Ben-nevis2006/stm32-freertos-dual-ecu-can-diagnostics/evidence/hardware/H3/2026-10-10/README.md

# Gate H3 FAN-00A 实物身份与接口证据索引（2026-10-10）

## 1. 本批范围

本目录保存 `FAN-01` 的完整标签、原装主接口、PST 串联输出接口，以及独立风扇延长线两端的原始照片。所有照片由现场执行人在未给风扇接入 12 V、NUCLEO、PWM 或 Tach 的状态下提供；归档仅规范化文件名，没有裁剪、修图或覆盖源文件。

本批只用于关闭 `FAN-00A` 的实物身份与接口形态补证。它不证明延长线逐针导通、风扇功能、转速、PWM 开路电压、Tach/PPR、带载电流或长期稳定性。

## 2. 证据清单与 SHA-256

| 归档文件 | 原始文件名 | 字节数 | 可支持的事实 | SHA-256 |
|---|---|---:|---|---|
| `H3_FAN-01_label_P8-PWM-PST_12V-0A09_20261010_01.jpg` | `985e2717f56e325733a7c89d342ca21f.jpg` | 163325 | 标签可读为 `ARCTIC P8 PWM PST / DC 12V 0.09A`；扇框、叶片及出线在照片可见范围内未见明显损伤 | `E1E9FD960602D0305B1FC4F9678405DF2B79BAF2E42763D247EC3E7393EA1659` |
| `H3_FAN-01_PST-output_three-populated-pins_20261010_01.jpg` | `91e9d2d0af5ce3dc1fd917f8ee56d527.jpg` | 105994 | 原装 PST 串联输出使用 4 位防呆外壳，但只装有 3 个金属触点 | `6D009290A8E411E4FF02BC8B8C76A096EAE5BFF2C3C6F1C5C6C596743D6B72BD` |
| `H3_FAN-01_main-connector_four-contact_20261010_01.jpg` | `b81644e9cc844aa9551b82052d8566db.jpg` | 109339 | 原装主接口为 4 位、4 触点、4 导线的母座 | `89996370F7F81180C4D09C7525B985133A2B9179AD7B5ACFCE74A26C63FE9BDF` |
| `H3_FAN-01_main-and-PST-connectors_20261010_01.jpg` | `c4e85651d4e5bfbcd9e9d5ecd1867949.jpg` | 105558 | 同一原装线束同时带主 4 触点母座与 PST 三触点串联输出，可交叉确认两者用途不同 | `5050C3148DE4EB92D2EB89939D15477CFAE6A80E17B537F2AAD84EE85EEA2FD9` |
| `H3_FANEXT-01_four-wire-both-ends_20261010_01.jpg` | `0224844abc403b8a568dfd99da91725b.jpg` | 124654 | 独立延长线两端均为 4 位且四个位置均有触点，线缆可见 4 条并行导体 | `E36BC421E99A58234BD5106A48732F6E72DA48E98FF3141DB3B2D14A06FCEB2F` |

## 3. 为什么原装 PST 输出只有三针

这不是缺针或损坏，而是 PST 串联设计的正常形态：

- 风扇的主 4-wire 接口需要 `GND / +12 V / Tach / PWM` 四条功能，因此有四个触点；
- PST 串联输出只把 `GND / +12 V / PWM` 继续送给下一只风扇；
- `Tach` 是每只风扇各自的测速输出。若把多只风扇的 Tach 输出直接并联，主机无法区分来源，多个输出也不应互相硬并，因此串联输出有意省略 Tach 所在位置；
- 外壳仍保持标准 4 位，是为了防呆、定位和与普通 4-pin 风扇插头机械兼容；
- 独立延长线属于通用直通件，所以两端四个位置都装触点。它不是 PST 分线器，不能因为“四针齐全”就推断它已完成逐针电气验证。

ARCTIC 官方产品页把本型号接口描述为 `4-Pin Connector + 4-Pin Socket`，PST 手册同时说明串联风扇组只监测第一只风扇的速度。上述现场接口形态与该设计一致：

- ARCTIC P8 PWM PST 产品页：<https://www.arctic.de/en/P8-PWM-PST/P8PWMPST>
- ARCTIC P8 PWM PST 支持/手册：<https://support.arctic.de/en/p8-pwm-pst>

## 4. 判定与边界

`FAN-00A` 判定为 **PASS（2026-10-10，身份/接口范围）**：

- `FAN-01` 实物标签确认 `P8 PWM PST / DC 12 V / 0.09 A`；
- 主接口和 PST 串联输出均已得到可复核近照；
- 三触点 PST 输出与四触点主接口的差异有明确设计解释，不登记为缺件或损坏；
- H0 `D-02` 中 FAN 的身份/接口子项可以关闭。

仍然保持以下边界：

- 标签没有显示完整销售 SKU，因此不把候选网页中的 `ACFAN00150A` 当成现场可读事实；
- 不按黑色线上的印刷、条纹或线色直接认定具体针脚，后续仍按防呆方向和物理针位编号；
- `FANEXT-01` 只确认外观为 4 线/4 触点，逐针一一对应关系仍须在 `FAN-00C` 全断电通断测试中建立；
- 本批没有关闭 `PSU12V-01 / D-04`，因此仍不允许把 12 V 接到风扇，也不允许连接 Node A、PWM 或 Tach。

## 5. 下一授权点

下一步只允许执行 `PSU-00B`：适配器与项目、风扇和所有板卡完全隔离，仅在直流输出端连续观察约 10 s 的空载电压稳定性。完成并记录之前，`FAN-00C` 及后续全部动作继续 HOLD。
