Ben-nevis2006/stm32-freertos-dual-ecu-can-diagnostics/evidence/hardware/H3/2026-10-08/README.md

# Gate H3 硬件证据索引（2026-10-08）

## 本日范围

本目录记录 H3-01 板外 NTC 分压组件的机械稳定性复核、引出线身份确认和关闭结论。2026-10-07 已完成的搭建、无源阻值和原始照片仍保留在[前一日证据目录](../2026-10-07/README.md)，本日不复制、不改写其发生日期。

本日先以现场文字报告关闭机械复核，随后归档 Node B 未上电接线照片、连续性结果及刷写前上电电压预检。硬件准入通过后，同日又完成 Node B 定向刷写与 ADC/UART 冒烟；后者见[同日软件证据索引](../../../software/H3/2026-10-08/README.md)，不回填成更早时点已经发生。

## 机械稳定性复核

| 检查 | 执行人观察 | 判定 | 边界 |
|---|---|---|---|
| 轻微扰动 NTC 转接母座、面包板节点和测量线 | 电阻读数正常、无跳变、无 `OL` | PASS | 只证明当前静态台架连续性，不代表振动/拉力/长期寿命 |
| 含 NTC 路径保持接入电阻档 | 读数平滑下降十几欧 | ACCEPTED | 相对约 11.4 kΩ 约为 0.1% 量级；未见阶跃或断续 |

平滑下降与万用表测试电流导致的轻微自热、手部/环境温度和仪表建立过程相符。因未记录测试电流、NTC 耗散常数与同步温度，只能写为“与热平衡效应一致”，不能证明自热是唯一原因，也不能据此推导绝对温度。

## 引出线身份

执行人按电阻分段复核后确认当前映射：

| 网络 | 当前线色 | 后续电气目标 |
|---|---|---|
| `T` | 棕色 | Node B `3V3` |
| `S` | 黑色（2026-10-07 近照最右侧） | Node B `A0 / PA0 / ADC1_IN0` |
| `G` | 红色 | Node B `GND` |

当前线色与常见电源约定相反：红色被用作 GND，黑色被用作模拟信号。为降低 H3-02 误接概率，在连接 Node B 前必须保持全断电，并采用下列二选一控制：

1. 推荐把外部跳线规范为 `红=T/3V3、棕=S/A0、黑=G/GND`，再复测三个阻值；或
2. 若不换线，则在两端增加不可脱落且不可混淆的 `T/S/G` 标签，并由第二次逐线核对确认。

## 线色规范化后的隔夜复测

执行人随后采用推荐方案调整三根外部跳线，并在静置隔夜后报告：

| 规范化线色 | 路径 | 实测值 | 判定 |
|---|---|---:|---|
| 红—棕 | `T-S`（NTC-01） | `12.00 kΩ`，稳定 | PASS；未见接触跳变 |
| 棕—黑 | `S-G`（R10K-01） | `9.93 kΩ`，稳定 | PASS；固定电阻与此前记录一致 |
| 红—黑 | `T-G`（串联总值） | `21.94 kΩ` | PASS；与分段和 `21.93 kΩ` 相差 `0.01 kΩ`（约 `0.046%`） |

复测后的最终映射为 `红=T/3V3、棕=S/A0、黑=G/GND`。NTC 从前次 `11.4 kΩ` 变为隔夜后的 `12.0 kΩ`，方向与冷却/环境热平衡一致；没有同步参考温度，因此不换算或宣称绝对温度。

## 当日关闭结论

H3-01 于 **2026-10-08 PASS**：板外分压的分段/总阻值、近照视觉检查及轻微扰动连续性均已满足当前准入条件。

在上述隔夜复测完成时，H3-02 仍为 **NOT STARTED**，但接板前的线色 HOLD 已解除；当时只授权在全断电状态下把红/棕/黑线分别接入 Node B 的 `3V3 / A0 / GND`，未授权上电或刷写。随后发生的未上电接线另见下一节。

## H3-02 未上电接线照片

执行人随后报告已迁移部分跳线用于共用 GND 与 3.3 V，并完成 Node B 接线，状态为“未上电”。

| 归档文件 | 原始文件名 | 字节数 | SHA-256 | 可支持的事实 | 不能支持的结论 |
|---|---|---:|---|---|---|
| `H3_NODE-B_NTC-divider-prepower-board_20261008_01.jpg` | `7f0b662d9aed82a361dd5a01b07c07ab.jpg` | 297064 | `CF350AA8CAD62FA600450EAB454EA580DC71EE702157F613AF1A8FE7183F9EEC` | 可见 Node B、板端跳线及 Micro-USB 插头；板载 LED 在静态照片中未见明确点亮 | 电源排针被线束部分遮挡，不能逐孔确认 `3V3/GND`；不能证明 USB 另一端未连接或板上实际无电 |
| `H3_NODE-B_NTC-divider-prepower-breadboard_20261008_01.jpg` | `1c2d38da594597433f99941a08c3c6af.jpg` | 218263 | `5C1F6623978B78A34A19DC009A59CFF214466CACB313717846825B26BC0BC0D9` | 可见面包板分压、引线及额外的公共电源/地跳线 | 线束交叉且部分节点受遮挡，不能独立证明三条网络均落在预期插孔，也不能代替连续性测量 |

## 板端连续性与短路复核

执行人确认 USB 未供电后，以通断档报告：

| 检查路径 | 现场结果 | 判定 |
|---|---|---|
| Node B `3V3↔T` | 蜂鸣 | PASS：预期同节点连续 |
| Node B `A0↔S` | 蜂鸣 | PASS：预期同节点连续 |
| Node B `GND↔G` | 蜂鸣 | PASS：预期同节点连续 |
| Node B `3V3↔GND` | 不蜂鸣 | PASS：未发现低阻短路 |

上述结果与此前分压阻值闭合证据共同解除 **PRE-POWER HOLD**。它只放行下一步按 Node B ST-LINK 身份进行受控 USB 接入/刷写；不证明 ADC 值、UART 日志、温升趋势或长期稳定性已经通过。离线固件构建证据见[同日软件证据索引](../../../software/H3/2026-10-08/README.md)。

## 刷写前上电电压预检

执行人随后给 Node B 上电并报告：

| 测量路径 | 实测值 | 判定 |
|---|---:|---|
| `T-G` | `3.289 V` | PASS：位于 `3.2～3.4 V` 预检区间 |
| `S-G` | `1.552 V` | PASS：位于 `1.40～1.60 V` 预检区间 |

按同次电压比与现场 `R_FIXED=9.93 kΩ` 估算，`R_NTC≈11.11 kΩ`，预期 12-bit ADC raw 约为 `1932`。这组结果证明上电时分压方向和量级与无源阻值证据一致；它仍是万用表电压快照，不是 MCU ADC 读数。执行人本次没有单独报告持续 30 s 的稳定观察，因此本索引不把该项写为长期或 30 s 稳定性通过。

Windows 只读设备枚举同时确认唯一连接目标的 USB 序列号为 Node B 冻结值 `066DFF515149856767254421`，对应 `STMicroelectronics STLink Virtual COM Port (COM8)`。该识别只解除定向刷写的身份 HOLD；截至本节形成时，仍没有发生 Flash 写入或目标复位。
