Ben-nevis2006/stm32-freertos-dual-ecu-can-diagnostics/evidence/hardware/H3/2026-10-07/README.md

# Gate H3 硬件证据索引（2026-10-07）

## 当前状态

Gate H3 于 2026-10-07 开始。本目录是 **2026-10-07 当日快照**，包含 H3-00 准入与设计冻结及 H3-01 的板外无源测量和原始接线照片。当日尚未执行 Node B 接线、通电、刷写或运行测试。

在 2026-10-07 当日结束时，H3 总体状态为 **IN PROGRESS**，H3-00 已 PASS；H3-01 无源阻值和视觉检查通过，母座机械稳定性与三根引出线映射仍待确认。该待办已于 2026-10-08 完成，见[次日 H3-01 关闭记录](../2026-10-08/README.md)。后续统一推送时仍保留每个动作的真实发生日期，不把阶段关闭日期回填为本目录内所有工作的发生日期。

## H3-00 可追溯输入

| 输入 | 已采用事实 | 限制 |
|---|---|---|
| [Gate H0 硬件验收基线](../../../../current/05_verification_gates_验证与门禁/Gate_H0_Hardware_Acceptance_Baseline_H0硬件验收基线_2026-09-22.md) | NTC-01=`10.30 kΩ`；R10K-01=`9.911 kΩ` | NTC 单点阻值不能证明 B3950 |
| [Gate H2 CAN 物理层执行记录](../../../../current/05_verification_gates_验证与门禁/Gate_H2_CAN_Physical_Layer_Execution_Record_H2_CAN物理层执行记录_2026-10-02.md) | H2 PASS；关闭提交 `bc19580` 可作为固件回退基线 | 不证明 NTC/ADC 或任何 12 V 外设 |
| [外设引脚时钟中断分配](../../../../current/03_hardware_interfaces_硬件与接口/Peripheral_Pin_Clock_Interrupt_Allocation_外设引脚时钟中断分配_v0.1_Working_Draft_工作草案_2026-09-13.md) | Node B NTC=`ADC1_IN0 / PA0 / A0 / CN7-28`；100 ms；上电校准 | 开短路阈值仍需 H3 实测冻结 |
| Node B `node_b.ioc`、`Src/adc.c` | 单通道、软件触发、右对齐、55.5 cycles、ADC clock≈10.67 MHz | 只有初始化骨架，尚无校准/采样/换算业务代码 |

## 本日输出

- [Gate H3 单外设验证执行记录](../../../../current/05_verification_gates_验证与门禁/Gate_H3_Single_Peripheral_Validation_Execution_Record_H3单外设验证执行记录_2026-10-07.md)
- 冻结拓扑：`3V3 → NTC-01 → A0/PA0 → R10K-01(9.911 kΩ) → GND`；
- 冻结趋势：升温时 ADC raw 上升；
- 冻结边界：B3950 为采购标称而非单点实测结论；12 V、Fan、Heater、INA260 继续禁止接入。

## H3-01 现场无源测量

| 测量路径 | 执行人报告值 | 当前判定 | 证据边界 |
|---|---:|---|---|
| `T-S`（NTC-01） | `11.4 kΩ` | PASS（连续性/当前阻值） | 环境温度未记录，不能证明 B3950 或温度精度 |
| `S-G`（R10K-01） | `9.93 kΩ` | PASS | 与 H0 `9.911 kΩ` 一致 |
| `T-G`（串联） | `21.16 kΩ` | PASS | 与分段和 `21.33 kΩ` 相差约 `0.8%` |

上述值来自执行人 2026-10-07 的现场文字报告。NTC 在焊接/手持热影响消退过程中曾从约 `8.9 kΩ` 缓慢回升，随后隔离复测稳定为 `11.4 kΩ`；该趋势符合 NTC 受热阻值下降、冷却回升。当前没有原始仪表照片，因此只作为已记录的现场测量，不冒充照片取证。

## 原始照片

| 归档文件 | 原始文件名 | 字节数 | SHA-256 | 可支持的事实 | 不能支持的结论 |
|---|---|---:|---|---|---|
| `H3_NTC-01_R10K-01_passive-divider-overview_20261007_01.jpg` | `3630b207078e88cc679665a7877f38df.jpg` | 176247 | `B6920752251DCC92190FAB3772CB4B5FFDC7D697194E2BBE18F200E759FAC4B8` | 板外面包板上可见 NTC、固定电阻和三根测量引出线；拍摄时未见其接入 Node B 供电 | 取景较宽且线束遮挡，不能逐孔确认 T/S/G 同排关系、补锡处无桥连或 NTC 细引线在杜邦母座内的夹持可靠性 |
| `H3_NTC-01_R10K-01_passive-divider-closeup_20261007_01.jpg` | `45596dc14e38912e8c4d5d3b49e5f211.jpg` | 241490 | `67242172A695BF6FC743464BF32B2E7805A7E14F6095F02A6F1A1A42B34C0C05` | 近照可辨固定电阻、NTC/转接引线和三个引出点；未见明显锡桥或相邻裸线互碰 | 不能证明杜邦母座内部夹持在受力时持续导通，也不能仅从线色推断 T/S/G 电气身份 |

## 当日待办及后续状态

截至 2026-10-07，仍待完成母座轻微扰动下的 `T-S` 阻值稳定性检查，并记录三根引出线的 T/S/G 颜色映射。上述两项于 2026-10-08 完成，H3-01 随后关闭为 PASS；该结论只记录在[2026-10-08 索引](../2026-10-08/README.md)，不回填成 10 月 7 日已完成。Node B A0 接线和 UART 原始日志仍未执行，尚未执行的项目不创建占位“通过”证据。
