Ben-nevis2006/stm32-freertos-dual-ecu-can-diagnostics/evidence/hardware/H0/2026-09-23/README.md

# Gate H0 硬件到货验收证据归档

## 1. 归档控制

| 项目 | 记录 |
|---|---|
| 项目 | 基于 STM32 + FreeRTOS 的双 ECU CAN 实时通信与故障检测系统 |
| Gate | H0：实物清点、身份核对与基础电气检查 |
| 现场执行日期 | 2026-09-23 |
| 归档日期 | 2026-09-23 |
| 证据数量 | 9 张 JPEG 原图 |
| 来源 | 项目执行人通过当前任务提交的现场照片 |
| 处理方式 | 对原文件进行逐字节复制，仅按 H0 命名规则重命名；未裁剪、未调色、未压缩、未覆盖原图 |
| 完整性校验 | SHA-256；归档后应与本清单逐项一致 |
| 关联记录 | [Gate H0 Hardware Acceptance Baseline / H0 硬件验收基线](../../../../current/05_verification_gates_验证与门禁/Gate_H0_Hardware_Acceptance_Baseline_H0硬件验收基线_2026-09-22.md) |
| 后续补充 | [2026-09-24 身份/铭牌补充证据](../2026-09-24/README.md) |
| 当前结论 | H0 现场检查和测量已执行；Gate 维持 HOLD，D-01～D-04 未关闭 |

本目录保存的是 H0 原始证据，不是后续 Gate 的功能验证结果。照片中的读数只能支持对应的静态检查，不能证明 CAN 通信、传感器标定、风扇控制、Heater 带载、RTOS、Fault、Fallback 或 Recovery 已通过。

## 2. 照片与读数索引

| 证据 ID | 归档文件 | 原始文件名 | 可见对象/读数 | H0 可支持结论 | 不能据此声称 |
|---|---|---|---|---|---|
| EV-H0-01 | [`H0_ALL_overview_20260923_01.jpg`](H0_ALL_overview_20260923_01.jpg) | `5d1a208640be3f02ec77078a7227a0a8.jpg` | 两块 NUCLEO、两块 CAN Pal、INA260 类模块、风扇、适配器、Heater、散热器和若干辅材总览 | 物料已展开、未形成完整 12 V 功率连接；支持总量级到货事实 | 不能代替每件实物的正反面、丝印、板版本、跳线和实体 ID 近照 |
| EV-H0-02 | [`H0_PSU12V-01_measurement_center-positive_20260923_01.jpg`](H0_PSU12V-01_measurement_center-positive_20260923_01.jpg) | `a1b208679f6a0c125ef1330ff4d31931.jpg` | 中心针接红表笔、外壳接黑表笔时约 `+12.580 V` | 实测输出极性为中心正极；存在约 12.58 V 空载输出 | 不能证明带载能力、纹波、瞬态或完整 12 V 回路安全 |
| EV-H0-03 | [`H0_PSU12V-01_measurement_reverse_20260923_02.jpg`](H0_PSU12V-01_measurement_reverse_20260923_02.jpg) | `635573c4b4d735a8d415230ad502d2d3.jpg` | 交换表笔后约 `-12.580 V` | 与 EV-H0-02 交叉支持中心正极判定 | 不能代替清晰铭牌、制造商容差或持续稳定性记录 |
| EV-H0-04 | [`H0_HEATER-01_measurement_10R50_20260923_01.jpg`](H0_HEATER-01_measurement_10R50_20260923_01.jpg) | `1a2a5ff2da1f37d30f03bf6461bb12c3.jpg` | Heater 静态读数约 `10.50 Ω` | 支持 10 Ω 量级的到货初筛 | 未记录表笔短接值，不能作为修正后的精确阻值或通电许可 |
| EV-H0-05 | [`H0_R10K-01_measurement_9K730_20260923_01.jpg`](H0_R10K-01_measurement_9K730_20260923_01.jpg) | `a5de193edb7f7ad60e04818810cd44a0.jpg` | Live Photo 抽取帧显示约 `9.730 kΩ`；执行人后续说明测量过程中读数持续跳变 | 证明该帧曾出现 9.730 kΩ，并触发“测量不稳定”D-01 | 不能把单帧当作稳定元件值，不能据此计算有效偏差或判定满足/不满足 `10 kΩ ±1%` |
| EV-H0-06 | [`H0_R4K7-01_measurement_4K701_20260923_01.jpg`](H0_R4K7-01_measurement_4K701_20260923_01.jpg) | `18b307e9f9fadc9c1dab02ec6d185b3d.jpg` | R4K7-01 静态读数约 `4.701 kΩ` | 支持 4.7 kΩ 标称阻值核对 | 未提供元件精度和仪表不确定度，不能扩展为精密容差认证 |
| EV-H0-07 | [`H0_CANPAL-01_measurement_120R26_20260923_01.jpg`](H0_CANPAL-01_measurement_120R26_20260923_01.jpg) | `1c76f6f80350c80026f40875a2607385.jpg` | CANPAL-01 termination 静态读数约 `120.26 Ω` | 支持本板 120 Ω 终端配置核对 | 不能证明收发器型号、逻辑电压、针脚方向或 CAN 通信正常 |
| EV-H0-08 | [`H0_CANPAL-02_measurement_120R52_20260923_01.jpg`](H0_CANPAL-02_measurement_120R52_20260923_01.jpg) | `255a38a1268f1a5b90a20ed8f369bbba.jpg` | CANPAL-02 termination 静态读数约 `120.52 Ω` | 支持第二块板的独立 120 Ω 终端配置核对 | 不能用本图代替 CANPAL-01 的结果，也不能证明总线功能 |
| EV-H0-09 | [`H0_NTC-01_measurement_10K30_20260923_01.jpg`](H0_NTC-01_measurement_10K30_20260923_01.jpg) | `adf0ee3dcb4b4c189b1b3a980b20513d.jpg` | NTC-01 在未记录室温下静态读数约 `10.30 kΩ` | 支持“约 10 kΩ NTC”的单点标称身份核对 | 单点读数不能证明 `B3950`、温度精度、响应时间或 ADC 换算正确 |

## 3. SHA-256 完整性清单

| 归档文件 | 字节数 | SHA-256 |
|---|---:|---|
| `H0_ALL_overview_20260923_01.jpg` | 290374 | `aaea4058b7cca293bdf995ec7fccc070dac24d42bffd0b1e7335aa96224b06ad` |
| `H0_PSU12V-01_measurement_center-positive_20260923_01.jpg` | 164296 | `f5082493b3b74e7714de08169052bbd112fc0e9fb78b6adfddd8fbd74d55eb5a` |
| `H0_PSU12V-01_measurement_reverse_20260923_02.jpg` | 150479 | `de49a989d22a1a59e67ce5d27af081f85c35049f745b75ca647c3870a6c9acd1` |
| `H0_HEATER-01_measurement_10R50_20260923_01.jpg` | 251617 | `5ea1ceb66627e54de35e6852701e62ec20b35e97926161d72747927e5e921da1` |
| `H0_R10K-01_measurement_9K730_20260923_01.jpg` | 272340 | `845ffb9f1748891a0ea7bc7e4abdd2704ab74bbb742aa7bc716c668c052f947c` |
| `H0_R4K7-01_measurement_4K701_20260923_01.jpg` | 286576 | `cedbede249d58dde4874ec14ad160d87ff8c3a8b618d0e16d91873412f500dbc` |
| `H0_CANPAL-01_measurement_120R26_20260923_01.jpg` | 235247 | `fda8833ac659d0e489769475d3fb762b2ca8418726ace8a87afcec939da708de` |
| `H0_CANPAL-02_measurement_120R52_20260923_01.jpg` | 262887 | `346c3e1898db4b603d1b1a04d8b1e9bf42731f3e2f964ef76c43bb5befd5f4bd` |
| `H0_NTC-01_measurement_10K30_20260923_01.jpg` | 162213 | `3645a696d713f57323035bcf50e5efcd4579a0d311bcdf4f2e763cc091bd79c2` |

## 4. 证据判读与偏差

### 4.1 已形成的有效证据

- `NTC-01`：约 10.30 kΩ，支持 10 kΩ 量级的单点核对；
- `R4K7-01`：约 4.701 kΩ，支持 4.7 kΩ 标称核对；
- `CANPAL-01` / `CANPAL-02`：分别约 120.26 Ω / 120.52 Ω，两个模块均有独立照片；
- `PSU12V-01`：正反表笔读数成对，支持中心正极和约 12.58 V 空载输出；
- `HEATER-01`：约 10.50 Ω，仅作为未修正的初筛值。

### 4.2 不得被“合格”注脚覆盖的问题

1. `R10K-01` 照片中的 9.730 kΩ 是读数跳变期间的 Live Photo 单帧。该信息撤销了“9.730 kΩ 是稳定元件值/已超出 ±1%”的早期推断。当前 HOLD 原因是测量不稳定、结果无效；必须改善接触并重复取得稳定数据后才能判断 PASS/FAIL。
2. 总览照片不能替代逐件正反面/丝印/跳线照片。执行人现场看过，不等于仓库中的第三方可以复核。
3. `HEATER-01` 没有表笔短接值，10.50 Ω 不能直接当作元件修正阻值。
4. `PSU12V-01` 的两张读数照片能证明基本输出和实际极性，不能证明铭牌一致性、带载能力或长期稳定性。
5. `NTC-01` 树脂头绝缘是正常封装特征。阻值应从两根引线/端子测量；此次补图已经完成这一项，但没有证明 B 值。

## 5. Gate 边界

- 当前归档不授权搭建完整 12 V 功率回路；
- D-01～D-04 关闭并复核前，Gate H0 维持 HOLD，H1 不准入；
- 后续补拍或复测必须新增文件，不覆盖这 9 张原始证据；2026-09-24 的 6 张补充原图另目录保存；
- 如同一器件复测值不同，应保留两次记录并解释测试条件，不删除“不好看”的旧结果。
