Ben-nevis2006/stm32-freertos-dual-ecu-can-diagnostics/evidence/hardware/H0/2026-09-24/README.md

# Gate H0 身份、铭牌与关闭补充证据

## 1. 归档控制

| 项目 | 记录 |
|---|---|
| 项目 | 基于 STM32 + FreeRTOS 的双 ECU CAN 实时通信与故障检测系统 |
| Gate | H0：实物清点、身份核对与基础电气检查 |
| 补充证据日期 | 2026-09-24 |
| 证据数量 | 8 张 JPEG 原图 |
| 来源 | 项目执行人通过当前任务提交的现场照片 |
| 处理方式 | 对原文件逐字节复制并规范重命名；未裁剪、未调色、未压缩、未覆盖原图 |
| 完整性校验 | SHA-256；归档副本必须与本清单一致 |
| 初始证据 | [2026-09-23 原始测量与总览证据](../2026-09-23/README.md) |
| 关联记录 | [Gate H0 Hardware Acceptance Baseline / H0 硬件验收基线](../../../../current/05_verification_gates_验证与门禁/Gate_H0_Hardware_Acceptance_Baseline_H0硬件验收基线_2026-09-22.md) |
| 当前结论 | D-01、D-03 已在 H0 筛查范围关闭；D-02、D-04 带入后续 Gate；Gate H0 为 CONDITIONAL PASS，允许受限 H1 |

## 2. 补充照片索引

| 证据 ID | 归档文件 | 原始文件名 | 可辨识内容 | 支持的结论 | 仍不能证明 |
|---|---|---|---|---|---|
| EV-H0-10 | [`H0_PSU12V-01_marking_20260924_01.jpg`](H0_PSU12V-01_marking_20260924_01.jpg) | `d8e6562d5cddab80fec74008c62c08c4.jpg` | 型号 `DC-853-1203000`；输入 180–240 V~ 50/60 Hz 1.0 A Max；输出 12 V DC / 3.0 A；中心正极；佛山市得昌电源有限公司 | 铭牌额定值、极性与此前 ±12.580 V 空载测量相互一致 | 不能证明连续稳定性、带载能力、纹波或瞬态性能 |
| EV-H0-11 | [`H0_NUCLEO-01_front_20260924_01.jpg`](H0_NUCLEO-01_front_20260924_01.jpg) | `3a5c142e9d3efdd6802700a0b7ab8be9.jpg` | 实体手写 ID `01`、`NUCLEO-F103RB`、`MB1136 rev C`、正面跳线/接口状态 | NUCLEO-01 的独立正面身份和板版本证据 | MCU 顶部字符未清晰到可逐字复核；不能代替背面照片或 USB 功能验证 |
| EV-H0-12 | [`H0_NUCLEO-02_front_20260924_01.jpg`](H0_NUCLEO-02_front_20260924_01.jpg) | `fa936715832a78edd41add66bb18b2e4.jpg` | 实体手写 ID `02`、`NUCLEO-F103RB`、`MB1136 rev C`、正面跳线/接口状态 | NUCLEO-02 的独立正面身份和板版本证据 | 不能用 NUCLEO-01 的结果代替本板；不能代替背面照片或 USB 功能验证 |
| EV-H0-13 | [`H0_CANPAL-01_front_20260924_01.jpg`](H0_CANPAL-01_front_20260924_01.jpg) | `09140e86db503dd04a1fc5acf160942e.jpg` | 端子手写 ID 按照片方向解释为 `01`；`Vcc/GND/RX/TX/SLNT/CANH/CANL` 与 termination 开关正面可见 | CANPAL-01 正面针脚和终端配置可追溯，可与 120.26 Ω 测量关联 | 收发器顶标和板版本仍不够清晰；不能代替背面照片或证明 CAN 通信 |
| EV-H0-14 | [`H0_CANPAL-02_front_20260924_01.jpg`](H0_CANPAL-02_front_20260924_01.jpg) | `3d7d0ff8980df27656d4adb38b8fb70d.jpg` | 端子手写 ID 按照片方向解释为 `02`；`Vcc/GND/RX/TX/SLNT/CANH/CANL` 与 termination 开关正面可见 | CANPAL-02 正面针脚和终端配置可追溯，可与 120.52 Ω 测量关联 | 收发器顶标和板版本仍不够清晰；不能代替背面照片或证明 CAN 通信 |
| EV-H0-15 | [`H0_INA260-01_front_20260924_01.jpg`](H0_INA260-01_front_20260924_01.jpg) | `11983c49951fc1c7c081937e84546c95.jpg` | `INA260 Power Sensor`、实体手写 ID `01`、`Vcc/GND/SCL/SDA/Alert/VBUS/Vin+/Vin-`、A0/A1 地址焊盘 | INA260-01 正面身份、主要针脚和地址焊盘到货状态 | 不能代替背面照片，也不能证明 I2C、电流/电压测量或 ALERT 功能 |
| EV-H0-16 | [`H0_METER-01_lead-short_0R3_20260924_01.jpg`](H0_METER-01_lead-short_0R3_20260924_01.jpg) | `c53d560f5433274b46c2155d4deaac0d.jpg` | `VICTOR VC9807A+`、200 Ω 档、两表笔金属尖端直接接触、显示约 0.3 Ω | 建立 Heater 初测所用万用表的低阻筛查基线，支持约 10.20 Ω 的事后修正 | 不是与 Heater 同时完成的测量，不能证明接触条件完全相同，也不证明 Heater 通电安全 |
| EV-H0-17 | [`H0_R10K-01_remeasurement_9K911_20260924_01.jpg`](H0_R10K-01_remeasurement_9K911_20260924_01.jpg) | `c976713e76e49b8058f8767de8f23cae.jpg` | `VICTOR VC9807A+`、20 kΩ 档、R10K-01 补充复测显示 9.911 kΩ | 显示值位于 10 kΩ ±1% 的 9.900～10.100 kΩ 名义带内，可关闭“无有效读数”的 D-01 | 仪表未校准，不能作为精密计量或供应商容差认证；单张照片不证明长期稳定性 |

## 3. SHA-256 完整性清单

| 归档文件 | 字节数 | SHA-256 |
|---|---:|---|
| `H0_PSU12V-01_marking_20260924_01.jpg` | 239535 | `634ea53b4b4e1bc7c56896055469369648fed20914d9e199b25eda0897170b12` |
| `H0_NUCLEO-01_front_20260924_01.jpg` | 254703 | `c63b95c7b8be2bf3512d16cff4d6c4ca2c3c8251e4a233993e1dfa22eb657c8e` |
| `H0_NUCLEO-02_front_20260924_01.jpg` | 217345 | `24dd10894a6c1d017087a4195a33d03f201e8168ef84daa4918f5758952bfac7` |
| `H0_CANPAL-01_front_20260924_01.jpg` | 234352 | `0dd77667e2437f8b92970ed3cf1d929beb61382df18a9356e0851c0959a7a282` |
| `H0_CANPAL-02_front_20260924_01.jpg` | 201228 | `db988888c2884e31702ff447efc4744f01ab6036b050d632d7ca3e217fa524bc` |
| `H0_INA260-01_front_20260924_01.jpg` | 200418 | `97a98878ca792db98e7f5eb273bc0ff3ce10d420761e29a51b09255eaed5a971` |
| `H0_METER-01_lead-short_0R3_20260924_01.jpg` | 165791 | `ca0efa66de9aa2da1bdfb59a18025be0b361b384fa431f7a61f660b5c0a62973` |
| `H0_R10K-01_remeasurement_9K911_20260924_01.jpg` | 221902 | `9b81ec76c7d494e781720eafbf622188a7209e7589a71d556c88c735b2536535` |

## 4. 执行人补充说明

### 4.1 R10K-01 的 Live Photo

执行人说明，10 kΩ 电阻初测时显示值持续跳变，先前归档的 9.730 kΩ 只是 Live Photo 中抽取的一帧。因此：

- 撤回“9.730 kΩ 是稳定元件值、相对标称值偏低 2.70%”的推断；
- 保留原图，但只把它作为“测量不稳定”的证据；
- 不从视频或 Live Photo 中挑选最接近 10.000 kΩ 的一帧作为合格证据；
- 2026-09-24 补充复测照片显示 9.911 kΩ（20 kΩ 档），相对标称值为 -0.89%，落在 9.900～10.100 kΩ 名义带内；
- D-01 由“没有有效读数”改为 **CLOSED（仅 H0 筛查范围）**。由于仪表未校准，这一关闭不等于精密容差认证；NTC 分压实际搭建时仍需用 ADC 合理性检查发现接触或元件问题。

### 4.2 Heater 测量前未做表笔短接

执行人确认，测量 Heater 的 10.50 Ω 前没有把两支表笔金属尖端直接接触并记录表笔/接触电阻。2026-09-24 补充同一万用表 200 Ω 档的表笔短接照片，显示约 0.3 Ω。因此保留 10.50 Ω 原始显示值，并形成事后近似筛查修正值：`10.50 - 0.30 = 10.20 Ω`。

Heater 没有在补拍时再次测量，所以不能声称两次接触条件完全相同。项目只按“排除开路、短路或数量级错件”的 H0 目的接受该值，D-03 记为 **CLOSED（仅 H0 筛查范围）**；它不授权安装、12 V 上电、温升或功率验证。

“表笔短接”只允许在被测对象完全断电、表笔位于 `COM/VΩ`、万用表处于电阻档时进行；它不是短接 Heater，更不是短接适配器输出。

### 4.3 关于从总览图裁切器件

总览原图可以裁切为汇报或位置说明用的派生图，但裁切不会增加原图分辨率，也不能恢复总览中不可辨认的芯片字符、背面焊点或跳线细节。若后续生成裁图，必须：

- 保留总览原图不变；
- 文件名包含 `derived-crop`；
- 清楚标注“派生图，不替代原始近照”；
- 不用派生裁图关闭原图中本来不可辨识的验收项。

本次已有对应器件的独立正面原图，因此未生成或归档总览裁图。

## 5. 带入后续 Gate 的最小事项

1. `D-02`：补两块 NUCLEO、两块 CAN Pal、INA260 的背面，以及 CAN 芯片顶标、FAN 标签/接口、Heater 铭牌和 Heatsink 尺寸证据；对应器件在证据关闭前不得接入系统。NUCLEO 背面证据不阻止纯 USB H1，但最迟应在接扩展线或外设前补齐；
2. `D-04`：适配器完全空载观察约 10 s，记录显示范围及有无异味、异响或异常发热；该偏差关闭前不得执行任何 12 V 动作，也不得通过“接负载看看”关闭偏差。

H1 仅允许一次连接一块 NUCLEO 的 ST-LINK USB，完成 Windows 枚举、ST-LINK、虚拟串口和 CubeProgrammer 只读识别。CAN Pal、INA260、Fan、Heater、NTC、12 V 及板间连线全部排除在本次放行之外。
