Ben-nevis2006/stm32-freertos-dual-ecu-can-diagnostics/evidence/hardware/H2/2026-10-02/README.md

# Gate H2 累计证据索引（2026-10-02）

## 当前状态

这是 **2026-10-02 的阶段快照**：当日 Gate H2 为 IN PROGRESS，本目录开始在本地累计原始证据。记录在 Gate 完成后的统一推送中保留原日期和当日判定，不回填为“当日已通过”。H2 后续于 2026-10-07 PASS，见 [`2026-10-07 软件证据`](../../../software/H2/2026-10-07/README.md)。

## 证据清单

| 归档文件 | 原始文件名 | 字节数 | SHA-256 | 可支持的事实 | 不能支持的结论 |
|---|---|---:|---|---|---|
| `H2_CANPAL-01-02_termination-switches-ON_20261002_01.jpg` | `f0789c57ddf8fb3c461315f6b417f7e3.jpg` | 190650 | `4B0F15959ADEAC61A96A1C15BDE2E35BF17E6A4292248F657B14D9C2556F9378` | 两块 CAN Pal 同框且无外部接线；两个 termination 滑块均位于各自 `ON` 丝印一侧 | 不证明单板终端阻值、并联约 `60 Ω`、供电状态或 CAN 通信正常 |
| `H2_CANPAL-01-02_passive-bus-wiring_20261002_01.jpg` | `09b2e9f5e3f8a88c31525f314619f010.jpg` | 140883 | `2020DB4C1DA6C5AA441B433EA8870D748AC50C2C3432CD7F4D970CBFFF5906B6` | 两块 CAN Pal 以三根同序线连接绿色端子的 `L`、中间 GND、`H`；未见 NUCLEO、Vcc 或逻辑线接入 | 不能证明端子夹紧、线路导通、H/L 未在照片外换位、并联约 `60 Ω` 或 CAN 通信正常 |

## 已验收、待补归档附件

| 计划归档文件 | 原始文件名 | 字节数 | SHA-256 | 可支持的事实 | 当前限制 |
|---|---|---:|---|---|---|
| `H2_CANPAL-01-02_passive-bus-resistance-60R41_20261002_01.jpg` | `fdfcf12e85fc457b67178ba2a0836b87.jpg` | 153752 | `CF8997216029369B5887241575CA751C016AB4DE0FBE14C311AD8E1C66D9795E` | 万用表 `200 Ω` 档显示 `60.41 Ω`，支持双端终端并联与总线连续性 | 微信临时源目录已在次日失效，仓库尚无该原图；需用户重新附加后按哈希核对并补归档。读数不证明 H/L 极性、上电状态或 CAN 通信正常 |

原图按字节原样归档，仅规范化文件名；未裁剪、未修图、未覆盖原文件。
