Ben-nevis2006/stm32-freertos-dual-ecu-can-diagnostics/evidence/hardware/H0/2026-10-01/README.md

# Gate H0 D-02 背面补充证据索引（2026-10-01）

## 1. 本批证据目的

本目录保存两块 `NUCLEO-F103RB` 和两块 CAN Pal 的背面原图，用于关闭 D-02 中适用于 H2 接线前的板卡背面身份子项。照片仅证明可见丝印、焊桥/焊点与外观状态；不替代已完成的 H1 电气验证，也不证明 CAN 通信功能。

## 2. 证据清单与 SHA-256

| 归档文件 | 原始文件名 | 字节数 | SHA-256 |
|---|---|---:|---|
| `H0_NUCLEO-01_back_20261001_01.jpg` | `0e3deb795a784e5eb8072c8ac57d9190.jpg` | 168745 | `C2989873E798BDD33B651A2565727ADA90BEDF90BDE223830286DEF50DD57E80` |
| `H0_NUCLEO-02_back_20261001_01.jpg` | `d7106c5571579fbc629868388e8643a8.jpg` | 173880 | `5E2F155013958CAD674D2AEF19E136BA945A217C9D0543F689DD83F13AA3DC1F` |
| `H0_CANPAL-01_back_20261001_01.jpg` | `237049245d8985b84691d382c45e3059.jpg` | 105944 | `E3EEE936EE7BFA2B31C78AED71E81A1B4DC6A814D4A4883147BD43AE906397D9` |
| `H0_CANPAL-02_back_20261001_01.jpg` | `688156af66d29454d2a58d5707b69c14.jpg` | 105778 | `2675CEA29C6931D919F8033A73E2826FDC3B046F02C3FE35E8266695582EF829` |

原图按字节原样归档，仅规范化文件名；未裁剪、未修图、未覆盖原文件。

## 3. NUCLEO 背面核对

| 检查项 | NUCLEO-01 | NUCLEO-02 | 判定 |
|---|---|---|---|
| 实体手写 ID | `01` 可见 | `02` 可见 | 两块实体可区分 |
| PCB revision | `MB1136 rev C` | `MB1136 rev C` | 与正面/既有记录一致 |
| 背面标签 | `MB1136-F103RB-C05` | `MB1136-F103RB-C05` | 与 NUCLEO-F103RB 产品身份一致 |
| 标签第二行 | `A250300248` | `A250300248` | 两块相同，不作为个体唯一身份；个体身份仍以手写 ID 和完整 ST-LINK SN 为准 |
| 焊桥/焊点/排针 | 背面整体可见 | 背面整体可见 | 照片可见范围内未见明显烧蚀、异物或焊锡桥 |

两块 NUCLEO 的背面证据子项判定为 **PASS**。这不改变 Gate H1 已依据独立 ST-LINK SN 和只读目标连接形成的电气结论。

## 4. CAN Pal 背面核对

两块模块背面均清楚显示：

- `CAN Bus Transceiver`；
- `TJA1051T/3`；
- `3-5V Vin/logic w/5V boost`；
- `Optional 120Ω termination`。

背面模块规格和外观子项判定为 **PASS（照片可见范围）**。但这些字符属于 PCB 产品丝印，不是正面 SOIC-8 收发器实体的激光顶标；它不能排除实际装片与 PCB 声明不一致。

## 5. D-02 当前边界与下一证据

- NUCLEO-01/02 背面子项：**CLOSED**；
- CANPAL-01/02 背面子项：**CLOSED**；
- CANPAL-01/02 收发器实体芯片顶标：**OPEN**；
- INA260 背面、Fan 标签/接口、Heater 铭牌、Heatsink 尺寸及辅材明细：继续 OPEN，在对应后续 Gate 前分别关闭。

在两块 CAN Pal 正面 SOIC-8 收发器顶标清晰可辨前，不连接 CAN Pal、NUCLEO 或板间线。下一证据应分别拍摄 `CANPAL-01`、`CANPAL-02` 正面，镜头近距离对准绿色端子下方、终端开关左侧的 SOIC-8 芯片，使芯片表面字符可读；同时保留板号标记以证明对应关系。
