Ben-nevis2006/stm32-freertos-dual-ecu-can-diagnostics/evidence/software/H3/2026-10-21/README.md

# H3 INA260 电脑端复位复扫证据（2026-10-21）

## 1. 本日范围

本目录记录 `INA-02G`。用户在执行前确认：INA260 只连接 `Vcc/GND/SCL/SDA`，仅
Node A USB 上电；Node B、12 V、绿色端子、VBus、Vin+、Vin- 和 Alert 均未接。本次
不用示波器，不刷写或修改固件，只由电脑通过冻结的 Node A ST-Link 身份执行软件复位，
并从 COM7 捕获启动时的 INA260 定向探测、完整地址扫描和身份结果。

## 2. 文件与完整性

| 文件 | 大小 | SHA-256 | 内容 |
|---|---:|---|---|
| [`H3_NODE-A_INA-02G_computer-reset-rescan_20261021.txt`](H3_NODE-A_INA-02G_computer-reset-rescan_20261021.txt) | `3078` bytes | `A0B8AF18BB14DA4D5517E3A3D68B05337D67F662500F633D9CE8982481E73FFC` | ST-Link 目标身份、3.24 V 目标电压、只复位操作、I2C 主控状态、两次 0x40 探测、全地址零 ACK 和结论边界 |

## 3. 结果

- ST-Link 序列号为冻结的 Node A `066BFF575151676667043206`，目标电压 `3.24 V`；
- I2C1 探测前 `state=0x20、hal_err=0、CR1=1、SR1=0、SR2=0`，PB8/PB9 均为高；
- 默认 `0x40` 在受控重新初始化前后连续两次均返回无应答；
- 完整 7-bit 扫描得到 `ack_count=0`，不存在可读取身份寄存器的其他响应地址；
- Manufacturer ID 和 Die ID 因无从机 ACK 而保持无效；
- 本次电脑端独立复测与 2026-10-20 的模块排针波形结论一致，因此 `INA260-01` 继续判为
  **FAIL / HARDWARE HOLD（模块级无应答）**。

该结论不把具体内部机制提前写成“芯片烧毁”。INA260 芯片细脚贴装、板内连接以及芯片
本体仍是模块边界内的候选原因；用户手焊排针则已有模块孤立阻值、板载上拉/下拉通路和
直接排针测点的交叉证据，不再作为优先候选。
