Ben-nevis2006/stm32-freertos-dual-ecu-can-diagnostics/evidence/software/H3/2026-10-19/README.md

# H3 Tach 输入捕获软件证据（2026-10-19）

## 1. 范围

本目录记录 2026-10-14 构建的 `TACH-01A` 原始输入捕获镜像在 2026-10-19 的实板刷写与
运行结果，以及同日构建、刷写的 `TACH-01B` 最大数字滤波复测。日期差异是项目实际
推进过程，不合并、不回填为同一天。

## 2. 文件与完整性

| 文件 | 大小 | SHA-256 | 内容 |
|---|---:|---|---|
| [`H3_NODE-A_TACH-01A_raw-capture-runtime_20261019.txt`](H3_NODE-A_TACH-01A_raw-capture-runtime_20261019.txt) | `5668` bytes | `A518F40FB8CF582A8E958E98FE1580D232F6A3B7CDC56E3F17675F9BFACA81F1` | 定向刷写身份、无 12 V 零边沿基线、默认 50% 风扇运行统计、判定与下一隔离变量 |
| [`H3_NODE-A_TACH-01B_filter15-build_20261019.txt`](H3_NODE-A_TACH-01B_filter15-build_20261019.txt) | `3262` bytes | `C3585160553C3423DAD0366E3E47164475C8D12840B5455E809D84A7D846F705` | `ICFilter=15` 单变量变更、滤波语义、clean build、ELF 身份与实板门禁 |
| [`H3_NODE-A_TACH-01B_filter15-runtime_20261019.txt`](H3_NODE-A_TACH-01B_filter15-runtime_20261019.txt) | `5742` bytes | `CB7F3118AF56ECBF55602DF1AFCD528469CAEEE27C48463E56AA5C431072CD89` | 定向刷写、无 12 V 零边沿基线、20 个实风扇窗口、平均率改善与周期完整性否决 |

## 3. 当前结论

- Node A 冻结序列号、目标 ELF 哈希、下载校验和复位均通过；
- 风扇 12 V 断开时，连续 12 个窗口保持零捕获，证明静态基线无伪边沿；
- 风扇默认 50% 运行后，`ICFilter=0` 每秒约捕获 `352.13` 个边沿，而示波器真实 Tach
  参考仅约 `45.77 Hz`；同时出现 `0～40 us` 级重复触发；
- `TACH-01A` 因此判定为 **FAIL（原始捕获准入）**，但该失败不是风扇、PA0 电压域或
  RC 连通性故障结论；它证明仅靠当前 RC 加无数字滤波不能形成可信的 MCU 计数；
- 只改变 TIM2 输入数字滤波为 15 的 `TACH-01B` 把稳定段平均捕获率降至
  `44.56 edge/s`，主周期恢复至约 `23.16～23.42 ms`，证明滤波方向有效；
- 但连续 20 个窗口中有 15 个出现约 `11.42～11.56 ms` 半周期，另有 2 个出现
  `10 us` 极短周期；故 `TACH-01B` 仍为 **FAIL（周期完整性）**，不能只凭平均率放行；
- 下一步只把 TIM2 CKD 从 DIV1 改为 DIV4，保持 `ICFilter=15` 与其他条件不变；PPR 与
  RPM 继续保持 `TBD / INVALID`。
