Ben-nevis2006/stm32-freertos-dual-ecu-can-diagnostics/current/05_verification_gates_验证与门禁/Gate_H0_Hardware_Acceptance_Baseline_H0硬件验收基线_2026-09-22.md

# Gate H0 硬件到货验收与身份核对基准

## 1. 文档控制

| 项目 | 内容 |
|---|---|
| 项目 | 基于 STM32 + FreeRTOS 的双 ECU CAN 实时通信与故障检测系统 |
| 文档用途 | 规定 Gate H0 的执行顺序、证据要求、判定规则和安全边界 |
| 版本 | v1.9 |
| 日期 | 2026-10-20 |
| 状态 | 已结束；**CONDITIONAL PASS**（D-02 剩余子项带入后续 Gate；D-04 已关闭） |
| 当前适用阶段 | Gate H2 已 PASS、Gate H3 进行中；D-02 的 CAN/H2、FAN/H3 与 INA260/H3 身份子项已关闭，D-04 空载稳定性缺口已关闭 |
| Gate H0 开始时 Git HEAD | `9a73210` |
| 软件/IPC 功能基线 | `4377c5e feat: add dual-node FreeRTOS IPC baseline` |
| 输出 | Gate H0 验收记录、照片索引、测量记录、偏差清单和 H1 准入结论 |
| 证据归档 | [2026-09-23 初始证据](../../evidence/hardware/H0/2026-09-23/README.md)；[2026-09-24 补充证据](../../evidence/hardware/H0/2026-09-24/README.md)；[2026-10-01 D-02 背面补充证据](../../evidence/hardware/H0/2026-10-01/README.md)；[2026-10-02 CAN 收发器顶标补拍与关闭证据](../../evidence/hardware/H0/2026-10-02/README.md)；[2026-10-10 FAN 身份/接口](../../evidence/hardware/H3/2026-10-10/README.md)；[2026-10-12 PSU 空载稳定性/残压](../../evidence/hardware/H3/2026-10-12/README.md)；[2026-10-20 INA260 身份/无源准入](../../evidence/hardware/H3/2026-10-20/README.md) |

本文件是硬件到货验收的执行基准，不取代或修改冻结的 System Architecture Definition、Fault List、CAN Matrix 和 FreeRTOS Task Architecture。若本文件与上游冻结文档冲突，以上游冻结文档和后续正式变更记录为准。

## 2. 受控输入与优先级

本文件由以下受控输入派生，优先级从上到下排列：

1. `System_Architecture_Definition_系统架构定义_v0.1_Synced_已同步_2026-09-02.docx`
2. `Fault_List_故障清单_v0.1_Synced_已同步_2026-09-02.docx`
3. `CAN_Matrix_CAN矩阵_v0.1_Synced_已同步_2026-09-02.xlsx`
4. `FreeRTOS_Task_Architecture_FreeRTOS任务架构_v0.1_Synced_已同步_2026-09-02.docx`
5. `Hardware_Selection_硬件选型_v0.1_Working_Baseline_工作基线_2026-09-08.docx`
6. `Peripheral_Pin_Clock_Interrupt_Allocation_外设引脚时钟中断分配_v0.1_Working_Draft_工作草案_2026-09-13.md`
7. `Hardware_Arrival_Transition_Report_硬件到货交接报告_2026-09-17.md`

### 2.1 不允许在 Gate H0 修改的内容

- Node A / Node B 的职责边界；
- `INIT / NORMAL / DEGRADED / SAFE` 系统模式集合和综合重算原则；
- FA-01～FA-07、FB-01～FB-04、FB-06 的 Fault 范围；
- FB-05 仅作为 Fault Propagation / Aggregation 历史编号的结论；
- `0x100 Cooling_Command` 和 `0x180 Actuator_Status` 的 CAN ID、DLC、周期、信号语义和监督规则；
- 5 个 application task、1 条 non-task Immediate Protection Path、Queue/Mailbox 语义和数据所有权；
- Fault、Fallback、Recovery、Dependency / Suppression 和多故障模式重算要求。

低仪器依赖只能改变验证手段，不能删除上述功能或把未验证项目写成已完成。

### 2.2 仍属于受控 TBD 的内容

以下内容可以在后续详细设计和验证中依据证据收口，但 Gate H0 不负责决定：

- Fault threshold、debounce、recovery qualification 和 latching；
- 风扇 PPR、Demand-to-RPM mapping、控制器参数和 fallback 数值；
- 任务实际执行时间、jitter、stack high-water mark 和运行时 heap；
- Diagnostic event、Freeze Frame、NVM、aging、clear 和 PC/UDS exposure；
- 需要实物或数据手册确认的模块电气细节。

禁止为了让表格“看起来完整”而编造这些数值。

## 3. Gate H0 的目的和边界

Gate H0 只回答以下问题：

1. 实际收到了什么；
2. 数量、型号、芯片、板卡版本和接口标识是否明确；
3. 是否存在缺件、错件、损伤、弯针、虚焊或不明跳线状态；
4. 无源器件基本阻值是否有记录；
5. 12 V 适配器的铭牌、空载输出和极性是否明确；
6. 是否具备进入 Gate H1 单块 NUCLEO USB Bring-up 的条件。

Gate H0 不验证：

- 固件是否能下载或运行；
- ST-LINK、虚拟串口或目标 MCU 是否能被软件连接；
- CAN 双向通信；
- 风扇 PWM、Tach、INA260、NTC 温度换算；
- FreeRTOS 调度、IPC、Fault、Fallback 或 Recovery；
- 完整 12 V 功率回路和 Thermal Plant。

这些内容分别属于 H1 及后续 Gate。不得用 H0 的照片或万用表读数替代后续运行证据。

## 4. 状态定义

| 状态 | 定义 | 处理 |
|---|---|---|
| PASS | 实物身份、数量、接口和要求的证据均明确，未发现阻止下一阶段的问题 | 可计入 H0 完成项 |
| CONDITIONAL PASS | Gate 层面仍有开放偏差，但偏差与下一 Gate 的最小目标可通过明确物理隔离解耦 | 记录偏差、隔离边界和最迟关闭点；只授权写明的最小范围 |
| HOLD | 信息不明确、规格不一致、针脚/极性不清、证据不足或需要数据手册复核 | 隔离该物料，不上电、不接线 |
| FAIL | 已确认错件、损坏、极性错误、输出异常或不满足基线 | 停止使用，记录并安排退换/替代评审 |
| N/A | 经本文件或上游基线确认该检查对该物料不适用 | 写明理由，不能留空代替 N/A |
| NOT CHECKED | 尚未执行 | Gate H0 关闭时不得残留关键 NOT CHECKED 项 |

一件关键物料出现 HOLD 或 FAIL，不允许通过“先接起来看看”消除不确定性。应先补证据、查资料或更换物料。若该物料能被下一 Gate 完全排除，可在记录隔离边界后作 Gate 层面的 CONDITIONAL PASS，但不得把该物料本身改写为已验证。

## 5. Gate H0 安全红线

### 5.1 H0 第一步的安全状态

- 12 V 适配器不接市电；
- 两块 NUCLEO 不接 USB；
- 所有模块互相分离；
- Heater、Fan、INA260、CAN Pal、NTC 均不与 MCU 连接；
- 桌面干燥、绝缘、无散落金属；
- 不佩戴可能造成短路的金属物接触裸露端子；
- 先释放人体静电，再接触开发板和模块边缘。

### 5.2 H0 全程禁止事项

- 不搭建完整 12 V 风扇或 Heater 功率回路；
- 不把 12 V 接入 NUCLEO 的 3.3 V、5 V 或 GPIO；
- 不通过面包板、细杜邦线承载 Heater 电流；
- 不启用 INA260 ALERT；
- 不连接完整双节点 CAN 网络；
- 不同时接入 CAN、风扇、传感器和 RTOS 业务固件；
- 不用真实短路、危险堵转、过压或大电流制造 Fault；
- 不剪 P8 原装线，不使用 PST 串联接口参与初始验证；
- 不根据线色、商品图片或个人经验猜测针脚；
- 不在带电对象上使用电阻档、通断档或二极管档。

### 5.3 万用表使用要求

- 黑表笔插 `COM`；
- 测电阻时红表笔插 `VΩ`；
- 测适配器电压时红表笔仍插 `VΩ`，档位设为直流电压；
- 本阶段不把表笔插入 `A` 或 `mA` 电流插孔；
- 每次改变档位前确认被测对象是否带电；
- 测电阻前确认元件与所有电源、模块和电容性电路隔离；
- 不用蜂鸣器响声代替阻值、极性或绝缘结论。

## 6. 所需工具与记录材料

主线必需：

- 数字万用表；
- 手机或相机；
- 绝缘、干燥工作台；
- 纸质标签或可移除标签；
- 记录表或本文件的执行副本；
- 直尺或游标卡尺，用于必要的尺寸核对；
- 适合小器件的收纳袋或盒，用于隔离 HOLD/FAIL 物料。

非 H0 必需：示波器、逻辑分析仪、USB-CAN、电子负载、可调电源。缺少这些设备不构成删减系统功能的理由。

## 7. 标识和证据命名规则

### 7.1 实物 ID

先按物理身份编号，不要提前绑定软件角色：

- `NUCLEO-01`、`NUCLEO-02`；
- `CANPAL-01`、`CANPAL-02`；
- `FAN-01`；
- `INA260-01`；
- `NTC-01`；
- `R10K-01`、`R4K7-01`；
- `HEATER-01`、`HEATSINK-01`；
- `PSU12V-01`；
- 其他辅材按类型连续编号。

两块 NUCLEO 在 H1 分别验证前，不永久指定为 Node A 或 Node B。否则一旦板卡互换，照片、日志和故障定位会失去可追溯性。

### 7.2 照片命名

推荐格式：

`H0_<实物ID>_<视图>_<YYYYMMDD>_<序号>.jpg`

视图建议使用：

- `overview`：全体物料总览；
- `front`：正面；
- `back`：背面；
- `marking`：型号/芯片丝印；
- `connector`：接口及针脚标识；
- `jumper`：跳线、焊桥、DIP 或终端状态；
- `damage`：损伤或异常细节；
- `measurement`：必要的仪表读数与被测对象同框照片。

同型号的两块板必须分别拍摄，不能用其中一块代表另一块。照片应能同时看清实物 ID 标签和被核对的标识。

## 8. 预期到货清单

| BOM ID | 设备或材料 | 基线期望 | 实物 ID | 实收数量 | 状态 |
|---|---|---|---|---:|---|
| HS-01 | MCU 开发板 | NUCLEO-F103RB ×2 | NUCLEO-01、NUCLEO-02 | 2 | PASS（正反面身份、独立 ST-LINK SN 和 H1 单板结果均已归档） |
| HS-02 | CAN 物理层模块 | Adafruit CAN Pal 5708 / TJA1051T/3 ×2 | CANPAL-01、CANPAL-02 | 2 | PASS（两块正反面、针脚、终端及实体收发器主顶标均已独立归档；不代表 CAN 功能已验证） |
| HS-03 | 风扇 | ARCTIC P8 PWM PST non-CO，12 V，4-wire ×1 | FAN-01 | 1 | PASS（2026-10-10 已补标签、主接口与 PST 输出近照；仅身份/接口范围，不代表功能通过） |
| HS-04 | 温度采集 | 10 kΩ B3950 NTC + 10 kΩ ±1% 分压电阻 | NTC-01、R10K-01 | 各 1 件被测样品 | PASS（H0 标称/筛查；R10K-01 复测显示 9.911 kΩ，D-01 已关闭） |
| HS-05/06 | 电流和电压采集 | INA260 breakout ×1 | INA260-01 | 1 | PASS（2026-10-20 已补正反面、接口与孤立无源准入；仅身份/无源范围，不代表 I2C 或高边功能通过） |
| HS-07A | Thermal Plant 散热器 | 100 × 80 × 20 mm ×1 | HEATSINK-01 | 1 | HOLD（尺寸测量未留痕） |
| HS-07B | Thermal Plant 加热元件 | 10 Ω / 25 W 加热电阻 ×1 | HEATER-01 | 1 | PASS（H0 断电筛查；约 10.20 Ω，D-03 已关闭；不授权通电） |
| HS-08 | 电源 | 12 V / 3 A 稳压适配器，5.5 × 2.1 mm ×1 | PSU12V-01 | 1 | PASS（H0 身份/极性/空载基本稳定性；2026-10-12 关闭 D-04，不代表额定带载验证） |
| AUX-01 | Tach 上拉 | 4.7 kΩ 电阻 | R4K7-01 | 至少 1 件被测样品 | PASS（标称阻值核对） |
| AUX-02 | 功率连接 | DC 转螺丝端子、KF128、开关、18 AWG 功率线 | 按类型待补编号 | 总览可见，数量未记录 | HOLD（明细清点待补） |
| AUX-03 | 信号连接 | 杜邦线、电阻、风扇 PWM 延长线 | 按类型待补编号 | 总览可见，数量未记录 | HOLD（明细清点待补） |
| AUX-04 | 原型搭建 | 830 孔面包板 | 待编号 | 现有照片无法确认 | HOLD（实物和照片待确认） |

辅材数量若采购基线没有明确规定，应记录实际数量，不编造“应有数量”。缺少会阻止后续 Gate 的辅材必须标记 HOLD。

## 9. 执行流程

必须按 H0-01 至 H0-07 顺序执行。任何 STOP 条件出现时，停止该物料的后续步骤，但可以继续清点其他保持隔离的物料。

### H0-01 建立全断电工作状态

操作：

1. 拔除 12 V 适配器市电输入；
2. 拔除两块 NUCLEO 的 USB；
3. 拆除所有临时连接；
4. 将物料分类摆放且互不接触；
5. 放置实物 ID 标签；
6. 拍摄一张全体物料总览照。

证据：

- 总览照片编号：`H0_ALL_overview_20260923_01.jpg`；
- 执行日期/时间：`2026-09-23（具体时间未记录）`；
- 执行人：`项目执行人已完成现场测试，姓名/签名待补`。

通过条件：所有物料可独立识别，现场无带电连接和复杂线束。

STOP 条件：无法确认适配器是否断电、桌面潮湿、存在裸露带电端子或金属杂物。

### H0-02 逐件清点和外观检查

每件物料至少记录：

- 实物 ID；
- 购买名称；
- 实收数量；
- 正面/背面完整丝印；
- 主芯片型号；
- PCB/板卡版本；
- 接口和针脚标签；
- 跳线、焊桥、DIP、终端电阻配置；
- 弯针、裂纹、烧痕、腐蚀、缺件、松动、虚焊嫌疑；
- 包装或铭牌异常；
- 对应照片编号；
- PASS/HOLD/FAIL。

通用记录表：

| 实物 ID | BOM ID | 完整型号/丝印 | 主芯片/板版本 | 接口/跳线状态 | 外观 | 照片编号 | 结论 | 备注 |
|---|---|---|---|---|---|---|---|---|
| NUCLEO-01 | HS-01 | `NUCLEO-F103RB`，实体手写 ID `01` | `MB1136 rev C`；背面标签 `MB1136-F103RB-C05` | 出厂跳线与背面焊桥状态均已留痕 | 正反面照片可见范围内未见明显损伤 | `H0_NUCLEO-01_front_20260924_01.jpg`、`H0_NUCLEO-01_back_20261001_01.jpg` | PASS | 完整 ST-LINK SN 和 H1 结果另见 Gate H1；背面标签 `A250300248` 不作为个体唯一身份 |
| NUCLEO-02 | HS-01 | `NUCLEO-F103RB`，实体手写 ID `02` | `MB1136 rev C`；背面标签 `MB1136-F103RB-C05` | 出厂跳线与背面焊桥状态均已留痕 | 正反面照片可见范围内未见明显损伤 | `H0_NUCLEO-02_front_20260924_01.jpg`、`H0_NUCLEO-02_back_20261001_01.jpg` | PASS | 与 NUCLEO-01 独立留痕；完整 ST-LINK SN 和 H1 结果另见 Gate H1 |
| CANPAL-01 | HS-02 | CAN Pal 类模块，端子手写 ID `01`；背面丝印 `CAN Bus Transceiver / TJA1051T/3` | PCB 背面声明 `3-5V Vin/logic w/5V boost`、`Optional 120Ω termination`；实体 SOIC-8 可辨 NXP 标志及主标 `A1051/3` | `Vcc/GND/RX/TX/SLNT/CANH/CANL` 与 termination 开关正面可见；实测 120.26 Ω | 正反面与顶标照片可见范围内未见明显损伤 | `H0_CANPAL-01_front_20260924_01.jpg`、`H0_CANPAL-01_back_20261001_01.jpg`、`H0_CANPAL-01_chip-top-readable_20261002_01.jpg`、M-05 | PASS（身份/无源配置） | 与 CANPAL-02 独立留痕；允许进入 H2 受控断电接线，不代表通信功能已通过 |
| CANPAL-02 | HS-02 | CAN Pal 类模块，端子手写 ID `02`；背面丝印 `CAN Bus Transceiver / TJA1051T/3` | PCB 背面声明 `3-5V Vin/logic w/5V boost`、`Optional 120Ω termination`；实体 SOIC-8 可辨 NXP 标志及主标 `A1051/3` | `Vcc/GND/RX/TX/SLNT/CANH/CANL` 与 termination 开关正面可见；实测 120.52 Ω | 正反面与顶标照片可见范围内未见明显损伤 | `H0_CANPAL-02_front_20260924_01.jpg`、`H0_CANPAL-02_back_20261001_01.jpg`、`H0_CANPAL-02_chip-top-readable_20261002_01.jpg`、M-06 | PASS（身份/无源配置） | 与 CANPAL-01 独立留痕；允许进入 H2 受控断电接线，不代表通信功能已通过 |
| FAN-01 | HS-03 | `ARCTIC P8 PWM PST` | 现场标签 `DC 12 V 0.09 A`；完整销售 SKU 未印在标签上 | 原装主接口为 4 位 4 触点；PST 输出为 4 位外壳内 3 触点；独立延长线为 4 位 4 触点 | 扇框、叶片、线缆和插头在照片可见范围内未见明显损伤 | `H0_ALL_overview_20260923_01.jpg`；[`H3/2026-10-10` 五张补证](../../evidence/hardware/H3/2026-10-10/README.md) | PASS（身份/接口） | 2026-10-10 关闭 D-02 的 FAN 子项；未接 12 V，未验证逐针导通、转动、PWM 或 Tach |
| INA260-01 | HS-05/06 | `INA260 Power Sensor` 正面丝印可见，实体手写 ID `01`；背面可读 INA260 功率监测模块额定信息 | INA260 主芯片位置可见；顶部字符不足以逐字复核，后续须以寄存器 ID 验证 | `Vcc/GND/SCL/SDA/Alert/VBUS/Vin+/Vin-`、A0/A1 与 VB 区域可见；A0/A1 未见桥接 | 正反面照片可见范围内未见明显损伤；孤立无源筛查未见异常低阻短路 | `H0_INA260-01_front_20260924_01.jpg`；[`H3/2026-10-20` 正反面与无源记录](../../evidence/hardware/H3/2026-10-20/README.md) | PASS（身份/无源准入） | 2026-10-20 关闭 D-02 的 INA260 身份子项；未接 12 V、I2C 或 ALERT，不代表功能通过 |
| NTC-01 / R10K-01 / R4K7-01 | HS-04 / AUX-01 | 10 kΩ NTC、10 kΩ、4.7 kΩ | 封装/色环细节未单独归档 | 独立无源测量 | 执行人报告无明显损伤 | 对应 M-01～M-03 测量照片 | PASS（H0 标称/筛查） | NTC 与 R4K7 支持标称核对；R10K-01 复测 9.911 kΩ，D-01 已关闭 |
| HEATER-01 / HEATSINK-01 | HS-07A/B | 10 Ω / 25 W Heater、散热器 | 铭牌和尺寸近照待补 | 未安装、未通电 | 执行人报告无明显损伤 | `H0_HEATER-01_measurement_10R50_20260923_01.jpg`、`H0_METER-01_lead-short_0R3_20260924_01.jpg`、总览 | HOLD（HEATSINK-01/D-02） | Heater 断电筛查约 10.20 Ω，D-03 已关闭；Heatsink 尺寸追溯仍属 D-02，二者均不得通电 |
| PSU12V-01 | HS-08 | `DC-853-1203000`；输入 180–240 V~ 50/60 Hz 1.0 A Max；输出 12 V DC / 3.0 A | 铭牌中心正极符号清晰 | 实测中心正极；2026-10-12 空载 10 s 为 `12.487～12.588 V` | 外壳/插脚在照片中未见明显损伤；空载观察无异味、异响、异常发热 | `H0_PSU12V-01_marking_20260924_01.jpg`、M-07 两张测量照、[`H3/2026-10-12` 结构化报告](../../evidence/hardware/H3/2026-10-12/README.md) | PASS（H0 基本检查） | D-04 已关闭；拔电后存在约 2 min 残压，不代表 3 A 带载、纹波或长期温升通过 |

### H0-03 关键硬件身份核对

#### H0-03A NUCLEO-F103RB ×2（两块正反面身份照片及 H1 独立运行证据已补）

逐块核对：

- PCB 正面型号包含 `NUCLEO-F103RB`；
- 目标 MCU 丝印可辨识并与 `STM32F103RBT6` 基线一致；
- 板载 ST-LINK 区域和目标板区域无明显损伤；
- USB 接口无松动、变形或异物；
- Morpho/Arduino 排针无严重弯折和短接；
- 所有出厂跳线、焊桥状态逐块拍照记录，H0 不随意改动；
- 两块板分别记录 PCB revision/版本信息；
- 不因一块板外观正常而外推另一块也正常。

判定：型号、MCU 或板版本无法确认时标记 HOLD；明显错件或损伤标记 FAIL。

#### H0-03B CAN Pal ×2（两块正反面/针脚/终端照片已补；实体芯片顶标待补）

逐块核对：

- 模块产品标识和版本；
- 收发器芯片丝印是否为预期的 `TJA1051T/3` 或经正式评审接受的等效版本；
- MCU 侧 `TXD/RXD`、逻辑电源和 GND 标识；
- 总线侧 `CANH/CANL` 标识；
- 120 Ω termination 的跳线、焊桥或开关位置；
- 逻辑电压要求不能仅凭商品标题推断，后续连接前必须用实物资料复核；
- 模块正反面无焊锡桥、裂纹或弯针。

判定：终端状态、逻辑电压或针脚方向不明确时标记 HOLD，禁止试接 NUCLEO。

#### H0-03C ARCTIC P8 PWM PST non-CO 风扇（2026-10-10 标签与接口补证完成）

核对：

- 完整产品标签、型号、额定电压和电流；
- 为 12 V、4-wire PWM fan；
- 主 4-pin 插头方向及防呆结构；
- PST 额外串联接口单独标识，初始验证不使用；
- 扇叶、框架、线缆和插头无破损；
- 不根据黑/红/黄/蓝等线色直接认定 GND、12 V、Tach、PWM；
- 不剪原装线，后续优先改风扇延长线。

判定：完整型号、额定值或线序依据不明确时标记 HOLD。

2026-10-10 补证结论：标签可读为 `ARCTIC P8 PWM PST / DC 12 V 0.09 A`；主 4-wire 母座、PST 串联输出和独立延长线两端均已留痕。PST 输出采用 4 位外壳但只有 3 个触点，是只转接电源与 PWM、避免多只风扇 Tach 输出并联的设计，不作为缺件。D-02 的 FAN 身份/接口子项关闭；逐针导通、12 V 上电、PWM 和 Tach 仍归 H3 后续步骤。

#### H0-03D INA260 breakout（2026-10-20 正反面与孤立无源补证完成）

核对：

- 模块型号和主芯片丝印；
- `VIN+`、`VIN-` 的功率电流方向标识；
- `VCC`、`GND`、`SCL`、`SDA`、`ALERT` 针脚标识；
- 地址焊桥/跳线的到货状态；
- 端子和分流路径无明显损伤；
- H0 不连接 12 V、I2C 或 ALERT；

2026-10-20 补证结论：正反面、接口、地址焊盘和额定丝印均已留痕；孤立状态下
Vcc-GND 不蜂鸣且电阻随欧姆档充电升至超量程，Vcc-SCL/Vcc-SDA 分别为
`10.056/10.028 kΩ`，其余不应导通的信号组合均不蜂鸣。VBus-Vin+ 与 Vin+-Vin- 的
低阻连续性分别对应板载 VB 桥与内置分流路径；由于显示值低于 `0.22 Ω` 表笔基线，
只作连续性证据，不作毫欧精确测量。D-02 的 INA260 身份子项关闭；I2C 地址/寄存器身份、
12 V 高边方向和功能读数仍归 H3 后续门禁。
- 后续只按实物资料确认 3.3 V 逻辑供电和 I2C 电平。

判定：VIN 方向或逻辑针脚不清时标记 HOLD。

#### H0-03E NTC 和电阻（H0 测量完成；R10K-01 复测已归档）

核对：

- NTC 的采购规格为 10 kΩ、B3950；
- 10 kΩ 分压电阻的标称值和容差；
- 4.7 kΩ Tach 上拉电阻的标称值和容差；
- 引脚、绝缘和封装无损伤。

注意：室温下测得约 10 kΩ 只能支持 NTC 的标称阻值核对，不能单凭一个阻值证明 B 值一定是 3950。B 值需要采购资料或多温点测量支持。

#### H0-03F Heater、散热器和适配器（Heater 断电筛查完成；散热器/适配器剩余项带入）

核对：

- Heater 铭牌/丝印为 10 Ω / 25 W；
- 散热器尺寸约为 100 × 80 × 20 mm；
- Heater 安装面、引线和绝缘无损伤；
- 12 V 适配器铭牌包含输入范围、输出电压、电流和极性符号；
- DC 插头尺寸与 5.5 × 2.1 mm 采购基线一致；
- 适配器外壳、电缆和插头无开裂、挤压或裸铜；
- H0 不把 Heater 安装并通电，不测试温升。

### H0-04 无源器件阻值测量

前置条件：适配器断电，所有元件与模块完全隔离，万用表红表笔位于 `VΩ` 插孔。

测量仪表：照片可识别为 `VICTOR VC9807A+`。仪表校准状态和环境温度未记录，因此本节结论仅用于 H0 到货筛查，不构成计量校准或供应商容差认证。执行人于 2026-09-24 说明：R10K-01 初测过程中读数持续跳变，9.730 kΩ 只是 Live Photo 中抽取的一帧；该帧继续保留为无效初测证据。随后在 20 kΩ 档补充复测照片，显示 9.911 kΩ。另补充同一万用表 200 Ω 档的表笔短接照片，显示约 0.3 Ω。

测量原则：

- 记录仪表型号和档位；
- 低阻测量前先短接表笔，记录表笔/接触电阻；
- 不用手同时捏住高阻元件两端金属引脚，避免人体并联影响；
- 数值不稳定时等待稳定并记录环境；
- 不为没有数据手册容差的器件发明验收带宽。

“表笔短接”不是短接 Heater 或电源，而是在**被测对象完全断电且万用表处于电阻档**时，把红、黑两支表笔的金属尖端直接、稳定地接触在一起，用来测出表笔线、插孔和接触本身带来的串联电阻。操作顺序：

1. 黑表笔置于 `COM`、红表笔置于 `VΩ`，选择与 Heater 测量相同的电阻档；
2. 两表笔金属尖端直接接触，保持不动，等待读数稳定并记录为 `R_lead`；
3. 分开表笔，再以相同档位和相近接触力度测量 Heater，记录显示值 `R_display`；
4. 形成近似修正值 `R_heater = R_display - R_lead`，同时保留两个原始读数；
5. 如果表笔互相接触时读数仍明显跳变，先检查探针氧化、插头松动、量程和电池，不继续给 Heater 下结论。

严禁在适配器带电、Heater 通电或表笔位于 `A/mA` 插孔时做上述操作。

| 测量 ID | 实物 ID | 标称值 | 容差/依据 | 环境温度 | 表笔短接值 | 实测值 | 修正/说明 | 结论 |
|---|---|---:|---|---:|---:|---:|---|---|
| M-01 | NTC-01 | 10 kΩ @ 25°C | 采购规格 | 未记录 | N/A | 10.30 kΩ | 只支持“约 10 kΩ NTC”的单点身份核对；不能证明 B3950 | PASS（标称身份） |
| M-02 | R10K-01 | 10 kΩ | ±1% | 未记录 | N/A | 初测跳变；补充复测 9.911 kΩ（20 kΩ 档） | 显示值相对标称值为 -0.89%，落在 9.900～10.100 kΩ 名义带内；因仪表未校准，仅判为 H0 筛查通过，不声称完成精密容差认证 | PASS（H0 筛查；D-01 CLOSED） |
| M-03 | R4K7-01 | 4.7 kΩ | 按实物色环/采购规格 | 未记录 | N/A | 4.701 kΩ | 与 4.7 kΩ 标称值一致；未据此声明精密容差 | PASS（标称核对） |
| M-04 | HEATER-01 | 10 Ω | 按实物/采购规格 | 未记录 | 约 0.3 Ω（200 Ω 档，事后补测） | 10.50 Ω（原始显示） | 近似修正值 `10.50 - 0.30 = 10.20 Ω`；两次测量非同一时刻且未复测 Heater，只支持断电到货筛查，不授权通电 | PASS（H0 筛查；D-03 CLOSED） |
| M-05 | CANPAL-01 termination | 120 Ω（若启用） | 模块资料/配置 | 未记录 | 未记录 | 120.26 Ω | 支持本板 termination 状态核对；不证明 CAN 通信正常 | PASS（配置核对） |
| M-06 | CANPAL-02 termination | 120 Ω（若启用） | 模块资料/配置 | 未记录 | 未记录 | 120.52 Ω | 支持本板 termination 状态核对；不外推 CANPAL-01 结果 | PASS（配置核对） |

判定说明：

- `R10K-01` 若明确为 ±1%，独立测量应与该容差一致，同时考虑万用表精度；
- NTC 阻值必须结合温度解释，不能机械套用固定 ±1%；
- Heater 低阻测量必须扣除或说明表笔/接触电阻；
- CAN Pal 板上测得的阻值可能受到其他电路影响，需结合 termination 配置和模块原理图解释；
- 通断档只说明阻抗低到触发蜂鸣，不能代替具体阻值结论。

STOP 条件：被测对象仍与电源或其他模块连接、表笔位于电流插孔、无法确认量程或读数明显异常。

### H0-05 适配器铭牌、空载电压和极性

此步骤必须在完成外观检查后单独执行。适配器输出端不得连接 NUCLEO、Fan、Heater、INA260、面包板或其他模块。

操作：

1. 抄录 `PSU12V-01` 的完整输入、输出、电流和极性符号；
2. 确认万用表黑表笔在 `COM`、红表笔在 `VΩ`；
3. 选择直流电压档，量程高于 12 V；
4. 保持 DC 插头独立，不让表笔互相短接；
5. 按铭牌极性符号先放置表笔，再短时间接通市电；
6. 记录电压的正负号、数值和稳定性；
7. 交换表笔只用于必要的极性确认，不允许表笔桥接中心针与外壳；
8. 测量结束后先断开市电，再收起表笔和适配器；
9. 拍摄适配器铭牌及必要的测量证据照片。

| 测量 ID | 实物 ID | 铭牌输出 | 铭牌极性 | 空载实测 | 实测极性 | 稳定性 | 照片编号 | 结论 |
|---|---|---|---|---|---|---|---|---|
| M-07 | PSU12V-01 | 型号 `DC-853-1203000`；输入 180–240 V~ 50/60 Hz 1.0 A Max；输出 12 V DC / 3.0 A | 中心正极 | 2026-09-23 极性照片：`±12.580 V`；2026-10-12 空载 10 s：`12.487～12.588 V`，末值 `12.588 V` | 中心正极，与铭牌一致；10 s 无跳变、异味、异响或异常发热 | 原铭牌/极性照片；[`H3/2026-10-12` 结构化报告](../../evidence/hardware/H3/2026-10-12/README.md) | PASS（H0 空载基本输出；D-04 CLOSED） |

判定：

- 实测极性必须与铭牌和计划连接方式一致；
- 实测输出应与适配器制造商规格一致；
- 如果只有“12 V”铭牌而没有公开空载容差，记录实际值，不擅自编造 ±X% 的产品合格标准；
- 输出为 0、极性与铭牌相反、明显不稳定、出现异味/异响/异常发热，立即断电并判为 FAIL；
- 无法解释的偏差判为 HOLD，不通过“接上负载看看”继续试验。

注意：空载电压正常不证明带载能力、纹波或瞬态性能合格。H0 只能形成身份、极性和基本输出证据。

### H0-06 偏差处理

任何偏差必须登记：

| 偏差 ID | 实物 ID | 类型 | 现象 | 证据 | 风险 | 当前处置 | 关闭条件 | 状态 |
|---|---|---|---|---|---|---|---|---|
| D-01 | R10K-01 | 初测不稳定/结果无效 | 初测 9.730 kΩ 为 Live Photo 跳变过程单帧；2026-09-24 在 20 kΩ 档补测显示 9.911 kΩ | 初测 `H0_R10K-01_measurement_9K730_20260923_01.jpg`；关闭证据 `H0_R10K-01_remeasurement_9K911_20260924_01.jpg` | 初测单帧不可用于判定；补测值靠近 ±1% 下限，未校准仪表不能形成精密容差认证 | 撤回初测超差推断；接受 9.911 kΩ 作为 H0 到货筛查值，不把它外推为计量合格证 | 补测读数落在 9.900～10.100 kΩ 名义带内；H0 按筛查用途接受。NTC 分压实际搭建时仍须检查 ADC 合理性 | **CLOSED 2026-09-24（H0 筛查范围）** |
| D-02 | 全部关键硬件 | 证据不足/可追溯性 | 2026-10-01 已补两块 NUCLEO 和两块 CAN Pal 背面原图；2026-10-02 已补两块 CAN Pal 可读顶标；2026-10-10 已补 `FAN-01` 标签与接口；2026-10-20 已补 `INA260-01` 正反面、接口与孤立无源记录。仍缺 Heater 铭牌、Heatsink 尺寸及部分辅材明细 | 2026-09-23/24 初始证据、2026-10-01/02 CAN 补证、[`H3/2026-10-10` FAN 补证](../../evidence/hardware/H3/2026-10-10/README.md)及[`H3/2026-10-20` INA260 补证](../../evidence/hardware/H3/2026-10-20/README.md) | CAN/H2、FAN/H3 与 INA260/H3 的身份子范围已具备可复核交叉证据；其余未补部分继续限制对应功率/装配范围 | NUCLEO、CAN Pal、FAN 与 INA260 的接线前身份子项关闭；功能接入仍受各自 Gate 分步授权，其余外设继续隔离 | 在对应功率 Gate 前补齐 Heater、Heatsink 和辅材证据；不把身份关闭外推为通信或外设功能通过 | **OPEN（CAN/H2 2026-10-02、FAN/H3 2026-10-10、INA260/H3 2026-10-20 身份子项 CLOSED；其余子项继续 OPEN）** |
| D-03 | HEATER-01 | 低阻修正基线缺失 | Heater 原始显示 10.50 Ω；2026-09-24 以同一万用表 200 Ω 档补测表笔短接约 0.3 Ω，未再次测 Heater | `H0_HEATER-01_measurement_10R50_20260923_01.jpg`；关闭证据 `H0_METER-01_lead-short_0R3_20260924_01.jpg` | 事后短接不能消除两次接触条件差异，修正值不是精密测量 | 保留 10.50 Ω 原值并形成约 10.20 Ω 筛查修正值；继续禁止安装通电和温升测试 | H0 只需识别开路、短路或数量级错件；约 10.20 Ω 满足筛查目的。后续功率 Gate 必须另做受控上电，不能引用本项作为温升/功率验证 | **CLOSED 2026-09-24（H0 筛查范围）** |
| D-04 | PSU12V-01 | 连续稳定性记录不完整 | 2026-10-12 在项目完全隔离、输出空载且仅接万用表时连续观察 10 s：`12.487～12.588 V`、末值 `12.588 V`，无跳变、异味、异响或异常发热 | 原铭牌/极性照片；[`H3/2026-10-12` 结构化报告](../../evidence/hardware/H3/2026-10-12/README.md) | 空载基本稳定性缺口已关闭；仍不能证明额定带载、纹波、动态响应或长期温升 | 记录拔电后约 2 min 残压；改线前等待灯灭并确认低于 `0.5 V`，不短接强制放电；12 V 实验仍服从后续 Gate 逐步授权 | 已完成空载约 10 s 连续观察并记录范围与异常项 | **CLOSED 2026-10-12（H0 空载基本稳定性范围）** |

处理规则：

- HOLD/FAIL 物料使用标签和收纳袋隔离；
- 不对不明模块尝试“反接一下”或“逐个针脚试电”；
- 等效替代件必须单独评审电压、逻辑电平、接口、封装、时序和软件影响；
- 替代件影响 CAN、Fault、Task、监督或职责边界时，必须走正式变更记录；
- 商家回复、数据手册和实物照片应关联到对应偏差 ID；
- 未关闭且影响下一 Gate 安全或目标的关键偏差会阻止 H0 通过；允许带入的偏差必须记录隔离边界、关闭条件和最迟关闭 Gate。

### H0-07 H0 总体验收

逐项确认：

- [x] 总览中可见的实际到货物料已列入清单并分配逻辑实物 ID；辅材精确数量仍见 D-02。
- [ ] 两块 NUCLEO、两个 CAN Pal 与 INA260 均已有独立正反面原图；Heater、Heatsink 及其余关键器件证据仍见 D-02。
- [ ] NUCLEO 型号/板版本、CAN Pal 实装顶标、FAN 标签/接口、INA260 正反面接口及 PSU 铭牌已有可复核记录；Heater 铭牌、Heatsink 尺寸及辅材明细仍见 D-02，最迟在对应功率/装配步骤前关闭。
- [x] 当前发现的测量异常和证据不足项均已登记；R10K-01 初测失效事实保留，9.911 kΩ 补测已按 H0 筛查范围关闭 D-01。
- [x] NTC、10 kΩ、4.7 kΩ、Heater 和两个 CAN Pal termination 均有独立测量照片。
- [x] 适配器铭牌、空载电压、实测极性及约 10 s 连续稳定性均已有证据；D-04 于 2026-10-12 按 H0 空载基本稳定性范围关闭。
- [x] 测量结论已区分采购/标称值、配置值和照片实测值。
- [x] 根据执行人说明和现有照片，未进行完整 12 V 功率连接。
- [x] 两个 CAN Pal 分别测量；未用一块的阻值代替另一块。
- [x] D-01、D-03、D-04 已在各自 H0 范围关闭；D-02 剩余子项以明确隔离条件带入后续 Gate，H0 继续判为 CONDITIONAL PASS。
- [x] Gate H0 过程未修改代码、Fault List、CAN Matrix 或 Task Architecture。

## 10. Gate H0 通过条件

仅当以下条件全部满足时，Gate H0 判定为 PASS：

1. 设备身份、数量和基本电气信息明确；
2. 每件关键硬件都有独立、可追溯的照片证据；
3. 必需的无源阻值、适配器空载电压和极性均已记录；
4. 没有未处置的关键错件、损伤、极性或接口不确定性；
5. 未进行复杂连接和完整功率上电；
6. H1 所需的两块 NUCLEO 均具备独立 USB 检查条件；
7. 记录内容真实，不把未测量项目描述为实测，不把推断描述为事实。

若非关键辅材缺失但不影响 H1，可将 Gate H0 判为“有条件通过”，但必须保留偏差 ID、补齐日期和对后续 Gate 的明确限制。关键板卡、适配器极性、模块身份或安全状态不明确时不得有条件通过。

## 11. H1 准入和仍然禁止的动作

Gate H0 PASS 或 CONDITIONAL PASS 只授权进入 H1 的最小动作：

1. 选择一块已验收的 NUCLEO；
2. 仅通过 USB 给该单板供电；
3. 不连接 12 V、Fan、Heater、CAN Pal、INA260 或 NTC；
4. 验证 Windows 枚举、ST-LINK、虚拟串口、CubeProgrammer 连接和目标器件信息；
5. 完成后断开，再对第二块板独立重复；
6. 一块成功不得外推另一块成功。

即使 Gate H0 PASS 或 CONDITIONAL PASS，仍不授权：

- 完整双节点 CAN；
- 风扇 12 V + PWM 联调；
- Heater 通电；
- INA260 高边功率接线；
- Thermal Plant 闭环；
- Fault 的真实危险刺激。

## 12. 常见不成熟思路及反驳

### 12.1 “先全部接起来，哪里不工作再查”

错误原因：同时引入电源、极性、线序、终端、模块版本和软件状态等多个未知量，既增加损坏风险，也破坏故障隔离。正确方法是按 Gate 逐步增加一个变量，并保留上一阶段可回退状态。

### 12.2 “两个板是同款，只验一块即可”

错误原因：同型号不代表同批次、同 PCB revision、同跳线状态或无个体损伤。双 ECU 项目最终依赖两块独立硬件，两块板必须分别建立身份和运行证据。

### 12.3 “线色很常见，照颜色接就行”

错误原因：不同厂家和转接线可能使用不同线序，PST 还增加额外接口。必须依据实物插头方向、标签和可靠资料确认，不能用颜色替代引脚定义。

### 12.4 “NTC 室温约 10 kΩ，所以已经证明它是 B3950”

错误原因：单点阻值只能支持标称阻值核对，不能唯一确定 B 值。B3950 需要采购资料或多温点测量支持。

### 12.5 “终端跳线看起来插上了，所以一定是 120 Ω”

错误原因：跳线位置、焊桥版本和板上并联路径都可能影响结果。必须记录配置，并在断电状态结合阻值和模块资料核对。

### 12.6 “万用表蜂鸣说明线路正确”

错误原因：蜂鸣只表示阻抗低于仪表阈值，不能证明阻值正确、极性正确、没有错误并联或能安全承载电流。

### 12.7 “缺少示波器，所以删掉时序、Fault 或 Recovery”

错误原因：低仪器依赖只改变证据获取方式。串口日志、计数器、Debugger、GPIO、软件注入和万用表可承担主线验证；可选仪器用于增强证据，不能改变冻结功能范围。

### 12.8 “空载 12 V 正常，所以适配器和整套功率回路都没问题”

错误原因：空载测量不能证明带载能力、纹波、瞬态、接线端子、公共地或 Heater 路径合格。它只完成 H0 的基本身份和极性检查。

## 13. Gate H0 结果记录

### 13.1 总结

| 项目 | 记录 |
|---|---|
| 执行日期 | 2026-09-23；首次补证与关闭评审 2026-09-24；分阶段子项补证持续至 2026-10-20 |
| 执行人 | 项目执行人；姓名/签名待补 |
| 总览照片 | [`H0_ALL_overview_20260923_01.jpg`](../../evidence/hardware/H0/2026-09-23/H0_ALL_overview_20260923_01.jpg) |
| PASS 项数量 | 7 个测量项：M-01～M-07；其中 M-02、M-04、M-07 仅为 H0 筛查/空载基本检查通过 |
| HOLD 项数量 | 0 个测量项；仍有整体证据偏差 D-02 的剩余外设子项 |
| FAIL 项数量 | 0；注意 CONDITIONAL PASS 不等于后续功能已经验证 |
| 已关闭偏差 | D-01、D-03、D-04（均限各自 H0 筛查/空载基本检查范围） |
| 带入偏差 | D-02 剩余外设子项 |
| Gate H0 结论 | **CONDITIONAL PASS（Gate 已结束，仅携带 D-02 剩余子项）** |
| 是否允许进入 H1 | **YES，仅限单块 NUCLEO、仅 USB、逐板验证** |
| 限制条件 | H1 当时仍限定单块 NUCLEO、仅 USB；后续外设和 12 V 动作必须服从所在 Gate 的逐步授权。D-02 剩余身份子项须在对应外设接入前关闭；D-04 的关闭不构成任意 12 V 回路的一次性放行 |

### 13.2 证据归档

- 原始照片按字节复制、规范重命名并集中归档于 [`../../evidence/hardware/H0/2026-09-23/`](../../evidence/hardware/H0/2026-09-23/README.md)；
- 2026-09-24 收到的 8 张身份、铭牌和关闭补充原图归档于 [`../../evidence/hardware/H0/2026-09-24/`](../../evidence/hardware/H0/2026-09-24/README.md)；
- 2026-10-01 收到的两块 NUCLEO 与两块 CAN Pal 背面原图归档于 [`../../evidence/hardware/H0/2026-10-01/`](../../evidence/hardware/H0/2026-10-01/README.md)；
- 2026-10-02 收到的两轮共四张 CAN Pal 芯片顶标补拍原图归档于 [`../../evidence/hardware/H0/2026-10-02/`](../../evidence/hardware/H0/2026-10-02/README.md)；首轮两张保留为未读清尝试，第二轮两张作为顶标关闭证据；
- 2026-10-10 收到的五张 FAN 标签/接口补拍原图按其实际发生阶段归档于 [`../../evidence/hardware/H3/2026-10-10/`](../../evidence/hardware/H3/2026-10-10/README.md)，用于关闭 D-02 的 FAN/H3 身份子项；不倒填为 H0 当日已经完成；
- 2026-10-12 的 PSU 空载 10 s 范围、异常项与拔电后残压按实际发生日期归档于 [`../../evidence/hardware/H3/2026-10-12/`](../../evidence/hardware/H3/2026-10-12/README.md)，用于关闭 D-04；该批为结构化现场文字报告，无同步照片或自动采样日志；
- 2026-10-20 收到的 INA260 正反面原图及孤立无源读数按实际发生阶段归档于 [`../../evidence/hardware/H3/2026-10-20/`](../../evidence/hardware/H3/2026-10-20/README.md)，用于关闭 D-02 的 INA260/H3 身份子项；不倒填为 H0 当日已经完成，也不提前写成功能通过；
- 归档清单记录原文件名、规范文件名、可见读数、证据边界、文件大小和 SHA-256；
- 当前共归档 25 张用户提交的 H0 原图；没有把分析用放大/裁剪图作为原始证据，也没有修改照片内容；
- 图片文件与记录文件进入 Git 工作区，随本次 H0 关闭记录提交。

### 13.3 结论声明

建议使用以下格式，不使用“应该没问题”“看起来能用”等含糊措辞：

> Gate H0 的现场检查和测量已于 2026-09-23 执行，并于 2026-09-24 完成补证和关闭评审。R10K-01 的 9.730 kΩ 初始照片继续作为跳变单帧保留；补充复测显示 9.911 kΩ，D-01 在 H0 筛查范围关闭。Heater 原始显示 10.50 Ω，补充表笔短接约 0.3 Ω，形成约 10.20 Ω 的非同时筛查修正值，D-03 在 H0 筛查范围关闭。Gate H0 判定为 CONDITIONAL PASS，允许进入仅 USB、单板、逐板执行的 H1。CAN/H2、FAN/H3 与 INA260/H3 的 D-02 身份子项已分别于 2026-10-02、2026-10-10、2026-10-20 关闭；D-04 于 2026-10-12 按空载基本稳定性范围关闭；D-02 的其他外设子项继续开放。本结论不代表 CAN、风扇、Heater、INA260、NTC、RTOS、Fault 或完整功率系统已经通过功能验证。

## 14. 变更控制

- 本文件可以根据实际执行中的测量方法、表格可用性和证据命名问题进行修订；
- 任何修订必须保留版本、日期、修改理由和影响；
- 不允许利用本文件修订绕过冻结 SAD、Fault List、CAN Matrix 或 FreeRTOS Task Architecture；
- 如需改变 CAN ID、DLC、Signal semantics、Fault scope、Task architecture、监督时间或 ECU 职责，必须建立独立设计变更记录；
- 实际物料与基线不同不代表可以自动修改设计，应先形成偏差和影响分析；
- Gate H0 完成后，应保存本文件的已填写版本以及必要照片/测量证据，未执行项必须明确标记，不得留白掩盖。

## 15. 修订记录

| 版本 | 日期 | 修改内容 | 原因 | 作者/执行人 |
|---|---|---|---|---|
| v1.0 | 2026-09-22 | 建立 Gate H0 到货验收、身份核对、测量、安全和准入基准 | 核心硬件到货，项目进入实物 Bring-up |  |
| v1.1 | 2026-09-23 | 归档 9 张现场证据；录入 M-01～M-07；建立 D-01～D-04；形成 H0 HOLD/H1 NO 结论 | 执行人完成现场测试，但 R10K-01 读数及照片/测量记录未满足全部关闭条件 | Codex 整理；执行人待补签 |
| v1.2 | 2026-09-24 | 归档 6 张身份/铭牌补充原图；撤回 R10K-01 单帧超差推断；补录 PSU 完整铭牌；细化 D-01～D-04 关闭条件 | 执行人补充说明测量上下文并提供关键正面/铭牌证据 | Codex 整理；执行人待补签 |
| v1.3 | 2026-09-24 | 归档表笔短接和 R10K-01 复测原图；关闭 D-01、D-03；将 D-02、D-04 带入后续 Gate；形成 H0 CONDITIONAL PASS / H1 YES 结论 | 新证据满足 H0 筛查目的，剩余偏差可通过严格隔离与 H1 目标解耦 | Codex 整理；执行人待补签 |
| v1.4 | 2026-10-01 | 归档两块 NUCLEO 与两块 CAN Pal 背面原图；关闭 D-02 的 NUCLEO 背面和 CAN Pal 背面子项，保留 CAN 收发器实体顶标及其他外设证据缺口 | H1 已 PASS，进入 H2 接外部信号前按带入偏差逐项完成身份追溯 | Codex 整理；现场执行人：用户 |
| v1.5 | 2026-10-02 | 归档两块 CAN Pal 中央 SOIC-8 顶标补拍尝试；确认板号对应关系可用但字符仍不可逐字复核；D-02 顶标子项保持 OPEN | 不把 PCB 背面丝印、模糊字符或生成式增强结果误当作实际装片型号证据 | Codex 整理；现场执行人：用户 |
| v1.6 | 2026-10-02 | 归档第二轮两块 CAN Pal 顶标原图；确认两颗中央 SOIC-8 均可辨 NXP 标志和 `A1051/3` 主标；关闭 D-02 的 CAN/H2 身份子项 | 新原图可将板号、实装芯片主标与 PCB 背面模块声明交叉关联，满足 H2 受控断电接线前提 | Codex 整理；现场执行人：用户 |
| v1.7 | 2026-10-10 | 归档 FAN 标签、主接口、PST 输出及延长线五张原图；确认 `P8 PWM PST / DC 12 V 0.09 A`，关闭 D-02 的 FAN/H3 身份接口子项 | 新证据解释 PST 三触点输出与四触点主接口/延长线的差异，满足 Fan PWM 后续分步准入的身份前提 | Codex 整理；现场执行人：用户 |
| v1.8 | 2026-10-12 | 归档 PSU 空载 10 s 范围、异常项和拔电后残压；关闭 D-04，更新 M-07、H0 汇总和后续安全规则 | 结构化现场报告补齐连续观察缺口，同时发现拔电后约 2 min 残压，需纳入后续改线前确认 | Codex 整理；现场执行人：用户 |
| v1.9 | 2026-10-20 | 归档 INA260 正反面、接口和孤立无源筛查；关闭 D-02 的 INA260/H3 身份子项，保留 I2C 与高边功能为 H3 后续门禁 | 新照片和无源结果已满足受控 3.3 V I2C 接入前的身份/短路筛查，但不支持提前宣称功能通过 | Codex 整理；现场执行人：用户 |
