Ben-nevis2006/stm32-freertos-dual-ecu-can-diagnostics/current/Gate_H2_CAN_Physical_Layer_Execution_Record_2026-10-02.md

# Gate H2 低压通信与 CAN 物理层执行记录

## 1. 文档控制

| 项目 | 内容 |
|---|---|
| 版本 | v1.0（Gate 关闭版） |
| 日期 | 2026-10-02～2026-10-07 |
| 状态 | **PASS** |
| 前序 Gate | Gate H0 CONDITIONAL PASS；Gate H1 PASS |
| 当前边界 | 仅两块 NUCLEO、两块 CAN Pal、USB 低压供电和 CAN 物理层；禁止 12 V、Fan、Heater、INA260、NTC 及其他外设 |
| 远端策略 | 2026-10-02～10-07 的动作按真实日期累计在本地；H2 关闭时统一整合、提交并只推送一次。统一推送不代表全部工作发生在同一天 |
| 证据索引 | 硬件：[`2026-10-02`](../evidence/hardware/H2/2026-10-02/README.md)、[`2026-10-03`](../evidence/hardware/H2/2026-10-03/README.md)、[`2026-10-04`](../evidence/hardware/H2/2026-10-04/README.md)；软件：[`2026-10-05`](../evidence/software/H2/2026-10-05/README.md)、[`2026-10-07`](../evidence/software/H2/2026-10-07/README.md)；复盘：[`排障证据链`](H2_CAN_Bringup_Troubleshooting_Evidence_Recap_2026-10-07.md) |

## 2. Gate 目标

1. 在全断电条件下搭建短距离双端 CAN 总线并确认两端终端并联约 `60 Ω`；
2. 核对两块 NUCLEO 与对应 CAN Pal 的 `3.3 V/GND/PA11-RX/PA12-TX/SLNT` 连接；
3. 先以固定帧和递增计数器验证双向收发，再接入正式 `0x100/0x180`；
4. 记录 ID、DLC、payload、Tx/Rx counter、CAN error state 与断开一端时的可观察行为；完整应用 timeout/fault 状态机明确递延到后续 Gate。

本 Gate 不验证 12 V 功率链、Fan/Heater/INA260/NTC、完整 Fault 逻辑或完整 FreeRTOS 应用闭环。

## 3. 执行记录

| 步骤 | 日期 | 动作/证据 | 结果 | 判定与边界 |
|---|---|---|---|---|
| H2-00 | 2026-10-02 | 两块 CAN Pal 的 PCB 背面规格与实体 SOIC-8 顶标交叉核对；两颗均可辨 NXP 标志及 `A1051/3` 主标 | D-02 的 CAN/H2 身份子项关闭 | PASS；仅证明身份，未证明通信 |
| H2-01 | 2026-10-02 | 两块 CAN Pal 无接线摆放，termination 滑块均位于板上 `ON` 丝印一侧；见 `H2_CANPAL-01-02_termination-switches-ON_20261002_01.jpg` | 两端终端开关位置可见 | PASS（位置核对）；尚未形成总线，也未测得约 `60 Ω` |
| H2-02A | 2026-10-02 | 两块 CAN Pal 仅通过绿色端子的 `H↔H`、中间 GND↔GND、`L↔L` 三根短线连接；两块 termination 保持 `ON`；见 `H2_CANPAL-01-02_passive-bus-wiring_20261002_01.jpg` | 同色线在两端占用相同端子位置，照片未见 H/L 交叉；无 NUCLEO、Vcc 或逻辑线接入 | PASS（接线视觉核对）；须在确认端子夹紧后测量 `CANH-CANL`，照片不能证明导通或约 `60 Ω` |
| H2-02B | 2026-10-02 | 全断电状态下，万用表置 `200 Ω` 电阻档，在总线 `CANH-CANL` 间测得 `60.41 Ω`；原始附件名 `fdfcf12e85fc457b67178ba2a0836b87.jpg`，SHA-256 `CF8997216029369B5887241575CA751C016AB4DE0FBE14C311AD8E1C66D9795E` | 读数位于继续条件 `58～62 Ω` 内，也与两只约 `120 Ω` 终端并联的预期值一致 | **PASS**；支持双端终端与总线连续性，不证明 H/L 极性、收发器有源功能、位时序或报文收发；微信临时原图路径已失效，仓库原图待用户重新附加后补归档 |
| H2-03A | 2026-10-03 | CANPAL-01 已焊接 `1×7` 排针；元件面和侧面近照显示七个焊点彼此分离，排针塑料座基本贴板 | 未见明确连锡；焊锡量偏大且部分焊点呈球状/表面不均匀 | **CONDITIONAL PASS（仅视觉）**；照片不能排除冷焊、内部未润湿或受力后间歇开路，上电前仍须完成 Vcc-GND 非短路检查 |
| H2-03B | 2026-10-03；2026-10-05 现场更正 | CANPAL-01 端四根逻辑线为 `TX=棕`、`RX=黄`、`GND=白`、`Vcc=黑`，`SLNT` 留空；CN10/电源排针补拍分别见 `H2_NODE-A_CN10-signal-pin-closeup_20261003_01.jpg`、`H2_NODE-A_CN6-power-pin-closeup_20261003_01.jpg`（后者历史文件名保留） | 现场确认棕/黄线都在板边外侧偶数列，不是内侧奇数列；但 Node A 两根信号线彼此插反：黄线位于 `CN10-12/PA12`，棕线位于 `CN10-14/PA11`。黑线和白线的电源列位结论不变 | **FAIL（Node A TX/RX 对调）**；撤销原“Node A 信号接线 PASS”。两板全断电后，只需把 Node A 外侧同列的棕/黄线互换，使棕线 `TX→CN10-12/PA12`、黄线 `RX→CN10-14/PA11`，复核后才能再次上电 |
| H2-03C | 2026-10-03 | Node A 与 CANPAL-01 保持连接、USB 和 `12 V` 均断开；万用表置 `200 Ω` 电阻档并跨接 CANPAL-01 的 `Vcc-GND`，见 `H2_NODE-A_CANPAL-01_Vcc-GND-resistance-overrange_20261003_01.jpg` | 显示 `1`，即该量程超量程，表示测得阻值大于约 `200 Ω`；未发现低阻短路 | **PASS（无源排短路）**；只放行 Node A 单板 USB 受控上电，不能证明焊点导通、供电电压或 CAN 收发功能 |
| H2-04A | 2026-10-03 | 只给 NUCLEO-01 接入 Mini-USB，Node B 与全部 `12 V`/功率外设保持断开；用户现场文字反馈“Node A 现象与先前独自上电一样，两块连着的 CAN Pal 都无现象” | Node A 未表现出相对 H1 独立上电基线的新异常；CAN Pal 无可见现象符合模块本身无状态指示灯、且尚未运行 CAN 收发程序的预期 | **PASS（30 s 受控上电，用户文字反馈）**；下一步必须实测 CANPAL-01 的 Vcc，尚不能证明模块已获得 3.3 V 或收发器可工作 |
| H2-04B | 2026-10-03 | Node A 保持 USB 上电，万用表置直流电压档，在 CANPAL-01 的 `Vcc-GND` 间测量；见 `H2_NODE-A_CANPAL-01_Vcc-3V288_20261003_01.jpg` | 稳定读数 `3.288 V`，位于继续区间 `3.2～3.4 V` 内 | **PASS（CANPAL-01 供电）**；证明模块电源脚获得正常 3.3 V，不证明 TX/RX 焊点导通、CAN 位时序或报文收发 |
| H2-05A | 2026-10-03 | CANPAL-02 的 `1×7` 排针焊接完成；元件面和侧面近照见 `H2_CANPAL-02_header-solder-top_20261003_01.jpg`、`H2_CANPAL-02_header-solder-side_20261003_01.jpg` | 七个焊点彼此可分辨，未见明确桥连；排针塑料座基本贴板，但锡量偏大、焊点外形不均匀 | **CONDITIONAL PASS（仅视觉）**；照片不能排除隐藏连锡、冷焊或内部未润湿，连接 NUCLEO-02 前先测 Vcc-GND 无源阻值 |
| H2-05B | 2026-10-03 | 两块 NUCLEO 与全部 `12 V`/功率外设断电，万用表置 `200 Ω` 档，在 CANPAL-02 的 `Vcc-GND` 间测量；见 `H2_CANPAL-02_Vcc-GND-resistance-overrange_20261003_01.jpg` | 显示 `1`，即该量程超量程，表示阻值大于约 `200 Ω`；未发现低阻短路 | **PASS（无源排短路）**；放行 CANPAL-02 与 NUCLEO-02 的断电接线，尚不能证明供电或 CAN 收发功能 |
| H2-06A | 2026-10-04；2026-10-05 现场复核 | CANPAL-02 与手写标记 `02` 的 NUCLEO-02 完成断电接线；模块端、CN10 和电源排针近照见 2026-10-04 证据目录 | 模块端为 `Vcc=黑、GND=白、RX=黄、TX=棕`，`SLNT` 留空；现场确认 CN10 棕/黄线均在板边外侧偶数列，且 Node B 的棕线位于 `CN10-12/PA12`、黄线位于 `CN10-14/PA11`；黑线落在 CN7 偶数列 `+3V3`、白线落在同列 `GND` | **PASS（Node B 信号与电源列位）**；此前根据斜视照片作出的“内侧奇数列”判断已撤回。当前修正只涉及 Node A，Node B 不动 |
| H2-06B | 2026-10-04 | Node B 完整接线保持、两块 NUCLEO 的 USB 与全部 `12 V`/功率外设断开；万用表置 `200 Ω` 档，在 CANPAL-02 的 `Vcc-GND` 间复测；见 `H2_NODE-B_CANPAL-02_Vcc-GND-resistance-overrange_20261004_01.jpg` | 显示 `1`，即该量程超量程，表示阻值大于约 `200 Ω`；完整 Node B 接线后仍未发现低阻短路 | **PASS（整套 Node B 无源排短路）**；只放行 Node B 单板 USB 受控上电，不证明实际供电电压或 CAN 收发功能 |
| H2-07A | 2026-10-04 | 仅 NUCLEO-02（Node B）接入 Mini-USB，Node A 保持未上电，CAN 总线与两块 CAN Pal 保持连接；见 `H2_NODE-B_controlled-USB-power_photo_20261004_01.jpg`；用户随后文字确认“30 秒观察与单片上电现象相同，无异常” | 照片可见 NUCLEO-02 的电源/状态灯已亮，未见 `12 V` 或其他功率外设接入；现场文字确认 30 s 未出现相对 H1 单片上电基线的新异常 | **PASS（30 s 受控上电，照片 + 用户文字反馈）**；放行 CANPAL-02 的带电 Vcc 测量，尚不能证明实际供电电压或 CAN 收发功能 |
| H2-07B | 2026-10-04 | Node B 保持单板 USB 上电，万用表置直流 `20 V` 档，在 CANPAL-02 的 `Vcc-GND` 间测量；见 `H2_NODE-B_CANPAL-02_Vcc-3V300_probe-incident_20261004_01.jpg`。用户同时报告：长时间手持探针拍摄期间，`LD1/COM` 偶尔由黄/橙色转为红色闪烁，移开探针后仍持续，断电重启才恢复 | 照片读数 `3.300 V`，位于继续区间 `3.2～3.4 V`；但正常高阻直流电压测量本身不应改变板上状态。ST 官方 UM1724 §7.6 将 `LD1/COM` 定义为 ST-LINK 通信状态灯：橙色表示通信失败，红色闪烁对应 USB 初始化/枚举阶段。因此现场现象支持“ST-LINK 曾发生通信/重新枚举扰动”，但现有证据无法区分探针瞬间碰邻点、线束/USB 被牵动或其他供电/USB原因 | **CONDITIONAL PASS（仅 CANPAL-02 供电数值）/ HOLD（稳定性）**；接受 `3.300 V`，不要求继续徒手重复带电探测；在双板同时上电前，先完成无探针、无触碰的 Node B 空闲稳定性复测 |
| H2-07C | 2026-10-04 | 移走表笔、关闭可能访问 ST-LINK 的软件并保持 Node B 与线束完全不触碰，重新上电后空闲观察 `2 min`；用户确认“2 分钟稳定”，并补充先前红闪与 Windows 断连/重连同步出现 | 无触碰条件下未自发复现；先前 `LD1/COM` 红闪与 Windows USB 断连/重连同步，确认当时发生了 ST-LINK USB 重新枚举，而不是 CAN 状态指示。结果支持扰动与测量/线束/USB 机械操作相关，但仍不能唯一确定是探针碰邻点还是 USB/跳线受力 | **PASS（无触碰稳定性隔离）**；解除稳定性 HOLD，保留“禁止徒手重复带电探针、后续异常先断开最近接入 USB”的操作约束，放行双板 USB 受控上电 |
| H2-08A | 2026-10-04 | 保持 Node B 稳定上电后接入 Node A Mini-USB，两块 NUCLEO、两块 CAN Pal 和三线总线同时保持连接并静置 `2 min`；用户确认“两块板 2 分钟稳定”，并说明为腾出第二个 USB 口已拔下 2.4 GHz 鼠标，当前端口可能与先前测量不同 | 当前双端口配置下，两节点未出现反复断连/重连或用户可观察异常；端口可能变化意味着该结果不能排除先前异常与原 USB 端口、插头接触或线缆受力有关 | **PASS（双板 USB 受控上电，当前端口配置）**；证明当前供电/总线组合可进入软件烧录阶段，不把先前 USB 重新枚举唯一归因于 CAN Pal、探针或某个 USB 端口 |
| H2-08B | 2026-10-04 | 在两板保持连接后只读查询 Windows PnP；见 `H2_WINDOWS_STLINK-enumeration_20261004.txt` | 两个 ST-LINK 复合设备、Debug 接口和 VCP 均为 `OK`。依据受控接入顺序与 LastArrival：Node B=`066DFF515149856767254421`/当前 `COM8`，Node A=`066BFF575151676667043206`/当前 `COM7` | **PASS（设备身份固化）**；后续烧录按 ST-LINK 序列号选目标，不按可能变化的 USB 端口或 COM 号；不证明固件身份或 CAN 通信 |
| H2-09A | 2026-10-05 | 在现有 Node A/Node B CubeIDE 工程内加入 H2 最小双向 CAN 测试逻辑，按 [`H2_CAN_Minimal_Test_Protocol_2026-10-05.md`](H2_CAN_Minimal_Test_Protocol_2026-10-05.md) 完成两工程静默全量重编译与静态检查；构建证据和 ELF 哈希见 `evidence/software/H2/2026-10-05/README.md` | Node A 与 Node B 均以 GNU Tools for STM32 14.3.1 构建成功且无编译警告/错误；Node A ELF=`E242964B…B300`，Node B ELF=`CA74BE27…54F3`；回调符号、`BOOT/STAT` 字符串、栈占用与空白检查通过 | **PASS（仅本地构建）**；固件尚未写入开发板，不能据此判定 CAN 收发、时钟容差、UART 日志或运行时稳定性通过；未提交、未推送远端 |
| H2-09B | 2026-10-05 | 两板按既定低压接线重新连接并由用户确认静置 `30 s` 无异常；CubeProgrammer 只读识别两块目标均为 Device ID `0x410`、128 KiB，目标电压 Node A=`3.25 V`、Node B=`3.24 V`。随后按 ST-LINK 序列号定向写入 H2 ELF，分别执行写入、校验和硬复位 | Node A `066BFF575151676667043206` 写入 `node_a.elf`，Node B `066DFF515149856767254421` 写入 `node_b.elf`；两次均返回 `Download verified successfully` | **PASS（身份、刷写与校验）**；只证明正确 ELF 写入对应实体板，不证明 CAN 运行通过；固件已刷入的事实取代 H2-09A 中“尚未写入”的当时状态 |
| H2-09C | 2026-10-05 | 重新确认 VCP 映射 Node A=`COM7`、Node B=`COM8`，同时采集约 `15 s` UART 运行预检；原始摘录见 `evidence/software/H2/2026-10-05/H2_CAN_runtime-precheck_failed_20261005.txt` | 两端均正常输出 `STAT`，说明 MCU/RTOS/UART 在运行；但两端都只有 `tx_q=3`，随后 `tx_fail` 持续增加、`mb_free=0`，且 `rx_irq=0`、`rx=0`。ESR 显示持续 CAN 错误/恢复循环 | **FAIL / HOLD（首次 CAN 运行预检）**；停止正式 `60 s` 测试。现场复核确认两板均在外侧偶数列，Node B 接线正确，Node A 的棕/黄 TX/RX 彼此对调；先在全断电状态只修正 Node A，再重跑预检 |
| H2-09D | 2026-10-05 | 用户将两板断电，只交换 Node A 外侧偶数列的棕/黄信号线，使棕线 `TX→CN10-12/PA12`、黄线 `RX→CN10-14/PA11`；重新上电后不重刷固件，同时采集两端约 `15 s` UART。追加原始摘录见同一预检记录 | 修正后故障模式未变：Node A/B 均为 `tx_q=3`、`mb_free=0`、`rx_irq=0`、`rx=0`，`tx_fail` 持续增加，ESR 继续出现 CAN 错误状态 | **FAIL / HOLD（修正后复测）**；Node A 对调并非唯一根因。停止继续盲换 TX/RX，也不进入正式 `60 s`；下一步仅用示波器检查 Node A `PA12/CAN Pal TX` 是否存在逻辑位流，再据结果分流到固件时钟/引脚或收发器/总线排查 |
| H2-10A | 2026-10-07 | 按 `PA12/TX→SLNT→CANH/CANL` 分层测量。Node B 在 SLNT 下拉后 H/L 出现相反趋势；Node A 同条件仍只有约 `1.25 V/0.06 V`。全断电对比两模块，异常 CANPAL-01 在 termination=`ON` 时相关端点约 `60.6 Ω`，用户随后发现终端网络外侧贴片附近有可疑焊锡接触并清理 | 清理后无源阻值恢复，Node A H/L 活动电平回到约 `3.3～3.4 V / 1.8～2.0 V` 范围 | **PASS（修复后复测）**；确认焊锡桥连是 Node A 模块异常的一项实测根因，但没有显微截面证明精确桥接节点，不扩张到器件内部损坏结论 |
| H2-10B | 2026-10-07 | 逐线隔离 TX/RX/H/L 后发现 Node B RX 路径存在开路/间歇接触表现；用户更换 RX 跳线并重启。后续又发现 Node B SLNT 跳线一度断连并重新固定 | RX 接收路径恢复；固定帧在 SLNT 重新可靠接地后由高 TEC/REC、偶发 seq_err 转为连续三轮零业务错误 | **PASS（跳线与 SLNT 接触修复）**；SLNT 由原“悬空”方案正式改为接 GND，跳线接触成为后续上电前必检项 |
| H2-10C | 2026-10-07 | 两节点从 HSI 派生系统时钟切换为 ST-LINK MCO `8 MHz` 的 HSE bypass，PLL×8 得到 SYSCLK `64 MHz`、APB1 `32 MHz`；CAN 保持 Prescaler 4、BS1 13TQ、BS2 2TQ、SJW 1TQ | 两工程重新构建、刷写和校验成功；名义 CAN=`500 kbit/s`、采样点 `87.5%` | **PASS（可重复时钟基准）**；消除双 HSI 偏差风险，但因与硬件修复相邻，不把时钟单独宣称为全部早期异常的唯一根因 |
| H2-11A | 2026-10-07 | 以 `0x321/0x322` 固定诊断帧连续采集三轮，每轮 `80 s`；原始日志及哈希见 [`2026-10-07 软件证据`](../evidence/software/H2/2026-10-07/README.md) | Node A 每轮约 `tx/rx=687/688`，Node B 每轮约 `690/689`；三轮双方 `tx_fail/rx_bad/seq_err/q_drop=0`，无 Warning/Passive/Bus-off | **PASS（固定帧重复性）**；通过的是修复后的短距离低压链路，不包含正式应用帧和功率负载 |
| H2-11B | 2026-10-07 | 固件切换为正式基线：Node B→A `0x100/DLC2`，Node A→B `0x180/DLC5`，100 ms 周期，4 位 AliveCounter 与 payload/保留位校验；两工程构建退出码 0，ELF 分别为 `22A9A6A…E502`、`9FFF0349…F31A`，定向刷写校验成功后采集 `80 s` | A=`687/688`、max TEC/REC=`16/0`；B=`690/689`、max TEC/REC=`4/0`；双方四项错误为 0、无错误状态、末态 ESR=0 | **PASS（正式帧基线）**；只证明当前静态测试向量与计数连续性，不代表完整 timeout/fault 状态机已验收 |
| H2-12A | 2026-10-07 | 两板全断电后只断开 Node B 的 H/L，再上电采集约 `30 s` | A `rx=0`、`tx_fail=194`、max TEC=248，出现 Warning/Passive；B `rx=0`、`tx_fail=187`、max TEC/REC=`240/123`，出现 Warning/Passive/Bus-off | **PASS（受控故障可观察性）**；证明链路断开能被错误计数和状态明确观测，不把故障窗口当稳定运行结果 |
| H2-12B | 2026-10-07 | 恢复 H/L 后先做 `80 s` 和无触碰 `30 s` 两轮复测 | 虽已恢复双向帧，A 仍分别出现 max TEC=252/208 与 Warning/Passive，B 各有 seq_err=1 | **FAIL / HOLD（恢复接触未稳定）**；拒绝用“已有收发”关闭 Gate，要求断电复核终端及所有刚操作过的连接 |
| H2-12C | 2026-10-07 | 用户断电后从两端分别测得 `60.3 Ω/60.4 Ω` 并重新检查线路接触；重新上电先采集 `30 s` 预检，再采集最终 `80 s` | 预检 A=`197/198`、B=`190/189`，四项错误 0；最终 A=`687/688`、B=`690/689`，双方四项错误 0、max TEC/REC=`6/0`、无 Warning/Passive/Bus-off、末态 ESR=0 | **PASS（断线后恢复）**；满足完整恢复窗口。两次失败与重新检查后通过支持“恢复阶段存在接触/重连问题”，但现有证据未唯一定位到某一个端子 |
| H2-13 | 2026-10-07 | 将 2026-10-02～10-07 的硬件照片、构建记录、失败日志、修复后日志、正式帧、故障注入和恢复证据去重整合；生成独立 [`排障证据复盘`](H2_CAN_Bringup_Troubleshooting_Evidence_Recap_2026-10-07.md) | 时间差异、责任边界、已证实根因、未唯一归因项和后续未覆盖范围均明确记录 | **PASS / GATE CLOSED**；本关闭包按既定策略在 H2 完成后统一提交并只推送一次，不回填或伪造历史 Git 提交时间 |

## 4. Gate 关闭结论

Gate H2 于 **2026-10-07 PASS**。结论由以下相互独立的证据共同支撑：

1. 全断电终端电阻从两端复测为 `60.3 Ω/60.4 Ω`；
2. 固定诊断帧连续 `3×80 s` 双向收发通过；
3. 正式 `0x100/DLC2` 与 `0x180/DLC5` 在 `80 s` 窗口内通过 ID、DLC、payload 和 AliveCounter 校验；
4. 断开 H/L 后双方错误状态与收发中断明确可见；
5. 恢复过程中两次高错误状态没有被误判为通过，重新检查连接后先通过 `30 s` 预检，再通过最终 `80 s` 稳定窗口；
6. 失败日志、通过日志、ELF 哈希和逐文件 SHA-256 均已归档。

H2 PASS 只授权进入下一低风险 Gate 的准备工作。全部 `12 V`、Fan、Heater、INA260、NTC 和其他功率外设继续保持禁止接入，直到相应 Gate 单独放行。完整应用 timeout、故障确认/恢复逻辑、负载、耐久和 EMC 不属于本 Gate 结论。

## 5. Gate H2 关闭条件

- [x] 双端 termination 全断电并联阻值约 `60 Ω`：早期 `60.41 Ω`，最终两端复核 `60.3 Ω/60.4 Ω`；
- [x] 两节点低压接线逐线复核，无 12 V 混入；TX/RX、RX 跳线、SLNT 和手工焊接相关问题均完成修复与复测；
- [x] 两块 NUCLEO 可在受控条件下稳定上电；先前手持探针期间 USB 重枚举事件按边界保留；
- [x] 固定测试帧双向连续收发可重复：`3×80 s` 通过；
- [x] 正式 `0x100/0x180` 帧的 ID、DLC、payload 与 4 位 AliveCounter 证据齐全；
- [x] 断开 H/L 能被明确观察，恢复后通过预检与完整稳定窗口；
- [x] 阶段证据、失败路径和当前文档已按 2026-10-02～10-07 的真实时间线去重整合；本文件所在 H2 关闭包按既定策略统一提交并只推送一次。
