Ben-nevis2006/stm32-freertos-dual-ecu-can-diagnostics/FreeRTOS_Task_Architecture_v0.1_Working_Baseline.docx

# FreeRTOS Task Architecture v0.1

Dual-ECU Thermal Management Control & Diagnostic System

Status: WORKING BASELINE

Upstream | SAD v0.1 + Fault List v0.1 + CAN Matrix v0.1
Scope | 5 application tasks + 1 non-task immediate protection path
Principle | 按时序/阻塞/数据所有权划分 Task；不按功能名机械拆 Task
Current state | Task structure frozen as working baseline; detailed IPC/priority numbers remain open

# 1. Task Architecture Snapshot

Node A：3 个 Application Task + 1 条即时保护路径；Node B：2 个 Application Task。FreeRTOS 负责执行时序与同步，Fault Manager / State Manager 保持为软件模块，不单独建 Task。

ECU | Execution Context | Trigger / Period | Relative Priority | Core Responsibility
A | A_ControlTask | 10 ms periodic | High | Demand→Target RPM；RPM/Current处理；闭环控制；本地执行器诊断；Fallback/输出仲裁
A | A_ComRxTask | CAN RX event-driven | Medium-High | 解析/验证 0x100 Cooling_Command；Alive/sequence/validity；维护 FA-07 Cooling Demand Communication Fault
A | A_Cyclic100msTask | 100 ms periodic | Low | 读取状态快照；编码并发送 0x180 Actuator_Status；Status Alive++
A | Immediate Protection Path | Hardware / interrupt event | Above tasks | 严重电气/硬件风险时立即进入 Safe Output；不是 FreeRTOS Task
B | B_ComRxTask | CAN RX event-driven | High | 解析/验证 0x180 Actuator_Status；Raw/Trusted freshness；维护 FB-03 / FB-04 通信监督
B | B_Cyclic100msSupervisorTask | 100 ms periodic | Medium | Temperature；Thermal Strategy；系统级 Fault；Fault Aggregation；State Manager；发送 0x100 Cooling_Command

# 2. Key Execution & Data-Ownership Rules

- A_ControlTask 是正常软件路径中 Final Fan Output / PWM 的唯一 Owner；A_ComRxTask 与 A_Cyclic100msTask 不直接写 PWM。
- FA-04 Motor Overcurrent 等严重风险走 Immediate Protection Path：先保护硬件，再由正常软件路径完成 Fault state、latch/recovery 与 CAN reporting。
- CAN RX ISR 只做最小化接收/唤醒工作，复杂解析和 Fault qualification 放到 ComRxTask。
- 通信类 Fault 放在 ComRxTask；执行器控制/传感器 Fault 放在 A_ControlTask；系统热管理 Fault 放在 B_Cyclic100msSupervisorTask。
- FA-06 Supply Voltage Fault 仅在 v0.1 最终纳入 Voltage sensing 时实现；Task 架构无需因此增加新 Task。

# 3. Fault → Execution Context Mapping

Fault | Owner | Execution Context
FA-01 Fan Stall | Node A | A_ControlTask
FA-02 Fan Speed Deviation | Node A | A_ControlTask
FA-03 RPM Feedback Fault | Node A | A_ControlTask
FA-04 Motor Overcurrent | Node A | Immediate Protection Path + A_ControlTask management/reporting
FA-05 Current Feedback Fault | Node A | A_ControlTask
FA-06 Supply Voltage Fault | Node A | A_ControlTask (if voltage sensing implemented)
FA-07 Cooling Demand Communication Fault | Node A | A_ComRxTask
FB-01 Overtemperature | Node B | B_Cyclic100msSupervisorTask
FB-02 Insufficient Cooling Performance | Node B | B_Cyclic100msSupervisorTask
FB-03 Node A Communication Timeout | Node B | B_ComRxTask
FB-04 Node A Alive / Sequence Fault | Node B | B_ComRxTask
FB-06 Plant Temperature Signal Fault | Node B | B_Cyclic100msSupervisorTask

# 4. IPC / Scheduling Working Decisions

Item | Working Decision
CAN ISR → ComRxTask | Use FreeRTOS Queue or equivalent frame buffer; ISR keeps processing minimal.
ComRxTask → control/supervisor | Latest-state mailbox/snapshot semantics; old state need not be replayed.
A_ControlTask period | 10 ms working baseline; control/fault thresholds and debounce remain calibration TBD.
CAN cyclic work | A status TX and B supervisor/command TX execute on 100 ms application cycle, matching CAN Matrix.
Priority rule | Set by response-time/deadline/blocking behavior, not by business importance. Exact numeric priorities remain open.
Mutex policy | Avoid broad shared mutable state; prefer clear data ownership and snapshot transfer. Add Mutex only for a demonstrated shared-resource need.

# 5. Open Items / Next Step

OI-12 is not fully CLOSED yet. The task structure and periods above are the current working baseline. The next step is to complete a compact Task Matrix with Inputs / Outputs / Blocking Behavior / IPC object / exact priority values, then close OI-12.

Source boundary: This document only records the FreeRTOS architecture decisions derived from the existing SAD, Fault List and CAN Matrix. It does not duplicate fault thresholds, CAN signal definitions or diagnostic calibration details.

STM32 + FreeRTOS Dual-ECU CAN Project | FreeRTOS Task Architecture v0.1
