Ben-nevis2006/stm32-freertos-dual-ecu-can-diagnostics/CAN_Matrix_v0.1_Design_Decision_Record.docx

CAN Matrix v0.1

Design Decision Record / 设计留痕

Dual-ECU Thermal Management Control & Diagnostic System

Document Status | WORKING BASELINE / Consistency checked; CAN Matrix core frozen
Purpose | 记录 CAN Matrix v0.1 前置决策及 Matrix 设计过程中已接受的接口、报文、监督与验证规则
Upstream Baseline | System Architecture Definition v0.1 + Fault List v0.1
Scope Principle | 最小但完整；优先按时结项、可验证、可用于简历与面试

本文件用于持续设计留痕。当前 CAN Matrix v0.1 的两条核心周期报文已形成 Working Baseline：Cooling_Command 与 Actuator_Status 的 CAN ID、DLC、Cycle/Timeout、Alive/Sequence、主要 Signal Packing 及错误处理边界已完成一致性检查；剩余主要为标定参数与正式发布整理。

# 1. 设计依据与当前阶段

SAD v0.1 已冻结 Node B = Supervisory ECU、Node A = Thermal Actuator ECU，以及“B 管系统，A 管执行器”的职责边界；B→A 的控制语义已冻结为 normalized Cooling Demand，而不是 Target RPM。Fault List v0.1 进一步冻结了本地 Fault Owner、跨 ECU Fault Propagation、Fallback、System Mode 与 Recovery 原则。

因此 CAN Matrix 不从 CAN ID 或 Byte Layout 开始，而是从“哪些信息必须跨 ECU，才能实现已经冻结的职责和 Fault 行为”反推。

Source: SAD v0.1 §1.1, §5, §9, §15-16；Fault List v0.1 §2, §9, §14。

# 2. v0.1 范围与推进原则

- 目标不是复制量产级 AUTOSAR 通信栈，而是形成一条完整、可实现、可验证、可在面试中讲清楚的工程链。
- 采用 top-down（自上而下）思路：SRS → SAD → Fault List → Cross-ECU Communication Requirements → CAN Matrix → FreeRTOS → Implementation/Test。
- CAN Matrix v0.1 优先保持小规模；计划以 2 条核心周期报文承载控制与状态监督，避免不必要的报文拆分。
- DBC 可作为 Matrix 完成后的低成本加分项，不作为阻塞 v0.1 结项的前置要求。
- 不在 v0.1 引入完整 AUTOSAR/ARXML、FIBEX、复杂 E2E Profile、独立 Heartbeat 报文、完整 UDS 或多执行器通信。

## 2.1 本轮新增术语简释

术语 | 含义 | 本项目中的位置
Top-down | 自上而下设计；先明确系统功能与责任，再落到通信实现 | 当前项目已有 SAD / Fault List，因此先提取跨 ECU 信息，再定 CAN 报文
DBC | CAN Database；机器可读的 CAN 网络数据库文件 | 可在 CAN Matrix 冻结后生成，用于 CAN 工具、解析和测试；v0.1 非阻塞项
Fault Injection | 故障注入；人为制造异常条件验证检测与反应链 | 用于验证 FA/FB Fault、Fallback、Mode 与 Recovery
Test Hook | 测试插口；允许测试模式覆盖输入而不改 Fault 结论 | 优先注入 RPM/Current/Temperature/CAN timing 等输入，而不是直接把 Fault flag 置 1
Telemetry | 遥测；上传运行数据用于观察/记录/测试 | Actual RPM 作为执行器状态、诊断证据和 Test/Telemetry 信号保留；B 不据此复制 A 的本地转速诊断。

# 3. Cross-ECU Signal Requirement — 当前工作基线

本轮讨论后的核心原则：不要因为 Node A “拥有”某个传感器，就把原始数据全部上传给 Node B。Node A 完成本地执行器诊断，Node B 接收必要的诊断结论、可用性和通信监督信息。

方向 | Signal | 状态 | 用途类别 | 存在理由 | Fault/架构追溯
B → A | Cooling_Demand | 必需 | Control | Node B 向 A 表达 normalized cooling request；A 再映射为内部 Target Fan Speed | SAD §5.1/§7；FA-07
B → A | Command_AliveCounter | 必需 | Supervision | A 用于判断 B→A 命令序列/新鲜度异常 | FA-07
A → B | Actuator_Availability | 必需 | System Context | B 不重复分析 A 的底层信号，只需知道执行器能力为 FULL / REDUCED / LOST 等 | Fault List Functional Availability；FB-02
A → B | Fault_Status | 必需 | Fault Propagation | 传播 FA-01~FA-07 的 Active/Confirmed 状态；其中 FA-02 使用 2-bit severity 表达 None / DEGRADED-level / SAFE-level，而不是单纯 0/1。 | Fault List §9/§12
A → B | Control_Mode | 必需 | Fallback Visibility | B 能知道 A 当前处于正常闭环、Open-loop fallback 或 Safe Output | FA-03 Reporting；Fault List §12
A → B | RPM_Valid | 必需 | Signal Validity | FA-03 明确要求 RPM_VALID=FALSE 对 B 可见 | FA-03 Reporting
A → B | Status_AliveCounter | 必需 | Supervision | B 用于 FB-04 Alive/Sequence 检测；周期 Status 同时支撑 FB-03 timeout | FB-03/FB-04
A → B | Actual_RPM | 保留 | Status / Diagnostic Evidence / Test | 上报实际转速，便于状态观察、诊断证据与闭环测试；Node B 不重新计算 FA-01/FA-02。 | Node A local RPM diagnosis；Test/Verification

注：本表是“跨 ECU 信息需求”工作基线，不等同于最终 Byte/Bit 布局。

## 3.1 明确不上传 / 暂缓上传的 Node A 原始数据

Signal / 信息 | v0.1 决策 | 理由
Motor_Current | 不传 B | 主要服务 Node A 的 FA-01 Stall discrimination、FA-04 Overcurrent、FA-05 Current Feedback Fault；B 不重复实现本地电流诊断。
Current_Valid | 不单独传 | FA-05 Active 已能表达 Current sensing path 不可信及诊断覆盖下降；当前 B Fault Detection 无强制需求。
Supply_Voltage | 暂不传 | SAD OI-04 仍是 OPEN；是否纳入 v0.1 sensing 尚未冻结。
Applied_Cooling_Demand | 暂不传 | FA-07 的 Hold Last / Local Conservative Demand 属于 A 本地 fallback；B 通过 FA-07 + Control_Mode 即可知道命令链已降级。
System_Mode B→A | 不传 | NORMAL / DEGRADED / SAFE 的系统级管理责任属于 Node B；A 提供自身 Fault/Availability/Control Mode，不反向依赖 B 的系统 Mode。
Node B 全部 FB Fault | 不传 A | A 不需要知道 B 是因 Overtemperature 还是 Plant Temperature Fault 提高冷却；B 通过 Cooling_Demand 表达执行请求。

# 4. 报文级规划与设计进度

为控制 v0.1 范围，v0.1 采用 2 条核心周期报文并已形成 Working Baseline：0x100 Cooling_Command（B→A）与 0x180 Actuator_Status（A→B）。两条报文均采用 100 ms 周期、300 ms 监督时间；不增加独立 Heartbeat 报文。

Message（工作名） | 方向 | 预计承载信息 | 备注
0x100 Cooling_Command | B → A | Cooling_Demand + Command_AliveCounter | Working Baseline：Cyclic 100 ms；Timeout 300 ms；DLC=2；4-bit Alive；无独立 Heartbeat。
0x180 Actuator_Status | A → B | Availability + Control Mode + Fallback + RPM Valid + Fault Status + Status AliveCounter + Actual RPM | Working Baseline：Cyclic 100 ms；Raw Timeout 300 ms；Trusted Freshness 300 ms；DLC=5；4-bit Alive。

# 5. Fault Injection / 可验证性设计原则

Fault List 中的 Fault 应尽量能够通过手动/软件注入异常输入来验证。优先验证完整链路：Injected Condition → Detection/Qualification → Local Reaction/Fallback → CAN Propagation → Node B System Reaction → Recovery。

原则：尽量注入“Detection Inputs”，不要直接把 FA/FB Fault flag 强制置 1。后者只能测试下游状态机，不能证明检测逻辑有效。

Fault | 推荐注入方式 | 难度 | 核心验证点
FA-01 | Run request 有效时注入 RPM≈0 + Current 支持 loaded/stall 条件 | 中 | A 本地保护 → Fault Status → B SAFE
FA-02 | 持续注入 Actual RPM 低于 Target RPM，并覆盖不同 relative speed error 严重程度 | 低 | A 计算 FA-02 severity：Level 1→DEGRADED；Level 2→SAFE；具体阈值保持 Calibration TBD
FA-03 | 注入 RPM missing/frozen/out-of-range | 低 | RPM_Valid=FALSE；Control_Mode→Open-loop fallback；必要时 SAFE
FA-04 | 软件注入 Current 超保护阈值；不做危险物理短路 | 低 | Immediate Local Protection → SAFE
FA-05 | 注入 Current frozen/out-of-range/contradiction | 低 | Current-dependent diagnostics disabled；Fault propagation
FA-06 | 若后续纳入 voltage sensing，则注入 UV/OV | 低 | Root-cause context / DEGRADED or SAFE
FA-07 | 停止 Cooling_Command、冻结/跳变 Command Alive、发送非法 Demand | 很低 | Hold Last → Confirm → Local Conservative Demand；Recovery re-qualification
FB-01 | 注入 Plant Temperature 超温 | 低 | B Confirm → SAFE / Emergency cooling
FB-02 | High Demand + A available，但模拟 Plant Temperature 长时间不改善 | 中 | 系统级 cooling performance fault，不等于某个 Fan component fault
FB-03 | 停止 Actuator_Status | 很低 | Status timeout → B SAFE
FB-04 | Status 继续到达，但冻结/跳变 Status Alive Counter | 很低 | Sequence Fault 与 complete timeout 区分；DEGRADED→SAFE
FB-06 | 注入 Plant Temperature frozen/invalid/out-of-range | 低 | Observability LOST → SAFE；normal thermal strategy disabled

Source: Fault List v0.1 §7-8 给出了各 Fault 的 Detection Inputs / Qualification / Reaction；§14 明确将 Fault Injection、fallback、Mode transition、recovery 纳入后续 Verification/Test。

# 6. v0.1 结项导向与范围控制

- CAN Matrix：形成可追溯的 Message/Signal 定义，覆盖控制、状态、Fault propagation 与通信监督。
- 双节点实现：Node B 正常发送 Cooling Demand，Node A 执行 fan control 并周期上报 Actuator Status。
- 通信故障：至少可验证 FA-07、FB-03、FB-04（丢命令、Status timeout、Alive/sequence 异常）。
- 执行器/传感器 Fault：通过 Test Hook 手动注入若干代表性 FA/FB Fault，验证 Detection→Reaction→CAN→Mode。
- 测试展示：能够记录/观察 Cooling Demand、Fault Status、Availability、Control Mode 与 Actual RPM；Actual RPM 作为执行器状态、诊断证据与测试可观测量保留，但 Node B 不重复实现 Node A 的 FA-01/FA-02 转速诊断。
- 不因 AUTOSAR、复杂 E2E、完整 UDS、过多 CAN Message 等扩展项阻塞项目结项和简历投递。

# 7. OI-01 — Cooling Demand Interface

SAD OI-01 要求在 CAN Matrix 前关闭 Cooling Demand 的 range / resolution / mapping。当前按 v0.1 “最小但完整”原则形成以下 Working Baseline；具体风扇 RPM 数值仍作为硬件/标定参数保留。

属性 | v0.1 Working Baseline
Signal Name | Cooling_Demand
Sender / Receiver | Node B → Node A
语义 | normalized functional cooling request（归一化功能级冷却请求）；不是 Target RPM、PWM 或实际冷却功率
Physical Range | 0 ~ 100 %
Resolution | 1 %
Raw Type | uint8
Raw 0 | 0 %，明确请求 Fan OFF
Raw 1~100 | 1~100 % valid Cooling Demand
Raw 101~254 | Reserved；v0.1 不赋予控制含义
Raw 255 / 0xFF | Invalid / Not Available；不得解释为 OFF

Demand→Fan Target Mapping：Demand=0 时 Target RPM=0；Demand=1~100 时采用单调线性映射，将 1% 对应 RPM_MIN_RUN、100% 对应 RPM_MAX。RPM_MIN_RUN / RPM_MAX 由后续硬件实测与 Calibration 冻结，不阻塞 CAN Matrix。

Fault / Test implication：0% 是合法 OFF 命令，而 0xFF / Reserved 值属于 command validity 异常，可用于 FA-07 输入侧 Fault Injection；不能把“无可信命令”误处理为“明确请求关闭风扇”。

Status: OI-01 interface semantics / range / resolution / invalid coding / mapping principle = WORKING BASELINE；具体 RPM 标定值 = TBD。

# 8. Cooling_Command — Message Working Baseline

Cooling_Command 是 B→A 的唯一核心控制周期报文。该报文本身同时承担命令更新与通信新鲜度监督载体，因此 v0.1 不再增加独立 Heartbeat 报文。

Message Attribute | Current Design
Message Name | Cooling_Command
Sender / Receiver | Node B → Node A
Transmission Type | Cyclic（周期发送）
Cycle Time | 100 ms
Command Timeout | 300 ms
DLC | 2 Byte
Application CRC | Not included in v0.1；采用 CAN 本身的帧级错误检测 + Alive/Timeout 监督
CAN ID | 0x100（11-bit Standard ID；低于 0x180，因此仲裁优先级高于 Actuator_Status）

## 8.1 Signal / Byte Layout

Byte | Bit | Signal | 编码 / 规则
Byte 0 | 0~7 | Cooling_Demand | uint8；0~100 valid；101~254 Reserved；0xFF Invalid
Byte 1 | 0~3 | Command_AliveCounter | 4 bit；0~15 循环递增，15→0 wrap-around
Byte 1 | 4~7 | Reserved | v0.1 发送固定为 0；接收端不赋予功能语义

## 8.2 Supervision / Qualification Rules

- First-frame initialization：Node A 收到第一帧合法 Cooling_Command 时，仅记录当前 Alive 作为 sequence supervision 起点，不要求初值必须为 0，避免 ECU 上电顺序造成误报。
- Valid Command：Cooling Demand 编码合法、Alive/sequence 合法，并处于允许的 reception freshness 范围内，才作为新的可信 command。
- Alive / Sequence qualification：单次 Alive 异常先作为 suspected；连续 2 次异常后 Confirm FA-07。发生单次 freeze / jump / sequence anomaly 时，以当前收到的 Counter 重新同步 LastAlive；若下一帧按新基准正常递增，则异常计数清零，避免偶发丢帧形成连锁误报。
- Timeout qualification：若 300 ms 内未获得新的有效命令，则 Confirm FA-07。Qualification 期间 Hold Last Valid Cooling Demand；Fault Confirm 后不得无限期依赖 stale command。
- Confirmed fallback：FA-07 Confirmed 后切换 Local Conservative Cooling Demand；RPM valid 时仍允许 Node A 继续本地 speed closed-loop。Local Conservative Demand 的具体百分比仍为 TBD。
- Recovery：连续 3 帧 valid command 后完成 communication re-qualification，才允许退出 command-loss fallback；模式切换应避免不必要的 actuator discontinuity。

## 8.3 Fault Injection Coverage

Injection | Expected Detection / Reaction
停止 Node B 发送 Cooling_Command | 300 ms 无 valid command → FA-07 Confirmed → Local Conservative Demand
保持报文发送但冻结 Alive Counter | 连续 2 次 sequence 异常 → FA-07 Confirmed
Alive 非法跳变 / sequence anomaly | 先 suspected；连续 2 次异常后 Confirm
发送 Cooling_Demand = 0xFF 或 Reserved 101~254 | Command validity 异常 → FA-07 qualification；不得当作 Fan OFF
恢复正常命令与正常 Alive | 连续 3 帧 valid command → Recovery qualification 完成

本节属于 CAN Matrix v0.1 的当前设计决策，不改变 Fault List 已冻结的 FA-07 两阶段 fallback 架构；它只是把原先 TBD 的 command timing / alive / recovery 规则落到可实现、可手动注入验证的第一版数值。

# 9. Actuator_Status — Message Working Baseline

Actuator_Status 是 A→B 的唯一核心周期状态报文。它向 Node B 提供执行器功能可用性、本地 Fault 结果、控制/后备状态、RPM 信号有效性以及 Actual RPM 证据，同时承担 Node A Status freshness / Alive supervision 的载体。

## 9.1 Message Attributes

Message Attribute | Current Design
Message Name | Actuator_Status
CAN ID | 0x180（11-bit Standard ID）
Sender / Receiver | Node A → Node B
Transmission Type | Cyclic（周期发送）
Cycle Time | 100 ms
Raw Reception Timeout | 300 ms；完全收不到 Status → FB-03
Trusted Status Freshness | 300 ms；报文仍到达但长期不可信 → FB-04 escalation
DLC | 5 Byte
Application CRC | Not included in v0.1；采用 CAN 帧级错误检测 + Alive/Timeout 监督

## 9.2 Signal / Byte Layout

Byte | Bit | Signal | Encoding / Semantics
Byte 0 | 0~1 | Actuator_Availability | 0=FULL；1=REDUCED；2=LOST；3=INVALID/Reserved
Byte 0 | 2~3 | Control_Mode | 0=IDLE_OFF；1=CLOSED_LOOP；2=OPEN_LOOP；3=SAFE_OUTPUT
Byte 0 | 4 | Fallback_Active | 0=Normal/No fallback；1=Fallback active
Byte 0 | 5 | RPM_Valid | 1=Actual_RPM可信；0=RPM feedback invalid
Byte 0 | 6~7 | Reserved | v0.1 发送固定 0
Byte 1 | 0 | FA01_Fan_Stall | 0=Inactive；1=Active Confirmed
Byte 1 | 1~2 | FA02_Speed_Deviation_Level | 0=None；1=DEGRADED-level；2=SAFE-level；3=Reserved；阈值为 Calibration TBD
Byte 1 | 3 | FA03_RPM_Feedback_Fault | 0=Inactive；1=Active Confirmed
Byte 1 | 4 | FA04_Motor_Overcurrent | 0=Inactive；1=Active Confirmed
Byte 1 | 5 | FA05_Current_Feedback_Fault | 0=Inactive；1=Active Confirmed
Byte 1 | 6 | FA06_Supply_Voltage_Fault | 0=Inactive；1=Active Confirmed；若 v0.1 sensing defer，则保持 0
Byte 1 | 7 | FA07_Command_Communication_Fault | 0=Inactive；1=Active Confirmed
Byte 2 | 0~3 | Status_AliveCounter | 4 bit；0~15 循环递增，15→0 wrap-around
Byte 2 | 4~7 | Reserved | v0.1 发送固定 0
Byte 3 | 0~7 | Actual_RPM Low Byte | 16-bit unsigned little-endian；1 rpm/bit
Byte 4 | 0~7 | Actual_RPM High Byte | 0~65534 rpm valid；0xFFFF = Invalid

说明：FA-02 的严重程度由 Node A 基于 Target RPM、Actual RPM、relative speed error 与 persistence 完成本地 Qualification；Node B 接收 severity / Availability 后做系统级 Mode 管理，不复制 A 的底层转速诊断。Actual_RPM 仍上报用于状态、证据和测试。

## 9.3 Status Supervision / Qualification Rules

- First-frame synchronization：Node B 收到第一帧结构/编码合法的 Actuator_Status 时，仅记录当前 Status_AliveCounter 作为 sequence 起点，不要求 Counter 从 0 开始。
- Alive anomaly re-sync：单次 freeze / jump / sequence anomaly 先记为 suspected，同时以当前收到的 Counter 作为新的 LastAlive 基准。若下一帧按新基准正常递增，则异常计数清零；这样允许偶发丢一帧而不会造成连锁误报。
- FB-03 Raw Reception Timer：以“任何一帧 Actuator_Status 到达”为刷新条件。连续 300 ms 完全无报文到达 → FB-03 Confirmed → Node B 进入 SAFE。Timeout 不等价于已证明 Node A CPU crash。
- FB-04 Trusted Status Freshness Timer：仅在收到通过结构/编码/Alive sequence 检查的可信 Status 时刷新。连续 2 次 sequence anomaly → FB-04 Confirmed，初始进入 DEGRADED；若 300 ms 内始终无法获得新的可信 Status，则 Status freshness 不可确认，FB-04 escalation → SAFE。
- Recovery：通信异常后连续 3 帧可信 Status（timing + sequence + encoding 均有效）完成 recovery re-qualification；恢复后仍需重新评估全部 Active Fault，不能直接假定 NORMAL。
- RPM validity consistency：RPM_Valid=0 时 Actual_RPM 必须编码为 0xFFFF；只有 RPM_Valid=1 时 Actual_RPM 才具有物理意义。

# 10. 一致性收口规则

本节用于关闭发布前发现的组合语义与监督边界问题。这些规则不增加新的 CAN Message / Signal，也不改变 CAN ID 或 DLC。

## 10.1 Availability / Control Mode / Fallback 组合约束

Scenario | Availability | Control_Mode | Fallback_Active | Key Status / Interpretation
健康且 Cooling_Demand=0 | FULL | IDLE_OFF | 0 | 风扇当前 OFF 不等于执行器能力 LOST。
正常 Cooling Demand >0 | FULL | CLOSED_LOOP | 0 | 正常 RPM closed-loop。
FA-03，Open-loop fallback eligible | REDUCED | OPEN_LOOP | 1 | RPM_Valid=0；FA03=1；Actual_RPM=0xFFFF。
FA-07，命令丢失但 RPM feedback 有效 | FULL 或 REDUCED | CLOSED_LOOP | 1 | 使用 Local Conservative Demand，但本地 RPM 内环仍可正常闭环。
FA-01 Fan Stall / Severe local protection | LOST | SAFE_OUTPUT | 0 | FA01=1；Safe Output 属于保护，不定义为 Fallback。
FA-04 Severe Overcurrent | LOST | SAFE_OUTPUT | 0 | Immediate Local Protection 优先于 normal/fallback request。
FA-05 Current Feedback Fault | FULL | CLOSED_LOOP 或 IDLE_OFF | 0 | 核心 RPM 控制仍可用，但诊断覆盖下降；B 可据 Fault Set 评估 DEGRADED。

Combination invariants（组合不变量）：CLOSED_LOOP 要求 RPM feedback valid；v0.1 中 OPEN_LOOP 仅作为 fallback 使用，因此 OPEN_LOOP ⇒ Fallback_Active=1；SAFE_OUTPUT 表示本地保护输出，不作为 fallback；IDLE_OFF 不表示 actuator unavailable。

## 10.2 两类 300 ms 监督语义

Supervision | 刷新条件 | 300 ms 未刷新后的含义 | Fault
Raw Reception Timer | 任何一帧 Actuator_Status 到达 | A→B Status flow 完全停止，A availability 无法确认 | FB-03 → SAFE
Trusted Status Freshness Timer | 新的可信 Status（编码/sequence/timing valid） | 报文可能仍在到达，但状态新鲜度/可信度无法确认 | FB-04 → DEGRADED，持续至 300 ms → SAFE

## 10.3 CAN ID / Arbitration Rationale

v0.1 使用 Standard 11-bit CAN ID：Cooling_Command=0x100，Actuator_Status=0x180。CAN 仲裁中数值更小的 ID 具有更高优先级，因此控制命令在总线竞争时优先于状态上报；该编号为本项目内部设计，不宣称为行业统一 ID。

# 11. 本轮决策状态与下一步

Item | 状态 | 当前结论 / 下一动作
CAN Matrix 范围 | Accepted | 采用最小但完整原则，优先工程链完整与按时结项。
Message 数量 | Accepted / Working Baseline | 2 条核心周期报文：0x100 Cooling_Command / 0x180 Actuator_Status。
Minimal Signals | Working Baseline | 核心 Signal packing 已完成；不增加 Motor Current / Voltage / Target RPM 等非必要跨 ECU 原始量。
Actual_RPM | Accepted | 保留于 Actuator_Status，作为执行器状态、诊断证据与 Test/Telemetry；B 不据此重复 A 的 FA-01/FA-02 检测。
Cooling_Demand 编码 | Working Baseline | OI-01 接口级已关闭：0~100%，1% resolution，uint8；0=OFF，101~254 Reserved，0xFF=Invalid；1~100 映射至 RPM_MIN_RUN~RPM_MAX。
Alive / Timeout 参数 | Working Baseline | 两条报文均 100 ms cycle、4-bit Alive。Cooling_Command：300 ms valid-command timeout；Actuator_Status：300 ms raw reception timeout + 300 ms trusted-status freshness supervision。Alive 异常后按当前帧重新同步，连续2次异常 Confirm；连续3帧可信报文完成 recovery re-qualification。
CAN ID / DLC / Bit Layout | Working Baseline | 0x100 Cooling_Command：DLC=2；0x180 Actuator_Status：DLC=5。两条报文主要 Byte/Bit Layout 已冻结，Reserved 位发送固定 0。
DBC | Optional Add-on | Matrix 稳定后可生成；不阻塞 v0.1 结项。

Next step: 按本文件已完成的一致性规则整理并发布正式 CAN Matrix v0.1 表格；随后进入 FreeRTOS Task Architecture。后续仅允许在不改变当前报文语义边界的前提下补充 Calibration/TBD 数值，若发生架构级变化需重新留痕。

# 12. 上游基线引用

1) System_Architecture_Definition_v0.1(1).docx — 重点参考 §1.1 Design Order、§5 ECU Responsibility Allocation、§7 Control Architecture、§9 CAN Communication Architecture、§15 Open Items、§16 Recommended Next Architecture Steps。

2) Fault_List_v0.1(1).docx — 重点参考 §7 Node A Fault Definitions、§8 Node B Fault Definitions、§9 Fault Propagation、§12 Diagnostic Exposure、§14 Traceability to Next Design Artifacts。

CAN Matrix v0.1 Design Decision Record | Page 1

STM32 + FreeRTOS Dual-ECU CAN Project | CAN Matrix Design Record
