Ben-nevis2006/stm32-freertos-dual-ecu-can-diagnostics/System_Architecture_Definition_v0.1.docx

System Architecture Definition

双 ECU 热管理控制与故障诊断系统

Version 0.1 | Architecture Baseline + Controlled Open Items

Node B — Supervisory ECU
│
│ CAN
▼
Node A — Thermal Actuator ECU
│
▼
Cooling Fan

Document Status: BASELINED v0.1

架构级决策已形成 v0.1 基线；详细标定、时序、器件与实现参数继续作为受控 TBD / Open Item。

# 0. Document Control

字段 | 内容
文档名称 | System Architecture Definition
项目 | Dual-ECU Thermal Management Control & Diagnostic System
版本 | v0.1
阶段 | System Architecture Definition
上游基线 | SRS v0.1
状态 | BASELINED v0.1 / 后续架构变更需留痕
主要硬约束 | Node A=执行ECU；Node B=监管ECU；执行对象=Cooling Fan；目标实习/就业地域=苏州
配套基线 | Fault List v0.1（独立文档；详细 Fault 定义、Reaction、Dependency / Arbitration 与 Recovery 以该文档为准）

## 状态标记说明

标记 | 含义
BASELINE | 当前已接受的架构决策。后续若修改，应明确说明修改原因及影响。
TBD | 尚未确定，但必须在后续阶段完成。
OPEN | 存在多个合理方案，需要设计评审后决策。
DEFERRED | 有意推迟到更适合的阶段，例如具体硬件型号。

# 1. Purpose and Scope

本文件定义系统从 SRS v0.1 进入实现之前的系统级架构。目标不是提前写死底层实现，而是明确系统由哪些部分构成、各部分承担什么责任、关键物理量由谁拥有、哪些接口必须存在，以及后续 Fault、CAN、FreeRTOS 和 Hardware Design 应基于什么边界继续展开。

本版本尤其强调“决策与理由同时保留”。对于每个已确定架构点，不仅记录 What，也记录 Why；对于尚未确定的点，不以假设冒充结论。

## 1.1 Design Order

SRS v0.1 [BASELINED]
↓
System Architecture Definition v0.1 [BASELINED]
↓
Fault Architecture / Fault List v0.1 [BASELINED companion]
↓
CAN Communication Architecture / CAN Matrix ← next
↓
FreeRTOS Task Architecture
↓
Hardware Selection
↓
Detailed Design & Implementation

开发顺序：先架构，后 CAN/RTOS/器件 [BASELINE]

设计依据：CAN Matrix 本质上回答“谁需要把什么信息发给谁”；FreeRTOS Task 划分本质上回答“哪些已确定功能需要独立执行上下文”。若 Node 职责、Fault Owner、Signal Owner 尚未确定就提前定 CAN ID、Task 或具体器件，很容易产生返工。

架构影响：当前阶段允许定义所需信号和接口，但具体 CAN ID、Task Priority、Queue/Semaphore、传感器型号、驱动芯片型号暂不冻结。

# 2. Architecture Principles

B 管系统，A 管执行器 [BASELINE]

设计依据：Node B 站在系统层决定“需要多少冷却”；Node A 站在执行器层决定“怎样让风扇正确执行，并判断执行器是否健康”。

Signal ≠ Sensor [BASELINE]

设计依据：架构先定义系统需要什么信息，例如 RPM Signal；Hardware Selection 再决定该信号来自 Hall、Encoder、风扇 Tach 或智能驱动器。

先 What，后 How [BASELINE]

设计依据：先确定需求、责任边界和接口，再确定算法、报文 ID、Task、驱动芯片和具体器件。

本地问题尽量本地检测 [BASELINE]

设计依据：与执行器本身直接相关的 RPM、Current 等异常优先由 Node A 检测；系统级热状态、节点监督和跨节点决策由 Node B 处理。

异常不能只输出 Motor Error [BASELINE]

设计依据：利用多信号提高 Diagnostic Coverage，尽量区分机械堵转、无电流、反馈丢失、系统过温、通信异常等不同根因。

设计必须可验证 [BASELINE]

设计依据：架构应支持正常、边界、异常、恢复场景，并为后续 Fault Injection、自动化测试和性能评价保留接口。

# 3. System Context Architecture

Thermal Plant / Heat Source
│ Temperature
▼
┌──────────────────┐
│ Node B │
│ Supervisory ECU │
└────────┬─────────┘
│ CAN: command / status / diagnosis
▼
┌──────────────────┐
│ Node A │
│ Thermal Actuator │
│ ECU │
└────────┬─────────┘
│ PWM / Drive
▼
Cooling Fan
▲ │
│ RPM │ Current
└─────────┘

系统上下文中的 Thermal Plant 指“被冷却对象/热源模型”。本项目当前尚未确定它具体模拟电池、电机、电力电子或抽象热源，因此保留为 TBD。

执行对象：Cooling Fan [BASELINE]

设计依据：在 Generic Motor、Cooling Fan、Window、Pump/Valve 等候选中，Cooling Fan 在硬件实现难度、Fault 设计空间、CAN/诊断自然度、闭环控制可展示性以及本科工程投入产出比之间取得最好平衡。它避免泵阀水路带来的机械/密封工作量，同时又比“通用电机控制”具有更明确的汽车系统 Use Case。

架构影响：项目身份采用热管理执行 ECU，而非普通 STM32 Motor Controller；后续可在不推翻系统边界的前提下扩展 Pump/Valve。

项目架构名称：Thermal Actuator ECU，而非永久写死 Fan ECU [BASELINE]

设计依据：“Cooling Fan”是当前 v0.1 的具体执行对象，而“Thermal Actuator ECU”描述的是架构职责。这样未来若增加阀或泵，只需扩展 actuator variant，不必重构 Supervisory/Execution 分层。

# 4. Top-Level System Decomposition

一级组成 | 当前角色 | 状态
Node B — Supervisory ECU | 系统级热管理决策、节点监管、系统状态与诊断协调 | BASELINE
Node A — Thermal Actuator ECU | 冷却风扇执行、本地反馈、本地故障检测 | BASELINE
CAN Communication Network | Node A / Node B 间的控制、状态、监控与诊断通信 | BASELINE（具体 Matrix TBD）
Thermal Plant / Heat Source | 被冷却对象或热源模型 | TBD
Cooling Fan Actuator | 单向、可变速、具备 RPM 反馈的电动冷却风扇；具体器件与驱动拓扑延后 | BASELINE（具体器件/驱动方式 DEFERRED）
PC Diagnostic / Test Tool | 后续诊断、故障注入、数据记录与自动化测试工具 | OPEN / 后续细化

# 5. ECU Responsibility Allocation

## 5.1 Node B — Supervisory ECU

职责 | 当前定义 | 状态
Thermal State Acquisition | 获取系统级 Temperature Signal | BASELINE
Cooling Demand Decision | 根据系统热状态决定所需冷却程度 | BASELINE
Command Generation | 向 Node A 下发归一化 Cooling Demand / Level 及必要模式/使能 | BASELINE；范围/分辨率 TBD
Node Supervision | 监督 Node A 的状态/通信新鲜度与可用性；Heartbeat / Alive Counter 具体机制后续定义 | BASELINE；具体机制 TBD
System-Level Fault Management | 汇总系统级故障、接收 Node A 本地 Fault Status，并基于 Functional Availability / Observability 管理系统模式 | BASELINE；详细 Fault 定义见 Fault List v0.1
Diagnostics Coordination | 承担系统级诊断协调与 DTC 管理的主要责任；Node A 提供本地 Fault Status / evidence | BASELINE responsibility；DTC 存储/清除规则 TBD
System State Management | 负责 INIT / NORMAL / DEGRADED / SAFE 的系统级模式管理，并在 Fault Set 变化后重新评估当前可用能力 | BASELINE；精确转移/恢复计时 TBD

Node B = Supervisory ECU [BASELINE]

设计依据：监管 ECU 应拥有“系统是否需要冷却”的信息和决策权，而不直接操纵 PWM。这样 Node B 的职责是监督与目标管理，Node A 的职责是执行与本地闭环，双 ECU 不再是为了演示 CAN 而人为拆分。

## 5.2 Node A — Thermal Actuator ECU

职责 | 当前定义 | 状态
Command Reception & Validation | 接收并验证 Node B 的 Cooling Demand / Level；range / resolution / timeout 规则仍待定义 | BASELINE；接口参数 TBD
Demand Mapping & Fan Control | 将 Cooling Demand 映射为内部 Target Fan Speed，并执行本地转速闭环，生成 PWM / equivalent 驱动命令 | BASELINE；映射与控制器形式 TBD
RPM Feedback Acquisition | 获取风扇实际转速，作为本地闭环控制与执行器诊断的公共反馈量 | BASELINE
Motor Current Monitoring | 获取电机电流，主要用于本地监测、保护及诊断，不作为正常转速闭环的主反馈量 | BASELINE
Local Fault Detection | 检测 FA-01~FA-07 范围内的执行器、反馈、供电与命令通信异常；详细定义见 Fault List v0.1 | BASELINE；具体阈值/Qualification TBD
Status Reporting | 向 Node B 报告实际状态与本地故障 | BASELINE；CAN signals TBD
Local Safe Reaction | 严重本地异常时可不依赖 CAN 立即保护；RPM 反馈丢失等可在 Fallback Eligibility 满足时进入受限运行 | BASELINE capability；具体参数/重试策略 TBD
Command / Supervisor Monitoring | 监控来自 Node B 的 Cooling Demand 更新/有效性，确保旧命令不会被无限期继续执行；Heartbeat / Alive Counter 与 timeout 参数后续定义 | BASELINE responsibility；机制 TBD

Node A = Execution / Thermal Actuator ECU [BASELINE]
设计依据：RPM 和 Current 都直接描述执行器是否正确响应命令。将这类信息放在 Node A 可缩短控制、检测与保护链路，并避免 Node B 过度介入底层执行细节。
保护原则：本地保护不能依赖 CAN 可用性。Node A 在确认严重执行器本地异常后，应能够先进入安全输出，再向 Node B 上报。具体 Fault Trigger / Reaction / Fallback / Recovery 框架见独立《Fault List v0.1》；阈值、计时、retry/latching 等标定细节继续 TBD。

# 6. Signal and Sensing Architecture

Signal | Owner / Acquisition ECU | 主要用途 | 优先级 | 状态
Temperature | Node B | 热管理决策；系统级 Overtemperature 判断 | Must | BASELINE
Fan RPM | Node A | 闭环控制；Stall；Speed Deviation；反馈有效性 | Must | BASELINE
Motor Current | Node A | Overcurrent；Stall 识别；电气/机械故障区分 | Must | BASELINE
Supply Voltage | Node A | Undervoltage / Overvoltage；供电有效性 | Should | OPEN / 推荐
ECU/Motor Local Temperature | Node A | 本地过温保护 | Could | DEFERRED

Plant Temperature Signal 归 Node B [BASELINE]

设计依据：这里的 Temperature 明确指 Thermal Plant / Cooling Target 的系统级温度，而不是风扇电机、Motor Driver 或 ECU 本体温度。Supervisor 应根据该系统热状态计算归一化 Cooling Demand，并通过 CAN 将功能级请求发送给执行 ECU。

架构影响：Node B 形成系统级热管理闭环的上层决策；Node A 不需要知道整个系统为什么需要该冷却程度，而是负责把 Cooling Demand 转换为当前执行器可执行的局部目标。

Plant Temperature 与 Node A 本地温度不是冗余关系 [BASELINE]

设计依据：Node B 的 Plant Temperature 用于判断被冷却对象 / Thermal Plant 的热状态；Node A 若后续实现 Fan Motor / Driver / ECU Local Temperature，其用途是执行器本地热保护。两类温度测量对象不同、物理含义不同，因此不能互相替代，也不能把 Node A 本地温度当作 Plant Temperature 的后备测量。

边界说明：Node A 本地温度能力本身仍保持 DEFERRED，不因本次讨论自动纳入 v0.1 必做项；本次冻结的是两类温度信号的语义边界和不可替代性。

v0.1 温度可观测性与高级交叉验证范围 [BASELINE SCOPE / DEFERRED EXTENSION]
当前 v0.1：保留单一 Plant Temperature 物理测量路径作为 Thermal Plant 的主要观测来源。若该信号 Confirmed Invalid，系统失去对被冷却对象热状态的可信观测，因此 FB-06 在当前 v0.1 映射为 SAFE；即使仍命令风扇进行 Emergency / Conservative Cooling，该动作也只能降低风险，不能证明 Thermal Plant 已恢复安全。具体 Emergency Cooling Demand 数值与恢复 Qualification 仍 TBD。
已评估的企业化手段：物理冗余温度测量、不同物理量交叉 Plausibility、Analytical Redundancy、Thermal Model / Observer、Virtual Sensor、Residual-based Fault Detection，以及 Fault Detection / Isolation / Accommodation 思路。
范围取舍：上述机制具有明确工程价值，但会引入模型辨识、标定、残差阈值、故障隔离和验证工作。为控制 v0.1 范围，当前不把它们升级为实现要求；待 v0.1 主链完成后，再作为 Optimization / Future Extension 评估。

Fan RPM Signal 归 Node A [BASELINE]

设计依据：RPM 是最直接的执行器结果反馈。Target 与 Actual 的比较应首先发生在执行 ECU，以支持闭环、Speed Deviation、Stall 和反馈丢失检测。

Motor Current Signal 归 Node A [BASELINE]

设计依据：Current 的价值主要是诊断而非单纯增加一个传感器。RPM≈0 + Current High 更接近机械堵转；RPM≈0 + Current≈0 更接近断路、未供电或驱动异常。多信号组合能提升 Diagnostic Coverage。

Supply Voltage 作为推荐监测量 [OPEN]
设计依据：供电电压监测通常实现成本低，却能解释很多“风扇不转”的根因，并支持欠压/过压保护。FA-06 Supply Voltage Fault 已保留在 Fault List v0.1；是否在 v0.1 实际实现该检测仍由 OI-04 在 Hardware Selection / FA-06 implementation 前冻结。

## 6.1 Generic Signal Processing Chain

Raw Signal
↓
Acquisition
↓
Signal Conditioning / Filtering
↓
Plausibility Check
↓
Physical Value
↓
Control / Monitoring
↓
Fault Qualification

传感器值不得未经检查直接进入控制与诊断 [BASELINE]

设计依据：现实传感器会受噪声、瞬态、断路/短路和异常跳变影响。Plausibility Check 用于判断数值是否物理合理；Fault Qualification 用于避免单次异常立即生成正式故障。

架构影响：具体滤波算法、上下限、变化率、debounce 次数和时间阈值全部留待 Signal/Fault Detailed Design。

# 7. Control Architecture

Thermal Plant Temperature
↓
Node B
Thermal Strategy
↓ CAN
Cooling Demand / Level
↓
Node A
Demand Validation / Mapping
↓
Target Fan Speed
↓
Local Closed-loop Speed Control
↓
PWM / equivalent
↓
Unidirectional Variable-speed Fan
↓
Actual RPM
└────────→ Node A feedback

控制分层与执行器行为 [BASELINE]

设计依据：Supervisor 不直接发送底层 PWM；Node B 负责系统级 Cooling Demand，Node A 负责把功能请求转成当前执行器可执行的局部目标。

执行器基线：v0.1 采用单向、可变速、具备 RPM 反馈的电动 Cooling Fan。无需反转；可变速用于保留 Cooling Demand 的连续/近连续调节能力，RPM 同时服务本地闭环与诊断。

控制/监测边界：Node A 的正常控制主链为 Cooling Demand → Target Fan Speed → Closed-loop Speed Control → PWM / equivalent；Motor Current 主要进入 Monitoring / Protection 路径。Fan OFF 与最大能力饱和必须在架构上可表达，具体阈值与策略仍为 TBD。

Node B → Node A：Cooling Demand / Cooling Level [BASELINE]

设计依据：v0.1 采用归一化 Cooling Demand，而不是由 Node B 直接下发 Target RPM。Node B 表达“系统需要多少冷却”，Node A 再依据执行器标定/映射将 Cooling Demand 转换为内部 Target Fan Speed，并完成本地闭环控制。该接口降低 Supervisory ECU 与具体风扇转速范围、硬件型号和驱动细节之间的耦合。

架构影响：当前 v0.1 仅配置 Cooling Fan，但功能级 Cooling Demand 接口明确保留 Future Multi-Actuator Thermal Management Extension，可在实际生产式架构中扩展至 Fan / Pump / Valve 等多种冷却执行方式协同。Cooling Demand 仅表示 normalized functional request（归一化功能请求），不得解释为已经测得的实际物理冷却功率。Cooling Demand 的 range、resolution、Demand→Fan Target Mapping 仍为 TBD。

本地转速闭环 [BASELINE；控制器形式 TBD]

设计依据：Node A 应根据内部 Target Fan Speed 与 Actual RPM 形成本地闭环，使风扇执行效果不直接依赖固定 PWM 与供电/负载变化。RPM 因而既是 Control Signal，也是 Diagnostic Signal。

仍未确定：具体采用 P、PI、PID、查表+反馈修正或其他控制器，以及控制参数、PWM 频率、Duty 限制、最低稳定转速等，均留到后续 Control / Detailed Design。

Thermal Plant 模型 [TBD]

设计依据：尚未决定用真实加热对象、功率电阻/加热片、受控热源还是软件/半实物热模型。该选择会影响 Temperature Signal 的真实性、测试安全性和系统闭环表现。

# 8. Fault Management Architecture

本节定义 Fault Management 的系统架构边界，并给出架构级摘要。正式 Fault List v0.1 已作为独立配套文档建立，逐条 Fault 的 Detection Inputs、Enable Condition、Qualification、Reaction / Fallback、System Mode、Recovery、Dependency / Suppression 与开放标定项以该文档为详细基线；SAD 仅保留 Owner、主要影响、模式判据和跨 ECU 管理原则，避免重复维护。

Fault Source
↓
Fault Detection
↓
Fault Qualification
↓
Fault Manager
├── Local Reaction
├── Status / Fault Reporting
├── System State Impact
└── DTC / Diagnostic Exposure

Fault Detection Scope | Detection / Management Owner | 当前状态
FA-01 Fan Stall | Node A | BASELINE；检测/Reaction 详见 Fault List v0.1；阈值/Recovery TBD
FA-02 Fan Speed Deviation | Node A | BASELINE；可受 Supply Voltage 等 Root-Cause Context 抑制；阈值 TBD
FA-03 RPM Feedback Fault | Node A | BASELINE；支持条件式 Open-loop Fallback；准入/映射 TBD
FA-04 Motor Overcurrent | Node A | BASELINE；严重过流本地保护优先；warning/protection thresholds TBD
FA-05 Current Feedback Fault | Node A | BASELINE；诊断覆盖降级；Plausibility TBD
FA-06 Supply Undervoltage / Overvoltage | Node A | Fault family BASELINE；实际检测依赖 v0.1 是否冻结 Supply Voltage sensing（OI-04）
FA-07 Cooling Demand Communication Fault | Node A（接收方） | BASELINE；Last Valid → Local Conservative Demand 两阶段 Fallback；参数 TBD
FB-01 Overtemperature | Node B | BASELINE；有效 Plant Temperature 超限；threshold / hysteresis TBD
FB-02 Insufficient Cooling Performance | Node B | BASELINE；系统功能级不足；性能判据 / observation window TBD
FB-03 Node A Communication Timeout | Node B（接收方） | BASELINE；Node A 可用性不可确认 → SAFE；timeout TBD
FB-04 Node A Alive Counter / Message Sequence Fault | Node B（接收方） | BASELINE；DEGRADED → SAFE；Counter / persistence rules TBD
FB-06 Plant Temperature Signal Fault | Node B | BASELINE；Thermal State Observability Lost → SAFE；Emergency Cooling value TBD

Fault Detection 责任与通用原则 [BASELINE]
设计依据：Node A 最接近风扇、RPM、Current 和驱动状态，因此执行器本地 Fault 由 Node A 首先检测；Node B 负责系统热状态、节点监督、跨 ECU 关联与系统级 Fault Aggregation。
检测原则：每个 Fault 应定义 Detection Enable Condition；启动/瞬态等不适用阶段允许 Inhibition；除需要立即保护的严重故障外，异常应经过 Qualification / Debounce 后再确认。
信号原则：确认无效的 Sensor / Feedback Signal 不得继续被无条件用于闭环控制或依赖该信号的诊断逻辑。
保护原则：严重本地机械/电气故障允许 Node A 不依赖 CAN 自主进入安全输出，并随后向 Node B 上报。
关联原则：Fault 之间应支持 Dependency / Suppression / Arbitration，避免把后果故障与根因故障无差别并列。Node B 不重复实现 Node A 的全部本地检测算法，而是接收本地 Fault Status 并结合 Temperature、Cooling Demand、Node A Availability 等系统上下文进行管理。

Multi-Fault Arbitration [BASELINE]
系统 Mode 必须基于全部 Active Confirmed Fault 的综合影响重新评估，而不是把 Fault 名字直接映射后简单“取最大值”。已知 Root Cause 可抑制能够被其充分解释的 Consequential Fault Qualification，但不得删除原始测量和诊断证据。Signal invalidation 必须传播到依赖该 Signal 的控制/诊断能力；Immediate Local Hardware Protection 优先于正常控制和降级运行请求。跨 Actuator / Functional / System 层的 Fault 在描述不同抽象层时可以同时保留。

正式 Fault List v0.1 [BASELINE / INDEPENDENT DOCUMENT]
详细 Fault 定义已迁移到独立《Fault List v0.1》。SAD 保留架构级 Fault Scope、Owner、System Mode、Fallback 与跨 ECU Fault Management 摘要；详细 Detection Enable、Qualification、Recovery、Dependency / Suppression、Open Calibration Items 以 Fault List 为准。
编号说明：FB-05 保留为历史编号占位，不再定义为独立 Fault；“Node A Reported Actuator Fault”属于 A→B Fault Propagation / Aggregation 机制。

## 8.1 Fault → System Mode / Reaction Framework

本阶段已冻结 Fault Reaction 的系统级判据与第一版模式映射。系统模式不由 Fault 名称机械决定，而由两个核心维度共同决定：Functional Availability（热管理功能还剩多少可用能力）与 Observability（关键热状态是否仍可被可信观测）。若功能下降但关键状态仍可控制、可观测、可验证，则进入 DEGRADED；若关键功能丢失、不可确认，或关键热状态不可观测，则进入 SAFE。

Fault | Primary Impact | v0.1 System Mode | 状态
FA-01 Fan Stall | v0.1 单风扇主执行器丢失 | SAFE | BASELINE；Recovery / retry TBD
FA-02 Fan Speed Deviation | 冷却能力下降但未完全丢失 | DEGRADED → SAFE | BASELINE escalation；root-cause suppression 允许
FA-03 RPM Feedback Fault | 本地转速闭环反馈丢失 | DEGRADED if fallback eligible; otherwise SAFE | Open-loop fallback capability BASELINE；eligibility/mapping TBD
FA-04 Severe Motor Overcurrent | 硬件风险，需要本地保护 | SAFE | Immediate local protection BASELINE；阈值 TBD
FA-05 Current Feedback Fault | 控制可继续，但诊断覆盖下降 | DEGRADED | BASELINE
FA-06 Supply Voltage Fault | 能力下降或执行器不可用 | DEGRADED / SAFE | Severity boundary TBD；实现依赖 voltage sensing 决策
FA-07 Cooling Demand Communication Fault | 正常命令链失效；A 本地能力可能保留 | DEGRADED / SAFE | Two-stage fallback BASELINE；参数 TBD
FB-01 Overtemperature | 有效温度已越过允许热边界 | SAFE | BASELINE；阈值/Hysteresis TBD
FB-02 Insufficient Cooling Performance | 系统冷却能力不足 | DEGRADED → SAFE | BASELINE escalation；判据 TBD
FB-03 Node A Communication Timeout | 核心执行 ECU 可用性不可确认 | SAFE | BASELINE
FB-04 Alive / Sequence Fault | A 状态新鲜度/可信度下降 | DEGRADED → SAFE | BASELINE escalation；规则 TBD
FB-06 Plant Temperature Signal Fault | Thermal Plant 关键状态不可观测 | SAFE | BASELINE；Emergency Cooling value TBD

System Mode 判据 [BASELINE]
NORMAL：关键热管理功能完整，关键状态可可信观测。
DEGRADED：功能/诊断能力有所下降，但关键状态仍可控制、可观测、可验证。
SAFE：关键功能无法保证/确认，或关键安全相关状态已失去可信观测；进入预定义风险降低行为。SAFE 不等于“已经证明安全”，也不等于“所有输出必须关闭”。
Multi-Fault：最终 Mode 由全部 Active Confirmed Fault 的综合功能影响、Observability 与 Protection State 决定，而不是单一 Fault 的固定优先级查表。

## 8.2 Fallback Control Architecture

Fallback（后备策略）用于正常控制链的一部分失效、但系统仍保留部分可用能力时继续提供受限功能。v0.1 目前已冻结以下架构方向；具体数值、映射、计时与切换阈值仍为 TBD。

Fault / Trigger | 失效链路 | Fallback 行为 | 状态
RPM Feedback Fault | A 的转速内环反馈丢失 | 若剩余执行器健康信息允许继续运行，Node A 切换为 Open-loop Fan Control：Cooling Demand → fallback PWM mapping → Fan；Current / Voltage 等剩余信息继续用于保护和有限诊断。 | Open-loop fallback capability = BASELINE；mapping / entry / exit / limits TBD
B→A Cooling Demand Communication Fault | 系统命令链丢失，但 A 本地执行能力可能正常 | 短时扰动先保持 Last Valid Cooling Demand；通信故障确认后切换到 Local Conservative Cooling Demand，并在 RPM 有效时继续使用本地闭环。通信恢复需重新 Qualification 后才回正常命令控制。 | Two-stage fallback = BASELINE；timeout / hold time / fallback demand / recovery count TBD
Plant Temperature Signal Fault | B 的热管理外环失去 Thermal Plant 观测 | 停用正常 temperature-based thermal strategy，进入 SAFE；执行器仍可用时允许 Emergency / Conservative Cooling Demand。该动作仅降低风险，不能证明 Thermal Plant 已安全。 | Reaction principle = BASELINE；emergency demand value TBD

两层闭环边界 [BASELINE]
外环（Node B）：Plant Temperature → Thermal Strategy → Cooling Demand，用于回答“系统需要多少冷却”。
内环（Node A）：Target Fan Speed → Speed Controller → PWM → Actual RPM，用于回答“风扇是否把局部目标真正执行到位”。
因此 Fallback 不必然等于开环：Plant Temperature Fault 破坏外环但 A 的 RPM 内环仍可工作；只有 RPM Feedback Fault 才直接涉及把本地转速闭环降级为开环控制。

## 8.3 Recovery and Fault Latching Principles

Fault 条件暂时消失不等于系统可以立即恢复。Operational Recovery（运行模式恢复）与 Diagnostic History / DTC Erasure（故障历史清除）是不同问题。具体哪些 Fault 自动恢复、哪些需要锁存/人工清除，仍留到 Fault List / Diagnostic Architecture。

Recovery Framework [BASELINE]
1) Fault disappearance ≠ immediate recovery；恢复必须经过 Recovery Qualification。
2) System Mode 恢复要求：所需功能能力恢复 + 关键 Observability 恢复 + 当前运行条件处于允许范围。
3) Temperature Signal Fault：传感器恢复后先重新验证信号可信度，再恢复 Thermal Plant 可观测性并评估实际温度；若温度仍不安全，则继续保持 SAFE。
4) Communication Fault：必须通过连续有效报文/正常时序/Alive 等恢复确认后，才允许退出 local fallback；具体规则 TBD。
5) Normal / fallback 模式切换应避免不必要的 actuator discontinuity（可在后续控制设计中采用 ramp / bumpless transfer）。
6) 系统恢复 NORMAL 不代表历史 Fault / DTC 自动删除；DTC 的存储、锁存和清除策略仍为 TBD。
7) Recovery 时必须重新评估全部 Active Confirmed Fault；一个导致 SAFE 的 Fault 消失后，若仍存在其他降级故障，系统可 SAFE → DEGRADED，而非直接 NORMAL。

# 9. CAN Communication Architecture

CAN 被确定为 Node A 与 Node B 的通信网络，但本版本不提前定义 CAN ID、DLC、Bit Position 或 Cycle Time。CAN Matrix 必须建立在 Node 职责、Fault List 和命令语义冻结之后。

消息类别 | 方向 | 目的 | 状态
Control Command | B → A | 传递 Cooling Demand / Cooling Level，以及必要的模式/使能信息 | BASELINE；编码/分辨率 TBD
Actuator Status | A → B | 实际 RPM、电流、状态等 | BASELINE；具体信号 TBD
Heartbeat / Node Supervision | 双向：各 ECU 监控其接收方向的关键通信/状态新鲜度 | A 监控 B 的命令可用性；B 监控 A 的状态/节点可用性 | BASELINE responsibility；Heartbeat 具体机制 TBD
Alive Counter | 随周期报文 | 检测报文序列/软件活性 | OPEN；位宽与规则 TBD
Fault Status | A → B / 双向 | 报告本地或系统故障 | BASELINE 概念；格式 TBD
Diagnostic Request / Response | PC/Node B/Node A 之间 | 读状态、DTC、清故障等 | TBD

CAN Matrix 延后 [DEFERRED]

设计依据：B → A 的控制命令语义已冻结为 Cooling Demand，但其 range / resolution / 编码方式仍未确定；同时哪些 Fault 必须跨节点传播、Heartbeat / Alive Counter 规则等也尚未冻结。因此 CAN ID、Signal 布局、周期与超时参数仍缺乏完整稳定基础。

# 10. System State and Mode Architecture

System Mode 的状态集合与判据已形成当前 BASELINE：INIT / NORMAL / DEGRADED / SAFE。FAULT 不作为独立 Operating Mode，而作为 Fault / Diagnostic Status 存在；RECOVERY 作为恢复/转移过程处理。多 Fault Arbitration 的架构原则也已冻结：Mode 基于全部 Active Confirmed Fault 的综合 Functional Availability、Observability 与 Protection State 重新评估；具体阈值、优先级编码、抑制条件和恢复计时仍在 Fault List / Detailed Design 中保持 TBD。

[INIT]
↓ initialization / readiness
[NORMAL] ↔ [DEGRADED]
↘ ↓
[SAFE]

Mode 决策依据：Functional Availability + Observability + Active Fault Set。
Recovery 时重新评估全部 Active Confirmed Fault。
多 Fault Arbitration 原则 = BASELINE；精确转移阈值、优先级编码与时序 = TBD

State / Mode 定义 [BASELINE]
INIT：系统初始化、自检、通信/信号建立阶段。
NORMAL：关键热管理功能完整，关键状态可可信观测。
DEGRADED：功能或诊断能力下降，但关键状态仍可控制、可观测、可验证。
SAFE：关键功能无法保证/确认，或关键安全相关状态不可观测；系统执行预定义风险降低行为。SAFE 不代表“已经证明安全”。
FAULT：作为 Fault / Diagnostic Status 存在，不作为独立 Operating Mode。
RECOVERY：作为恢复与状态转移过程处理，不作为稳定运行 Mode。
Multi-Fault Arbitration 架构原则已冻结：基于 Active Fault Set + Functional Availability + Observability + Protection State 综合重评。仍未确定的是精确转移/恢复阈值、retry/latching、各模式完整允许行为与详细 suppression/event ordering。

# 11. FreeRTOS / Software Architecture

当前只确定系统将使用 FreeRTOS；Task 数量、职责、优先级、周期以及 Queue/Semaphore/EventGroup 等 IPC 机制全部延后到 Functional/Fault/CAN Architecture 更稳定后。

候选软件功能 | 是否一定独立 Task | 状态
CAN RX Processing | 未定 | TBD
CAN TX / Periodic Messaging | 未定 | TBD
Fan Control Loop | 未定 | TBD
Sensor Acquisition / Monitoring | 未定 | TBD
Fault Manager | 更可能是模块，也可能有周期执行入口 | TBD
Diagnostic Service | 未定 | TBD
System Supervisor / State Manager | 未定 | TBD

不把每个功能强行做成 Task [BASELINE]

设计依据：FreeRTOS Task 是执行上下文，不是模块分类法。Fault Manager 等功能可能更适合作为普通软件模块，被周期任务或事件调用。必须先看周期、阻塞、实时性与并发需求再决定。

# 12. Hardware Architecture and Selection

本阶段仅定义“需要什么能力”，不冻结具体器件。具体 STM32、CAN Transceiver、Fan/Motor、Motor Driver、RPM Sensor、Current Sensing、Temperature Sensor 等全部在 Hardware Selection 阶段决策。

硬件能力需求 | 状态
Node A/B MCU 具备 CAN 能力 | BASELINE Requirement
Node A 具备 PWM 输出能力 | BASELINE Requirement
Node A 具备 RPM 采集能力（Timer/Input Capture 等） | BASELINE Requirement
Node A 具备 Current ADC 采集能力 | BASELINE Requirement
Node B 具备 Temperature Signal 采集能力 | BASELINE Requirement
Node A 供电电压监测能力 | OPEN / 推荐
具体 MCU 型号 | DEFERRED
具体 CAN Transceiver | DEFERRED
具体 Motor Driver | DEFERRED
具体传感器型号 | DEFERRED

具体器件选型延后 [DEFERRED]

设计依据：架构阶段先定义 Signal 和能力，避免被某个手头器件反向绑架系统设计。例如“需要 RPM Signal”不等于现在必须决定使用哪款 Hall Sensor。

# 13. Verification and Test Architecture Considerations

虽然详细 Test Specification 尚未开始，但架构必须从现在起确保系统可测试。特别是苏州目标汽车电子岗位常见的 ECU/CAN/诊断/异常场景/自动化测试能力，使“可验证性”成为本项目的重要工程价值，而不是最后临时补测试。

验证方向 | 建议内容 | 状态
Normal Scenario | 目标变化、稳态控制、状态上报 | Planned
Boundary Scenario | 极低/极高目标、传感器边界、供电边界 | Planned
Abnormal Scenario | 堵转、断开反馈、过流、通信丢失 | Planned
Recovery Scenario | 故障消失后的恢复与清除策略 | TBD
Fault Injection | 人为制造传感器/执行器/通信异常 | Planned
Automated Test | PC/Python 驱动命令、记录日志、判定结果 | OPEN / 推荐
Control Performance Evaluation | Target/Actual、Rise Time、Overshoot、Steady-state Error 等 | OPEN / 推荐

PC 工具不提前称为 HIL [BASELINE]

设计依据：HIL（Hardware-in-the-Loop）有明确的工业含义。当前更准确的定位是 Fault Injection & Automated Test Harness / ECU Test Tool；除非后续真正构建具有 Plant Simulation 和 ECU I/O 闭环的硬件在环环境，否则不使用 HIL 作为项目宣传术语。

加入 Control Performance Evaluation [OPEN]

设计依据：Target RPM、Actual RPM、PWM Duty、Motor Current、Temperature、Fault State 等数据可由 PC 记录，并计算响应时间、超调、稳态误差等指标。该增强开发成本低，但能把“能转”提升为“可量化验证控制表现”。

# 14. Architecture Decision Rationale: Project Positioning

本节不是系统运行所必需的技术需求，而是记录本项目为什么选择当前架构方向，避免后续迭代时丢失当初的关键权衡。

目标地域：苏州 [BASELINE]

设计依据：项目后续职业导向以苏州汽车电子/嵌入式岗位为主要参考，而不是以全国所有岗位取平均。苏州是实习和毕业就业的硬性地域约束。

架构影响：项目优先覆盖 ECU、C/C++、MCU、CAN/UDS、Sensor/Actuator、Diagnostics、Testing、RTOS 等可迁移能力，而不是为某一家外地公司的特殊产品线过拟合。

Cooling Fan 优于 Generic Motor 作为项目身份 [BASELINE]

设计依据：Generic Motor 技术上可覆盖 PWM、Timer、RPM 和闭环，但项目语义过于宽泛、与大量学生项目雷同。Cooling Fan 赋予同一套底层技术明确的汽车热管理 Use Case，并自然产生 Temperature、Stall、Overtemperature、Degraded Operation 等系统级问题。

不为“更像汽车”强行选择 Pump/Valve [BASELINE]

设计依据：泵阀系统确实具有更强的物理真实感，但水路、密封、接头、流量测量等机械/流体工作会消耗大量开发资源，而对本科嵌入式软件能力展示的边际收益有限。

架构工程链本身是项目价值的一部分 [BASELINE]

设计依据：项目不以“最终让风扇转起来”为唯一成果，而是保留 Project Charter → SRS → Architecture → Fault List → CAN Matrix → RTOS Design → Test 的工程链，使每项实现都能追溯到需求和架构决策。

# 15. Open Items / TBD Register

ID | Open Item | 优先级 | 最晚决策点
OI-01 | Cooling Demand 参数 / 映射 | High | CAN Matrix 前
OI-02 | Cooling Fan 本地闭环控制器形式 / 参数 | High | Software Architecture 前
OI-03 | Thermal Plant / Heat Source 如何实现 | High | Hardware Selection 前
OI-04 | Supply Voltage 是否纳入 v0.1 必做信号 | Medium | Hardware Selection / FA-06 implementation 前
OI-05 | 各 Signal 的有效范围、滤波、Plausibility 规则 | High | Detailed Design
OI-06 | 正式 Fault List v0.1 已独立建立并与 SAD 对齐 | CLOSED | 完成
OI-07 | Fault-specific calibration：threshold / debounce / recovery qualification 数值 | High | Detailed Design / Calibration
OI-08 | Fault Reaction 剩余实现细节：fallback 数值、retry/latching、详细 suppression / event ordering | High | Detailed Fault / Diagnostic Design
OI-09 | DTC 的 Owner、存储与清除策略 | High | Diagnostic Architecture
OI-10 | Heartbeat / Alive Counter 具体规则 | High | CAN Architecture
OI-11 | System Mode 精确转移/恢复时序；状态集合与综合判据已冻结 | High | Software / State Machine Design
OI-12 | FreeRTOS Task / Priority / Period / IPC | High | CAN + Functional Architecture 后
OI-13 | 具体 MCU / Transceiver / Driver / Sensor 器件 | Medium | Hardware Selection
OI-14 | PC Diagnostic/Test Tool 范围 | Medium | Test Architecture
OI-15 | Control Performance Evaluation 是否纳入 v0.1 交付 | Medium | Test Planning

# 16. Recommended Next Architecture Steps

1. 定义 CAN-facing Cooling Demand 接口细节：range / resolution，以及 Node A 内部的 Demand → Fan Target Mapping。
2. 明确 Thermal Plant 的抽象边界：温度代表什么对象，以及如何产生/变化。
3. Node A / Node B 职责分配、System Mode 集合与 Fault Manager 边界已形成 BASELINE；DTC 存储/清除与诊断服务细节继续作为受控 Open Item。
4. Fault List v0.1 已独立建立并与 SAD 对齐；后续故障细节变更应在 Fault List 留痕，并仅在改变系统架构边界时同步修改 SAD。
5. 基于已冻结的职责、Fault List 与 Fallback / Status 需求建立 CAN Matrix v0.1。
6. 在 CAN/周期/事件需求稳定后建立 FreeRTOS Task Architecture。
7. 最后根据性能和接口要求进行 Hardware Selection。

# Appendix A — Current Architecture Snapshot

Project: Dual-ECU Thermal Management Control & Diagnostic System

Node B: Supervisory ECU
- Owns system-level Temperature Signal
- Generates normalized Cooling Demand
- Supervises Node A availability / status freshness
- Owns system-level supervision and state-management responsibility

CAN: Cooling Demand / Status
↓

Node A: Thermal Actuator ECU
- Current actuator: unidirectional variable-speed Cooling Fan
- Maps Cooling Demand → internal Target Fan Speed
- Executes local closed-loop speed control
- Owns Fan RPM and Motor Current Signals
- Recommended: Supply Voltage Signal
- Executes local actuator fault detection and autonomous local protection capability
- Monitors supervisory command freshness / validity

Architecture Principle:
“B manages the system; A manages the actuator.”

# Appendix B — Baseline vs TBD Summary

已冻结 / Baseline | 仍开放 / TBD
Node A = Thermal Actuator ECU；B→A = Cooling Demand | Cooling Demand range/resolution/mapping
Node B = Supervisory ECU | Closed-loop controller form / parameters
Actuator = unidirectional variable-speed Cooling Fan with RPM feedback | Thermal Plant implementation
Communication = CAN | CAN Matrix（ID / cycle / bit layout / timeout / alive encoding）
Temperature → Node B | Fault thresholds / qualification / recovery
RPM → Node A | System Mode 精确转移/恢复阈值、各 fallback 数值/计时参数、详细 suppression / event ordering
Motor Current → Node A | CAN Matrix
Supply Voltage = recommended | FreeRTOS Task Architecture
Local actuator faults / immediate local protection primarily owned by Node A | Hardware part numbers
System-level supervision/state-management responsibility primarily owned by Node B | PC diagnostic/test tool scope
v0.1 Plant Temperature：单一主观测路径；Node A 本地温度不构成冗余替代 | 高级温度交叉验证 / Analytical Redundancy / Thermal Observer / Virtual Sensor：DEFERRED 至 v0.1 完成后的优化阶段
System Modes = INIT / NORMAL / DEGRADED / SAFE；Fault 与 Operating Mode 分离；Mode 判据基于 Functional Availability + Observability | 具体 transition 时序、fallback 数值、retry/latching / DTC clear 规则仍 TBD
Fallback architecture：RPM 反馈失效支持条件式 open-loop fallback；B→A 命令丢失采用 Last Valid → Local Conservative Demand 两阶段策略；Plant Temperature 失效进入 SAFE 并允许 emergency cooling | Fallback mapping/value、timeout、recovery qualification 数值与 bumpless/ramp 具体实现
Recovery principle：Fault disappearance ≠ immediate recovery；运行恢复与故障历史/DTC清除分离 | 各 Fault 自动恢复/锁存/人工清除分类与具体条件
Fault List v0.1 已独立建立；FB-05 仅保留为 Fault Propagation / Aggregation 编号痕迹；Multi-Fault Arbitration 架构原则已冻结 | 各 Fault 具体 calibration、详细 suppression priority、DTC persistence/clear 规则

Architecture Baseline v0.1 | Controlled TBD / Open Items intentionally retained for downstream design

STM32 + FreeRTOS Dual-ECU CAN Project | System Architecture Definition v0.1
