Ben-nevis2006/stm32-freertos-dual-ecu-can-diagnostics/system requirement specification v0.1.docx

# System Requirements Specification v0.1

## 1. 文档目的

本文档定义项目在 系统层面必须实现什么能力。

它回答的是：

系统应该做什么？

而不是：

软件具体怎么实现？

因此本阶段暂时不决定：

- CAN ID 具体是多少；
- FreeRTOS Task 有几个；
- Task Priority 是多少；
- Queue 长度是多少；
- 具体 STM32 型号；
- CRC 使用什么算法；
- DTC 存 RAM 还是 Flash。

这些属于后续 System Architecture / Software Design 阶段。

# 2. 系统整体拆分

整个系统先拆成 9 个一级功能块：

Dual-Node CAN System

│

├── 1. System Startup & Initialization

│

├── 2. Node A — Device ECU

│

├── 3. Node B — Supervisor ECU

│

├── 4. CAN Communication

│

├── 5. Control

│

├── 6. Fault Detection & Fault Management

│

├── 7. DTC & Diagnostics

│

├── 8. Safe State & Recovery

│

└── 9. PC Diagnostic & Test

除此之外，还有一组横跨整个系统的要求：

10. Real-Time Requirements

11. Reliability Requirements

12. Observability & Testability

13. Documentation & Engineering Requirements

# 3. 系统角色

系统包含三个主要角色。

## 3.1 Node A — Device ECU

ECU：Electronic Control Unit，电子控制单元。

汽车里可以简单理解为：

一块负责某个具体功能的控制电脑。

本项目中 Node A 负责接近“现场设备”的功能：

Sensor

↓

Node A

↓

Actuator

主要职责：

- 采集传感器；
- 接收 Node B 控制命令；
- 控制执行器；
- 检测自身部分故障；
- 向 Node B 报告状态。

## 3.2 Node B — Supervisor ECU

Supervisor 可以理解为：

上级监控控制节点。

Node B 不直接负责主要传感器采集，而负责：

- 监控 Node A；
- 下发控制命令；
- 判断通信是否正常；
- 管理系统故障；
- 管理系统状态；
- 保存 DTC；
- 和 PC 诊断端交互。

## 3.3 PC Diagnostic Tester

Tester 指：

用于观察、测试和诊断 ECU 的外部工具。

PC 不是系统正常运行必须依赖的控制节点。

它主要用于：

- 看系统状态；
- 看 CAN 数据；
- 查看故障；
- 清除故障；
- 人为制造测试故障。

# 4. 一级需求结构

项目需求按照以下编号管理：

SYS-INIT 系统启动

SYS-A Node A

SYS-B Node B

SYS-COM CAN通信

SYS-CTL 控制

SYS-FLT 故障检测

SYS-DTC 故障记录与诊断

SYS-SAFE 安全状态

SYS-REC 恢复

SYS-PC PC诊断

SYS-RT 实时性

SYS-REL 可靠性

SYS-TEST 可测试性

SYS-DOC 工程文档

# 5. System Startup & Initialization

## SYS-INIT-001

系统上电后，Node A 和 Node B 应分别完成自身硬件初始化。

至少包括：

- MCU；
- 时钟；
- CAN；
- 必需 GPIO；
- 传感器接口；
- 执行器接口。

Priority: Must

## SYS-INIT-002

节点完成基础硬件初始化后，应启动其软件运行环境。

对于使用 FreeRTOS 的节点，应正常启动 RTOS Scheduler。

Scheduler：调度器。

它负责决定：

当前 CPU 应该运行哪个 Task。

## SYS-INIT-003

节点不得在初始化尚未完成时直接进入正常控制状态。

系统应存在：

INIT

状态。

Priority: Must

## SYS-INIT-004

Node A 在完成初始化后，应允许 Node B 判断：

Node A 已完成启动并处于可通信状态。

具体实现方法后续确定。

可能方式：

- Startup Message；
- Heartbeat；
- Node State Signal。

Priority: Must

# 6. Node A Requirements

## 6.1 Sensor Acquisition

### SYS-A-001

Node A 应能够周期性采集至少一个传感器输入。

Priority: Must

### SYS-A-002

Node A 应将原始传感器输入转换为系统可使用的数据。

例如：

ADC Value

↓

Physical Value

如果采用电位器模拟温度：

ADC = 2048

↓

Sensor Value = 50%

Priority: Must

### SYS-A-003

Node A 应能够判断传感器值是否超出预定义合理范围。

例如：

0 ≤ Sensor ≤ 100

如果出现：

Sensor = 150

应视为异常候选。

Priority: Must

## 6.2 Actuator Control

### SYS-A-004

Node A 应包含至少一个可观察的执行器输出。

例如：

- LED；
- 风扇；
- 直流电机；
- 舵机；
- 蜂鸣器。

Priority: Must

### SYS-A-005

Node A 应能够根据 Node B 的有效控制命令改变执行器状态。

Priority: Must

### SYS-A-006

Node A 不得无限期执行已经失效的远程控制命令。

例如：

Node B 已经掉线，但是 Node A 一直保持：

Motor = 100%

这种行为应被避免。

具体 Timeout 时间后续设计。

Priority: Must

# 7. Node B Requirements

## SYS-B-001

Node B 应能够接收并解析 Node A 的状态数据。

包括至少：

- Node State；
- Sensor Value；
- Actuator State；
- Communication Counter。

Priority: Must

## SYS-B-002

Node B 应能够判断 Node A 当前是否在线。

Priority: Must

## SYS-B-003

Node B 应能够向 Node A 发送控制命令。

Priority: Must

## SYS-B-004

Node B 应承担系统级 Fault Manager 功能。

Fault Manager：故障管理模块。

它不是单纯检测一个错误，而负责：

汇总系统已经发现的各种故障，然后决定系统应该处于什么状态。

Priority: Must

## SYS-B-005

Node B 应维护系统当前运行状态。

至少包括：

INIT

NORMAL

DEGRADED

FAULT

SAFE

RECOVERY

Priority: Must

# 8. CAN Communication Requirements

## 8.1 Basic Communication

### SYS-COM-001

Node A 和 Node B 应通过 CAN 总线进行双向通信。

Priority: Must

### SYS-COM-002

系统至少应支持两种类型的 CAN 消息：

Periodic Message

Event Message

Periodic Message：周期报文

例如每 100 ms 固定发送一次。

Event Message：事件报文

只有发生某个事件时才发送。

例如：

检测到故障。

Priority: Must

## 8.2 Heartbeat

### SYS-COM-003

Node A 应周期性提供能够证明自身仍正常运行的信息。

初步采用：

Heartbeat。

Heartbeat 可以理解成节点周期性说：

“我还活着。”

Priority: Must

### SYS-COM-004

Node B 应监控 Node A Heartbeat。

如果规定时间内没有收到有效 Heartbeat：

应产生通信异常。

这种规定时间称为：

Timeout。

Timeout = 超时。

即：

本来应该在一定时间内发生的事情没有发生。

Priority: Must

## 8.3 Alive Counter

### SYS-COM-005

至少一个关键周期报文应包含：

Alive Counter。

Alive Counter 即：

周期报文中的循环流水号。

例如：

0 → 1 → 2 → 3 → ... → 15 → 0

接收端可以由此判断：

- 有没有丢帧；
- 有没有重复帧；
- 数据是否仍然持续更新。

Priority: Must

### SYS-COM-006

Node B 应检测 Alive Counter 是否符合预期变化规律。

Priority: Must

### SYS-COM-007

单次 Alive Counter 异常不一定立即升级为系统严重故障。

系统应允许使用一定的确认机制避免误判。

这里涉及：

Debounce。

Debounce 原意是“去抖”。

在故障诊断里可以理解为：

不因为一次异常就立即认定真的坏了，而要求异常连续发生若干次或持续一段时间。

例如：

一次错误

→ 暂时记录

连续三次错误

→ 正式确认 Fault

具体规则 TBD。

Priority: Must

# 9. Control Requirements

## SYS-CTL-001

正常状态下，Node B 应能够产生或者转发控制目标给 Node A。

Priority: Must

## SYS-CTL-002

Node A 只应执行满足有效性要求的控制命令。

有效性至少应考虑：

- 报文是否有效；
- 通信是否正常；
- 系统是否允许执行；
- 控制值是否在合法范围。

Priority: Must

## SYS-CTL-003

当系统处于 SAFE 状态时，正常控制命令不得覆盖安全动作。

例如：

SAFE要求：

Motor = 0

此时即使收到：

Motor Command = 100%

系统也不应该执行。

Priority: Must

# 10. Fault Detection Requirements

Fault 指：

系统已经确认存在的异常或故障状态。

V0.1 暂定至少覆盖以下故障。

## 10.1 Communication Timeout

### SYS-FLT-001

Node B 应检测 Node A 通信超时。

检测依据可由：

- Heartbeat；
- Status Message；

实现。

Priority: Must

### SYS-FLT-002

通信超时达到确认条件后，应产生：

Node A Communication Fault

Priority: Must

## 10.2 Alive Counter Fault

### SYS-FLT-003

系统应检测关键周期报文的 Alive Counter 异常。

Priority: Must

### SYS-FLT-004

Alive Counter Fault 应支持 Debounce。

Priority: Must

## 10.3 Sensor Fault

### SYS-FLT-005

Node A 应能够检测 Sensor Out-of-Range。

即：

传感器值超过合理物理范围。

Priority: Must

### SYS-FLT-006

Sensor Fault 应支持人工触发。

这样测试阶段才能稳定复现故障。

Priority: Must

## 10.4 Node Restart

### SYS-FLT-007

系统应能够识别 Node A 发生重新启动。

例如：

Node A:

运行中

↓

突然 Reset

↓

重新上线

具体判断机制 TBD。

Priority: Should

# 11. Fault Classification Requirements

## SYS-FLT-008

系统应区分至少两种不同严重程度的故障。

例如：

Minor Fault

Critical Fault

Minor Fault：

系统仍可工作，但部分能力受限。

可能进入：

DEGRADED

Critical Fault：

继续正常控制可能产生错误行为。

应进入：

FAULT

或

SAFE

Priority: Must

# 12. DTC Requirements

DTC：Diagnostic Trouble Code，诊断故障码。

它可以理解为：

给每一种重要故障分配一个编号，方便记录、读取和追踪。

类似汽车维修时看到：

某某传感器故障

通信丢失

电压异常

背后都有相应故障码。

## SYS-DTC-001

每一种核心系统故障应能够关联一个 DTC。

Priority: Must

## SYS-DTC-002

DTC 至少应包含：

- DTC ID；
- 故障类型；
- 当前是否 Active；
- 是否曾经发生。

Active：当前故障仍存在。

History：过去发生过，但现在可能已经恢复。

Priority: Must

## SYS-DTC-003

故障发生并达到确认条件后，相应 DTC 应被设置。

Priority: Must

## SYS-DTC-004

故障消失后，系统可以将：

Active Fault

变成：

Inactive

但历史记录不应自动立即消失。

Priority: Must

## SYS-DTC-005

诊断端应能够读取当前 DTC。

Priority: Must

## SYS-DTC-006

诊断端应能够读取历史 DTC。

Priority: Must

## SYS-DTC-007

在允许的情况下，诊断端应能够主动清除历史 DTC。

Priority: Must

# 13. Safe State Requirements

Safe State：安全状态。

这里的“安全”不是说我们的学生项目已经满足汽车功能安全标准。

它只是表示：

当系统无法确认继续正常控制是否可靠时，进入一个事先定义好的保守状态。

例如：

Motor = Stop

或者：

LED = Off

## SYS-SAFE-001

每个关键故障必须定义：

是否需要进入 Safe State。

Priority: Must

## SYS-SAFE-002

发生 Critical Fault 时，系统应能够覆盖正常控制逻辑并进入 Safe State。

Priority: Must

## SYS-SAFE-003

进入 Safe State 后，系统不得因为单个正常 CAN 报文立即恢复正常控制。

Priority: Must

# 14. Recovery Requirements

Recovery：恢复。

这里不是简单的：

故障没了 → 马上恢复。

而是：

确认故障真的消失以后，再有控制地恢复。

## SYS-REC-001

对于允许自动恢复的故障，应定义明确的恢复条件。

Priority: Must

## SYS-REC-002

系统从 Fault / Safe 状态恢复前，应进行一定程度的正常性确认。

例如：

连续 N 个 Heartbeat 正常

N 值后续确定。

Priority: Must

## SYS-REC-003

系统恢复过程应经过：

RECOVERY

状态。

Priority: Should

## SYS-REC-004

恢复完成后：

Active Fault

可以清除。

但是：

Historical DTC

应继续保留。

Priority: Must

# 15. PC Diagnostic Requirements

## SYS-PC-001

PC Tester 应能够显示 Node A 在线状态。

Priority: Must

## SYS-PC-002

PC Tester 应能够显示 Node B 当前系统状态。

例如：

NORMAL

FAULT

SAFE

RECOVERY

Priority: Must

## SYS-PC-003

PC Tester 应能够显示至少一个 Sensor Value。

Priority: Must

## SYS-PC-004

PC Tester 应能够读取 DTC。

Priority: Must

## SYS-PC-005

PC Tester 应能够发送 DTC Clear 请求。

Priority: Must

## SYS-PC-006

PC Tester 或其他测试方式应能够主动进行 Fault Injection。

Fault Injection：故障注入。

就是：

故意制造一个故障，看看系统是否按照设计处理。

比如：

- 停掉 Heartbeat；
- 修改 Alive Counter；
- 伪造异常传感器值。

Priority: Must

# 16. Real-Time Requirements

Real-Time：实时性。

实时不等于：

越快越好。

真正含义是：

系统必须在规定的时间范围内做出可预测的反应。

## SYS-RT-001

关键控制和通信任务应按照预定义周期运行。

Priority: Must

## SYS-RT-002

Heartbeat 应具有明确发送周期。

具体数值 TBD。

初始建议范围：

50–200 ms

## SYS-RT-003

通信故障必须在预定义最大时间内被检测。

初始目标：

< 500 ms

最终数值后续冻结。

Priority: Must

## SYS-RT-004

Fault Detection 不得无限期阻塞正常控制任务。

Priority: Must

# 17. Reliability Requirements

## SYS-REL-001

单个错误 CAN 报文不得导致 MCU Crash。

Priority: Must

## SYS-REL-002

单次 Sensor 异常值原则上不得立即造成不可恢复系统故障。

具体根据故障等级决定。

Priority: Must

## SYS-REL-003

CAN 数据突然停止时，系统不得继续无限期使用旧数据。

Priority: Must

## SYS-REL-004

系统发生可恢复通信故障后，应能够在不重新烧写程序的情况下恢复运行。

Priority: Must

# 18. Observability Requirements

Observability：可观察性。

可以简单理解成：

系统内部发生了什么，我们有没有办法看见。

如果系统只是在 MCU 内部默默运行，我们非常难调试。

## SYS-TEST-001

系统关键状态必须能够通过至少一种外部方式观察。

例如：

- CAN；
- UART；
- PC；
- LED。

Priority: Must

## SYS-TEST-002

关键 Fault 的产生和恢复应能够被记录。

Priority: Must

## SYS-TEST-003

必须能够观察：

Node State

System State

Fault State

DTC State

Priority: Must

# 19. Testability Requirements

## SYS-TEST-004

核心故障必须能够重复进行 Fault Injection。

Priority: Must

## SYS-TEST-005

每一个 Must Requirement 最终必须存在至少一种验证方式。

验证方式可以是：

Test

Inspection

Measurement

Demonstration

## SYS-TEST-006

系统最终至少应测试：

1. 正常启动；
2. 正常 CAN 通信；
3. Node A 掉线；
4. Heartbeat Loss；
5. Alive Counter Error；
6. Sensor Fault；
7. Safe State；
8. Fault Recovery；
9. DTC Read；
10. DTC Clear。

Priority: Must

# 20. Engineering Requirements

## SYS-DOC-001

系统必须存在正式 CAN Communication Matrix。

Priority: Must

## SYS-DOC-002

系统必须存在 System Architecture Diagram。

Priority: Must

## SYS-DOC-003

系统必须存在 Fault List。

Priority: Must

## SYS-DOC-004

系统必须存在 State Machine Diagram。

Priority: Must

## SYS-DOC-005

源码应通过 Git 进行版本管理。

Priority: Must

## SYS-DOC-006

最终版本必须存在 Test Report。

Priority: Must

# 21. Requirement Priority Definition

本项目使用三种优先级。

## Must

V1.0 不实现则项目不能结项。

## Should

最好完成。

如果工期不足，可以延后，但需要记录原因。

## Could

锦上添花。

不影响项目主体。

当前项目核心原则：

Must 做深，比 Could 做多更重要。

# 22. V0.1 系统需求树

最终可以把目前需求压缩成：

SYSTEM

│

├── Startup

│ ├── Hardware Init

│ ├── RTOS Start

│ └── INIT State

│

├── Node A

│ ├── Sensor

│ ├── Local Fault Detection

│ ├── Actuator

│ └── Status Reporting

│

├── Node B

│ ├── Supervision

│ ├── Control Command

│ ├── Fault Manager

│ └── System State Manager

│

├── CAN

│ ├── Periodic Message

│ ├── Event Message

│ ├── Heartbeat

│ ├── Alive Counter

│ └── Timeout

│

├── Control

│ ├── Command Validation

│ ├── Normal Control

│ └── Command Timeout

│

├── Diagnosis

│ ├── Communication Fault

│ ├── Counter Fault

│ ├── Sensor Fault

│ ├── DTC

│ └── Fault History

│

├── Safety

│ ├── Fault Classification

│ ├── Safe State

│ └── Recovery

│

├── PC Tester

│ ├── Monitor

│ ├── DTC Read

│ ├── DTC Clear

│ └── Fault Injection

│

└── Engineering

├── Real-Time

├── Reliability

├── Observability

├── Testability

└── Documentation

# 23. 当前尚未确定的问题

以下内容现在仍然允许不知道：

### Hardware

- STM32 型号；
- CAN Transceiver；
- Sensor；
- Actuator；
- USB-CAN。

### Communication

- CAN Bitrate；
- CAN ID；
- Signal Byte Mapping；
- Alive Counter 位数；
- CRC 算法。

### Timing

- Heartbeat Cycle；
- Timeout；
- Task Period；
- Debounce 次数。

### Fault Management

- 哪些 Fault 属于 Minor；
- 哪些属于 Critical；
- 每一种 Fault 的 Recovery Condition。

### Software

- Task 数量；
- Queue 数量；
- Task Priority；
- RAM / Flash DTC Storage。

这些会在下一阶段逐步冻结。

# 24. v0.1 Baseline

System Requirements v0.1 暂时确定项目必须具有以下核心闭环：

Normal Operation

↓

CAN Communication

↓

Communication Monitoring

↓

Fault Detection

↓

Fault Confirmation

↓

DTC

↓

System State Change

↓

Safe State

↓

Fault Removed

↓

Recovery Validation

↓

NORMAL

如果最终系统能够稳定、可重复地完成这一整个闭环，则核心系统目标成立。

# 25. 下一阶段

完成 SRS v0.1 后，下一阶段进入：

System Architecture Definition

首先处理：

1. Node A 到底模拟什么设备；
2. Sensor 选择；
3. Actuator 选择；
4. Node A / Node B 职责最终划分；
5. 哪些 Fault 由 Node A 检测；
6. 哪些 Fault 由 Node B 检测；
7. 每个 Fault 对系统状态产生什么影响；
8. 建立正式 Fault List v0.1。

完成这些以后，才进入：

CAN Matrix

↓

FreeRTOS Task Architecture

↓

Hardware Selection
