Ben-nevis2006/stm32-freertos-dual-ecu-can-diagnostics/current/Hardware_Selection_v0.1_Working_Baseline_2026-09-06.docx

# Hardware Selection v0.1

STM32 + FreeRTOS Dual-ECU CAN Thermal Management Project

Working Baseline — 2026-09-06

Item | Current baseline
Current phase | Hardware Selection review completed; minimum-BOM preparation started
Design principle | v0.1 只要求跑通闭环与故障诊断；成熟模块/官方参考设计优先，避免不必要的自研模拟外围
Closed / stable | HS-02 CAN transceiver；HS-03 Cooling Fan；HS-04 NTC acquisition；HR-01/02 fan interface；HR-03 INA260 interface
Still open | HS-01 NUCLEO procurement acceptance；具体 heatsink / 12 V supply / connector choices；P8 Tach pulses-per-revolution 实测；各 Fault calibration thresholds

# 1. 2026-09-06 Design Update

本轮硬件策略正式收敛为“闭环优先、模块复用优先”。项目不以汽车级 ECU 电源/模拟前端设计为目标；只保留支撑 Temperature → Cooling Demand → CAN → Fan → RPM → Temperature 闭环，以及现有 Fault 检测所必需的硬件。

经验/复用依据：CAN 采用 Adafruit CAN Pal 成熟模块；Current/Voltage 采用 TI INA260 类数字监测方案；4-wire fan 按成熟 PWM/Tach 接口使用；NTC 采用经典分压 + ADC。复杂 TVS、汽车瞬态防护、自制 INA180 模拟放大器、独立电压采样网络等退出 v0.1 主路径。

# 2. Hardware Selection Baseline

ID | Item | Decision | Status | Boundary / reason
HS-01 | MCU / Board | NUCLEO-F103RB ×2（Node A / Node B） | PREFERRED | 统一平台；板载 ST-LINK；最终以实际采购与 bring-up 验收关闭。
HS-02 | CAN Physical Layer | Adafruit CAN Pal 5708 / TJA1051T/3 ×2 | CLOSED | 3.3 V logic 兼容；模块化复用；双节点两端各启用 120 Ω termination。
HS-03 | Cooling Fan | ARCTIC P8 PWM PST non-CO, 12 V 4-wire | CLOSED | PWM command + Tach feedback；不使用 PST 串联功能；CO 版无必要。
HS-04 | Plant Temperature | 10 kΩ NTC, B≈3950 K, ±1% preferred + 10 kΩ ±1% divider → Node B ADC | CLOSED | 最简单成熟 NTC 采集；open/short 对 FB-06 Plant Temperature Signal Fault 可观测。
HS-05 | Fan Current | INA260 breakout / equivalent mature module | CLOSED* | 高边测量 fan supply current；替代 INA180 + external shunt 自建设计。*具体采购模块需核对。
HS-06 | Fan Supply Voltage | 由 INA260 同时读取 12 V fan bus voltage | CLOSED* | 与 HS-05 合并；不再单独设计 47 kΩ/10 kΩ voltage divider。
HS-07 | Thermal Plant / Heater | Aluminum heatsink + 10 Ω / 25 W aluminum-housed resistor @ 12 V ≈ 14.4 W | WORKING | Heater 外部手动开关；60–80 mm class heatsink，具体尺寸靠 thermal characterization 再定。
HS-08 | Power | 12 V regulated supply ≥3 A；NUCLEO 开发阶段 USB 供电；公共 GND | WORKING | 不做汽车级 transient protection；Heater 大电流路径不走无焊面包板。

# 3. Interface Closure

## 3.1 P8 PWM

Node A 使用 STM32 Timer 产生约 25 kHz PWM，并优先采用 Alternate-Function Open-Drain（复用功能开漏）输出直接连接 P8 PWM pin。其含义是 MCU 主要负责拉低/释放信号，符合成熟 4-wire fan 控制接口思路。外部 NPN/MOSFET 仅作为实测电平不合适时的备选，不再默认增加。

## 3.2 P8 Tach / RPM

Tach 采用 3.3 V 外部上拉后接 STM32 Timer Input Capture（输入捕获）。4.7 kΩ 作为 Working Baseline；P8 的实际 pulses-per-revolution 不在采购前拍脑袋冻结，首次 bring-up 用逻辑分析仪/示波器实测后写入参数。

## 3.3 INA260 ↔ Node A

INA260 通过 3.3 V I²C 与 Node A 通信，一个成熟模块同时提供 Fan Current、Fan Supply Voltage 和 Power，减少模拟电路数量。ALERT pin 可作为 FA-04 Motor Overcurrent 的快速保护候选路径，但阈值必须基于 P8 startup / normal / stall current profile 实测后确定。

# 4. Minimum BOM (Bill of Materials / 物料清单)

BOM 只保留跑通 v0.1 闭环所需核心件，不提前购买 future improvement 硬件。

Material | Qty | Priority | Status | Purpose
NUCLEO-F103RB | 2 | Must buy | Preferred | Node A / Node B MCU boards
Adafruit CAN Pal 5708 | 2 | Must buy | Closed | CAN physical layer
ARCTIC P8 PWM PST non-CO | 1 | Must buy | Closed | Cooling actuator
INA260 breakout / equivalent | 1 | Must buy | Closed* | Fan current + voltage
10 kΩ B3950 NTC ±1% | 2 | Must buy | Closed | Plant temperature; 1 spare
10 kΩ ±1% resistor | 5–10 | Small parts | Closed | NTC divider
4.7 kΩ resistor | 5–10 | Small parts | Working | Tach pull-up
10 Ω / 25 W aluminum resistor | 1 | Later batch | Working | Heater
60–80 mm aluminum heatsink | 1 | Later batch | TBD model | Thermal plant
12 V regulated supply ≥3 A | 1 | Later batch | TBD model | Fan + Heater power
Manual heater switch | 1 | Later batch | Required | External heat-load control

# 5. Procurement / Bring-up Order

建议继续分批采购，避免一次买齐后基础接口尚未调通：

• Batch 1：NUCLEO-F103RB ×2 + CAN Pal ×2 + P8 + 基础线材。目标：FreeRTOS 基础运行、0x100/0x180 CAN 通信、PWM 调速、Tach/RPM。

• Batch 2：INA260 + NTC + 10 kΩ / 4.7 kΩ 电阻。目标：Plant Temperature、Fan Current、Fan Supply Voltage 采集。

• Batch 3：Heater + aluminum heatsink + 12 V supply + switch。目标：形成真实 Thermal Plant 并跑完整热闭环。

# 6. Verification Boundaries

• NUCLEO：ST-LINK、target MCU、download/debug、CAN/Timer/ADC/I²C basic bring-up 通过后，HS-01 才转 CLOSED。

• P8：实测 0%/low-duty behavior、可调 RPM 范围、Tach pulse/rev、startup/normal/stall current profile。

• Thermal Plant：记录 Heater ON/Fan OFF 与不同 Cooling Demand 下的 temperature curve，反向确定 thermal strategy 与 FB-01 Overtemperature / FB-02 Insufficient Cooling Performance calibration。

• INA260 ALERT / FA-04 Motor Overcurrent threshold、FA-06 Supply Voltage Fault 的 UV/OV threshold 均不得在采购阶段凭经验写死。

• Next: Node A / Node B Peripheral & Pin Allocation，随后进入 Batch-1 实物 bring-up。

Hardware Selection v0.1 — Working Baseline 2026-09-06
