Ben-nevis2006/stm32-freertos-dual-ecu-can-diagnostics/current/03_hardware_interfaces_硬件与接口/Hardware_Selection_硬件选型_v0.1_Working_Baseline_工作基线_2026-09-08.docx

# Hardware Selection v0.1

STM32 + FreeRTOS Dual-ECU CAN Thermal Management Project

Working Baseline — 2026-09-08

Item | Current baseline
Current phase | Hardware Selection & procurement BOM closed at project level; core hardware has been ordered. Waiting for delivery while pin/resource allocation and software skeleton continue.
Design principle | v0.1 只要求跑通闭环与故障诊断；成熟模块/官方参考设计优先，避免不必要的自研模拟外围
Closed / stable | HS-02 CAN transceiver；HS-03 Cooling Fan；HS-04 NTC acquisition；HR-01/02 fan interface；HR-03 INA260 interface；HS-07 preferred thermal-plant dimensions；HS-08 12 V supply class / wiring scheme
Still open | HS-01 final acceptance after board bring-up；P8 Tach pulses-per-revolution 实测；INA260/P8 current profile；Fault calibration thresholds；small mechanical fixation details

# 1. 2026-09-06 Design Update

本轮硬件策略正式收敛为“闭环优先、模块复用优先”。项目不以汽车级 ECU 电源/模拟前端设计为目标；只保留支撑 Temperature → Cooling Demand → CAN → Fan → RPM → Temperature 闭环，以及现有 Fault 检测所必需的硬件。

经验/复用依据：CAN 采用 Adafruit CAN Pal 成熟模块；Current/Voltage 采用 TI INA260 类数字监测方案；4-wire fan 按成熟 PWM/Tach 接口使用；NTC 采用经典分压 + ADC。复杂 TVS、汽车瞬态防护、自制 INA180 模拟放大器、独立电压采样网络等退出 v0.1 主路径。

# 2. Hardware Selection Baseline

ID | Item | Decision | Status | Boundary / reason
HS-01 | MCU / Board | NUCLEO-F103RB ×2（Node A / Node B） | PREFERRED | 统一平台；板载 ST-LINK；最终以实际采购与 bring-up 验收关闭。
HS-02 | CAN Physical Layer | Adafruit CAN Pal 5708 / TJA1051T/3 ×2 | CLOSED | 3.3 V logic 兼容；模块化复用；双节点两端各启用 120 Ω termination。
HS-03 | Cooling Fan | ARCTIC P8 PWM PST non-CO, 12 V 4-wire | CLOSED | PWM command + Tach feedback；不使用 PST 串联功能；CO 版无必要。
HS-04 | Plant Temperature | 10 kΩ NTC, B≈3950 K, ±1% preferred + 10 kΩ ±1% divider → Node B ADC | CLOSED | 最简单成熟 NTC 采集；open/short 对 FB-06 Plant Temperature Signal Fault 可观测。
HS-05 | Fan Current | INA260 breakout module ×1 | CLOSED | 成熟数字模块，高边测 Fan Current，并同时读取 Bus Voltage；替代 INA180 + external shunt 自建设计。
HS-06 | Fan Supply Voltage | 由 INA260 同时读取 12 V fan bus voltage | CLOSED | 与 HS-05 合并；不再单独设计 voltage-divider sensing circuit。
HS-07 | Thermal Plant / Heater | 100 × 80 × 20 mm aluminum heatsink + 10 Ω / 25 W aluminum-housed resistor @ 12 V ≈ 14.4 W | PREFERRED | P8 为 80 mm fan，散热器宽度匹配；Heater 外部手动开关；到货后用 thermal characterization 最终验收。
HS-08 | Power | 12 V / 3 A regulated adapter, DC 5.5 × 2.1 mm；NUCLEO 开发阶段 USB 供电；公共 GND | PREFERRED | 12 V 功率线采用约 18 AWG 多股硅胶线；Heater 大电流路径不走无焊面包板；不做汽车级 transient protection。

# 3. Interface Closure

## 3.1 P8 PWM

Node A 使用 STM32 Timer 产生约 25 kHz PWM，并优先采用 Alternate-Function Open-Drain（复用功能开漏）输出直接连接 P8 PWM pin。其含义是 MCU 主要负责拉低/释放信号，符合成熟 4-wire fan 控制接口思路。外部 NPN/MOSFET 仅作为实测电平不合适时的备选，不再默认增加。

## 3.2 P8 Tach / RPM

Tach 采用 3.3 V 外部上拉后接 STM32 Timer Input Capture（输入捕获）。4.7 kΩ 作为 Working Baseline；P8 的实际 pulses-per-revolution 不在采购前拍脑袋冻结，首次 bring-up 用逻辑分析仪/示波器实测后写入参数。

## 3.3 INA260 ↔ Node A

INA260 通过 3.3 V I²C 与 Node A 通信，一个成熟模块同时提供 Fan Current、Fan Supply Voltage 和 Power，减少模拟电路数量。ALERT pin 可作为 FA-04 Motor Overcurrent 的快速保护候选路径，但阈值必须基于 P8 startup / normal / stall current profile 实测后确定。

# 4. Minimum BOM (Bill of Materials / 物料清单)

BOM 只保留跑通 v0.1 闭环所需核心件，不提前购买 future improvement 硬件。

Material | Qty | Priority | Status | Purpose
NUCLEO-F103RB | 2 | Ordered | Preferred | Node A / Node B MCU boards; bring-up 后最终 CLOSED
Adafruit CAN Pal 5708 | 2 | Ordered | Closed | CAN physical layer
ARCTIC P8 PWM PST non-CO | 1 | Ordered | Closed | Cooling actuator
INA260 breakout module | 1 | Ordered | Closed | Fan current + 12 V bus voltage
10 kΩ B3950 NTC, tinned lead | 2 | Ordered | Verify SKU | Plant temperature; 1 spare; 到货复核 10 kΩ / B3950
10 kΩ ±1%, 1/4 W resistor | 100-pack | Ordered | Closed | NTC divider
4.7 kΩ ±1%, 1/4 W resistor | 100-pack | Ordered | Closed | P8 Tach pull-up
10 Ω / 25 W aluminum-housed resistor | 1 | Ordered | Preferred | Heater; nominal ≈14.4 W @ 12 V
Aluminum heatsink 100 × 80 × 20 mm | 1 | Ordered | Preferred | Thermal Plant
12 V / 3 A regulated adapter, 5.5×2.1 mm | 1 | Ordered | Preferred | Fan + Heater power
12 V rocker switch, 4-pin 2-position | 1 | Ordered | Accepted | Heater manual ON/OFF; only one contact pair required
18 AWG silicone wire, red + black | 1 m each | Ordered | Accepted | 12 V power wiring
2.54 mm Dupont wires: M-M / M-F / F-F | 1 set each | Ordered | Accepted | Signal/prototype wiring
DC 5.5×2.1 mm to screw terminal | 2 | Ordered | Accepted | Power adapter breakout
KF128 screw terminals: 2P ×5, 6P ×2 | 1 lot | Ordered | Accepted | Power / branch wiring
4-pin PWM fan extension cable, M-F, 50 cm | 1 | Ordered | Accepted | Modify extension cable instead of P8 original lead
830-hole solderless breadboard | 1 | Ordered / planned | Accepted | NTC divider, Tach pull-up, temporary signal tests

# 5. Procurement / Bring-up Order

2026-09-08：核心 BOM 已完成下单。原分批采购逻辑保留为 bring-up 顺序参考，不再作为采购前置条件。

• Bring-up Phase 1：NUCLEO ×2 + CAN Pal ×2 + P8。先验证板卡、CAN、PWM、Tach/RPM。

• Bring-up Phase 2：INA260 + NTC。验证 Plant Temperature、Fan Current、Fan Supply Voltage。

• Bring-up Phase 3：Heater + 100×80×20 mm heatsink + 12 V supply + switch。搭建真实 Thermal Plant 并跑完整热闭环。

# 6. Verification Boundaries

• NUCLEO：ST-LINK、target MCU、download/debug、CAN/Timer/ADC/I²C basic bring-up 通过后，HS-01 才转 CLOSED。

• P8：实测 0%/low-duty behavior、可调 RPM 范围、Tach pulse/rev、startup/normal/stall current profile。

• Thermal Plant：记录 Heater ON/Fan OFF 与不同 Cooling Demand 下的 temperature curve，反向确定 thermal strategy 与 FB-01 Overtemperature / FB-02 Insufficient Cooling Performance calibration。

• INA260 ALERT / FA-04 Motor Overcurrent threshold、FA-06 Supply Voltage Fault 的 UV/OV threshold 均不得在采购阶段凭经验写死。

• Next: 等待到货期间继续完成 Node A / Node B Peripheral & Pin Allocation、CubeMX 配置规划与软件骨架；到货后按 Bring-up Phase 1 开始实物验证。

# 7. 2026-09-08 Procurement Freeze / Change Trace

• 本日完成 v0.1 核心硬件采购。项目硬件策略继续保持“闭环优先、成熟模块优先、少自研外围”。采购完成后，不再主动扩充核心硬件，除非 bring-up 发现明确接口问题。

• HS-07 Thermal Plant preferred size 更新为 100 × 80 × 20 mm 铝鳍片散热器；Heater 维持 10 Ω / 25 W 黄金铝壳功率电阻，12 V 下名义发热约 14.4 W。

• HS-08 Power preferred implementation 更新为 12 V / 3 A、5.5 × 2.1 mm 成品稳压适配器；Heater 手动使用 12 V 四脚两档翘板开关；功率线采用 18 AWG 红/黑多股硅胶线。

• 连接与原型配件确定：三类 2.54 mm 杜邦线、DC 转螺丝端子、KF128 接线端子、4-pin PWM fan 延长线、830 孔面包板。P8 原装线不直接剪，优先改延长线。

• 采购后的未关闭项主要转为“到货验收/实测”：NUCLEO 真机 bring-up、P8 Tach pulses-per-revolution、PWM/RPM mapping、startup/normal/stall current profile、Thermal Plant temperature curves，以及后续 Fault thresholds/calibration。

Hardware Selection v0.1 — Working Baseline 2026-09-08
