Ben-nevis2006/stm32-freertos-dual-ecu-can-diagnostics/CAN_Matrix_v0.1.docx

# CAN Matrix v0.1

Dual-ECU Thermal Management Control & Diagnostic System

Status: WORKING BASELINE / Release Candidate

Item | Current Baseline
Upstream | System Architecture Definition v0.1 + Fault List v0.1
Scope | 2 core cyclic CAN messages; control, status, fault propagation and communication supervision only
Design principle | Minimal but complete; prioritize implementation, verification and timely project completion

# 1. Message Matrix

Message | CAN ID | Tx | Rx | DLC | Type | Cycle | Timeout / Freshness | Purpose
Cooling_Command | 0x100 | Node B | Node A | 2 | Cyclic | 100 ms | 300 ms valid-command timeout | Cooling Demand + command sequence supervision
Actuator_Status | 0x180 | Node A | Node B | 5 | Cyclic | 100 ms | 300 ms raw timeout / 300 ms trusted freshness | Actuator state, fault result, control/fallback state and RPM evidence

CAN ID is project-specific. 0x100 has higher bus arbitration priority than 0x180 because the numerical ID is smaller.

# 2. Signal Matrix

## 2.1 0x100 Cooling_Command

Signal | Start | Length | Encoding / Range | Invalid / Reserved | Meaning
Cooling_Demand | Byte0.Bit0 | 8 bit | 0~100 = 0~100% | 101~254 Reserved; 0xFF Invalid | Normalized functional cooling request; 0 = explicit Fan OFF
Command_AliveCounter | Byte1.Bit0 | 4 bit | 0~15 cyclic | 15→0 wrap-around | Command sequence / software activity supervision
Reserved | Byte1.Bit4 | 4 bit | Tx fixed 0 | Reserved | No functional meaning in v0.1

## 2.2 0x180 Actuator_Status

Signal | Start | Length | Encoding / Range | Meaning
Actuator_Availability | Byte0.Bit0 | 2 bit | 0 FULL / 1 REDUCED / 2 LOST / 3 Reserved | Remaining actuator functional capability
Control_Mode | Byte0.Bit2 | 2 bit | 0 IDLE_OFF / 1 CLOSED_LOOP / 2 OPEN_LOOP / 3 SAFE_OUTPUT | Current local control mode
Fallback_Active | Byte0.Bit4 | 1 bit | 0 No / 1 Active | Whether a fallback strategy is active
RPM_Valid | Byte0.Bit5 | 1 bit | 0 Invalid / 1 Valid | Validity of Actual_RPM
FA-01 Fan Stall | Byte1.Bit0 | 1 bit | 0 Inactive / 1 Active Confirmed | Fan stall fault status
FA-02 Fan Speed Deviation Level | Byte1.Bit1 | 2 bit | 0 None / 1 DEGRADED-level / 2 SAFE-level / 3 Reserved | Persistent speed-deviation severity; thresholds TBD
FA-03 RPM Feedback Fault | Byte1.Bit3 | 1 bit | 0 Inactive / 1 Active Confirmed | RPM feedback path fault
FA-04 Motor Overcurrent | Byte1.Bit4 | 1 bit | 0 Inactive / 1 Active Confirmed | Motor overcurrent fault
FA-05 Current Feedback Fault | Byte1.Bit5 | 1 bit | 0 Inactive / 1 Active Confirmed | Current sensing path fault
FA-06 Supply Voltage Fault | Byte1.Bit6 | 1 bit | 0 Inactive / 1 Active Confirmed | If voltage sensing is deferred, Tx keeps 0
FA-07 Cooling Demand Communication Fault | Byte1.Bit7 | 1 bit | 0 Inactive / 1 Active Confirmed | B→A command communication fault
Status_AliveCounter | Byte2.Bit0 | 4 bit | 0~15 cyclic; 15→0 wrap-around | Status sequence / software activity supervision
Actual_RPM | Byte3~4 | 16 bit | Little-endian; 1 rpm/bit; 0~65534; 0xFFFF Invalid | Actuator state / diagnostic evidence / test observability

Reserved bits: Byte0.Bit6~7 and Byte2.Bit4~7 are transmitted as 0 in v0.1.

# 3. Supervision & Consistency Rules

Rule / Fault | v0.1 Rule
Cooling_Command first frame | Use received Alive as synchronization baseline; start value need not be 0.
Cooling_Command sequence | Single anomaly = suspected and re-sync current counter; 2 consecutive anomalies = FA-07 Cooling Demand Communication Fault.
Cooling_Command timeout | No new valid command for 300 ms = FA-07 Cooling Demand Communication Fault; Hold Last ends and Local Conservative Cooling Demand begins.
Cooling_Command recovery | 3 consecutive valid commands before communication re-qualification.
FB-03 Node A Communication Timeout | No Actuator_Status frame at all for 300 ms → SAFE.
FB-04 Node A Alive / Sequence Fault | 2 consecutive sequence anomalies → DEGRADED; no trusted Status for 300 ms → SAFE.
Status recovery | 3 consecutive trusted Status frames, then re-evaluate all active faults.
RPM consistency | RPM_Valid=0 → Actual_RPM=0xFFFF. CLOSED_LOOP requires RPM_Valid=1.
Mode consistency | OPEN_LOOP implies Fallback_Active=1 in v0.1; SAFE_OUTPUT is protection, not fallback; IDLE_OFF does not mean actuator LOST.

# 4. Fault Injection Verification Coverage

Fault(s) | Injection | Verification Target
FA-01 Fan Stall / FA-02 Fan Speed Deviation | Inject RPM/current conditions and different persistent speed-error severities | Verify local qualification, Availability and DEGRADED/SAFE severity
FA-03 RPM Feedback Fault / FA-05 Current Feedback Fault | Inject missing/frozen/out-of-range feedback | Verify signal invalidation, diagnostic degradation and fallback behavior
FA-04 Motor Overcurrent / FA-06 Supply Voltage Fault | Software-inject severe Current or UV/OV when sensing exists | Verify local protection and DEGRADED/SAFE reaction without dangerous physical faults
FA-07 Cooling Demand Communication Fault | Stop 0x100, freeze/jump Alive, or send invalid demand | Verify Hold Last → confirmation → Local Conservative Cooling Demand → recovery
FB-01 Overtemperature / FB-02 Insufficient Cooling Performance | Inject high temperature or non-improving plant response under high demand | Verify system-level DEGRADED→SAFE / SAFE behavior
FB-03 Node A Communication Timeout / FB-04 Node A Alive / Sequence Fault | Stop 0x180 or keep frames arriving with bad Alive sequence | Verify raw timeout vs trusted-freshness distinction and DEGRADED→SAFE escalation
FB-06 Plant Temperature Signal Fault | Inject frozen/invalid/out-of-range temperature | Verify Observability loss → SAFE and normal thermal strategy disabled

The complete per-fault injection matrix is maintained in CAN_Matrix_v0.1.xlsx. Faults are injected at Detection Inputs where practical; avoid directly forcing fault flags.

Release note: no remaining CAN-layout blocker. Calibration TBDs are FA-02 Fan Speed Deviation thresholds/persistence, Local Conservative Cooling Demand, RPM_MIN_RUN/RPM_MAX, and the FA-06 Supply Voltage Fault sensing decision.

CAN Matrix v0.1 | Dual-ECU Thermal Management Control & Diagnostic System
