Ben-nevis2006/stm32-freertos-dual-ecu-can-diagnostics/Fault_List_v0.1.docx

Fault List

双 ECU 热管理控制与故障诊断系统

Version 0.1 | Fault Architecture Baseline + Controlled Calibration TBDs

Document Status: BASELINED v0.1

本文件是 SAD v0.1 的独立配套故障基线；架构关系已冻结，具体阈值、计时、标定与部分恢复参数继续作为受控 TBD。

# 0. Document Control

字段 | 内容
文档名称 | Fault List
项目 | Dual-ECU Thermal Management Control & Diagnostic System
版本 | v0.1
上游基线 | SRS v0.1；System Architecture Definition v0.1
状态 | BASELINED v0.1 / 详细 Calibration 与 Diagnostic Implementation 允许继续迭代
适用节点 | Node A — Thermal Actuator ECU；Node B — Supervisory ECU
编号说明 | FA-xx = Node A local / actuator-side fault；FB-xx = Node B system/supervision fault；FB-05 仅保留为历史编号占位，不作为独立 Fault。

# 1. Purpose and Scope

本文件把 SAD 中已经冻结的 Fault Management 架构展开为逐条可追溯的 Fault Baseline。它回答：故障由谁检测、依赖什么信号、何时允许检测、怎样 Qualification、对功能和 Observability 有什么影响、Node A / Node B 应采取什么 Reaction / Fallback、系统进入何种 Mode、恢复时需要重新确认什么，以及多个 Fault 同时存在时如何进行 Dependency / Suppression / Arbitration。

本版本不试图提前给出需要硬件实测和标定才能合理确定的数字。RPM 阈值、电流阈值、过温阈值、CAN timeout、debounce 时间、fallback PWM / Cooling Demand、retry 次数、DTC 清除周期等均作为受控 TBD，留给 Detailed Design / Calibration。

Scope Boundary [BASELINE] Fault List v0.1 是“故障行为与责任边界”的正式基线，不等同于完整 FMEA / FTA，也不宣称满足 ISO 26262 Safety Case。v0.1 暂不实现 Thermal Model / Observer / Virtual Sensor / Analytical Redundancy；这些作为主链完成后的优化方向保留。

# 2. Relationship to SAD v0.1

SAD 定义系统架构：B 管系统，A 管执行器；Node B 拥有 Plant Temperature 与系统模式，Node A 拥有 Fan RPM / Motor Current 等执行器本地信息；B→A 使用 normalized Cooling Demand；Node A 本地执行转速闭环，并且本地保护不依赖 CAN。

本 Fault List 在这些边界内展开细节。若仅调整 threshold / debounce / fallback value 等参数，只修改 Fault List / Detailed Design；只有当 Fault Owner、Node 职责、系统模式定义、关键接口或安全/降级架构发生变化时，才需要同步修改 SAD。

Normative Split [BASELINE] SAD 保留 Fault Scope、Owner、Mode / Fallback / Arbitration 架构摘要；本文件作为逐条 Fault 定义的详细基线。避免两份文档同时维护相同细节导致漂移。

# 3. Terms and Interpretation

术语 | 本项目中的含义
Detection Owner | 首先执行该 Fault Detection / Qualification 的 ECU。
Detection Enable Condition | 允许该诊断成立的前置条件。例如 Fan Stall 只有在“命令运行 + 启动宽限结束”后才有意义。
Qualification / Debounce | 异常必须持续一定时间或连续若干采样后才成为 Confirmed Fault；严重硬件保护可例外快速触发。
Functional Availability | Fault 发生后，系统还剩多少可用冷却/控制能力：FULL / REDUCED / LOST。
Observability | 系统是否仍能可信知道关键状态。本项目特别关注 Thermal Plant Temperature 是否可观测。
Fallback | 正常控制链部分失效后，利用剩余能力执行的预定义后备策略；Fallback 不必然等于 Open-loop。
Open-loop Fallback | RPM Feedback 失效时，不再利用 RPM 修正 PWM，而采用预定义 Demand→PWM 映射。
Root Cause Fault | 能够解释下游异常的根因故障，例如 Undervoltage 可能导致 Speed Deviation。
Consequential Fault | 由上游 Root Cause 引起的后果性异常，可视情况抑制其独立 Qualification。
Operational Recovery | 系统运行模式恢复；不等同于历史 Fault / DTC 被清除。
Latched / Stored Fault | 故障历史在异常消失后仍保留；具体锁存和清除策略按 Fault 类型后续定义。

# 4. Fault Management Baseline Principles

ID | 原则
P-01 | Node A 负责执行器本地 Fault；Node B 负责系统热状态、Node A 监督、Fault Aggregation 与 System Mode。
P-02 | Local protection shall not depend on CAN availability。严重本地机械/电气 Fault 可由 Node A 立即进入 Safe Output，再上报 Node B。
P-03 | Fault Detection 必须有 Enable Condition；Startup / transient 等不适用阶段允许 Inhibition。
P-04 | 除需要立即保护的严重 Fault 外，异常应经过 Qualification / Debounce 后再 Confirm。
P-05 | 确认无效的 Signal 不得继续被无条件用于控制或依赖该 Signal 的诊断。
P-06 | System Mode 由全部 Active Confirmed Fault 对 Functional Availability、Observability 和 Protection State 的综合影响决定。
P-07 | Root Cause 可抑制被其充分解释的 Consequential Fault Qualification，但原始 Signal / evidence 必须保留。
P-08 | 跨 Actuator / Functional / System 层的 Fault 若描述不同抽象层，可同时保留，不视为重复报码。
P-09 | Fault disappearance ≠ immediate recovery；Recovery 必须重新 Qualification，并重新评估全部仍 Active 的 Fault。
P-10 | Operational Recovery ≠ Diagnostic Erasure；系统可恢复运行而历史 DTC / event 继续保留。

# 5. System Mode and Reaction Interpretation

Mode | Fault 语义
INIT | 初始化、自检、通信与信号建立；部分诊断因 Enable Condition 未满足而 Inhibited。
NORMAL | 关键热管理功能完整，关键状态可可信观测。
DEGRADED | 功能或诊断覆盖下降，但关键状态仍可控制、可观测、可验证，系统保留受限运行能力。
SAFE | 关键功能无法保证/确认，或关键安全相关状态已失去可信观测；系统执行预定义风险降低行为。SAFE 不等于“已证明安全”，也不等于“所有输出必须关闭”。

Mode Re-evaluation [BASELINE] 两个 DEGRADED Fault 不会因为“数量=2”自动变 SAFE；一个 SAFE-level Fault 恢复后也不一定直接回 NORMAL。每次 Active Fault Set 改变，都重新评估剩余功能能力、Observability 与 Protection State。

# 6. Fault List Summary

ID | Fault Name | Owner | Primary Impact | Mode | Status
FA-01 | Fan Stall | A | 主冷却执行器机械输出丢失 | SAFE | BASELINE
FA-02 | Fan Speed Deviation | A | 冷却能力下降 | DEGRADED → SAFE | BASELINE
FA-03 | RPM Feedback Fault | A | RPM 内环反馈失效 | DEGRADED / SAFE | Open-loop fallback baseline
FA-04 | Motor Overcurrent | A | 电气/硬件风险 | Severe → SAFE | BASELINE
FA-05 | Current Feedback Fault | A | 诊断覆盖下降 | DEGRADED | BASELINE
FA-06 | Supply Voltage Fault | A | 性能下降或执行器不可用 | DEGRADED / SAFE | Fault family baseline; sensing decision open
FA-07 | Cooling Demand Communication Fault | A | B→A 正常命令链失效 | DEGRADED / SAFE | Two-stage fallback baseline
FB-01 | Overtemperature | B | Thermal limit violated | SAFE | BASELINE
FB-02 | Insufficient Cooling Performance | B | 系统冷却功能不足 | DEGRADED → SAFE | BASELINE
FB-03 | Node A Communication Timeout | B | 执行 ECU 可用性不可确认 | SAFE | BASELINE
FB-04 | Node A Alive / Sequence Fault | B | A 状态新鲜度/可信度下降 | DEGRADED → SAFE | BASELINE
FB-06 | Plant Temperature Signal Fault | B | Thermal State Observability lost | SAFE | BASELINE

FB-05 Reserved 早期架构讨论曾把 “Node A Reported Actuator Fault”记作 FB-05。v0.1 正式 Fault List 认定它不是独立 Failure Mode，而是 A→B Fault Propagation / Aggregation 机制。为保留历史追溯，FB-05 暂不重新分配。

# 7. Node A Fault Definitions

## FA-01 — Fan Stall

Detection Owner | Node A
Fault Source | Cooling Fan mechanical / drive path；典型含义是“已要求运行，但无法产生有效机械转动”。
Detection Inputs | Fan run request / Target RPM；Actual RPM；Motor Current；Supply Voltage 可作为 root-cause context。
Enable Condition | Fan 被要求运行；Target RPM 高于最低有效运行目标；Startup grace period 已结束；RPM / Current 等必要输入有效。
Detection / Qualification | Actual RPM 低于 Stall threshold + Current 支持 loaded/stall 条件 + 持续达到 qualification。具体 threshold / time TBD。
Functional Impact | v0.1 只有单一 Cooling Fan，因此主冷却执行能力 LOST。
Local Reaction | Node A 立即本地保护，Fan drive → Safe Output；随后报告 FA-01。Local protection 不等待 Node B。
System Mode | SAFE（针对当前单风扇 v0.1；未来多 actuator 架构可重新评估）。
Dependency / Suppression | 依赖可信 RPM；Current 用于 Stall discrimination。RPM Feedback Fault ACTIVE 时，正常 Stall confirmation 降级/受限。
Recovery | 是否自动 retry、retry 次数、latching、power cycle / diagnostic clear 条件 = TBD。
Open Parameters | Stall RPM/current threshold；startup grace；debounce；retry / latch policy。

## FA-02 — Fan Speed Deviation

Detection Owner | Node A
Fault Source | Fan / load / supply 等导致实际速度持续不能跟随内部 Target Fan Speed。
Detection Inputs | Target RPM；Actual RPM；Supply Voltage context；Control Mode。
Enable Condition | Fan 已进入有效运行；startup / transient 结束；Target 相对稳定；RPM Feedback valid。
Detection / Qualification | 建议采用 relative speed error + persistence，而非单一固定 rpm 差值。阈值 / 时间 TBD。
Functional Impact | 执行器仍有机械输出，但冷却能力 REDUCED。
Reaction | 继续利用剩余控制能力；报告 performance fault；Node B 进入 DEGRADED。若进一步形成 FB-02 / FB-01，可升级 SAFE。
System Mode | DEGRADED → SAFE（按实际系统热响应升级）。
Dependency / Suppression | 若 FA-06 Undervoltage 已 Confirmed 且足以解释速度下降，可抑制 FA-02 独立 Qualification，RPM 原始 evidence 仍保留。RPM invalid 时本诊断不可用。
Recovery | Speed tracking 恢复并通过 recovery qualification 后重新评估全部 Active Fault。
Open Parameters | Relative error threshold；observation/debounce time；root-cause suppression detail。

## FA-03 — RPM Feedback Fault

Detection Owner | Node A
Fault Source | RPM / Tach sensing path 本身失去可信度，而非风扇一定转得慢。
Detection Inputs | Tach pulse / measured RPM；Fan command；Current / Voltage / drive state 用作 plausibility context。
Enable Condition | 在应当存在 RPM feedback 的运行工况下启用；具体低速/停机例外由后续 sensing design 定义。
Detection / Qualification | Missing feedback、out-of-range frequency、frozen signal、implausible jump、invalid pulse 等；具体规则 TBD。
Functional Impact | 正常 Target RPM → Actual RPM 闭环反馈失效；Speed Deviation 正常诊断不可继续，Stall 诊断降级。
Fallback / Reaction | 若 remaining actuator health information 允许：切换 OPEN_LOOP_FALLBACK，Cooling Demand → fallback PWM mapping → Fan；Current / Voltage 继续保护和有限诊断。若 fallback 不 eligible → Safe Output。
System Mode | DEGRADED if fallback eligible; otherwise SAFE。
Fallback Eligibility | 至少要求不存在 Severe Overcurrent / confirmed Stall 等禁止继续驱动的条件；Current / Voltage / driver capability 与 Cooling Demand 有效性需满足后续准入规则。
Reporting | RPM_VALID = FALSE；Active Control Mode 必须对 Node B 可见；不得伪造 Actual RPM。
Recovery | RPM signal 必须重新通过 recovery qualification；回闭环时避免不必要的输出突变。具体 ramp / bumpless transfer 实现 TBD。
Open Parameters | Plausibility rules；fallback PWM map；entry/exit qualification；PWM limits。

## FA-04 — Motor Overcurrent

Detection Owner | Node A
Fault Source | Motor / driver / mechanical load 导致电流超过允许范围。
Detection Inputs | Motor Current；Drive State；Current signal validity。
Enable Condition | Current signal valid；driver active / relevant operating state。
Detection / Qualification | 架构允许区分 warning/moderate 与 severe protection levels；具体 threshold / filtering / time TBD。严重硬件风险可快速/立即触发。
Functional Impact | 严重过流可能要求关闭执行器，当前单风扇架构下导致冷却执行能力 LOST。
Local Reaction | Severe Overcurrent → Immediate Local Protection → Fan drive Safe Output；不得等待 CAN。
System Mode | Severe → SAFE；较轻程度是否仅 DEGRADED = TBD。
Dependency / Suppression | 若 Current Feedback Fault ACTIVE，则软件 overcurrent diagnostic 不再可信；未来 smart driver hardware protection 可作为独立机制，但 v0.1 未冻结。
Recovery | 是否 latched、是否自动重试 / power cycle / diagnostic clear = TBD。
Open Parameters | warning/protection thresholds；qualification；latch/retry。

## FA-05 — Current Feedback Fault

Detection Owner | Node A
Fault Source | Current sensing path 本身不可信，而不是实际 motor current 一定异常。
Detection Inputs | Current signal；RPM；Drive State；command context。
Enable Condition | 在 motor current 应具有可解释行为的工况下启用；具体 plausibility window TBD。
Detection / Qualification | Out-of-range、frozen、command/current contradiction 等 plausibility；具体算法 TBD。
Functional Impact | RPM closed-loop 仍可工作，但 Overcurrent software diagnostic 与 Current-based Stall discrimination 失去/降低覆盖。
Reaction | Mark Current INVALID；disable current-dependent diagnostics；继续可信 RPM closed-loop；向 Node B 报告 diagnostic coverage degradation。
System Mode | DEGRADED。
Dependency / Suppression | FA-04 software detection unavailable；FA-01 discrimination degraded；不影响基于 valid RPM 的 FA-02。
Recovery | Current signal re-qualified 后恢复依赖诊断，并重新评估当前 Fault Set。
Open Parameters | Plausibility rules；recovery qualification；DTC persistence。

## FA-06 — Supply Voltage Fault

Detection Owner | Node A
Fault Source | Actuator supply undervoltage / overvoltage。
Detection Inputs | Supply Voltage；Fan performance / current 可作为影响 context。
Enable Condition | Supply voltage sensing available 且 signal valid。
Detection / Qualification | Undervoltage / overvoltage threshold + persistence；具体 levels TBD。
Functional Impact | 轻/中度可导致 actuator performance REDUCED；严重时 actuator unavailable 或硬件保护。
Reaction | 根据 severity 保留/限制 fan control 或进入 Safe Output；严重 hardware-risk 情况本地保护优先。
System Mode | DEGRADED / SAFE，取决于剩余 actuator availability。
Dependency / Suppression | Undervoltage 可作为 FA-02 Speed Deviation 的 Root Cause Context，并在充分解释时抑制其独立 qualification。
Implementation Dependency | SAD 中 Supply Voltage sensing 当前仍是推荐/Open 决策。FA-06 作为 Fault family 已保留；若 OI-04 不纳入 v0.1 sensing，则本 Fault 的软件检测实现相应 defer。
Recovery | Voltage 恢复并 re-qualified 后重评 actuator capability 与全部 Active Fault。
Open Parameters | Voltage sensing inclusion OI-04；UV/OV thresholds；severity boundary；recovery。

## FA-07 — Cooling Demand Communication Fault

Detection Owner | Node A（关键命令的接收方）
Fault Source | B→A Cooling Demand command flow 的 timeout / alive / validity / freshness 异常。
Detection Inputs | Command reception timing；Alive / sequence；Cooling Demand range/validity；last valid demand。
Enable Condition | 正常运行阶段需要来自 Node B 的 Cooling Demand 更新。
Detection / Qualification | 短暂扰动先作为 suspected / qualifying；超过 timeout / sequence rule 后 Confirm。具体 CAN timing TBD。
Initial Reaction | Qualification 期间 Hold Last Valid Cooling Demand，避免偶发丢帧导致 fan output 频繁跳变。
Confirmed Fallback | Confirmed command fault 后停止无限期依赖 stale command，切换 Local Conservative Cooling Demand；RPM valid 时仍使用正常 local speed closed-loop。
Functional Impact | 失去正常 supervisory command，但 Node A 本地 actuator capability 可能仍保留。
System Mode | 若 Plant observable、A 仍可用且 B 仍能确认 A Status → DEGRADED；若 actuator availability / status 不可确认 → SAFE。
Recovery | 连续有效 command + valid sequence / timing 重新 qualification 后才返回 normal command control；模式切换应避免不必要输出 discontinuity。
Open Parameters | Command timeout；hold duration；fallback demand；alive rules；recovery count/time；transition ramp。

# 8. Node B Fault Definitions

## FB-01 — Overtemperature

Detection Owner | Node B
Fault Source | Thermal Plant / Cooling Target 实际热状态越过允许边界。
Detection Inputs | Valid Plant Temperature。
Enable Condition | Plant Temperature signal valid；system in applicable operating state。
Detection / Qualification | Temperature > Overtemperature Threshold 且持续达到 qualification；恢复应使用 hysteresis。具体值 TBD。
Functional Impact | Thermal operating limit violated；正常热管理已不能保证在允许边界内运行。
Reaction | System → SAFE；若 Cooling Actuator 可用，继续/提高 Emergency or Maximum-like Cooling。
System Mode | SAFE。
Dependency / Suppression | Plant Temperature Signal invalid 时，本 Fault detection 不可用；此时由 FB-06 直接处理 Observability Loss。
Recovery | Plant Temperature 必须 valid，且温度低于 recovery threshold 并持续满足 recovery qualification；之后重评全部 Active Fault。
Open Parameters | Overtemperature / recovery thresholds；hysteresis；qualification time。

## FB-02 — Insufficient Cooling Performance

Detection Owner | Node B
Fault Source | 执行器看似可用，但整个 Thermal Plant 的温度响应不能满足系统冷却需求。
Detection Inputs | Valid Plant Temperature；Cooling Demand；Node A / actuator availability；可选 Temperature trend dT/dt。
Enable Condition | Plant Temperature valid；Node A Status available；Cooling Demand 足够高且观察窗口有效。
Detection / Qualification | High demand + actuator available/healthy + Temperature 未按预期改善，并持续 observation window。具体性能模型/窗口 TBD。
Functional Impact | System-level cooling capability REDUCED；不等同于某一个 Fan component fault。
Reaction | System → DEGRADED；提高/保持可用冷却并加强监控。若发展为 FB-01 Overtemperature → SAFE。
System Mode | DEGRADED → SAFE。
Dependency / Suppression | Plant Temperature invalid → 本诊断 unavailable；Node A status unavailable 时优先处理 FB-03。
Recovery | 温度响应恢复并通过 observation/recovery qualification；重评所有 Active Fault。
Open Parameters | High-demand criterion；temperature response / dT/dt criterion；observation window；recovery。

## FB-03 — Node A Communication Timeout

Detection Owner | Node B（A Status 的接收方）
Fault Source | A→B Status flow 超时；可能由 Node A 掉电、CAN/Transceiver、发送软件、总线等多种原因造成。
Detection Inputs | Node A Status reception timing / freshness。
Enable Condition | 正常运行中应周期收到 Node A Status。
Detection / Qualification | 超过 status timeout 后 Confirm；具体周期/timeout 由 CAN Matrix 定。
Functional Impact | Node B 无法确认核心执行 ECU / cooling actuator availability。注意：Timeout 不等于“已证明 Node A CPU crash”。
Reaction | System → SAFE；Node B 记录 communication unavailability。Node A 若自身仍在运行，可按其本地 command-loss policy 继续 fallback，但 B 不能据此声称 system normal。
System Mode | SAFE。
Dependency / Suppression | 如果报文完全停止，FB-03 可覆盖“仅序列异常”的 FB-04 语义；具体 event suppression implementation TBD。
Recovery | 连续 valid status + fresh timing + valid sequence re-qualified 后恢复可观测性，并重评全部 Active Fault。
Open Parameters | Status cycle / timeout；recovery count/time。

## FB-04 — Node A Alive Counter / Message Sequence Fault

Detection Owner | Node B
Fault Source | A Status 仍有报文到达，但 sequence / freshness / software activity 语义异常。
Detection Inputs | Alive Counter / sequence；message timing / freshness。
Enable Condition | Alive mechanism 在对应周期报文中启用。
Detection / Qualification | Counter freeze、invalid jump、sequence error 持续达到规则后 Confirm。具体 bit width / allowed loss TBD。
Functional Impact | Node A Status 的可信度下降；短期仍可能保留部分可观察性。
Reaction | 初始/可控阶段 → DEGRADED；若持续到 Status freshness 无法可信确认 → SAFE。
System Mode | DEGRADED → SAFE。
Dependency / Suppression | 若进一步发展为 complete timeout，则 FB-03 描述更直接的 communication unavailability。
Recovery | Alive / sequence / timing 连续重新有效后 recovery qualification。
Open Parameters | Counter width；sequence rules；missed-frame tolerance；persistence / recovery。

## FB-06 — Plant Temperature Signal Fault

Detection Owner | Node B
Fault Source | Plant Temperature sensing path 本身失去可信度，而非 Thermal Plant 一定过温。
Detection Inputs | Raw / conditioned Temperature signal；range / plausibility / freshness；v0.1 不依赖 Thermal Observer / Virtual Sensor。
Enable Condition | Temperature acquisition path active；针对 startup / sensor settling 的具体 inhibit 由 detailed design 定。
Detection / Qualification | Open/short where detectable、out-of-range、frozen / implausible signal 等经 qualification 后 Confirm。具体传感器相关规则 TBD。
Functional Impact | Thermal State Observability LOST；normal temperature-based Thermal Strategy、FB-01 Overtemperature detection 与 FB-02 Cooling Performance evaluation 均不可正常进行。
Reaction | Mark Plant Temperature INVALID；disable normal temperature-based strategy；System → SAFE；actuator available 时执行 Emergency / Conservative Cooling Demand。
Safety Interpretation | Emergency cooling 只是 risk-reduction fallback，不能证明 Thermal Plant 已安全。Node A local motor/ECU temperature 测量对象不同，不能替代 Plant Temperature。
System Mode | SAFE。
Recovery | Temperature signal 重新通过 plausibility / recovery qualification → Observability restored → 再评估真实 Plant Temperature；若仍过温则保持 SAFE。
Open Parameters | Sensor plausibility；qualification/recovery time；Emergency Cooling Demand value；DTC persistence。
Deferred Extension | Physical redundancy / heterogeneous plausibility / Analytical Redundancy / Thermal Model / Observer / Virtual Sensor / residual-based FDI 留到 v0.1 主链完成后优化。

# 9. Fault Propagation and FB-05 Reservation

Node A 本地 Fault 经 CAN Status / Fault Status 上报 Node B；Node B 作为 System Fault Manager 接收并结合 Plant Temperature、Cooling Demand、Node A Availability 和其他系统 context 做 Aggregation 与 Mode 管理。Node B 不重复实现 Node A 的全部本地硬件诊断算法。

FB-05 = Propagation Mechanism, not Failure Mode “Node A Reported Actuator Fault”没有独立物理 Fault Source，也没有自己的固定 System Mode。A 上报 FA-05 时系统可能 DEGRADED；A 上报 FA-01 时系统可能 SAFE。因此 FB-05 在 v0.1 仅作为历史编号占位，正式实现应传递 underlying Fault ID / status / availability，而不是生成一个新的通用 Fault。

# 10. Fault Dependency / Suppression / Arbitration

Rule | Baseline
A-01 | Mode = evaluate(all Active Confirmed Faults, Functional Availability, Observability, Protection State)。不以“Fault 数量”或简单固定最大值决定。
A-02 | Known Root Cause 可抑制能够被其充分解释的 Consequential Fault independent qualification；raw signal / evidence 不删除。
A-03 | Signal invalidation 必须传播：依赖该 Signal 的 control / diagnostic function 标记 unavailable / degraded / inhibited。
A-04 | Immediate Local Hardware Protection 具有最高 reaction precedence，不得被 normal control 或 degraded-operation request 覆盖。
A-05 | 跨层 Fault 可以并存：Actuator performance fault → System cooling performance fault → Thermal limit fault 描述的是不同 abstraction level。
A-06 | Recovery 必须重算当前全部 Fault Set；一个 SAFE-level Fault clear 后仍可能只恢复到 DEGRADED。

## 10.1 Dependency Examples

场景 | 处理原则
FA-06 Undervoltage + FA-02 Speed Deviation | 若 Undervoltage 足以解释 RPM 下降，FA-06 作为 root-cause context；可抑制 FA-02 独立 qualification，但保留 Actual RPM evidence。
FA-03 RPM Feedback Fault + FA-01 Stall Detection | RPM invalid 后正常 stall confirmation 条件被破坏；Stall diagnostic 降级/受限，只能利用剩余 evidence，不得把 invalid RPM 当真。
FA-05 Current Feedback Fault | Overcurrent software diagnostic unavailable；current-based stall discrimination degraded；RPM closed-loop 仍可继续。
FA-02 → FB-02 → FB-01 | 三者分别表示 actuator performance、system cooling function、thermal limit；可同时保留并形成 fault propagation chain。
FB-06 Temperature Signal Fault | FB-01 / FB-02 因关键输入 invalid 而 unavailable；系统直接因 Observability Loss 进入 SAFE。
FA-05 + FA-01 | FA-01 导致 SAFE；若 Stall 恢复但 Current Feedback Fault 仍 Active，则重评后可 SAFE → DEGRADED，而不是直接 NORMAL。

## 10.2 Reaction Precedence (Architectural)

层级 | 类型 | 示例 | 解释
1 | Immediate Hardware Protection | Severe Overcurrent / severe electrical risk | 本地保护优先；先保护硬件/执行器。
2 | Critical Function / Observability Loss | Fan Stall；Plant Temperature loss；Node A unavailable；Overtemperature | 正常热管理无法保证/确认，通常驱动 SAFE。
3 | Functional Degradation | Speed Deviation；RPM fallback；command-loss fallback；early insufficient cooling | 仍有受限功能，通常 DEGRADED，可升级。
4 | Diagnostic Coverage Degradation | Current Feedback Fault | 核心控制仍可用，但 fault coverage 下降。

该层级用于描述 Reaction precedence，不是 FMEA Severity 分数，也不是 ISO 26262 ASIL。具体 software priority / event ordering 仍由后续 Fault Manager / State Machine Design 实现。

# 11. Recovery / Latching Baseline

原则 | 定义
R-01 Fault disappearance ≠ recovery | 异常样本消失后必须经过 Recovery Qualification。
R-02 Restore capability first | 恢复 Mode 前必须确认所需 Functional Availability 已恢复。
R-03 Restore observability | 关键 Signal / Status 必须重新可信；例如 Temperature sensor 恢复后先 re-qualify，再判断实际温度。
R-04 Re-evaluate all faults | 每次 Fault Set 改变都重新计算可达到的最高有效 Mode：SAFE → DEGRADED → NORMAL 均可能。
R-05 Operational vs diagnostic | 系统恢复 NORMAL/DEGRADED 不等于历史 DTC / stored event 被自动删除。
R-06 Per-fault latching | 自动恢复、自动 retry、power cycle、diagnostic clear 等按 Fault 类型定义；具体分类目前仍 TBD。
R-07 Controlled mode transition | Fallback ↔ Normal 切换避免不必要 actuator discontinuity；是否采用 ramp / bumpless transfer 及其参数 TBD。

# 12. Diagnostic Exposure and DTC Ownership

Node B 是系统级 Fault Aggregation / DTC 管理的主要责任方；Node A 负责检测本地 Fault、执行必要保护，并通过 CAN 报告 underlying Fault Status、signal validity、control mode / fallback status 与必要 evidence。

Fault List v0.1 不冻结具体 UDS service、DTC 编码、snapshot / freeze-frame、aging、clear condition 或 NVM persistence。Operational Fault State 与 stored DTC history 必须在后续 Diagnostic Architecture 中分离设计。

DTC Scope [TBD] DTC Owner 的系统级责任边界已确定；DTC number、storage、aging、clear、PC diagnostic request/response、UDS mapping 等仍属于 Diagnostic Architecture。

# 13. Open Calibration / Detailed Design Register

ID | Open Item
FL-OI-01 | FA-01 Stall RPM / Current threshold、startup grace、debounce、retry/latch
FL-OI-02 | FA-02 relative speed error / observation time / root-cause suppression detail
FL-OI-03 | FA-03 RPM plausibility、open-loop fallback PWM map、eligibility / entry / exit / limits
FL-OI-04 | FA-04 overcurrent warning/protection thresholds、filter / qualification、latching
FL-OI-05 | FA-05 current plausibility / recovery rules
FL-OI-06 | OI-04：Supply Voltage sensing 是否正式纳入 v0.1；若纳入，UV/OV thresholds 与 severity boundary
FL-OI-07 | FA-07 command timeout、hold-last duration、local conservative demand、alive/recovery timing
FL-OI-08 | FB-01 overtemperature / recovery threshold、hysteresis、qualification
FL-OI-09 | FB-02 insufficient cooling criterion / dT/dt / observation window
FL-OI-10 | FB-03/04 Status cycle、timeout、Alive Counter width / sequence / missed-frame tolerance
FL-OI-11 | FB-06 temperature sensor plausibility、recovery qualification、emergency cooling demand
FL-OI-12 | Per-fault auto-recovery / retry / latching / diagnostic-clear 分类
FL-OI-13 | Detailed multi-fault suppression table / event ordering implementation
FL-OI-14 | DTC code / storage / aging / clear / UDS exposure

# 14. Traceability to Next Design Artifacts

Downstream Artifact | Fault List 提供的输入
CAN Matrix v0.1 | 需要跨 ECU 传递的 Fault Status、Signal Validity、Control Mode / Fallback Status、Node availability、Alive / timeout semantics。
FreeRTOS Task Architecture | 哪些 Fault 需要周期 sampling / monitoring、哪些需要立即 local protection、Fault Manager / State Manager 的执行触发。
Hardware Selection | 必须具备 RPM / Current / Temperature acquisition；Supply Voltage sensing OI-04；driver protection capability；CAN interface。
Diagnostic Architecture | DTC Owner、event state、stored history、clear / aging / PC/UDS exposure。
Verification / Test Specification | Fault injection、qualification、fallback、SAFE/DEGRADED transitions、recovery、multi-fault dependency / suppression 测试场景。

# Appendix A — Fault Architecture Snapshot

Architecture Snapshot Node A detects and protects actuator-local faults → reports underlying Fault Status to Node B. Node B combines local faults with Plant Temperature, communication health and system context → evaluates Functional Availability + Observability → NORMAL / DEGRADED / SAFE. Fallback preserves remaining capability; invalid signals disable dependent functions; Recovery re-qualifies and re-evaluates all active faults.

Fault List v0.1 | Dual-ECU Thermal Management Control & Diagnostic System

STM32 + FreeRTOS Dual-ECU CAN Project | Fault List v0.1
