Ben-nevis2006/stm32-freertos-dual-ecu-can-diagnostics/current/project charter.docx

## 1: 这个项目存在的意义是什么？

用来帮助我拿下寒假实习offer。

用来展示我对这个汽车行业工作流程的一定热情和意愿，同时体现我是具有产出价值的能力的。

更好的项目目标是：

构建一个由两个 STM32 ECU 节点组成的实时 CAN 控制系统，在节点失联、报文异常和设备故障情况下能够自动检测、记录故障并进入安全状态。

## 2：用户/使用者是谁？

后续对接汽车维修诊断的工程师。

## 3：项目最终解决什么问题？

能够解决汽车出了毛病却锁定不了病灶的问题。为后续诊断提供更加精确的问题提示，帮助工程师提高诊断效率。

## 4：什么叫成功？

# Project Charter

## 1. Project Information

Project Name
STM32 + FreeRTOS 双节点 CAN 控制与故障诊断系统

English Name
Dual-Node CAN Control and Fault Diagnostic System Based on STM32 and FreeRTOS

Project Type
个人嵌入式系统工程项目 / 汽车电子方向学习与作品集项目

Project Owner
李何

Project Role
项目负责人 / Embedded Software Developer / System Designer / Tester

Project Status
Initiation

Planned Duration
预计 7–10 周，以课余时间开发为基准。

Target Release
V1.0 Engineering Demo

# 2. Project Background

现代汽车电子和工业控制系统通常由多个 ECU 或控制节点通过 CAN 等总线交换状态、控制命令和诊断信息。

单纯实现 MCU 之间的 CAN 数据收发，只能证明基础外设使用能力，不能充分体现真实嵌入式系统中的通信管理、实时调度、故障处理、系统状态管理以及诊断能力。

本项目计划构建一个由两个 STM32 节点组成的小型分布式控制系统，在 FreeRTOS 实时操作系统基础上完成：

- 节点间 CAN 周期通信；
- 控制命令及状态数据传输；
- 节点在线状态监控；
- 通信异常检测；
- 本地设备故障检测；
- 故障状态管理；
- DTC 故障记录；
- 系统安全状态处理；
- 故障恢复；
- PC 端诊断与测试。

项目重点不在于单独展示 STM32、FreeRTOS 或 CAN 的使用方法，而在于展示一个完整嵌入式系统从架构设计、通信设计、任务调度、异常处理到测试验证的工程过程。

# 3. Project Purpose

本项目主要用于建立一套接近真实 ECU 软件开发逻辑的嵌入式工程实践。

项目希望证明以下能力：

1. STM32 嵌入式软件开发能力；
2. FreeRTOS 多任务系统设计能力；
3. CAN 总线通信设计能力；
4. 基础汽车通信协议设计能力；
5. 故障检测与故障状态管理能力；
6. 嵌入式系统状态机设计能力；
7. DTC 故障记录与读取能力；
8. PC 与嵌入式设备联合调试能力；
9. 故障注入与系统测试能力；
10. Git、文档、测试记录等工程管理能力。

# 4. Project Objective

构建一个由两个 STM32 节点组成的 FreeRTOS 实时 CAN 控制系统。

系统应能够在正常状态下稳定进行周期性通信和控制，并能够在出现节点失联、CAN 报文异常或设备异常时：

1. 自动检测故障；
2. 对故障进行分类；
3. 记录对应 DTC；
4. 根据故障等级改变系统状态；
5. 必要时进入预定义安全状态；
6. 在满足恢复条件后执行受控恢复；
7. 允许 PC 端读取系统状态及故障信息。

# 5. Project Success Statement

本项目被认为成功，不以“两个 STM32 能通过 CAN 收发数据”为标准。

项目成功必须能够通过现场 Demo 和测试数据证明：

当系统面对人为制造的节点失联、报文异常以及设备故障时，可以按照预定义规则完成检测、诊断、记录、状态转换、安全处理以及恢复。

# 6. Project Scope

## 6.1 In Scope

V1.0 项目范围包括以下功能。

### Embedded Platform

- 两个 STM32 MCU 节点；
- FreeRTOS；
- CAN 或通过支持 FDCAN 的 MCU 使用 Classic CAN；
- CAN 收发器；
- 基础传感器或模拟输入；
- 简单执行器或模拟负载。

### Communication

- 双节点 CAN 通信；
- 周期性 CAN Message；
- Event Message；
- Heartbeat；
- Alive Counter；
- 基础报文完整性检测；
- Communication Timeout Detection。

### Real-Time Software

- CAN RX 中断；
- FreeRTOS Task；
- Queue；
- 软件定时机制；
- Task Priority 设计；
- 周期任务；
- 基础线程安全管理。

### System Control

- 控制命令接收；
- 节点状态发送；
- 简单执行器控制；
- 系统运行状态机。

### Diagnosis

至少支持：

- Node Communication Timeout；
- Heartbeat Loss；
- Alive Counter Error；
- Sensor Out-of-Range；
- Node Reset / Restart Detection；
- 一个可主动注入的模拟设备故障。

### Fault Management

实现基本系统状态：

- NORMAL；
- DEGRADED；
- FAULT；
- SAFE；
- RECOVERY。

### DTC

实现简化 DTC Manager，包括：

- DTC Set；
- DTC Active；
- DTC History；
- DTC Clear；
- DTC Read。

### PC Diagnosis

PC 端至少可以：

- 查看节点在线状态；
- 查看系统状态；
- 查看传感器/控制数据；
- 查看 DTC；
- 清除允许清除的 DTC；
- 辅助故障注入或测试。

### Engineering

项目必须包含：

- Git Repository；
- Architecture Diagram；
- CAN Communication Matrix；
- Fault List；
- Test Cases；
- Test Report；
- README；
- Demo。

# 7. Out of Scope

以下内容不属于 V1.0 必须完成内容。

即使后期具备能力，也不得影响 V1.0 项目按期完成。

### Automotive Software

- 完整 AUTOSAR；
- AUTOSAR Classic Stack；
- 完整 DEM；
- 完整 DCM；
- 完整 COM Stack；
- 完整 ISO 26262 流程；
- 完整 ASPICE 流程。

### Diagnostics

- 完整 ISO 14229 UDS；
- 完整 ISO-TP；
- DoIP；
- Diagnostic Security Access；
- ECU Programming；
- Production Flashing。

### Bootloader

- CAN Bootloader；
- OTA；
- A/B Partition；
- Secure Boot。

### Hardware

- 自研复杂 PCB；
- 车规 MCU；
- 真实汽车 ECU；
- 真实车辆接入。

### Network

- Automotive Ethernet；
- LIN；
- FlexRay。

这些内容可以进入 Future Roadmap，但不得成为 V1.0 Release Blocker。

# 8. High-Level System Concept

系统暂定由两个逻辑角色不同的 ECU 节点组成。

## Node A — Device ECU

主要负责：

- 传感器读取；
- 本地输入处理；
- 执行器控制；
- 本地故障检测；
- 状态上报；
- Heartbeat 发送；
- CAN 命令接收。

逻辑结构：

Sensor

│

▼

Sensor Task

│

▼

Application / Control

│

▼

Actuator

↓

CAN TX

↑

CAN RX

## Node B — Supervisor ECU

主要负责：

- Node A 状态监控；
- CAN 数据接收；
- Communication Timeout；
- 故障状态管理；
- 系统状态机；
- DTC；
- 控制命令发送；
- PC 诊断接口。

逻辑结构：

CAN RX

│

▼

Communication Manager

│

├── Status Manager

├── Fault Manager

├── DTC Manager

└── System State Machine

│

▼

CAN TX

## PC Tester

PC 端作为 Tester / Diagnostic Tool。

暂定承担：

- CAN 数据观察；
- ECU 状态显示；
- DTC 读取；
- DTC 清除；
- Fault Injection；
- Test Logging。

具体采用 Python、USB-CAN 工具或其他方案将在技术调研阶段确定。

# 9. Preliminary Software Architecture

暂定软件结构：

Application Layer

│

├── Control Application

├── System State Manager

├── Fault Manager

└── Diagnosis

│

▼

Service Layer

│

├── Signal Manager

├── DTC Manager

├── Communication Manager

└── Device Manager

│

▼

RTOS Layer

│

├── Task

├── Queue

├── Semaphore / Mutex

└── Timer

│

▼

Driver Layer

│

├── CAN / FDCAN

├── GPIO

├── ADC

├── Timer

└── UART

│

▼

STM32 Hardware

该架构为初始架构，不代表最终实现。

Architecture Review 后可以调整。

# 10. Preliminary FreeRTOS Architecture

初步计划包含以下任务：

### Communication Task

职责：

- CAN Message Parsing；
- Signal Update；
- Communication State Update。

### CAN TX Task

职责：

- 周期报文发送；
- Event Message 发送；
- Heartbeat。

### Sensor Task

职责：

- 传感器采集；
- 输入滤波；
- 基础合理性检测。

### Control Task

职责：

- 控制算法；
- 执行器输出。

### Diagnosis Task

职责：

- Communication Timeout；
- Sensor Fault Detection；
- Fault Debounce；
- DTC Trigger。

### System Manager Task

职责：

- 系统状态机；
- Safe State；
- Recovery Condition。

具体 Task Priority、周期以及 Stack Size 属于设计阶段 TBD 项。

# 11. Preliminary CAN Communication Matrix

以下为项目启动阶段的初始版本。

具体 ID 和 Byte Mapping 可在 Design Phase 修改。

CAN ID | Sender | Receiver | Type | Initial Cycle
0x100 | Node A | Node B | Status | 10 ms
0x101 | Node A | Node B | Heartbeat | 100 ms
0x180 | Node B | Node A | Control Command | 10 ms
0x200 | Node A | Node B | Fault Event | Event
0x201 | Node B | Node A | System State | 100 ms
TBD | PC | ECU | Diagnostic Request | Event
TBD | ECU | PC | Diagnostic Response | Event

# 12. Proposed CAN Signal Design

单个状态报文可以考虑包含：

Byte 0 Node State

Byte 1 Sensor Status

Byte 2-3 Sensor Value

Byte 4 Actuator Status

Byte 5 Alive Counter

Byte 6 Fault Bitmap

Byte 7 CRC / Reserved

该设计尚未冻结。

Architecture Review 后形成正式 CAN Matrix。

# 13. Fault Model

V1.0 至少覆盖以下故障类型。

## Communication Fault

### F-COM-001

Fault: Heartbeat Timeout

Condition:
Node B 在规定时间内未收到 Node A Heartbeat。

Expected Action:

- Set Communication Fault；
- Set DTC；
- Node A 标记 Offline；
- System 转入 DEGRADED / FAULT；
- 必要时关闭执行器。

### F-COM-002

Fault: Alive Counter Error

Condition:
接收到的 Alive Counter 顺序异常。

Expected Action:

- Error Counter +1；
- 达到 Debounce Threshold 后 Set Fault。

### F-COM-003

Fault: Invalid Frame

可能包括：

- CRC Error；
- Payload Invalid；
- Signal Range Invalid。

具体实现方式 TBD。

## Device Fault

### F-DEV-001

Fault: Sensor Out-of-Range

例如：

Sensor < Lower Limit

OR

Sensor > Upper Limit

经过 Debounce 后确认。

### F-DEV-002

Fault: Simulated Sensor Failure

允许通过软件或物理方式主动制造传感器故障。

## ECU Fault

### F-ECU-001

Fault: Node Restart

Node B 通过 Heartbeat / Counter / Startup Message 等方式识别 Node A 重启。

具体识别机制 TBD。

# 14. System State Model

V1.0 计划使用以下系统状态：

INIT

│

▼

NORMAL

│

├─────────────┐

▼ │

DEGRADED │

│ │

▼ │

FAULT │

│ │

▼ │

SAFE │

│ │

▼ │

RECOVERY ───────┘

## INIT

系统启动及基础初始化。

## NORMAL

所有关键组件运行正常。

## DEGRADED

检测到非致命问题，但系统仍可部分运行。

## FAULT

存在已确认故障。

## SAFE

系统执行预定义安全动作。

例如：

- 禁止执行器输出；
- 固定为安全输出；
- 拒绝部分控制命令。

## RECOVERY

故障条件已经消失，但系统需要经过一定验证才能回到 NORMAL。

例如：

连续 N 次 Heartbeat 正常后恢复。

N 值 TBD。

# 15. DTC Concept

V1.0 使用简化 DTC，不要求完全遵循量产 ECU 编码体系。

每个 DTC 至少包含：

DTC ID

Fault Type

Current Status

Active / Inactive

Occurrence Counter

First Occurrence

Latest Occurrence

Clearable

Optional Freeze Data

示例：

DTC | Description
DTC_001 | Node A Communication Timeout
DTC_002 | Alive Counter Error
DTC_003 | Sensor Out-of-Range
DTC_004 | Invalid CAN Payload
DTC_005 | Node Restart Detected

# 16. Diagnostic Interface

V1.0 不要求完整 UDS。

基础版本可以采用自定义诊断协议：

Read Node Status

Read DTC

Clear DTC

Read Sensor Data

Fault Injection

如核心项目提前完成，可增加 UDS-lite。

优先考虑：

0x10 Diagnostic Session Control

0x14 Clear Diagnostic Information

0x19 Read DTC Information

0x22 Read Data By Identifier

UDS-lite 属于 Stretch Goal，不属于 V1.0 Release 必要条件。

# 17. Hardware Resource Requirements

## Mandatory

- STM32 Development Board ×2；
- CAN 或 FDCAN Controller；
- CAN Transceiver ×2；
- 120 Ω CAN Termination ×2；
- USB Cable；
- Breadboard / Jumper Wire；
- Debugger。

## Recommended

- USB-CAN Adapter；
- Logic Analyzer；
- Oscilloscope；
- Sensor Module；
- Motor / Servo / LED 等模拟执行器。

## Candidate MCU

具体 MCU 尚未冻结。

候选包括：

- 现有可获得 STM32 板；
- STM32F4；
- STM32G4；
- 其他具备 CAN/FDCAN 外设的 STM32。

### Decision Principle

优先考虑：

1. 手头是否已有；
2. CAN/FDCAN 外设；
3. FreeRTOS 支持；
4. 调试便利性；
5. 成本；
6. 项目工期。

不因为追求更先进 MCU 延误项目。

# 18. Software Resource Requirements

预计使用：

- STM32CubeMX；
- STM32CubeIDE；
- FreeRTOS；
- Git；
- GitHub；
- Python；
- CAN Analysis Software。

可选：

- python-can；
- cantools；
- CANoe；
- CANalyzer；
- PC GUI Framework。

具体工具根据硬件及许可证情况决定。

# 19. Project Deliverables

V1.0 结项时必须存在以下交付物：

## Firmware

- Node A Firmware；
- Node B Firmware。

## PC Software

- PC Diagnosis / Test Utility。

## Design Documents

- Project Charter；
- System Architecture Diagram；
- Software Architecture Diagram；
- CAN Communication Matrix；
- Fault List；
- State Machine Diagram。

## Test Documents

- Test Plan；
- Test Cases；
- Test Results；
- Fault Injection Results。

## Repository

完整 Git Repository：

/firmware

/node_a

/node_b

/tools

/pc_diagnostic

/docs

/architecture

/can

/diagnostics

/testing

README.md

## Demonstration

必须能够进行现场 Demo 或录像 Demo。

# 20. Acceptance Criteria

项目必须满足以下最低验收条件。

## AC-001 Stable CAN Communication

两个节点在正常运行条件下保持稳定周期通信。

验收方式：

连续运行至少 30 分钟，无系统级异常。

## AC-002 Heartbeat Detection

Node A 周期发送 Heartbeat。

当 Node A 停止 Heartbeat 时：

Node B 必须在规定时间内检测通信丢失。

暂定目标：

≤ 500 ms

最终值在设计阶段确定。

## AC-003 Safe State

检测到关键通信故障后：

系统必须停止危险或无效控制行为。

例如：

Actuator Command = SAFE_VALUE

## AC-004 DTC Generation

每一种主要故障至少对应一个 DTC。

发生故障后：

DTC 可以从 PC Tester 中读取。

## AC-005 Fault Recovery

故障条件消失后：

系统必须执行受控恢复。

不得因为单帧恢复立即跳回 NORMAL。

## AC-006 Sensor Fault Detection

人工制造 Sensor Out-of-Range 后：

系统必须检测故障并生成对应 DTC。

## AC-007 Fault Injection

至少成功演示以下 4 种故障：

1. Node Disconnect；
2. Heartbeat Loss；
3. Sensor Fault；
4. Invalid Communication / Counter Error。

## AC-008 Documentation

项目必须包含：

- README；
- Architecture；
- CAN Matrix；
- Fault List；
- Test Results。

没有工程文档不得视为正式结项。

# 21. Non-Functional Requirements

## Reliability

系统不得因单次通信异常直接崩溃。

## Maintainability

主要模块应具有明确职责。

禁止将大量逻辑集中在：

main.c

或者单个 Task 中。

## Observability

关键状态必须能够通过至少一种方式观察：

- UART；
- CAN；
- PC Tool；
- Debug Log。

## Testability

核心故障必须能够人为复现。

## Traceability

重要需求应能够对应至少一个 Test Case。

# 22. Preliminary Project Milestones

## M0 — Project Initiation

完成：

- Project Charter；
- 项目目标；
- Scope；
- Out of Scope。

Exit Criteria

本 Charter 完成并进入 Baseline。

## M1 — Architecture Freeze

完成：

- Node A / Node B 角色；
- MCU Selection；
- CAN Architecture；
- Task Architecture；
- CAN Matrix V1；
- Fault List V1。

Exit Criteria

所有关键模块职责明确。

## M2 — Communication Ready

完成：

- 两个 STM32 CAN 通信；
- 周期报文；
- Heartbeat；
- 基础 CAN RX/TX。

Exit Criteria

双节点可稳定运行。

## M3 — RTOS Integration Ready

完成：

- FreeRTOS；
- CAN Task；
- Sensor Task；
- Control Task；
- Diagnosis Task。

Exit Criteria

系统在 RTOS 架构下正常运行。

## M4 — Fault Management Ready

完成：

- Timeout；
- Sensor Fault；
- Alive Counter；
- Fault Manager；
- System State Machine；
- Safe State。

Exit Criteria

故障可检测、处理、恢复。

## M5 — Diagnosis Ready

完成：

- DTC Manager；
- PC Tester；
- DTC Read；
- DTC Clear。

Exit Criteria

主要诊断流程可演示。

## M6 — System Validation

完成：

- Fault Injection；
- Long-Run Test；
- Recovery Test；
- Timing Measurement；
- Bug Fix。

Exit Criteria

Acceptance Criteria 全部达到。

## M7 — Release

完成：

- README；
- Architecture Documentation；
- Test Report；
- Demo；
- Git Release Tag。

版本：

V1.0

正式结项。

# 23. Preliminary Schedule

预计：

### Week 1

项目设计与技术验证。

重点：

- MCU；
- CAN Hardware；
- Node Architecture；
- CAN Matrix。

### Week 2

双节点 CAN 通信。

### Week 3

FreeRTOS 软件架构。

### Week 4

Control + Communication Monitoring。

### Week 5

Fault Manager + State Machine + DTC。

### Week 6

PC Diagnosis。

### Week 7

Fault Injection + Testing。

### Week 8

Documentation + Release。

Week 9–10 作为项目缓冲区。

# 24. Risk Register

ID | Risk | Probability | Impact | Mitigation
R01 | CAN Hardware 无法通信 | Medium | High | 首先实现最小 CAN Demo
R02 | CAN Transceiver 接线错误 | Medium | Medium | 独立验证 Physical Layer
R03 | FreeRTOS 架构复杂化 | Medium | High | 控制 Task 数量
R04 | Interrupt 与 Task 冲突 | Medium | High | ISR 只做必要操作
R05 | UDS 范围失控 | High | High | UDS 设置为 Stretch Goal
R06 | PC 工具开发耗时 | Medium | Medium | 初期采用 CLI 而非 GUI
R07 | 过度追求高级 MCU | Medium | Medium | 优先使用现有硬件
R08 | Fault Model 设计过多 | High | Medium | V1 限定 4–6 种核心故障
R09 | 调试时间不可预计 | High | High | Schedule 设置 Buffer
R10 | Scope Creep | High | High | 新需求进入 Backlog
R11 | 文档拖到最后 | High | Medium | 每个 Milestone 同步更新
R12 | 系统能运行但无法证明 | Medium | High | 提前设计 Test Case

# 25. Project Constraints

项目存在以下现实约束：

## Time

项目为学生个人项目，无法保证全职开发。

因此：

项目范围优先于功能数量。

## Budget

优先利用：

- 已有 STM32；
- 学校设备；
- 低成本 CAN Adapter。

不得为了项目购买明显超出需求的硬件。

## Experience

项目启动阶段预计尚未完全掌握：

- FreeRTOS 高级调度；
- CAN 错误状态；
- Bus-Off；
- UDS；
- DTC；
- 汽车诊断架构。

这些内容属于：

Learning During Project

而不是项目启动条件。

# 26. Assumptions

当前项目基于以下假设启动：

1. 两个 STM32 节点足以体现分布式通信系统；
2. 不需要真实车辆；
3. 简化控制对象足以验证系统设计；
4. Classic CAN 足以满足 V1.0；
5. FreeRTOS 足以承担项目 RTOS；
6. PC Tester 可以使用非商业软件实现；
7. 项目重点为系统设计而非复杂控制算法；
8. 故障诊断深度优先于功能数量。

如果上述假设后续证明错误，需要进入 Change Management。

# 27. Open Technical Questions

以下问题在项目启动阶段允许暂不回答。

它们将在 Architecture Phase 解决。

## Q01

最终选择哪款 STM32？

Decision Deadline: M1

## Q02

使用 Classic CAN 还是 CAN-FD？

Default Assumption: Classic CAN

Decision Deadline: M1

## Q03

使用什么 CAN Transceiver？

Decision Deadline: Hardware Selection

## Q04

PC 使用哪种 USB-CAN Adapter？

Decision Deadline: M2 前

## Q05

是否需要 CRC？

Decision Deadline: CAN Matrix Freeze

## Q06

Alive Counter 使用多少位？

Decision Deadline: CAN Matrix Freeze

## Q07

Heartbeat 周期和 Timeout 是多少？

Initial Assumption:

Heartbeat = 100 ms

Timeout = 300–500 ms

需要测试后确定。

## Q08

Safe State 具体是什么？

需要在控制对象确定以后决定。

## Q09

传感器使用什么？

优先选择：

- 电位器；
- 温度传感器；
- 光照传感器；
- ADC 模拟输入。

要求：

简单、稳定、容易人为制造故障。

## Q10

执行器是什么？

候选：

- LED；
- DC Motor；
- Servo；
- Buzzer。

项目核心不依赖复杂执行器。

## Q11

DTC 是否保存到 Flash？

V1 Default: RAM

Flash Persistence 为 Optional。

## Q12

是否实现 UDS？

V1: No。

项目提前完成后考虑 UDS-lite。

# 28. Decision Gates

项目设置以下重大决策节点。

## DG1 — Hardware Selection

必须解决：

- MCU；
- Development Board；
- CAN Transceiver；
- USB-CAN。

## DG2 — Architecture Freeze

必须解决：

- Node Responsibilities；
- Task Architecture；
- CAN Message List；
- Fault List。

## DG3 — Scope Review

在 M3 后检查：

如果 Schedule 正常：

可考虑加入 Optional Feature。

如果 Schedule 延误：

禁止增加新功能。

## DG4 — Release Scope Freeze

进入 System Validation 后：

停止新增功能。

只允许：

- Bug Fix；
- Test；
- Documentation。

# 29. Change Management Rules

任何新增功能都必须回答：

1. 为什么需要？
2. 是否属于 V1 Objective？
3. 对 Schedule 有什么影响？
4. 是否增加新 Hardware？
5. 是否增加新的 High-Risk Dependency？
6. 是否会阻塞当前 Milestone？

如无法明确证明其必要性：

进入：

Backlog

而不是当前 Sprint。

# 30. Stretch Goals

在 V1.0 提前完成的情况下，可以选择以下内容。

优先顺序：

### Stretch 1

CAN DBC。

### Stretch 2

Python GUI。

### Stretch 3

UDS-lite。

### Stretch 4

CAN-FD。

### Stretch 5

DTC Flash Persistence。

### Stretch 6

Bootloader。

### Stretch 7

CANoe / CAPL Test。

原则：

一次只增加一个 Stretch Goal。

# 31. Project KPIs

项目工程表现可以通过以下数据评价：

- CAN Message Period；
- CAN Message Jitter；
- Fault Detection Time；
- Fault Recovery Time；
- DTC Detection Accuracy；
- CAN Bus Load；
- Queue Overflow Count；
- Runtime Stability；
- Fault Injection Pass Rate。

目标不是追求工业级数字，而是：

能够量化系统行为。

# 32. Definition of Done

项目只有满足以下条件才能被称为：

DONE

### Functional

两个节点正常工作。

### Communication

CAN 周期通信稳定。

### RTOS

系统通过 FreeRTOS 正常运行。

### Fault

至少 4 种故障可以主动注入。

### Diagnosis

故障可以识别、记录和读取。

### Safety

关键故障存在 Safe State。

### Recovery

至少一种故障支持自动恢复。

### Testing

存在完整测试结果。

### Documentation

项目有完整 README 和设计文档。

### Demo

整个核心流程可以在 Demo 中重复复现。

# 33. Final Demonstration Scenario

最终项目 Demo 建议严格按照以下流程执行。

## Phase 1 — Startup

两个节点上电。

PC 显示：

Node A: ONLINE

Node B: ONLINE

System State: NORMAL

## Phase 2 — Normal Operation

Node A：

- 采集 Sensor；
- 控制 Actuator；
- 发送 Status。

Node B：

- 发送 Control Command；
- 监控 Node A。

## Phase 3 — Fault Injection

人为停止 Node A Heartbeat。

Node B 检测：

COMMUNICATION TIMEOUT

然后：

NORMAL

↓

FAULT

↓

SAFE

执行器进入 Safe State。

## Phase 4 — Diagnostic

PC 读取：

DTC_001

Node A Communication Timeout

Status: ACTIVE

## Phase 5 — Recovery

恢复 Node A。

连续 N 个合法 Heartbeat 后：

SAFE

↓

RECOVERY

↓

NORMAL

历史 DTC 仍可查看。

## Phase 6 — Clear DTC

PC 发送 Clear DTC。

历史故障被清除。

至此完成完整系统演示。

# 34. Project Positioning

本项目不定位为：

两块 STM32 使用 CAN 通信的练习项目。

而定位为：

一个基于 STM32、FreeRTOS 和 CAN 构建的小型分布式 ECU 实时控制与故障诊断系统，通过通信监控、故障管理、DTC、系统状态机、故障注入和自动恢复机制，模拟真实嵌入式控制系统中的基本可靠性与诊断设计。

# 35. Project Management Principle

整个项目遵循以下优先级：

Correct Architecture

↓

Stable Core System

↓

Fault Handling

↓

Testability

↓

Documentation

↓

Additional Features

项目判断标准不是：

做了多少功能。

而是：

已经承诺的功能是否能够稳定、可测、可解释地运行。

# 36. Charter Approval

本 Charter 作为 V1.0 项目启动基线。

项目正式进入下一阶段：

System Architecture & Requirement Definition

下一阶段首先需要解决：

1. Node A 与 Node B 的具体职责；
2. MCU 和开发板选型；
3. CAN Physical Layer；
4. CAN Communication Matrix V1；
5. Fault List V1；
6. FreeRTOS Task Architecture V1。

除上述问题之外，其余尚未确定的高级技术细节不阻止项目启动。
