Ben-nevis2006/stm32-freertos-dual-ecu-can-diagnostics/evidence/software/H3/2026-10-09/README.md

# H3 软件证据：2026-10-09

本目录保存 H3-03 Node B NTC 重复性 Run02，以及同日随后开展的 H3-04 旧固件边界表征。所有时间均为 Asia/Shanghai；文件名与正文保留实际日期，不与 2026-10-08 的基线/Run01 或 2026-10-10 的阈值实现后验收合并伪装为同日操作。

## Run02：自行计时 30 秒加温—自然恢复

执行人只以手指接触封装后的 NTC 珠体，并自行计时 30 秒后主动松手；未使用通电加热器、热风、烙铁或 12 V。主采集在打开 COM8 后清空主机旧缓存，保留 351 条连续 H3 报告；随后追加 88 条完全不触碰的恢复尾段。

| 指标 | 结果 | 判定 |
|---|---:|---|
| 主采集跨度 | 主机 `359.087 s`；设备 tick `359.100 s` | 连续 |
| H3 / `samples` / `fail` | `351`；`480→3980`；`0→0` | PASS |
| 相邻 tick / samples 增量 | 全部 `1026 ms / 10` | PASS |
| 加温前配对 30 条均值 | raw=`1830.867`、`1475.033 mV nominal`、`12256.833 Ω` | 记录凌晨环境工作点 |
| 首次 10 条 rolling median 越阈 | `1949.5`，冻结阈值 `1921` | PASS |
| 最大 rolling median | `2396` | 持续响应，不是单点尖峰 |
| 峰值 | raw=`2415`、`1946 mV nominal`、`6894 Ω` | raw 上升、阻值下降，方向正确 |
| 首个恢复 30 条窗口 | `00:43:47–00:44:16`，raw 均值 `1889.667` | 落入冻结区间 `1839～1891`，PASS |
| 恢复延长段 | `88` 条；最终 30 条 raw 均值 `1825.767` | 相对本轮加温前配对均值仅 `-5.100`（`-0.279%`） |
| 状态字段 | 全部 `cal=0 / ready=1 / calc_valid=1 / fail=0 / last=0` | PASS |

Run02 再次观察到升温时 raw/名义电压上升、反算 NTC 阻值下降，且自然恢复后完整 30 条均值进入预先冻结的区间，因此与 Run01 共同满足“趋势可重复”。H3-03 于 2026-10-09 判定 **PASS**。

必须保留的边界：30 秒接触时长来自执行人自行计时，不是独立接触传感器测得；凌晨的未加温工作点低于 2026-10-08 晚间基线，恢复延长段也稳定在较低工作点。该变化按环境/热平衡语境记录，不能据此声称绝对温度精度，也不能删除扩展段中低于旧绝对包络的数据。一次在 2026-10-08 发生的初步 Run02 因助手额度暂停而缺失完整恢复段，已排除出 PASS 证据，不解释为硬件故障。

逐行记录见 [`H3_NODE-B_NTC_warm-recovery_20261009_run02.txt`](H3_NODE-B_NTC_warm-recovery_20261009_run02.txt)；未触碰恢复尾段见 [`H3_NODE-B_NTC_warm-recovery_20261009_run02_recovery-extension.txt`](H3_NODE-B_NTC_warm-recovery_20261009_run02_recovery-extension.txt)；受控统计及逐项判据见 [`H3_NODE-B_NTC_warm-recovery_20261009_run02_summary.txt`](H3_NODE-B_NTC_warm-recovery_20261009_run02_summary.txt)。

## H3-04：旧固件边界表征

H3-03 关闭后，先用当时尚未包含 `ntc_state` 的固件采集真实边界样本。开路只断开 NTC 上端 `T`，A0 与约 9.93 kΩ 下拉保持连接；短路只用 `T-S` 旁路 NTC，电流仍由下臂电阻限制在约 `0.33 mA`，不是 3V3-GND 硬短路。

| 实际时间 | 状态 | H3 条数 / 跨度 | 当前 raw | 旧固件表现 | 当日结论 |
|---|---|---:|---:|---|---|
| `17:55:12～17:56:11` | `T` 上支路开路 | `59 / 59.448 s` | `0～17`，均值 `1.03` | `calc_valid` 在 `0/1` 间变化，缺少显式故障态 | 取得 OPEN 样本，不提前判完整 PASS |
| `18:13:40～18:14:39` | 原始接线恢复 | `58 / 58.480 s` | `1843～1902`，均值 `1872.21` | 全部 `calc_valid=1`、`fail=0` | 证明第一次刺激可恢复 |
| `18:20:22～18:21:21` | `T-S` 旁路 NTC | `58 / 58.423 s` | `3990～4095`，均值 `4088.22` | 仍按普通阻值换算，缺少显式 SHORT 态 | 取得 SHORT 样本，不提前判完整 PASS |
| `18:32:59～18:33:59` | 再次恢复原始接线 | `59 / 59.506 s` | `1839～1896`，均值 `1865.10` | 全部 `calc_valid=1`、`fail=0` | 证明第二次刺激可恢复 |

该序列证明两个边界在当前台架上可重复区分，也暴露旧逻辑“只要 raw 非零就继续换算”的缺口。阈值和显式三态在 2026-10-10 实现、构建、刷写并重新注入验证，因此本日只记录**表征完成**，不把次日的 H3-04 PASS 回填成 10 月 9 日已经完成。

### 在路阻值排查边界

边界操作期间还观察到断电在路 `S-G` 约 `5～6 kΩ`、`T-S` 约 `6.46 kΩ` 等低于元件标称的读数。逐支路隔离后：

- `T` 与 `A0` 都断开时，`S-G=9.93 kΩ`，固定电阻正常；
- 仅断开 `A0` 时，`S-G≈6.2 kΩ`；仅断开 `T` 时，`S-G≈5.6 kΩ`；
- `T-S` 在两支路都断开时约 `11.49 kΩ`，只断 A0 时约 `6.36 kΩ`。

因此低读数来自未上电 MCU 的 ADC/电源/保护路径与元件形成并联网络，不能把在路等效阻值直接当作单只 NTC 或固定电阻的失效判据。该结论来自隔离前后对照，不依赖对板内单一电流路径的猜测。

## 证据文件完整性

| 文件 | SHA-256 |
|---|---|
| `H3_NODE-B_NTC_warm-recovery_20261009_run02.txt` | `A1F4B49A063ECE1396CB5D5FC4A8A0C90DB29382E35152E67C561550F5543FE0` |
| `H3_NODE-B_NTC_warm-recovery_20261009_run02_recovery-extension.txt` | `2AF6A6A7238E7165B1B7DF0DE8A30D0938BAE5AFDE37CF9A6375F3B37E7C685F` |
| `H3_NODE-B_NTC_warm-recovery_20261009_run02_summary.txt` | `916CF23C45D146B92C367603734579A2E7AFC07CBF89201DA87D6F143028A31B` |
| `H3_NODE-B_NTC_T-open_20261009_run01.txt` | `B70491772A6F6F111D11DD86B14E135F4A693BBE40573FF6CA1CDA63A69C61F8` |
| `H3_NODE-B_NTC_baseline-restored_20261009_run01.txt` | `F35460BFEB2BD3EC8AEF7730AA42189A3D20499D149C112C0A720BFFC2B3245B` |
| `H3_NODE-B_NTC_TS-bypass_20261009_run01.txt` | `100A30CE189DC513E6403C7F89AD075FCA3D1A79F450D0937A26791FF8CA7B1E` |
| `H3_NODE-B_NTC_final-recovery_20261009_run01.txt` | `DEA5E64EFDECF890566764FF48AC8EB6FC0B644E8AD71F2928B660AA67C529B7` |

以上哈希绑定仓库归档字节。原始串口记录未删点或平滑；归档文本采用仓库换行规范，因此临时采集文件与仓库文件的字节哈希不混用。
