Ben-nevis2006/stm32-freertos-dual-ecu-can-diagnostics/archive/Architecture_Synchronization_Record_2026-09-02.docx

# Architecture Synchronization Record

STM32 + FreeRTOS Dual-ECU CAN Project

Change Set: 2026-09-02 | Purpose: cross-document traceability

# 1. Decisions Frozen Today

Decision | Frozen conclusion | Affected artifacts
100 ms / 10 ms multi-rate semantics | 0x100 Cooling_Command 每 100 ms 更新；A_ControlTask 每 10 ms 保持最近 valid Demand 作为 reference，并使用新鲜 RPM/Current 继续本地控制。 | FreeRTOS Task Architecture；CAN Matrix；SAD
Scheduling / deadline semantics | Task priority 只在各自 ECU 内有效；低优先级 cyclic task 必须可调度并在 100 ms 正常窗口完成。300 ms 是通信 Fault 阈值，不是 task deadline。 | FreeRTOS Task Architecture；CAN Matrix；SAD
Timing verification | 后续实机必须记录 Task period、WCET/observed max、response time、jitter、timing margin；Fault Injection 覆盖 worst-path。 | FreeRTOS Task Architecture；SAD verification
IPC/data ownership | CAN RX ISR→FIFO (First In First Out，先进先出) Queue；latest runtime state→1-slot Mailbox；A_ControlTask 非阻塞读取/本地保持；v0.1 当前 0 Mutex。 | FreeRTOS Task Architecture；SAD
Diagnostic history boundary | Runtime Mailbox / 0x180 current Fault status 可更新，但 Confirmed/Escalated/Recovered event 不能因此丢失；stored history 单独设计。 | FreeRTOS Task Architecture；Fault List；CAN Matrix；SAD
Sensor acquisition boundary | 不新增 SensorTask；Temperature sensor 暂不冻结。NTC+ADC 为 v0.1 首选候选，I²C digital sensor 为备选，Hardware Selection 决策。 | FreeRTOS Task Architecture；SAD
Diagnostic Architecture timing | 日志字段、Freeze Frame、capacity、NVM (Non-Volatile Memory，非易失存储)、aging/clear、PC/UDS exposure 在 Hardware Selection 后的 Diagnostic Architecture v0.1 冻结。 | Fault List；SAD

# 2. Document Synchronization Result

Artifact | 2026-09-02 action | Status
System Architecture Definition v0.1 | 更新 Design Order、CAN/FreeRTOS downstream state、OI-09/OI-12/OI-13、Verification requirement 与 next steps。 | Revised
Fault List v0.1 | 保留 2026-08-27 CAN sync；补充 current state vs stored history、Diagnostic Architecture 冻结点与 verification traceability。 | Revised
CAN Matrix v0.1 | 增加 Sample-and-Hold / cyclic deadline / diagnostic-history boundary；ID/DLC/bit layout 不变。 | Revised; no layout change
CAN Matrix Design Decision Record | 追加 2026-09-02 synchronization note 与 downstream status。 | Revised
FreeRTOS Task Architecture v0.1 | 从 Working Baseline 更新为 architecture baseline，补齐 Task Matrix、IPC、timing、sensor boundary、diagnostic-history boundary。 | Revised
CAN Matrix v0.1.xlsx | 仅同步 Supervision notes；Message / Signal packing 不改变。 | Revised
SRS v0.1 | 本轮没有改变 system requirement / external behavior，不修改。 | No change

# 3. Explicitly Not Frozen

- Numeric FreeRTOS priority values and measured execution budgets / WCET.
- Thermal Plant concrete implementation and final Temperature Sensor choice.
- FA/FB calibration thresholds, debounce/recovery times not already frozen by CAN supervision.
- Local Conservative Cooling Demand value and RPM_MIN_RUN / RPM_MAX.
- Diagnostic event fields, Freeze Frame contents, log capacity, NVM (Non-Volatile Memory，非易失存储) persistence, aging/clear and PC/UDS interface.

STM32 + FreeRTOS Dual-ECU CAN Project | Architecture Synchronization Record | 2026-09-02
