Ben-nevis2006/stm32-freertos-dual-ecu-can-diagnostics/archive/README.md

# 历史版本 / Archive

本目录保存已归档、已被替代或仅具历史参考价值的旧版文档，不作为当前设计与验收依据。当前有效版本统一从 [`current/`](../current/README.md) 进入。

历史文件名保持原样，以保护既有引用和版本追溯；中文译名在下表中补齐，不对旧文件做内容回写。

| 历史文件 | 中文译名 / 说明 |
|---|---|
| `Architecture_Synchronization_Record_2026-09-02.docx` | 架构同步记录（2026-09-02） |
| `CAN_Matrix_v0.1_Design_Decision_Record.docx` | CAN 矩阵 v0.1 设计决策记录 |
| `CAN_Matrix_v0.1_PreDesign_Decision_Record.docx` | CAN 矩阵 v0.1 设计前决策记录 |
| `CAN_Matrix_v0.1.docx` | CAN 矩阵 v0.1（Word） |
| `CAN_Matrix_v0.1.xlsx` | CAN 矩阵 v0.1（Excel） |
| `Fault_List_v0.1.docx` | 故障清单 v0.1 |
| `FreeRTOS_Task_Architecture_v0.1_Working_Baseline.docx` | FreeRTOS 任务架构 v0.1 工作基线 |
| `Hardware_Selection_v0.1_Working_Baseline_2026-09-04.docx` | 硬件选型 v0.1 工作基线（2026-09-04） |
| `Hardware_Selection_v0.1_Working_Baseline_2026-09-06.docx` | 硬件选型 v0.1 工作基线（2026-09-06） |
| `project charter.docx` | 项目章程（旧版，仅保留立项背景） |
| `system requirement specification v0.1.docx` | 系统需求规格说明书 v0.1 |
| `System_Architecture_Definition_v0.1.docx` | 系统架构定义 v0.1 |
| `概念澄清.txt` | 概念澄清记录 |
