Ben-nevis2006/stm32-freertos-dual-ecu-can-diagnostics/evidence/hardware/H0/2026-09-24/H0_METER-01_lead-short_0R3_20260924_01.jpg

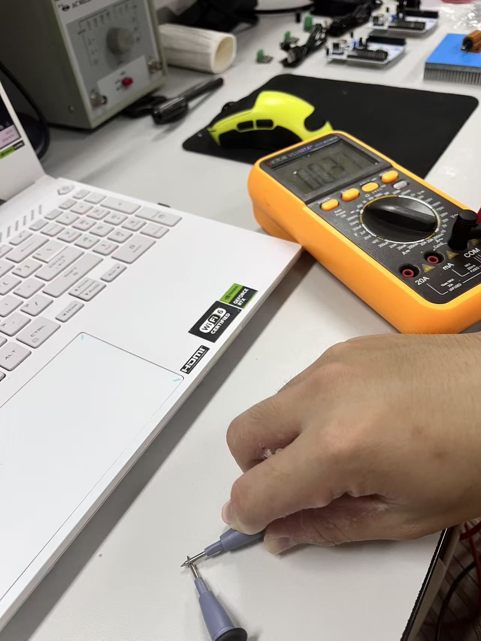
evidence/hardware/H0/2026-09-24/H0_METER-01_lead-short_0R3_20260924_01.jpg
