Ben-nevis2006/stm32-freertos-dual-ecu-can-diagnostics/evidence/hardware/H0/2026-10-01/H0_CANPAL-01_back_20261001_01.jpg

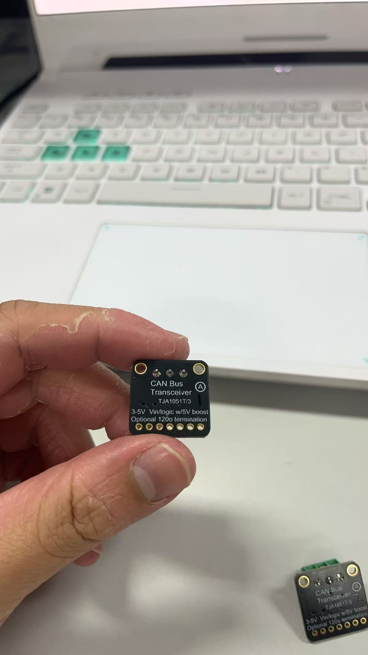
evidence/hardware/H0/2026-10-01/H0_CANPAL-01_back_20261001_01.jpg
