Ben-nevis2006/stm32-freertos-dual-ecu-can-diagnostics/evidence/hardware/H0/2026-10-02/H0_CANPAL-02_chip-top-unreadable_20261002_01.jpg

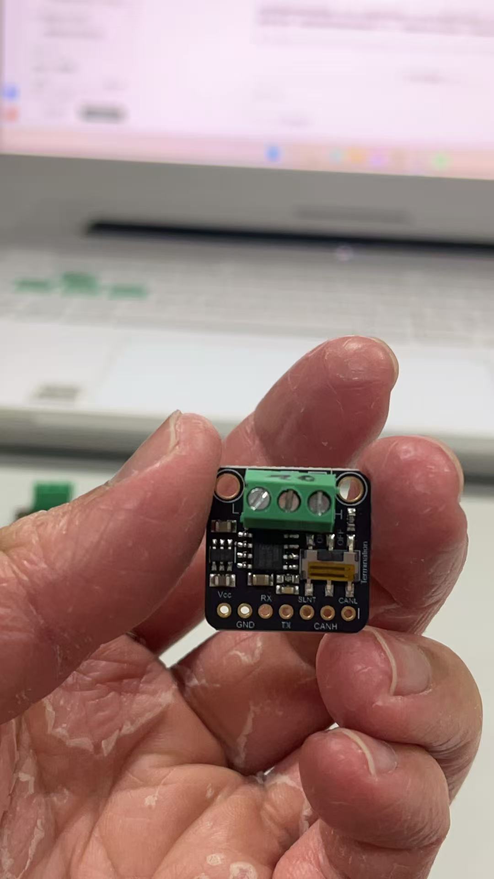
evidence/hardware/H0/2026-10-02/H0_CANPAL-02_chip-top-unreadable_20261002_01.jpg
