Ben-nevis2006/stm32-freertos-dual-ecu-can-diagnostics/evidence/hardware/H1/2026-09-27/H1_NUCLEO-01_powered-leds_20260927_01.jpg

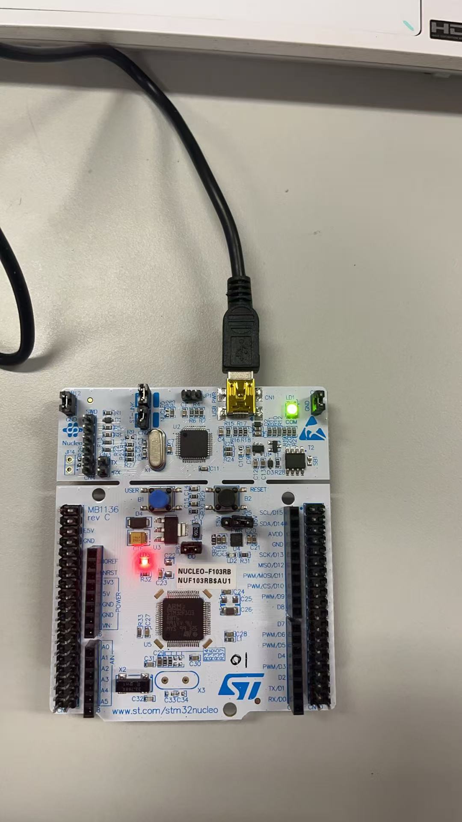
evidence/hardware/H1/2026-09-27/H1_NUCLEO-01_powered-leds_20260927_01.jpg
