Ben-nevis2006/stm32-freertos-dual-ecu-can-diagnostics/evidence/hardware/H1/2026-09-29/H1_tool_cubeprogrammer-about_20260929_01.png

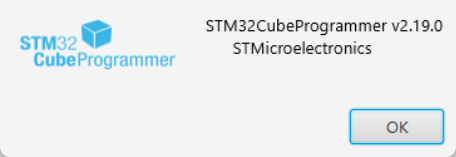
evidence/hardware/H1/2026-09-29/H1_tool_cubeprogrammer-about_20260929_01.png
