Ben-nevis2006/stm32-freertos-dual-ecu-can-diagnostics/evidence/hardware/H1/2026-10-01/H1_NUCLEO-02_cubeprogrammer-probe-panel_20261001_01.png

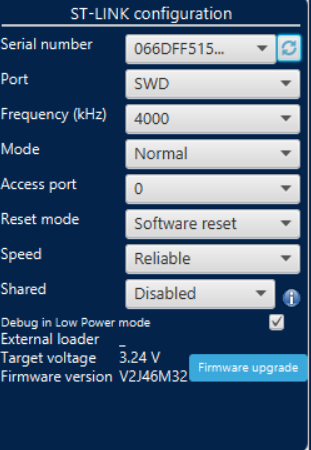
evidence/hardware/H1/2026-10-01/H1_NUCLEO-02_cubeprogrammer-probe-panel_20261001_01.png
