Ben-nevis2006/stm32-freertos-dual-ecu-can-diagnostics/evidence/hardware/H2/2026-10-03/H2_NODE-A_CANPAL-01_Vcc-3V288_20261003_01.jpg

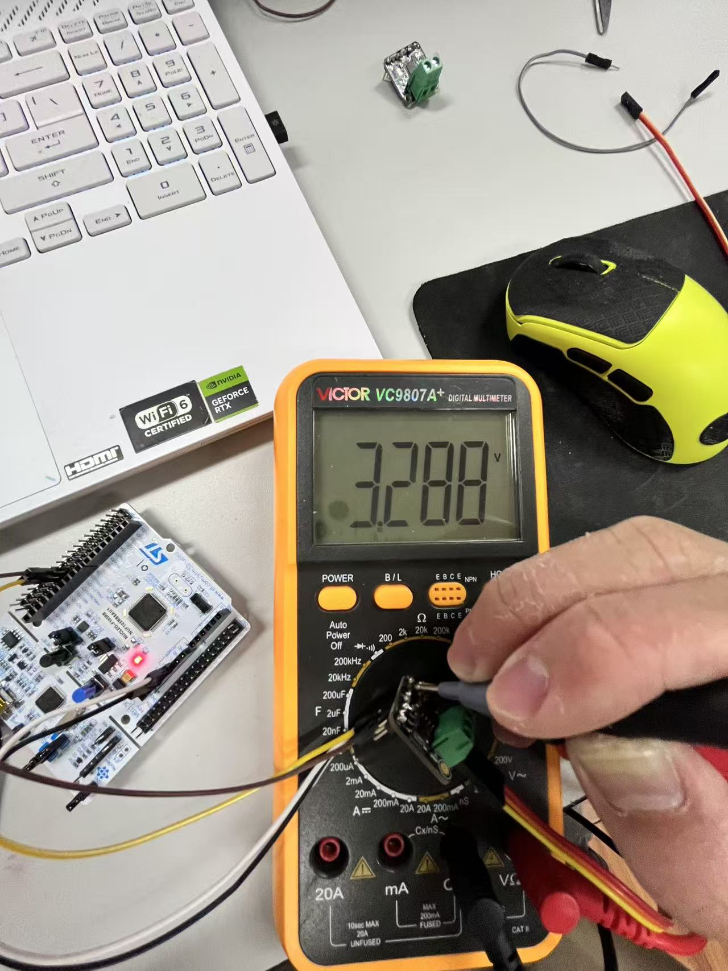
evidence/hardware/H2/2026-10-03/H2_NODE-A_CANPAL-01_Vcc-3V288_20261003_01.jpg
