Ben-nevis2006/stm32-freertos-dual-ecu-can-diagnostics/evidence/hardware/H3/2026-10-07/H3_NTC-01_R10K-01_passive-divider-overview_20261007_01.jpg

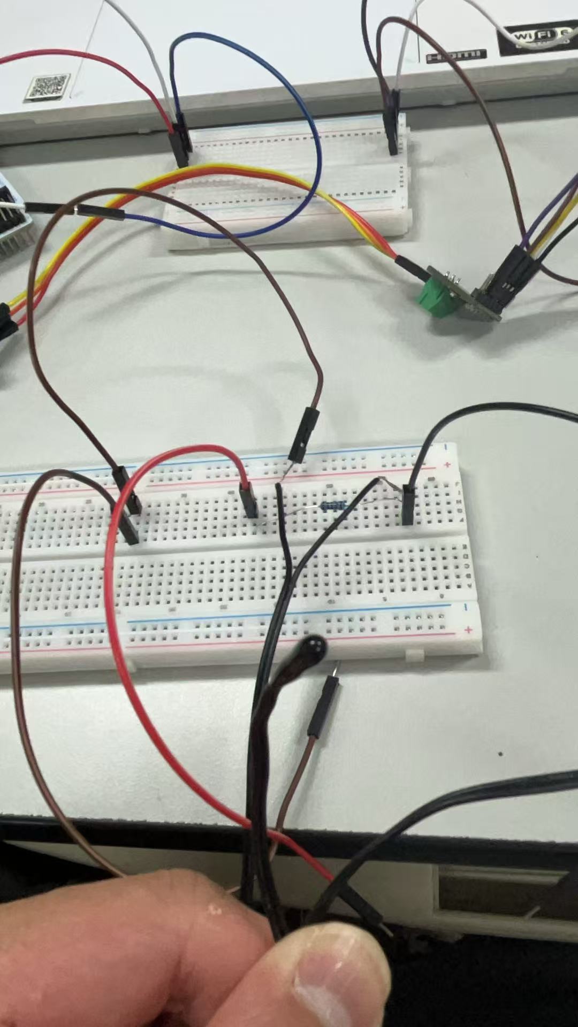
evidence/hardware/H3/2026-10-07/H3_NTC-01_R10K-01_passive-divider-overview_20261007_01.jpg
