Ben-nevis2006/stm32-freertos-dual-ecu-can-diagnostics/evidence/hardware/H3/2026-10-08/H3_NODE-B_NTC-divider-prepower-board_20261008_01.jpg

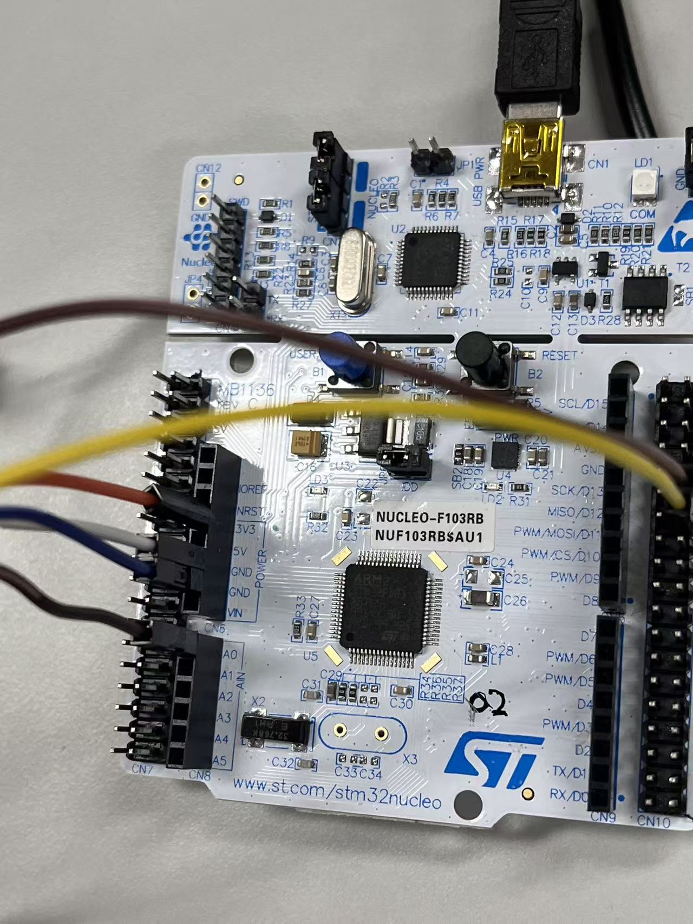
evidence/hardware/H3/2026-10-08/H3_NODE-B_NTC-divider-prepower-board_20261008_01.jpg
