Ben-nevis2006/stm32-freertos-dual-ecu-can-diagnostics/evidence/hardware/H3/2026-10-10/H3_FAN-01_main-and-PST-connectors_20261010_01.jpg

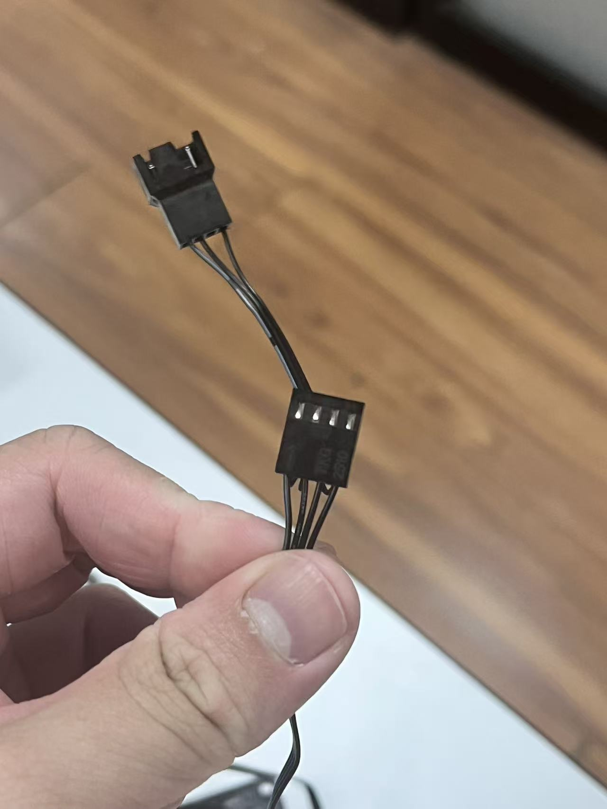
evidence/hardware/H3/2026-10-10/H3_FAN-01_main-and-PST-connectors_20261010_01.jpg
