Ben-nevis2006/stm32-freertos-dual-ecu-can-diagnostics/evidence/hardware/H3/2026-10-14/H3_NODE-A_TACH-00E_routing-separated-pwm-coupling_20261014_02.jpg

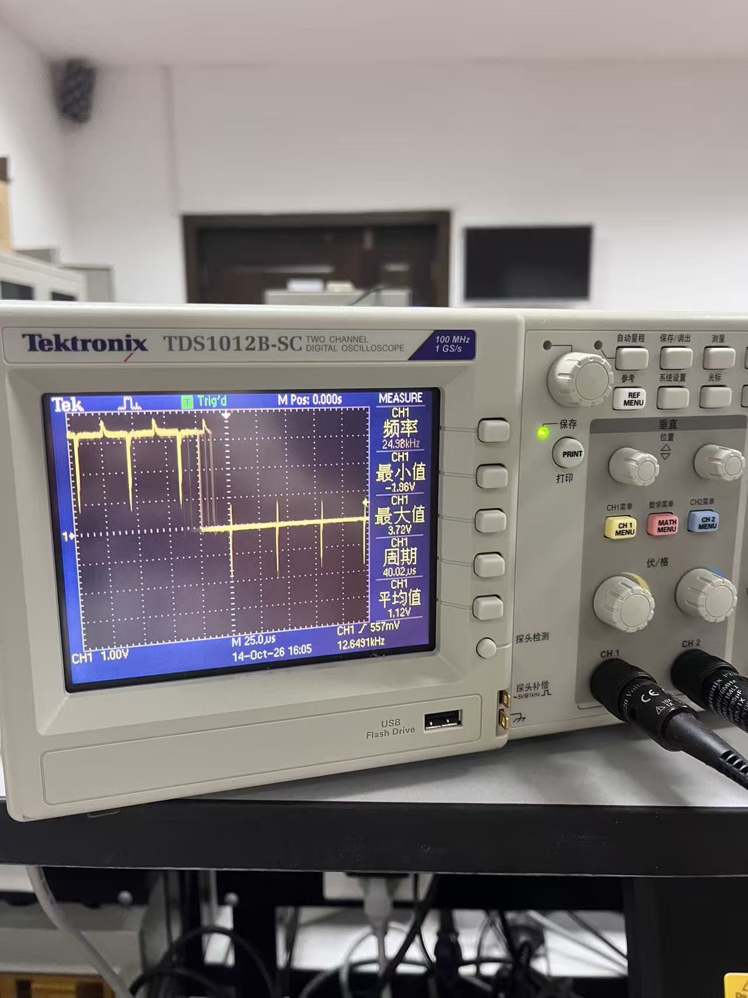
evidence/hardware/H3/2026-10-14/H3_NODE-A_TACH-00E_routing-separated-pwm-coupling_20261014_02.jpg
