Ben-nevis2006/stm32-freertos-dual-ecu-can-diagnostics/evidence/hardware/H3/2026-10-20/H3_NODE-A_INA-02D_reset-activity-single-trigger_20261020_02.jpg

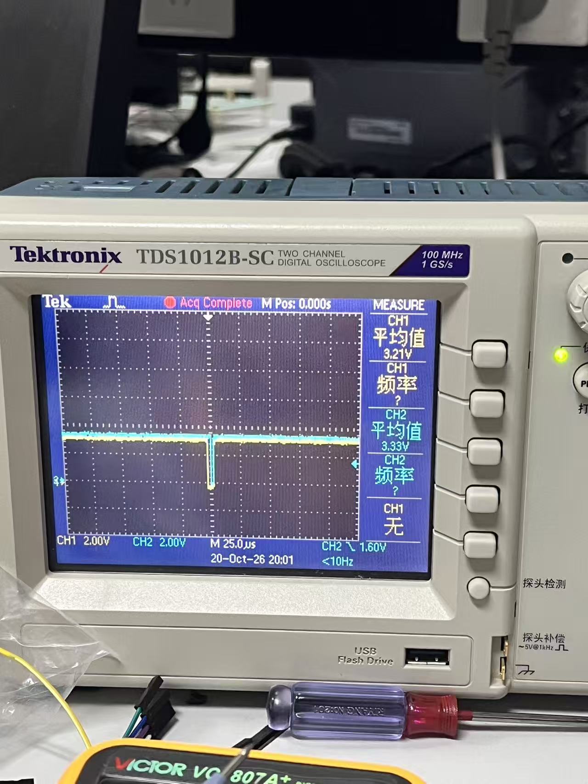
evidence/hardware/H3/2026-10-20/H3_NODE-A_INA-02D_reset-activity-single-trigger_20261020_02.jpg
