Ben-nevis2006/stm32-freertos-dual-ecu-can-diagnostics/evidence/hardware/H3/2026-10-20/H3_NODE-A_INA-02E_b1-probe-breadboard-nack_20261020_01.jpg

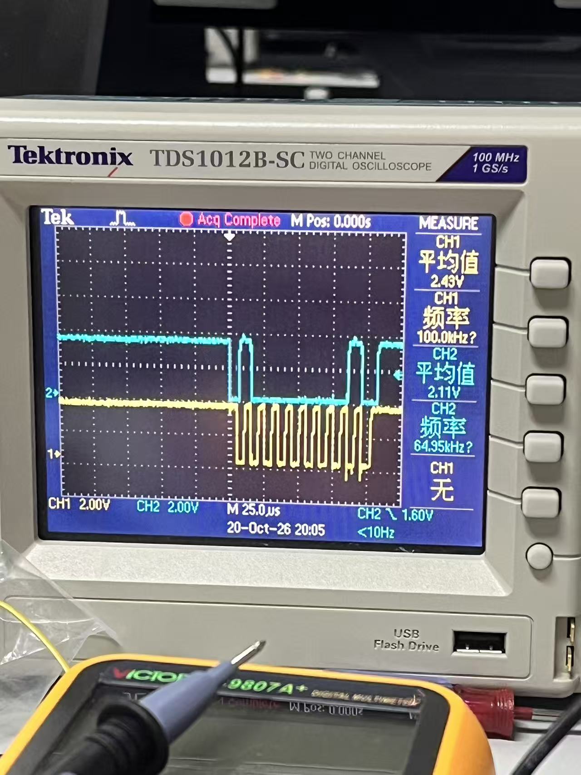
evidence/hardware/H3/2026-10-20/H3_NODE-A_INA-02E_b1-probe-breadboard-nack_20261020_01.jpg
