Ben-nevis2006/stm32-freertos-dual-ecu-can-diagnostics/evidence/software/H3/2026-10-14/H3_NODE-A_TACH-01A_raw-capture-build_20261014.txt

H3 / TACH-01A Node A 原始 Tach 输入捕获构建记录
================================================

准备日期：2026-10-14（Asia/Shanghai）
代码基线：4095e38 test: validate H3 tach PA0 input load
目标：firmware/node_a/Debug/node_a.elf
状态：离线构建与静态复核通过；尚未刷写、尚未形成实板捕获结论

1. 本轮目的与约束
-----------------

TACH-00G 已关闭 PA0 接入前的低压电气门禁。本轮只启动 TIM2_CH1 的下降沿中断捕获，
把原始周期证据输出到 USART2；不预填风扇 PPR，不计算或上报 RPM，也不把捕获结果接入
故障判定、CAN 状态位或温控闭环。

现有硬件 RC 继续冻结为 F3 raw 后串联 10 kΩ、PA0 节点对地 10 nF。TIM2 输入数字滤波
本轮保持 ICFilter=0，目的是先验证已经实测通过的硬件 RC 是否能让 MCU 获得与示波器
一致的边沿计数；数字滤波留给后续独立门禁，避免同时改变两个变量。

2. 实现摘要
-----------

- main.c 在 TIM3 PWM 启动后调用 HAL_TIM_IC_Start_IT(TIM2, CH1)，失败即进入既有
  Error_Handler；
- TIM2 保持下降沿、PSC=639、ARR=65535，64 MHz 定时器时钟得到 100 kHz 计数频率，
  每 tick=10 us；
- HAL_TIM_IC_CaptureCallback 只读取捕获值并更新累计边沿、相邻周期、窗口最小/最大值、
  零差值计数和最后边沿时间；ISR 不做串口输出、PPR/RPM 换算或故障判定；
- 16-bit 捕获差使用模 65536 减法，可覆盖当前约 22 ms 的风扇运行周期以及一次计数器
  回绕；单周期超过 655.35 ms 的停转/极低速场景不属于本构建的有效周期范围；
- A_ControlTask 每秒在短临界区内取得快照并清空窗口统计，再输出 TACH_RAW 日志；
- 日志明确携带 ppr=TBD、rpm=INVALID，避免把原始 Hz 误写成 RPM。

新增启动身份行：

  H3,A,TACH_CAPTURE_PROFILE,pin=PA0,timer=TIM2_CH1,edge=falling,
  timer_hz=100000,tick_us=10,ic_filter=0,rc=10k_series_10nF_gnd,
  ppr=TBD,rpm=INVALID

新增周期状态行字段：

  H3,A,TACH_RAW,tick=...,state=...,edge_total=...,sample_total=...,
  window_samples=...,last_ticks=...,last_us=...,freq_mHz=...,
  window_min_ticks=...,window_max_ticks=...,zero_delta=...,age_ms=...,
  ppr=TBD,rpm=INVALID

3. 构建与静态核验
-----------------

工具链：STM32CubeIDE 2.2.0 bundled GNU Tools for STM32 14.3.rel1
构建方式：生成的 Debug Makefile，单线程 clean + all
结果：退出码 0；未观察到编译或链接警告/错误

arm-none-eabi-size：

  text=36128
  data=100
  bss=14036
  dec=50264

ELF：

  path=firmware/node_a/Debug/node_a.elf
  size=1102084 bytes
  sha256=0ED42C02BBE2AC79CF08589F5560ECE0C612A4D2869642B473C4FC7C7FFA954C

链接符号与字符串复核：

  - H3_LogTachCaptureProfile：已链接；
  - H3_LogTachRaw：已链接；
  - HAL_TIM_IC_CaptureCallback：已链接；
  - TACH_CAPTURE_PROFILE / TACH_RAW / ppr=TBD / rpm=INVALID：均在 ELF 中检出。

静态栈记录：

  H3_LogTachCaptureProfile=248 bytes
  H3_LogTachRaw=456 bytes
  HAL_TIM_IC_CaptureCallback=24 bytes
  StartAControlTask=32 bytes

A_ControlTask 配置栈为 2048 bytes；最大新增单函数静态记录为 456 bytes，且日志函数顺序
调用，不与 H2_LogStatus 的局部缓冲区叠加。TIM2 IRQ 优先级为 6，FreeRTOS 最大系统调用
优先级边界为 5；ISR 不调用 RTOS API，任务快照临界区能够屏蔽该 IRQ 后再复位窗口统计。

4. 下一实板门禁
---------------

刷写前保持风扇 12 V 断电、RC 与 A0 接线不变，只连接 Node A USB。按冻结序列号定向刷写
本记录绑定的 ELF 后，先验证无风扇供电时 TACH_RAW 保持 WAIT_FIRST_EDGE / edge_total=0；
再给风扇 12 V 上电，在默认 50% PWM 下比较 UART last_us/freq_mHz 与示波器约
21.85 ms / 45.77 Hz。通过条件至少包括：周期进入 PERIOD_VALID，窗口计数与约 46 Hz
一致，zero_delta=0，无数量级异常的短周期，USB 无断连，既有 H2 日志仍持续。

本记录不证明目标板已刷写、TIM2 实板捕获有效、PPR、RPM、数字滤波、停转检测、长期
稳定性或 Gate H3 整体完成。
