Ben-nevis2006/stm32-freertos-dual-ecu-can-diagnostics/evidence/hardware/H2/2026-10-02/H2_CANPAL-01-02_passive-bus-wiring_20261002_01.jpg

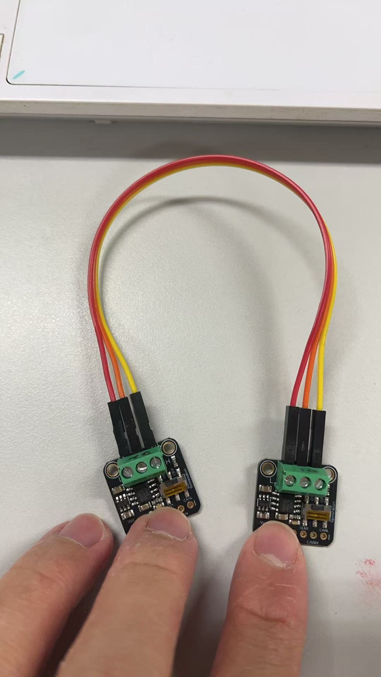
evidence/hardware/H2/2026-10-02/H2_CANPAL-01-02_passive-bus-wiring_20261002_01.jpg
