Ben-nevis2006/stm32-freertos-dual-ecu-can-diagnostics/evidence/hardware/H2/2026-10-04/H2_NODE-B_CANPAL-02-header-wiring_20261004_01.jpg

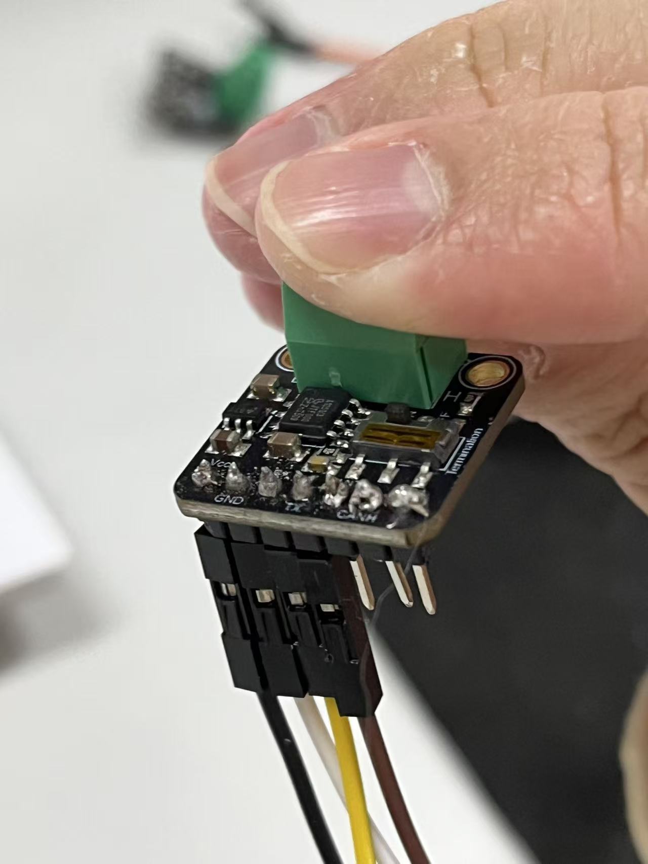
evidence/hardware/H2/2026-10-04/H2_NODE-B_CANPAL-02-header-wiring_20261004_01.jpg
