Ben-nevis2006/stm32-freertos-dual-ecu-can-diagnostics/current/05_verification_gates_验证与门禁/Gate_H3_Single_Peripheral_Validation_Execution_Record_H3单外设验证执行记录_2026-10-07.md

# Gate H3 单外设验证执行记录

## 1. 文档控制

| 项目 | 内容 |
|---|---|
| 版本 | v1.5（NTC、Fan PWM、Tach/PPR/RPM 已关闭；INA260-01 已由波形隔离和电脑复扫共同确认模块级无应答） |
| 日期 | 2026-10-07～2026-10-21 |
| 状态 | **IN PROGRESS / HARDWARE HOLD；NTC 子项 H3-00～H3-05 PASS；Fan PWM 子项 FAN-00A～FAN-02B PASS；Tach 子项 TACH-00B～TACH-02B PASS；INA-00A/00B 与 INA-01 离线构建 PASS；INA-02A～02C 低压准入 PASS；INA-02D～02F 已证明事务到达模块但全地址无 ACK；INA-02G 电脑端独立复扫再次得到全地址零 ACK，等待替换/修复 INA260 模块** |
| 前序 Gate | Gate H0 CONDITIONAL PASS；Gate H1 PASS；Gate H2 PASS（2026-10-07） |
| H3 开始时 Git HEAD | `b03c874 docs: organize active project records` |
| 固件回退基线 | `bc19580 feat: close Gate H2 CAN bring-up` |
| 当前准入范围 | Node B NTC、Node A Fan PWM 与 Tach/PPR/RPM/新鲜度子项均已完成。INA260-01 的四线 3.3 V 接入、主控状态、全地址扫描、面包板端/模块排针端波形和 A0/A1 地址网络已完成；结论为模块级无应答，不再授权同一模块的重复扫描或 12 V/负载接入。下一步只允许更换/独立修复模块后，从四线无源准入、静态电压、0x40 ACK、Manufacturer ID、Die ID 重新进入。Heater 继续隔离。CAN 0x180 正常链路属于 H5，FA-01/02/03 故障与恢复属于 H6，二者不作为 H3 关闭前置项 |
| 远端策略 | H3 阶段内按真实日期在本地累计；Gate 完成后统一整合、提交并推送一次。统一推送不改变各动作的实际日期 |
| 证据索引 | [`2026-10-07 搭建与照片`](../../evidence/hardware/H3/2026-10-07/README.md)；[`2026-10-08 硬件接线与电压预检`](../../evidence/hardware/H3/2026-10-08/README.md)；[`2026-10-08 H3-02、基线与 Run01`](../../evidence/software/H3/2026-10-08/README.md)；[`2026-10-09 Run02 与边界表征`](../../evidence/software/H3/2026-10-09/README.md)；[`2026-10-10 边界实现与验收`](../../evidence/software/H3/2026-10-10/README.md)；[`2026-10-10 FAN 身份/接口`](../../evidence/hardware/H3/2026-10-10/README.md)；[`2026-10-12 FAN 供电/接口实测`](../../evidence/hardware/H3/2026-10-12/README.md)；[`2026-10-12 FAN-01/FAN-02B 构建`](../../evidence/software/H3/2026-10-12/README.md)；[`2026-10-13 FAN-02B 刷写与运行身份`](../../evidence/software/H3/2026-10-13/README.md)；[`2026-10-13 FAN-02B 低压动态波形`](../../evidence/hardware/H3/2026-10-13/README.md)；[`2026-10-14 Tach 电气表征与 PWM 耦合隔离`](../../evidence/hardware/H3/2026-10-14/README.md)；[`2026-10-19 Tach 捕获失败证据`](../../evidence/software/H3/2026-10-19/README.md)；[`2026-10-20 Tach/INA260 软件证据与 NACK 隔离记录`](../../evidence/software/H3/2026-10-20/README.md)；[`2026-10-20 INA260 实物、波形与地址网络`](../../evidence/hardware/H3/2026-10-20/README.md)；[`2026-10-21 INA260 电脑端复位复扫`](../../evidence/software/H3/2026-10-21/README.md) |

## 2. Gate 目标与边界

Gate H3 按“一次只增加一个外设”的原则，依次建立 NTC、Fan PWM、Tach/PPR 和 INA260 的独立输入/输出证据。每个外设必须能靠自己的连接照片、原始测量或结构化日志判断成败，不能依赖完整温控闭环才能验收。

H3 的第一个对象固定为 Node B NTC 低压采集链。当前步骤 H3-00 只完成准入审计、接线方向、换算公式、安全边界和证据规则冻结；不接线、不通电、不修改或刷写固件。

## 3. H3-00 准入审计

| 输入 | 已有事实 | H3-00 判定 |
|---|---|---|
| H2 回退基线 | H2 已通过 500 kbit/s 双向正式帧、受控断线和恢复；关闭提交为 `bc19580` | PASS；H3 改动不得覆盖该回退点 |
| NTC-01 | H0 室温单点实测约 `10.30 kΩ` | PASS（约 10 kΩ 身份）；**不能据单点证明 B3950** |
| R10K-01 | H0 复测 `9.911 kΩ`，属于 10 kΩ ±1% 名义带 | PASS；H3 换算使用实测筛查值 `9911 Ω` |
| Node B ADC 资源 | `ADC1_IN0 / PA0 / A0 / CN7-28`，软件触发、右对齐、55.5 cycles、单通道、无 DMA | PASS；源码和 `.ioc` 一致 |
| ADC 时钟 | PCLK2/6，约 `10.67 MHz` | PASS；低于 STM32F103 ADC 14 MHz 上限 |
| ADC 业务实现 | `MX_ADC1_Init()` 已存在；校准、启动、轮询、换算和日志尚未实现 | EXPECTED GAP；属于 H3 后续实现内容 |
| H0 D-02 | NTC/R10K 已完成 H0 筛查；Fan、INA260、散热器和部分辅材仍有各自证据缺口 | 不阻止 NTC；继续阻止对应未关闭外设接入 |
| H0 D-04 | 12 V 适配器连续稳定性记录缺失 | 不阻止纯 USB/3.3 V NTC；继续禁止全部 12 V 动作 |

结论：**Node B NTC 是当前唯一被 H3-00 放行的新增外设。** Fan、INA260、Heater 和 12 V 功率链不随本次放行。

## 4. 冻结的 NTC 电气拓扑

### 4.1 接线定义

```text
Node B 3V3 ---- NTC-01 ----+---- Node B A0 / CN7-28 / PA0 / ADC1_IN0
                           |
                       R10K-01
                        9.911 kΩ
                           |
Node B GND ----------------+
```

冻结规则：

1. `NTC-01` 位于分压上臂，连接 `3V3` 与 ADC 测量点；
2. `R10K-01` 位于分压下臂，连接 ADC 测量点与同一块 Node B 的 `GND`；
3. ADC 测量点只连接 Node B 的 `A0 / CN7-28 / PA0`；
4. NTC 和固定电阻均无极性，但三个网络 `3V3 / A0 / GND` 不可互换；
5. 禁止使用 `5V`、`VIN` 或任何 `12 V` 节点；
6. 初次验证不并联滤波电容，不同时接入 INA260、Fan、Heater 或其他新外设；
7. 已通过的 H2 CAN 线束若保留，H3-NTC 期间不得改动；它只能作为既有回归基线，不能替代 NTC 自身证据。

### 4.2 冻结理由

该方向使温度升高时 `R_NTC` 下降、`V_ADC` 和 `ADC_raw` 上升，便于现场观察和日志复核。NTC 上支路开路时，测量点由 `R10K-01` 拉向 GND；NTC 被短接时，测量点趋近 3.3 V。软件仍必须先做信号有效性判断，再允许温度值进入控制或 Fault 逻辑。

注意：若断开的是 `A0` 跳线而不是 NTC 上支路，MCU 引脚会悬空，读数可能不确定；不能把“A0 线断开”机械等同于“NTC 开路约 0 V”。该场景后续必须单独验证或由 frozen/stuck plausibility 覆盖。

## 5. 冻结的换算模型

### 5.1 ADC 与电压

12-bit ADC 的记录模型为：

```text
V_ADC = ADC_raw / 4095 × V_DDA
```

`V_DDA` 使用实测值时必须记录测量方法和时间；使用 `3.3 V` 名义值时，日志和报告必须明确标记为 nominal/configured，不得描述为实测电压。

### 5.2 电压与 NTC 阻值

对本文件冻结的“NTC 上拉、固定电阻下拉”拓扑：

```text
V_ADC = V_DDA × R_FIXED / (R_NTC + R_FIXED)

R_NTC = R_FIXED × (V_DDA / V_ADC - 1)
      = R_FIXED × (4095 - ADC_raw) / ADC_raw
```

初始使用：

```text
R_FIXED = 9911 Ω     // H0 筛查实测值
```

当 `ADC_raw` 接近 0 或 4095 时，不执行普通除法换算，应先进入边界/故障分支。具体 raw 阈值不在 H3-00 凭空设定，待 H3 实测噪声、供电和开短路样本后冻结。

### 5.3 阻值与温度

初始温度模型采用 Beta 方程：

```text
T_K = 1 / (1 / 298.15 + ln(R_NTC / 10000) / 3950)
T_C = T_K - 273.15
```

其中 `R0=10 kΩ @ 25°C`、`B=3950 K` 来自采购规格，尚未由多温点实测独立证明。因此 H3 初期输出应写为 `temp_nominal_c` 或等价名称；在没有参考温度计和多温点标定前，只验收趋势、合理性和故障边界，不宣称绝对温度精度。

### 5.4 计算锚点（仅用于接线前 sanity check）

| 输入假设 | 预期比值/结果 | 证据边界 |
|---|---|---|
| `R_NTC=10.30 kΩ`、`R_FIXED=9.911 kΩ` | `V_ADC/V_DDA≈0.4904`；若 `V_DDA=3.3 V`，约 `1.618 V`、raw≈`2008` | 规划锚点，不是现场通过区间 |
| `R_NTC=10.00 kΩ`、`R_FIXED=9.911 kΩ` | `V_ADC/V_DDA≈0.4978`；若 `V_DDA=3.3 V`，约 `1.643 V`、raw≈`2038` | 规划锚点，不是现场通过区间 |
| NTC 上支路开路、A0 仍连接 | 测量点趋近 `0 V`、raw 趋近 `0` | 后续必须实测噪声后再定阈值 |
| NTC 短接 | 测量点趋近 `V_DDA`、raw 趋近 `4095` | 后续必须实测噪声后再定阈值 |

## 6. H3-NTC 后续执行顺序

| 步骤 | 动作 | 通过条件 | 当前状态 |
|---|---|---|---|
| H3-00 | 准入审计、回退点、拓扑、公式、安全边界和证据规则冻结 | 所有定义可由现有文件和源码复核；没有接线或带电动作 | **PASS** |
| H3-01 | 全断电工作台复位；离板搭建分压；核对 NTC、固定电阻和三条网络；无源测量 | 端到端及分段阻值与元件实测一致；轻微扰动无跳变/开路；无短路、无 12 V | **PASS（2026-10-08）** |
| H3-02 | 将分压接至 Node B；实现 ADC 校准、100 ms 采样和结构化日志；构建、定向刷写 | 构建 0 errors/0 warnings；校准和采样可观察；身份无误 | **PASS（2026-10-08）** |
| H3-03 | 室温静置、手指安全加温及自然恢复 | raw、电压、阻值、名义温度趋势一致且可重复 | **PASS（2026-10-09）** |
| H3-04 | 受控开路/短路或已知替代电阻验证 | 边界稳定可识别；无复位、USB 异常或危险刺激 | **PASS（2026-10-10）** |
| H3-05 | 关闭 NTC 子项并形成独立证据包 | 原始日志、连接照片、构建哈希和结论边界齐全 | **PASS（2026-10-10）** |

### 6.1 H3-01 无源阻值结果（2026-10-07）

执行人在两块 NUCLEO 和全部 12 V 均断开的状态下，将 NTC-01 与 R10K-01 在板外串联，并在 NTC 焊接余热/手持温升消退后复测：

| 测量路径 | 实测值 | 解释 |
|---|---:|---|
| `T-S`（NTC-01） | `11.4 kΩ` | 室温/器件温度未用参考温度计记录，只支持当前时刻阻值与连续性 |
| `S-G`（R10K-01） | `9.93 kΩ` | 与 H0 的 `9.911 kΩ` 筛查值一致 |
| `T-G`（串联总值） | `21.16 kΩ` | 与两个分段之和 `21.33 kΩ` 相差 `0.17 kΩ`，约 `0.8%` |

NTC 在刚焊接和手持后曾从约 `8.9 kΩ` 缓慢回升；隔离测量后稳定在 `11.4 kΩ`。该方向符合负温度系数器件受热阻值下降、冷却阻值回升的预期。当前数据未显示开路或低阻短路，串联总值也与分段值一致。由于环境温度、万用表校准状态和同步测量均未记录，本结果不能用于证明 B3950 或绝对温度精度。

执行人说明：为便于插入面包板，已剥开一小段绝缘并在细软引线上补锡增加机械强度。锡和新增金属引线的普通串联电阻相对于约 10 kΩ 可忽略，但焊接热史、机械应力和焊点可靠性仍需通过断电近照与后续稳定性复测留痕。因此 H3-01 的无源电气子项判定为 **PASS**，视觉/机械子项保持 **PENDING**，未放行接入 Node B。

板外搭建总览已归档为 `H3_NTC-01_R10K-01_passive-divider-overview_20261007_01.jpg`。照片支持“面包板上存在 NTC、固定电阻和三根测量引出线，且拍摄时未连接 Node B 电源”的现场状态；由于取景较宽、线束遮挡和插孔细节有限，不能仅凭该图确认三个节点的同排关系、补锡处无桥连或细引线在杜邦母座内的夹持可靠性。视觉/机械子项继续保持 PENDING。

随后补充的近照 `H3_NTC-01_R10K-01_passive-divider-closeup_20261007_01.jpg` 清楚显示固定电阻跨接于分离节点、NTC/转接引线与三个测量引出点，未见明显锡桥或相邻裸线互碰。视觉子项据此判定 **PASS**。照片不能证明杜邦母座内部接触在轻微受力时仍连续，因此机械稳定性仍需通过断电 `T-S` 阻值扰动测试确认；三根引出线的 `T/S/G` 颜色映射也必须在接板前记录。

### 6.2 H3-01 机械稳定性与关闭（2026-10-08）

执行人在持续断电状态下对 NTC 转接母座、面包板连接点和测量引线进行轻微扰动，并观察电阻档：读数正常、无阶跃跳变、无瞬时 `OL`，因此补锡引线与母座转接在本次静态台架条件下具备可用连续性。该结论不等同于振动、拉力或长期可靠性认证。

当万用表电阻档接入含 NTC 的路径后，读数出现平滑的十几欧下降；断续、跳变和开路均未出现。相对于约 `11.4 kΩ`，该变化约为 `0.1%` 量级，与万用表测试电流引起的轻微自热、手部/环境温度及仪表建立过程相符，不按接触故障处理。由于本次未记录万用表测试电流、NTC 耗散常数和同步温度，文件只记为“与热平衡效应一致”，不把自热写成唯一已证明原因。

执行人确认当时引出线映射如下：

| 网络 | 当时线色 | 风险说明 |
|---|---|---|
| `T`（NTC 上端，后续接 `3V3`） | 棕色 | 电气身份已由无源测量确认 |
| `S`（NTC/R10K 中点，后续接 `A0`） | 黑色（照片最右侧） | 黑色通常被理解为 GND，存在误插风险 |
| `G`（R10K 下端，后续接 `GND`） | 红色 | 红色通常被理解为电源，存在误插风险 |

据此，H3-01 于 **2026-10-08 PASS**。在 H3-02 接入 Node B 前仍设置一个操作性 HOLD：应在持续断电条件下把外部跳线规范为 `红=T/3V3、棕=S/A0、黑=G/GND`，或在两端加不可混淆的 `T/S/G` 标签，并重新完成三段阻值复核。该 HOLD 是防误接控制，不否定 H3-01 的无源电气结论。

### 6.3 H3-02 接板前线色规范化复核（2026-10-08）

执行人保持系统断电，将外部跳线规范为 `红=T/3V3、棕=S/A0、黑=G/GND`，静置隔夜后复测：

| 测量路径 | 实测值 | 复核结论 |
|---|---:|---|
| 红—棕（`T-S`，NTC-01） | `12.00 kΩ`，稳定 | 无跳变；相对前次 `11.4 kΩ` 的上升与隔夜冷却/环境热平衡方向一致 |
| 棕—黑（`S-G`，R10K-01） | `9.93 kΩ`，稳定 | 与前次及 H0 筛查值一致 |
| 红—黑（`T-G`，串联总值） | `21.94 kΩ` | 与分段和 `21.93 kΩ` 仅差 `0.01 kΩ`，约 `0.046%` |

该结果确认三条线的电气身份、规范化颜色和串联拓扑一致，未显示开路、低阻短路或接触跳变。此前设置的 **H3-02 CONNECTION HOLD 已解除**；只放行下一步在全断电状态下连接 Node B 的 `3V3 / A0 / GND`，不等于已经授权上电。

### 6.4 H3-02 未上电接线快照（2026-10-08）

执行人报告已迁移部分跳线用于共用 GND 和 3.3 V，并将 NTC 分压接至 Node B，明确说明“线已接好，未上电”。现场照片已按原字节归档；可见 Node B、面包板分压与连接线，但板端电源排针被线束部分遮挡，无法仅凭照片逐孔确认 `3V3 / GND` 落点。Node B 的 Micro-USB 插头在板端可见，照片不能证明线缆另一端是否断开，因此上电状态仍以执行人报告为准，并在电阻档复核前要求确认 USB 电脑端实际断开。

执行人随后确认 USB 未供电，并完成上电前复核：

| 检查路径 | 现场结果 | 判定 |
|---|---|---|
| Node B `3V3↔T` | 蜂鸣 | PASS：同节点连续 |
| Node B `A0↔S` | 蜂鸣 | PASS：同节点连续 |
| Node B `GND↔G` | 蜂鸣 | PASS：同节点连续 |
| Node B `3V3↔GND` | 不蜂鸣 | PASS：未发现低阻短路 |

因此 **PRE-POWER HOLD 解除**。该结果只证明未上电接线的连续性与无明显低阻短路，不证明 ADC 数值、固件身份或运行稳定性。

### 6.5 H3-02 Node B ADC 离线实现与构建（2026-10-08）

在保持实物断电期间，仅修改 Node B `Src/freertos.c`：保留 H2 的 `500 kbit/s`、正式 CAN ID、100 ms 发送和错误统计；新增启动时 ADC1 校准、`PA0/ADC1_IN0` 每 100 ms 采样，以及每 1 s 一条 `H3,B,NTC` 结构化汇总。日志记录 raw、窗口最小/最大值、采样/失败累计、配置名义 `VDDA=3300 mV` 下的 `adc_mv_nom`，以及按 `R_FIXED=9911 Ω` 反算的 `r_ntc_ohm`。

固件刻意不输出绝对温度：B3950 尚未由多温点实测证明，`3300 mV` 也明确标为 configured/nominal，而不是实测 VDDA。按本次断电值 `R_NTC≈12.00 kΩ`、`R_FIXED≈9.93 kΩ` 计算，首次运行的规划锚点为 raw 约 `1854`、`adc_mv_nom` 约 `1494 mV`、反算 NTC 约 `12.0 kΩ`；它们不是提前写入的 PASS 区间。

Node B 使用 STM32CubeIDE 2.2.0 随附 GNU Tools for STM32 14.3.1 单线程构建，退出码 `0`，无编译警告或错误：

| 项目 | 结果 |
|---|---|
| `text / data / bss / dec` | `33680 / 100 / 13844 / 47624` bytes |
| ELF 文件大小 | `1095108` bytes |
| ELF SHA-256 | `FB4B5445CA0103E64B859543D17793DBEF9568192A82ABBF029F1E4DC833605E` |
| 最大新增静态函数帧 | `H3_LogNtcStatus=392` bytes；任务配置栈 `2048` bytes | 只属于编译器静态报告，不代替实板高水位验证 |

初次在执行隔离层内启动编译器时，Windows 返回 DLL relocation Error 623，编译器未进入源码编译；同一编译器在隔离层外正常启动并完成上述构建。因此该事件归类为主机构建隔离问题，而不是源码编译失败。当前 **尚未连接、擦写或复位任何 ST-LINK 目标**。

### 6.6 H3-02 Node B 上电电压预检（2026-10-08）

在未刷写 H3 固件前，执行人给 Node B 上电并报告如下单次直流电压读数：

| 测量路径 | 实测值 | 预检区间 | 判定 |
|---|---:|---:|---|
| `T-G`（Node B `3V3` 对分压地） | `3.289 V` | `3.2～3.4 V` | PASS |
| `S-G`（Node B `A0` 分压中点对地） | `1.552 V` | `1.40～1.60 V` | PASS |

两项均落入上电预检区间。按同次电压比及现场固定电阻读数 `9.93 kΩ` 计算，NTC 约为 `11.11 kΩ`；若按固件冻结的 H0 精确值 `R_FIXED=9911 Ω` 计算，则约为 `11.09 kΩ`。仅按电压比换算的预期 12-bit ADC 原始值约为 `1932`。这些是刷写前的现场一致性锚点，不是固件运行实测值。

本次报告只包含上述两个读数，没有单独报告持续 30 s 的电压稳定性，因此不得补写为稳定性通过。Windows 随后只读枚举到唯一一块 `STMicroelectronics STLink Virtual COM Port (COM8)`，USB 复合设备序列号为冻结的 Node B 身份 `066DFF515149856767254421`；该结果可解除目标板身份 HOLD，但不等同于已经刷写、复位或采集 UART 数据。

### 6.7 H3-02 定向刷写与运行冒烟（2026-10-08）

CubeProgrammer 在执行隔离层外只读列举并连接后，确认唯一探针序列号为 Node B 冻结值 `066DFF515149856767254421`，目标为 `0x410 / Rev X / 128 KiB / Cortex-M3`，写前 ST-LINK 电压为 `3.16 V`。随后将 SHA-256 为 `FB4B5445CA0103E64B859543D17793DBEF9568192A82ABBF029F1E4DC833605E` 的 `node_b.elf` 按该序列号定向写入；写入时 ST-LINK 电压为 `3.15 V`，工具返回 `Download verified successfully`。Node A 未连接、未枚举、未访问。

刷写后从 `COM8 / 115200 8N1` 取得九条连续 H3 汇总，tick 跨度约 `8.208 s`：`cal=0`（`HAL_OK`）、`ready=1`、`last=0`、`samples=450→530`、`fail=0`；当前 raw 为 `1921～1939`、均值 `1927.4`，名义换算电压均值 `1552.8 mV`，与独立万用表 `S-G=1.552 V` 及预期 raw≈`1932` 一致。当前反算 NTC 为 `11020～11216 Ω`。各 1 s 窗口合并极值达到 `1871～1951`，该偏离留待 H3-03 室温基线量化，不在 H3-02 隐去或提前定性。

同一串口片段中的 H2 统计显示没有 CAN ACK/对端接收，符合当前单板 H3 捕获上下文；它不属于 ADC 失败，也不构成 H2 双节点回归证据。一次后续软件复位命令虽由 CubeProgrammer 返回成功，但串口片段未观察到 tick 归零，因此不把它追加为独立启动证据。刷写与运行原始记录见同日软件证据目录。

据此，H3-02 于 **2026-10-08 PASS**：接线、短路预检、上电电压、构建、身份、定向刷写/校验、ADC 校准状态及短时采样均已闭合。该 PASS 不证明绝对温度精度、热趋势、开短路边界、双节点 CAN 回归或长时稳定性。

## 7. H3-02 接板前的安全状态

开始任何接线前必须同时满足：

- 两块 NUCLEO 的 USB 均已拔除；
- 12 V 适配器不接市电、不接任何模块；
- Fan、Heater、INA260 均与操作区电路隔离；
- 不在通电状态使用电阻档或通断档；
- 不徒手同时握持多支表笔拍照；必要时先固定元件或使用夹具；
- 新分压先在板外完成无源核对，再接 Node B；
- 出现异味、异常发热、USB 反复枚举、导线松脱或无法确认 A0/3V3/GND 时立即停止。

## 8. 证据与命名规则

H3-00 没有产生新的硬件运行证据；其输出是本执行记录中的受控设计决定。H3-01 起的原始文件按实际日期归档，建议命名：

```text
H3_NTC-01_R10K-01_passive-divider-wiring_YYYYMMDD_01.jpg
H3_NTC-01_R10K-01_passive-resistance_YYYYMMDD_01.jpg
H3_NODE-B_NTC-divider-to-A0_YYYYMMDD_01.jpg
H3_NODE-B_NTC-room-baseline_YYYYMMDD_run01.txt
H3_NODE-B_NTC-warm-recovery_YYYYMMDD_run01.txt
H3_NODE-B_NTC-open-short-boundary_YYYYMMDD_run01.txt
```

照片和日志必须保留原始文件；允许规范化文件名，但不覆盖、不修图、不把后续 PASS 回填到此前失败或未开始的日期。

## 9. H3-00 关闭结论

H3-00 于 **2026-10-07 PASS**：H2 固件回退点、Node B ADC 资源、NTC 分压方向、换算模型、B3950 证据边界、12 V 隔离条件和 H3-NTC 执行顺序均已明确。

该结论只授权进入 **H3-01 全断电无源搭建**。它不证明 ADC 运行、温度精度、开短路检测、Fan、INA260、Heater 或任何 12 V 功能。

## 10. H3-01 关闭结论

H3-01 于 **2026-10-08 PASS**：板外分压的分段值、串联总值、近照视觉检查和轻微扰动连续性均已通过；平滑的十几欧 NTC 漂移被限定记录为与热平衡效应一致，不作为接触故障，也不用于证明绝对温度精度。

该结论在形成时只授权进入 H3-02 的接板前防误接整理；随后线色规范化、`T-S / S-G / T-G` 复核及 H3-02 全部子项已于 2026-10-08 按顺序完成。这里保留 H3-01 当时的授权边界，不用后续 PASS 改写此前尚未发生的动作。

## 11. H3-02 关闭结论

H3-02 于 **2026-10-08 PASS**：Node B NTC 分压的板端连续性与无低阻短路、刷写前电压、ADC 最小实现与构建、目标身份、定向刷写校验以及短时 UART 采样均满足本阶段通过条件。独立 DMM 中点值 `1.552 V`、预测 raw≈`1932` 与实板当前 raw 均值 `1927.4` 相互印证。

该结论只授权进入 **H3-03 室温静置—安全加温—自然恢复**。H3-03 必须保留完整时间序列并量化窗口极值；在此之前不把 B3950 名义模型表述为绝对温度精度，也不放行 12 V、Fan、Heater 或 INA260。

## 12. H3-03 室温基线与预冻结判据（2026-10-08）

执行人报告 NTC 已静置并保持不触碰，同时说明所在地气温约 `17°C`、室内温度可能浮动。由于没有同步校准温度计，`17°C` 只作为环境语境，不能作为 NTC 的校准真值或绝对温度验收点。

从 `20:16:35` 至 `20:18:34` 清空串口旧缓存后采集 117 条新 H3 报告，主机跨度 `118.963 s`、设备 tick 跨度 `119.016 s`，相邻报告 tick 均为 `1026 ms`。`samples=3330→4490`、`fail=0→0`，全部记录均保持 `cal=0 / ready=1 / last=0 / calc_valid=1`，未观察到 tick 归零或 VCP 断连。

当前 raw 的 `min/max/mean/median/σ` 分别为 `1849 / 1897 / 1865.11 / 1864 / 8.55`，P05/P95 为 `1852/1878`；前后 30 s 均值为 `1866.97/1864.20`，仅差 `-2.77`，线性斜率 `-1.987 count/min`。`adc_mv_nom` 均值为 `1502.50 mV`，`r_ntc_ohm` 均值为 `11849.41 Ω`。每个 1 s 汇总窗口内部仍捕捉到总极值 `1799～1917`，该短促偏离完整保留，不直接判为接触故障，也不能用于冒充热趋势。

室温基线子项据此 **PASS**。在任何人为加温前冻结后续判据：

1. 手指安全加温时，raw 与 `adc_mv_nom` 上升、`r_ntc_ohm` 下降；
2. 连续 10 条 H3 报告的 rolling median raw 至少达到 `1921`（基线 P95 加 5σ 后向上取整，且高于本次当前值最大值 1897）；
3. 移开手指后，完整 30 条报告的均值回到基线均值 ±3σ，即 `1839～1891`，并呈回归基线方向；
4. 全程 `fail` 不增加、状态字段保持正常、tick 不复位、USB/VCP 不断连；
5. 不以 B3950 推导的绝对摄氏度作为 PASS 条件。

原始日志 SHA-256 为 `3CE95530D1EE519DB65B140BDC435597567840D916F1ACCB7DBD74D8EF08A66C`；统计摘要 SHA-256 为 `F7445316D8032EF55B06A58539DAA557F9AA604D179409AA55841412B2716ACB`。完整 H3-03 仍为 **IN PROGRESS**。

## 13. H3-03 手指加温—自然恢复 Run01（2026-10-08）

执行人在收到指令后以手指轻捏封装后的 NTC 珠体，未引入通电加热器、热风、烙铁或 12 V。采集共含 410 条 H3 报告，主机跨度 `419.872 s`、设备 tick 跨度 `419.903 s`、相邻 tick `1026～1027 ms`；`samples=13860→17950`、`fail=0→0`，全部记录均保持 `cal=0 / ready=1 / last=0 / calc_valid=1`，未观察到复位或 VCP 中断。

加温前 raw 均值为 `1867.12`。10 条报告 rolling median 首次达到 `1956`，高于预冻结阈值 `1921`，最大 rolling median 为 `2471`；总峰值 raw=`2491`、`adc_mv_nom=2007 mV`、`r_ntc_ohm=6381 Ω`。相对室温基线均值，raw/名义电压约上升 `33.56%/33.58%`，反算阻值下降 `46.15%`，与“NTC 受热阻值下降、上拉 NTC 分压中点升高”的冻结方向一致。

移除热刺激后，完整 30 条 raw 均值首次以 `1889.87` 进入冻结恢复区间 `1839～1891`；最终 30 条均值为 raw=`1867.83`、名义电压=`1504.60 mV`、反算阻值=`11817.53 Ω`，raw 仅比原室温基线均值高 `2.72`。Run01 的方向、持续阈值、恢复与完整性均 **PASS**。

必须保留的时间边界：heat/release command marker 间隔为 `114.992 s`，但控制标记不是独立测量的手指接触时间；工具与消息送达延迟使本轮不能被描述为“精确 30 s 加温”。峰值在 release marker 后出现，无法仅凭本记录区分珠体热惯性与实际松手延迟。每秒窗口总极值 `1551～2647` 也继续保留，不以其替代持续趋势。

Run01 原始日志 SHA-256 为 `E5AB2D71DF355720064DAA3D0C7B786670D5D6784397F3EBFE9407D6446FED0D`；摘要 SHA-256 为 `4BD47F9BAF59D3AC1E8598286F40807CB0E7FACF0615F69669DB58E24BC033A7`。由于门禁写明趋势需“可重复”，完整 H3-03 暂不关闭，下一步执行一次由执行人自行计时 30 s 并主动松手的 Run02。

## 14. H3-03 重复性 Run02 与关闭（2026-10-09）

### 14.1 时间边界与无效初试

2026-10-08 曾启动一次 Run02 初试，但助手额度暂停打断了交互流程，所得记录没有覆盖完整自然恢复段；执行人明确要求重新执行。该初试不进入 PASS 统计，也不解释为硬件故障。2026-10-09 重新上电 Node B 后，COM8 重新取得实时 H3 帧，再清空主机旧缓存启动正式 Run02。

正式 Run02 中，执行人按指令只捏住封装后的 NTC 珠体，自行计时 `30 s` 后主动松手，不等待第二条控制消息；未使用通电加热器、热风、烙铁或 12 V。该 30 s 为执行人计时陈述，没有独立接触传感器，因此不写成仪器校准的热刺激时长。

### 14.2 主采集完整性

主日志从 `00:40:55.891` 至 `00:46:54.977` 保存 351 条 H3 报告，主机跨度 `359.087 s`、设备 tick 跨度 `359.100 s`；350 个相邻 tick 增量全部为 `1026 ms`。`samples=480→3980`，每条相邻增量均为 `10`；全部记录保持 `cal=0 / ready=1 / calc_valid=1 / fail=0 / last=0`，未观察到 tick 或样本计数归零，也未发生 VCP 中断。

为显式记录跨日/环境工作点差异，升温前选取 `00:41:32.825～00:42:02.579` 的 30 条配对窗口：raw、`adc_mv_nom`、`r_ntc_ohm` 均值分别为 `1830.867 / 1475.033 mV / 12256.833 Ω`。该值低于 2026-10-08 的晚间室温基线，符合执行人预先声明的室内温度可能浮动；它只用于解释工作点，不替换已冻结的 `1921` 升温阈值和 `1839～1891` 恢复区间。

### 14.3 第二次升温与恢复结果

10 条报告 rolling median 首次在 `00:42:12.838` 达到 `1949.5`，超过冻结阈值 `1921`；最大 rolling median 为 `2396`。当前值峰值在 `00:42:33.357` 达到 raw=`2415`、`adc_mv_nom=1946 mV`、`r_ntc_ohm=6894 Ω`。相对冻结室温基线均值，raw 上升 `29.48%`、反算阻值下降 `41.82%`，再次符合“上臂 NTC 受热降阻，中点电压/raw 上升”的方向。

峰值后完整 30 条报告在 `00:43:47.226～00:44:16.980` 首次以 raw 均值 `1889.667` 返回冻结恢复区间 `1839～1891`，因此原判据第 3 条被直接满足。主采集末 30 条均值随后降到 `1825.667`；为防止把未完成恢复或偶然窗口误写为通过，又在完全不触碰的情况下追加 88 条、`89.259 s` 恢复记录。追加段末 30 条均值为 raw=`1825.767`、名义电压=`1470.800 mV`、反算阻值=`12319.167 Ω`，与本轮升温前配对 raw 均值只差 `-5.100`（`-0.279%`）。两份文件之间主机时间前进 `167.232 s`、设备 tick 前进 `167238 ms`、samples 增加 `1630`，没有复位迹象。

延长段低于 2026-10-08 绝对包络的数据被完整保留：它说明跨时段环境/热平衡工作点发生漂移，不推翻已经取得的完整 30 条冻结区间恢复窗口，也不能被用于宣称 B3950 或绝对摄氏度精度。主日志当前 raw 范围为 `1663～2415`，每秒窗口总极值为 `1525～2491`；这些短促窗口极值不代替持续 rolling median。

### 14.4 H3-03 判定

| 冻结要求 | Run02 证据 | 判定 |
|---|---|---|
| 加温时 raw/名义电压上升、阻值下降 | 峰值 `2415 / 1946 mV / 6894 Ω` | PASS |
| 10 条 rolling median raw ≥1921 | 首次 `1949.5`，最大 `2396` | PASS |
| 完整 30 条均值回到 1839～1891 | 首次恢复窗口 `1889.667` | PASS |
| 采样、状态、tick、VCP 完整 | 351 条主记录及 88 条延长记录；`fail=0`，无复位 | PASS |
| 趋势可重复 | Run01 与 Run02 方向、持续越阈和自然恢复一致 | PASS |

Run02 主日志 SHA-256 为 `A1F4B49A063ECE1396CB5D5FC4A8A0C90DB29382E35152E67C561550F5543FE0`；恢复延长段 SHA-256 为 `2AF6A6A7238E7165B1B7DF0DE8A30D0938BAE5AFDE37CF9A6375F3B37E7C685F`；受控摘要 SHA-256 为 `916CF23C45D146B92C367603734579A2E7AFC07CBF89201DA87D6F143028A31B`。

据此，H3-03 于 **2026-10-09 PASS**。该结论证明当前 Node B NTC 低压采集链具有方向正确、持续、可恢复且可重复的响应；不证明绝对温度精度、B3950 参数、长期可靠性或系统级故障状态机。下一步只授权规划并执行 **H3-04 受控低压边界/故障刺激**；12 V、Fan、Heater 和 INA260 仍未放行。

## 15. H3-04 受控边界/故障刺激与关闭（2026-10-09～10-10）

### 15.1 先表征、后定阈值

2026-10-09 使用当时尚无显式 `ntc_state` 的固件执行两种低风险刺激：断开 NTC 上端 `T` 模拟上支路开路；用 `T-S` 旁路 NTC 模拟 NTC 短接。旁路仍由约 9.93 kΩ 下臂限流，3.3 V 下电流约 `0.33 mA`，不构成 3V3-GND 硬短路。

| 状态 | 条数 / 跨度 | 当前 raw | 窗口总边界 | 结果用途 |
|---|---:|---:|---:|---|
| `T` 开路 | `59 / 59.448 s` | `0～17`，均值 `1.03` | `0～43` | 冻结 OPEN 样本；旧逻辑 `calc_valid` 会在 0/1 间变化 |
| 第一次恢复 | `58 / 58.480 s` | `1843～1902`，均值 `1872.21` | `1741～1951` | 证明撤除开路后恢复普通换算 |
| `T-S` 旁路 | `58 / 58.423 s` | `3990～4095`，均值 `4088.22` | `3973～4095` | 冻结 SHORT 样本；旧逻辑仍把近满量程当普通阻值 |
| 最终恢复 | `59 / 59.506 s` | `1839～1896`，均值 `1865.10` | `1770～1909` | 证明撤除旁路后再次恢复 |

以上是表征，不在 10 月 9 日提前记为 H3-04 PASS。它同时解释了为什么必须先识别边界，再做除法换算。

### 15.2 在路阻值排查

断电在路测量曾出现 `S-G≈5～6 kΩ`、`T-S≈6.46 kΩ`。执行人逐支路隔离后确认：`T` 与 `A0` 都断开时固定电阻恢复 `9.93 kΩ`，NTC 路径恢复约 `11.49 kΩ`；单独保留任一板端支路又会得到更低等效阻值。该对照证明未上电 MCU 的 ADC/电源/保护路径参与并联，不能用在路等效阻值直接否定单只元件。此前对在路读数的简单串联预期据此被纠正并保留为排障证据。

### 15.3 三态实现、构建与刷写

2026-10-10 根据前一日样本冻结当前 H3 台架阈值：

```text
raw <= 50    -> OPEN  / ntc_state=1 / calc_valid=0
51..3949     -> NORMAL/ ntc_state=0 / calc_valid=1
raw >= 3950  -> SHORT / ntc_state=2 / calc_valid=0
```

边界状态统一输出 `r_ntc_ohm=0`，避免把除法结果误当物理有效阻值；启动日志同步暴露 `open_raw_max` 和 `short_raw_min`。Node B 离线构建为 0 warnings/0 errors，`text/data/bss/dec=33780/100/13844/47724`，ELF 大小 `1095288` bytes、SHA-256=`8CFC084B8AD03683931CC8FDF91C4D8BCF46173FD88F2EA63D006BE6A364A9A2`。该 ELF 定向写入冻结身份的 Node B 并由 CubeProgrammer 返回 `Download verified successfully`；Node A 未连接或访问。

### 15.4 新固件实板复验

| 状态 | 条数 / 跨度 | raw | 状态字段 | 判定 |
|---|---:|---:|---|---|
| 原始接线正常基线 | `68 / 68.802 s` | `1786～1867` | 68/68 `state=0 / valid=1` | PASS |
| `T` 开路 | `21 / 20.499 s` | `0～15` | 21/21 `state=1 / valid=0 / r=0` | PASS |
| `T-S` 旁路 | `21 / 20.534 s` | `3961～4095` | 21/21 `state=2 / valid=0 / r=0` | PASS |
| 恢复原始接线 | `21 / 20.536 s` | `1878～1934` | 21/21 `state=0 / valid=1` | PASS |

全部记录保持 `fail=0 / last=0`，样本计数持续推进；启动行同时证明 `open_raw_max=50 / short_raw_min=3950 / cal=0 / ready=1`。据此，H3-04 于 **2026-10-10 PASS**。

必须保留的裕量限制：新固件 SHORT 最低当前样本 `3961` 距阈值 `3950` 只有 11 count。本结果只证明当前器件、接线、USB 供电和室温台架能稳定识别，不证明全温压、器差、老化、噪声和 EMC 条件下的生产裕量。当前也没有滞回、去抖、锁存、DTC 或 CAN 故障上报。

## 16. H3-05 NTC 子项关闭（2026-10-10）

NTC 子项的原始照片、无源阻值、连续性、上电前 DMM、构建与刷写绑定、室温序列、两轮热趋势、旧固件边界表征、新固件三态验收、恢复日志、SHA-256 及结论边界已经分别按 2026-10-07、10-08、10-09、10-10 的真实日期归档。独立工程复盘见 [`H3 NTC 联调排障证据复盘`](../06_engineering_recaps_工程复盘/H3_NTC_Bringup_Troubleshooting_Evidence_Recap_H3_NTC联调排障证据复盘_2026-10-10.md)。

据此，H3-05 于 **2026-10-10 PASS**，Node B NTC 低压采集子项关闭。该关闭证明的是当前原型台架的采集、趋势和受控边界识别；不证明绝对温度精度、B3950、多温点标定、长期可靠性或完整故障状态机。

## 17. Gate H3 后续授权边界

整个 Gate H3 仍为 **IN PROGRESS**。Fan PWM 已完成 `FAN-00A～FAN-00F` 的实物身份、独立供电、针位映射、PWM 对地开路电压和驱动方案决策；低压侧波形和联合实测尚未完成，Tach/PPR 与 INA260 也尚未建立独立证据。

Fan PWM 子项已于 2026-10-10 完成文档审计、安全方案冻结和 `FAN-00A` 实物身份/接口补证，并于 2026-10-12 依次通过 `PSU-00B`、`FAN-00C`、`FAN-00D`、`FAN-00E` 与受控范围的 `FAN-00F`。下一步进入 **`FAN-01` PC7 开漏低压侧波形验证**：风扇与 12 V 继续隔离，用外部 `10 kΩ` 将 PC7 上拉到 Node A `3V3`，再观测约 25 kHz / 50% 的对地波形。H3 仍按“整个 Gate 完成后统一推送”执行，因此当前新增记录只允许本地提交，不单独推送 GitHub。

## 18. Fan PWM-00 准入审计（2026-10-10）

### 18.1 当前判定

Fan PWM-00 当前判定为 **PASS（`FAN-00A～FAN-00F`）**，Fan PWM 整体当前进展为 **IN PROGRESS AT FAN-01（不是器件 FAIL）**。2026-10-10 收到并归档 5 张原始照片后，`FAN-00A` 判定为 **PASS（身份/接口范围）**：实物标签确认 `ARCTIC P8 PWM PST / DC 12 V 0.09 A`，原装主接口为 4 位 4 触点，PST 串联输出为 4 位外壳内 3 个触点，独立延长线两端均为 4 位 4 触点。该差异符合 PST 只转接 `GND / +12 V / PWM`、不并联多只风扇 Tach 输出的设计，不登记为缺针或损坏。

H0 `D-02` 的 FAN 身份/接口子项据此关闭；完整销售 SKU 未印在现场标签上，因此不把候选网页中的 `ACFAN00150A` 当成现场可读事实。2026-10-12 的 `PSU-00B` 在完全空载状态连续观察 10 s，输出 `12.487～12.588 V`、末值 `12.588 V`，无跳变、异味、异响或异常发热，据此关闭 H0 `D-04` 的空载基本稳定性缺口。

`FAN-00C` 随后确认延长线四路一一对应、不同针位无短路、晃动无断续；`FAN-00D` 又确认端到端供电极性正确、单风扇可立即起转并稳定运行 10 s；`FAN-00E/F` 又完成 PWM 对地开路电压和 PC7 受控直连决策。当前只允许在风扇、12 V、Tach、Heater 和 INA260 全部隔离时编译、刷写并验证 `FAN-01` 的 Node A PC7 空载开漏波形；尚不允许 PWM 联合接线。

### 18.2 已确认的设计基线

| 对象 | 已确认内容 | 证据边界 |
|---|---|---|
| Node A PWM 资源 | `TIM3_CH2 / PC7`，Arduino `D9`，Morpho `CN10-19`；TIM3 Full Remap；AF Open-Drain；`PSC=0`、`ARR=2559`，配置频率 `25 kHz` | 只证明资源分配和生成代码存在，不证明实板波形 |
| STM32 引脚能力 | ST 数据手册将 `PC7` 标为 FT，并列出重映射功能 `TIM3_CH2`；FT 输入高于 `VDD+0.3 V` 时必须禁用内部上下拉 | 仍必须先实测现场风扇 PWM 线开路电压，不能只凭“5 V tolerant”直接连接 |
| NUCLEO 板级映射 | ST 的 MB1136 用户手册将 NUCLEO-F103RB 的 `D9` 映射到 `PC7` | 现场接线仍需按板上 `D9`/连接器位置复核，不凭线色 |
| 4-wire PWM 接口边界 | Intel 公开设计资料给出 PWM 输入 `21～28 kHz`、风扇内部上拉推荐最大 `3.3 V`/绝对最大 `5.25 V`、低电平最大 `0.8 V`、短路电流最大 `5 mA` | 这是接口族参考；现场实物开路电压仍为放行依据 |
| 现场风扇与厂商资料 | 现场标签确认 `P8 PWM PST / DC 12 V 0.09 A`；ARCTIC 官方同型号页面列出 `4-pin Connector + 4-pin Socket、200～3000 rpm、低于 5% PWM 时 0 rpm` | `12 V / 0.09 A` 可绑定到 `FAN-01`；页面销售 SKU、转速范围和停转行为仍分别属于网页标称/后续功能验证，不改写为现场实测 |
| 当前 Node A 固件 | `.ioc` 与 `tim.c` 已生成上述 TIM3/PC7 开漏配置；`Pulse=0` | `main.c` 尚未调用 `HAL_TIM_PWM_Start`，也没有占空比控制/运行日志；当前固件不能作为有效 PWM 输出证据 |

外部参考：

- ARCTIC P8 PWM PST 产品页：<https://www.arctic.de/en/P8-PWM-PST/P8PWMPST>
- ARCTIC P8 PWM PST 支持/手册：<https://support.arctic.de/en/p8-pwm-pst>
- Intel 4-wire fan 电气要求引用页：<https://www.intel.com/content/dam/doc/design-guide/core-2-pentium-celeron-dual-core-guide.pdf>
- STM32F103x8/xB 数据手册：<https://www.st.com/resource/en/datasheet/stm32f103rb.pdf>
- STM32 Nucleo-64 MB1136 用户手册：<https://www.st.com/resource/en/user_manual/dm00105823-stm32-nucleo-64-boards-mb1136-stmicroelectronics.pdf>

### 18.3 冻结的首选电气方案

在现场实测 PWM 开路电压满足 PC7/接口约束的前提下，首选方案保持为：

```text
PSU12V-01 +12 V  -> FAN-01 Power
PSU12V-01 GND    -> FAN-01 GND
                    -> Node A GND（只在前序检查通过后建立单点公共地）
FAN-01 PWM       -> Node A PC7 / D9 / TIM3_CH2（AF Open-Drain，内部上下拉关闭）
FAN-01 Tach      -> 本 PWM 子项暂不连接；留给后续 Tach/PPR 子项
PST 额外接口     -> 不使用、单独绝缘固定
```

风扇 12 V 功率不经过 NUCLEO 或面包板电源轨；Node A 初期继续由 USB 供电，12 V 不得进入 `3V3`、`5V`、`VIN` 或 GPIO。PWM 只承担开漏下拉信号，不给风扇供电。首轮只使用一只风扇，不接 PST 串联接口。

最终/长期功率线束仍不得使用松散杜邦线。仅在 `FAN-00D` 单只 `0.09 A` 风扇的短时隔离验证中，允许把两根经过逐针通断与端到端极性复核的公头测试线作为可拆转接：从完整延长线母座的 `Pin 1/Pin 2` 引到 DC 螺丝端子，跳过面包板并做机械固定；`Pin 3/Pin 4` 留空。该临时例外不得外推到 Heater、INA260 高边、长期运行或最终装配。

若实测 PWM 开路电压超出 PC7/接口约束，或实物接口无法确认，则本直连方案自动撤回，继续 HOLD；必须另行冻结具体晶体管、电阻、默认态和失效态后才能继续。现有 BOM 只把外部 NPN/MOSFET 写成后备方向，没有冻结具体器件与阻值，因此不能现场临时拼接替代。

### 18.4 停止条件

任一步出现以下任一情况都立即断开适配器市电侧并保持 HOLD：极性/针脚不明确，表笔或端子可能相碰，输出明显漂移，USB/ST-LINK 反复掉线，风扇不启动或剧烈抖动，异味、异响、火花、冒烟、线缆/端子/适配器异常发热，或 PWM 开路电压不满足已冻结约束。不得靠反复插拔、交换未知线、堵转风扇或“先接 MCU 看看”定位。

### 18.5 冻结的执行顺序

1. **FAN-00A 实物身份补证**：全断电，拍摄风扇完整标签、主 4-pin 插头正面/防呆方向、PST 额外接口，以及风扇延长线两端；不根据线色推断针脚；
2. **PSU-00B 关闭 D-04**：项目端完全不接负载，仅在直流输出端测量，连续观察约 10 s，记录最小/最大电压及异味、异响、异常发热；不拆适配器外壳，不接风扇；
3. **FAN-00C 延长线无源映射**：全部断电，用通断/电阻档逐针确认延长线两端一一对应关系，并按连接器物理针位编号；不得切原装风扇线；
4. **FAN-00D 风扇独立上电**：Node A 和 PWM/Tach 均不连接，只给确认后的 Power/GND 供 12 V；短时观察启动、转动方向、异味/异响/发热；
5. **FAN-00E PWM 开路电压**：保持风扇独立供电，PWM 不接 MCU，以 FAN GND 为参考测量 PWM 线开路直流电压；Tach 仍不接；
6. **FAN-00F 驱动决策**：依据开路电压和接口约束批准 PC7 开漏直连，或转入晶体管方案设计；
7. **FAN-01 低压侧先验**：先不接风扇，在 Node A 的 D9/PC7 上以示波器验证固定占空比和约 25 kHz 波形，再决定是否进行公共地与 PWM 单线联调；
8. **FAN-02 单风扇 PWM 实测**：只增加 PWM 单线，按受控占空比档位验证转速方向性/停转行为；Tach、INA260、Heater 继续隔离。

第 1 步 `FAN-00A` 已于 2026-10-10 通过，第 2～6 步 `PSU-00B`、`FAN-00C`、`FAN-00D`、`FAN-00E`、`FAN-00F` 已于 2026-10-12 通过。当前只授权第 7 步 `FAN-01` 的离线固件准备、Node A 定向刷写与风扇完全隔离条件下的空载波形验证；第 8 步 `FAN-02` 继续 HOLD。Git 仍按完整 Gate H3 关闭后统一推送；本审计记录不触发单独远端推送。

### 18.6 FAN-00A 关闭证据（2026-10-10）

原始照片、文件大小、SHA-256、逐图可支持事实和证据边界集中归档于 [`../../evidence/hardware/H3/2026-10-10/`](../../evidence/hardware/H3/2026-10-10/README.md)。

接口解释按机械防呆和物理针位建立，不按四根全黑导线的条纹/线色猜测：

| 对象 | 现场可见结构 | 当前解释与边界 |
|---|---|---|
| `FAN-01` 主接口 | 4 位、4 触点、4 导线母座 | 承担 `GND / +12 V / Tach / PWM`；后续仍需按物理针位确认，不凭线色 |
| `FAN-01` PST 输出 | 4 位防呆外壳、3 个金属触点 | 供下一只风扇共享电源和 PWM，省略 Tach，避免多只测速输出并接；初始验证不使用并单独绝缘固定 |
| `FANEXT-01` 延长线 | 两端均为 4 位 4 触点，4 条并行导体 | 外观符合通用四线直通延长线，但尚未证明逐针一一对应；留待 `FAN-00C` 全断电通断测试 |

关闭结论仅覆盖身份、额定值可读性、接口形态和可见外观；没有提前关闭延长线通断、12 V 供电、风扇转动、PWM、Tach/PPR、负载电流或热稳定性。

### 18.7 PSU-00B 与 H0 D-04 关闭证据（2026-10-12）

现场执行人在适配器与项目、风扇和所有板卡隔离的状态下，以数字万用表观察直流输出约 10 s，报告范围 `12.487～12.588 V`、末值 `12.588 V`，无跳变、异味、异响或异常发热，并在结束后断开市电。该范围跨度为 `0.101 V`，约为末值的 `0.80%`；与既有约 `12.580 V` 静态证据量级一致。

断开市电后，适配器指示灯和直流输出仍维持约 10 s，随后电压以非线性速度下降，约 2 min 后释放完毕。该现象记录为高阻空载条件下的储能/残压安全特性，不作为额定带载能力。后续冻结以下规则：拔电后不得立即视为零电压；改线前须等待指示灯熄灭并以直流档确认输出低于 `0.5 V`；不得短接输出强制放电。

结构化原始报告、判定和证据边界见 [`../../evidence/hardware/H3/2026-10-12/`](../../evidence/hardware/H3/2026-10-12/README.md)。`PSU-00B` 判定为 **PASS**，H0 `D-04` 判定为 **CLOSED（空载基本稳定性范围）**；不证明 3 A 带载、纹波、动态响应、保护动作或长期温升。

### 18.8 FAN-00C 延长线无源映射（2026-10-12）

公头与母座的插接面同时朝向观察者、防呆结构同向时，现场临时编号结果为：

```text
M1 -> F4
M2 -> F3
M3 -> F2
M4 -> F1
```

四路均稳定蜂鸣，不同针位之间均不蜂鸣，轻微晃动无断续。该“反序”是两个插接面同时正视造成的几何镜像，不是导体交叉；延长线四根导体仍为一一对应。`FAN-00C` 判定为 **PASS**。

本结果不直接给四根全黑导线赋予功能，也不证明载流或长期寿命。`FAN-00D` 上电前仍须依据标准机械针位确认 `Pin 1=GND、Pin 2=+12 V、Pin 3=Tach、Pin 4=PWM`，再将针位通过本次连续性结果传递到拟改造的延长线端；不得按印刷条纹猜测。

### 18.9 FAN-00D 接法纠正：保留完整延长线（2026-10-12）

初步口头操作曾提出“剪掉延长线母座并重新剥线”，现场执行人指出两端现有压接端子、防呆外壳和应力保护均完好，剪线会引入剥线损伤、机械强度下降、重新绝缘和误标风险。该意见成立，破坏性方案在执行前撤回，现场没有剪线。

冻结后的接法改为：

```text
FAN-01 原装主母座
        <-> FANEXT-01 完整公头
FANEXT-01 完整母座 Pin 1/GND
        <-> 已复核并固定的 GND 测试引线 <-> DC 端子负极
FANEXT-01 完整母座 Pin 2/+12 V
        <-> 已复核并固定的 +12 V 测试引线 <-> DC 端子正极
FANEXT-01 Pin 3/Tach、Pin 4/PWM
        -> 本步骤不插线、不连接
```

正式接风扇前，先在延长线未接风扇的状态下给转接端短时上电，以延长线公头的 `Pin 1` 为参考测量 `Pin 2`，必须得到正的约 `12.5 V`；随后断开市电、等待指示灯熄灭并确认低于 `0.5 V`，才允许插接风扇。该方法保留成品端子和防呆结构，同时把极性错误拦截在风扇接入之前。

### 18.10 FAN-00D-A 功能针位无源绑定（2026-10-12）

适配器未上电、延长线母座四孔全部释放后，现场把风扇原装四孔主母座与 `FANEXT-01` 四针公头正常防呆插接；以风扇 PST 三针公头中已知的电源触点为参考，逐孔扫描延长线母座。执行人原始报告为：

> `FAN-00D-A：GND→F1，+12V→F2；各自唯一蜂鸣，交叉不蜂鸣；电源未上电。`

因此冻结 `F1=GND`、`F2=+12 V`；`F3/F4` 在本功率验证中均不连接。各功能只命中一个孔且交叉不蜂鸣，`FAN-00D-A` 判定为 **PASS**。本结果是无源针位身份与隔离证据，不是带电极性、载流或风扇运行证据。

下一授权点为 `FAN-00D-B`：风扇保持完全断开，完整延长线母座仅在 `F1/F2` 插入已复核测试线并分别接 DC 端子负/正极；`F3/F4` 留空。短时空载上电后，必须在延长线公头测得 `Pin 2` 相对 `Pin 1` 为正的约 `12.5 V`，随后断电并确认残压低于 `0.5 V`。通过前不得插接风扇。

### 18.11 FAN-00D-B 空载端到端极性确认（2026-10-12）

风扇保持断开，`F1/GND`、`F2/+12 V` 分别通过完整测试线接 DC 端子负、正极，`F3/F4` 空置。现场在延长线公头测量 `Pin 2` 相对 `Pin 1`，原始报告为：

> `FAN-00D-B：Pin2对Pin1=+12.588V，10秒范围12.588～12.588V；无跳变；F3/F4空置；已断电，残压<0.5V；风扇未接。`

极性为正、端到端电压与 `PSU-00B` 基线一致且 10 s 内无可见跳变，断电后残压满足 `<0.5 V`，因此 `FAN-00D-B` 判定为 **PASS**。

现场另观察到：接入 DC 端子和两根测试线后，断电测得的电压不是复现先前适配器空载时约 `12.588 V` 保持后下降的曲线，而是从约 `0 V` 缓慢上升；最终仍低于 `0.5 V`。当前仅登记为高阻测量条件下的低幅残余电荷重分布/浮空感应候选现象，不锁定机理，也不据此推断适配器重新输出。若后续超过 `0.5 V`、持续上升或影响改线安全，必须重新 HOLD 并单独表征。

下一授权点为 `FAN-00D-C`：系统板、PWM、Tach、Heater、INA260 均不连接；在适配器断电且残压 `<0.5 V` 时，把 `FAN-01` 原装四孔主母座接到延长线公头，PST 三针分支绝缘悬空，固定风扇后短时上电约 10 s，观察是否立即起转、持续稳定、以及是否出现异常噪声、振动、异味或发热。

### 18.12 FAN-00D-C 单风扇短时独立上电（2026-10-12）

系统板、PWM、Tach、Heater、INA260 均保持隔离，仅通过已验证的 `F1/GND`、`F2/+12 V` 给一只 `FAN-01` 供电约 10 s。执行人报告：

> `FAN-00D-C：上电后立即起转；10秒内转动稳定；无异常噪声、振动、异味、发热；已断电，残压<0.5V。`

执行人另确认实际气流从正面白色 Logo/开放叶片面吸入，从背面参数标签/支撑筋面吹出。该方向符合典型轴流机箱风扇结构；它由叶片桨距和内部无刷驱动换相共同决定，不表示 `GND/+12 V` 反接。改变设备内送风方向应翻转风扇机械安装方向，不得交换供电极性；PWM 后续仅用于调速，不用于反转。

`FAN-00D-C` 判定为 **PASS**，因此 `FAN-00D` 整体关闭为 **PASS（短时独立上电范围）**。本结论不覆盖长期运行寿命、额定电流实测、堵转、PWM 控制、Tach/PPR 或系统联合运行。

下一授权点为 `FAN-00E-A` 全断电 PWM 孔位映射：风扇主母座继续接延长线公头，适配器保持断电且残压 `<0.5 V`；从 PST 三针公头中与另外两针隔着空位的孤立触点出发，仅扫描延长线母座空置的 `F3/F4`，锁定唯一蜂鸣孔。此步骤不得上电。

### 18.13 FAN-00E-A PWM 物理孔位映射（2026-10-12）

适配器未上电且残压 `<0.5 V`，风扇四孔主母座保持与延长线公头连接。执行人以 PST 三针公头中与另外两针隔着空位的孤立 PWM 触点为参考，扫描延长线母座的 `F3/F4`，报告：

> `FAN-00E-A：PST孤立针PWM→F4；另一孔不蜂鸣；电源未上电，残压<0.5V。`

PWM 只在 `F4` 命中且 `F3` 不蜂鸣，因此 `FAN-00E-A` 判定为 **PASS**，冻结完整功能映射为 `F1=GND`、`F2=+12 V`、`F3=Tach`、`F4=PWM`。其中 `F3=Tach` 是结合标准四针顺序、PST 省略 Tach 的既有结构证据和唯一剩余孔位得出的闭环映射；Tach 在本子项继续保持不连接。

下一授权点为 `FAN-00E-B`：Node、Tach、Heater、INA260 均隔离，只给风扇独立供电；以 `F1/GND`（可在 DC 端子负极取参考）为黑表笔参考，通过独立高阻测量引线读取 `F4/PWM` 相对地的开路直流电压及 10 s 范围。PWM 不得连接任何 MCU GPIO。

### 18.14 FAN-00E-B PWM 开路电压与现场纠正（2026-10-12）

首次口头报告为 `7.681～7.683 V`，随后执行人立即发现黑表笔参考点误接在 `+12 V`，该数值实际是电源线与 PWM 线之间的电位差，不是 PWM 对地开路电压，故标记为 **INVALID / 不进入验收统计**。重新以 `F1/GND` 为参考测量后，执行人报告 `F4/PWM` 稳定为 `4.850 V`。

有效结果 `4.850 V` 低于 Intel 四线 PWM 风扇接口给出的风扇侧 PWM 上拉绝对上限 `5.25 V`。风扇在测量中继续稳定转动；完成后仍须保持 Node 与 Tach 隔离。`FAN-00E-B` 判定为 **PASS（以纠正后的 GND 参考值为准）**，从而 `FAN-00E` 整体关闭为 **PASS**。

参考：Intel 官方设计指南的风扇电气性能表规定 PWM 风扇侧上拉推荐最高 `3.3 V`、绝对最高 `5.25 V`，且最大下拉电流 `5 mA`：<https://www.intel.com/content/dam/doc/design-guide/core-2-pentium-celeron-dual-core-guide.pdf>。

### 18.15 FAN-00F 驱动决策（2026-10-12）

ST 官方 `STM32F103x8/xB` 数据手册在针脚表中把 `PC7` 标为 `FT` 且列出复用功能 `TIM3_CH2`；`FT` 表示 5 V tolerant。电气表给出 FT 针脚输入绝对上限为 `VDD + 4.0 V`，并明确指出当外部电压高于 `VDD + 0.3 V` 时必须关闭内部上拉/下拉。以 Node A 正常 `VDD≈3.3 V` 供电计算，实测 `4.850 V` 在约 `7.3 V` 绝对上限内。

据此，H3 受控实验阶段批准 `PC7/TIM3_CH2` 使用 **Alternate Function Open-Drain，内部 Pull-Up/Pull-Down 均关闭**，直接下拉风扇 PWM；不批准推挽输出。Intel 接口上限为最大 `5 mA` 下拉电流，ST 在标准输出条件下给出 GPIO 最大 `8 mA` 吸收/输出能力，因此当前接口族的下拉电流也在 PC7 能力内。该批准附带不可省略的电源时序：Node A 必须先上电，随后才允许开启风扇 12 V；关闭时先断风扇 12 V并确认残压 `<0.5 V`，再断 Node A 或拆 PWM。因为 FT 针脚绝对上限随 `VDD` 变化，Node A 未供电时不得让风扇的 `4.850 V` 上拉进入 PC7。若最终系统不能从硬件上保证该时序，则本直连方案不得作为最终装配，必须改用外部 NPN/NMOS 隔离。

参考：ST 官方数据手册：<https://www.st.com/resource/en/datasheet/stm32f103rb.pdf>。

`FAN-00F` 判定为 **PASS（受控实验直连方案与时序约束范围）**。下一步为 `FAN-01`：风扇及 12 V 仍完全不接，在 `PC7/D9` 与 Node A `3V3` 之间加一只外部 `10 kΩ` 上拉电阻，再用示波器以 Node A GND 为参考验证约 25 kHz / 50% 的开漏低压侧波形；通过前不得进行风扇公共地和 PWM 联调。

## 19. FAN-01 PC7 开漏波形固件准备（2026-10-12）

Node A 在 CubeMX 既有 `TIM3 Full Remap / TIM3_CH2 / PC7 / AF Open-Drain / ARR=2559 / PSC=0` 基础上新增以下最小逻辑：启动 `HAL_TIM_PWM_Start(&htim3, TIM_CHANNEL_2)`，把 `CCR2` 设为 `1280`，从而在 64 MHz TIM3 时钟下生成精确 `25 kHz / 50%` 的复用开漏输出。原 H2 CAN 任务、报文和日志保留，另增一行 `H3,A,FAN_PWM_PROBE,pin=PC7,timer=TIM3_CH2,freq_hz=25000,duty_pct=50,mode=af_od` 用于镜像/运行身份绑定。

STM32CubeIDE 2.2.0 随附 GNU Tools for STM32 14.3.1 单线程构建成功，无编译警告或错误：`text/data/bss/dec=33692/96/14008/47796`；`node_a.elf` 大小 `1096932` bytes，SHA-256=`F3924691E9E3950200226378AD05B71410948F0627F4171017C626AA43B3D496`。构建产物依既定 `.gitignore` 不进入仓库。

构建后只读列举结果为 `No ST-Link detected`，因此本节只证明源码与本地构建，**尚未刷写，不证明 PC7 实板波形**。定向刷写前必须由执行人确认：风扇适配器已断市电且残压 `<0.5 V`，风扇的 Power/PWM/Tach 全部与 Node A 隔离，只接 Node A USB。刷写后才允许用外部 `10 kΩ` 把 PC7/D9 上拉到同一块 Node A 的 `3V3`，然后以 Node A GND 为参考测量。

执行人随后确认刷写前状态已就绪：只接 Node A USB，风扇和 12 V 保持隔离。STM32CubeProgrammer 只读列举中只有冻结的 Node A ST-LINK 序列号 `066BFF575151676667043206`，VCP 为 `COM7`；连接后读得 `3.24 V / Device ID 0x410 / Rev X / 128 KiB / Cortex-M3`，与既有身份基线一致。

按该序列号定向写入 SHA-256 为 `F3924691E9E3950200226378AD05B71410948F0627F4171017C626AA43B3D496` 的 `node_a.elf`，STM32CubeProgrammer 返回 `File download complete`、`Download verified successfully`，并完成软件复位。复位后以 `115200 8N1` 在 COM7 回读到：

```text
H2,A,BOOT,profile=formal_baseline,bitrate=500000,tx_id=0x180,tx_dlc=5,rx_id=0x100,rx_dlc=2,period_ms=100,start_delay_ms=10000
H3,A,FAN_PWM_PROBE,pin=PC7,timer=TIM3_CH2,freq_hz=25000,duty_pct=50,mode=af_od
H2,A,STAT,...,tx_fail=0,...,q_drop=0,...,hal_err=0x00000000,esr=0x00000000
```

连续 4 条状态行的 `hal_err/esr` 均为 `0`，因此 `FAN-01` 的构建、目标身份、刷写校验与镜像运行身份判定为 **PASS**。截至该刷写检查时，波形电压、频率、占空比和稳定性尚待示波器实测，因此当时的 `FAN-01` 整体状态为 **IN PROGRESS**；后续关闭结果见第 20 节。

## 20. FAN-01 PC7 开漏空载波形验收（2026-10-12）

风扇、12 V、Tach、Heater 与 INA260 保持隔离。Node A 断电后，现场在 `D9/PC7` 与同一块 Node A `3V3` 之间接入外部 `10 kΩ` 上拉，示波器以 Node A GND 为参考。上电前报告 `D9—3V3=9.982 kΩ`，`3V3—GND` 和 `D9—GND` 均不蜂鸣，通过无源短路预检。

执行人的 10 s 结构化报告为：

> `FAN-01：D9-3V3=9.982kΩ；3V3-GND/D9-GND均不蜂鸣；Vmax=3.48V，Vmin=-40mV，频率=25.03kHz，周期=40.02µs，占空比=50%；10秒稳定。`

同步原始示波器照片屏显捕获到 `25.01 kHz / 39.98 µs / Vmax=3.48 V / Vmin=-80 mV / Vavg=1.60 V`，波形为连续稳定方波。执行人说明自动测量数值在观察期间有几十毫伏量级的末位摆动，因此文字报告的 `-40 mV` 与照片瞬时屏显 `-80 mV` 分别保留，不将任一值改写成唯一常数。这些小幅差异与边沿过冲/欠冲、1X 探头接地回路和自动统计刷新的组合影响一致；当前没有出现平台漂移、周期结构丢失或 10 s 不稳定证据。

以固件目标 `25.000 kHz / 40.000 µs / 50%` 计算，文字报告的频率误差约 `+0.12%`、周期误差约 `+0.05%`，占空比命中目标。电平满足 3.3 V 上拉与近地下拉的预期，且上拉电阻实测与标称一致。据此 `FAN-01` 判定为 **PASS（PC7 开漏空载波形范围）**。它证明 MCU 低压侧输出的引脚、模式、频率、占空比和短时稳定性；不证明风扇负载下的实际 PWM 电平、转速响应、Tach/PPR、EMC 或长期稳定性。

原始照片、文件大小、SHA-256 和照片屏显/口述值边界见 [`2026-10-12 硬件证据`](../../evidence/hardware/H3/2026-10-12/README.md)。下一授权点为 `FAN-02A` 固定 50% 单风扇联调；全断电改线时必须先拆除 FAN-01 的外部 `10 kΩ` 上拉，风扇内部上拉将取代它。

## 21. FAN-02A 固定 50% 单风扇联调（2026-10-12）

现场在全断电状态拆除了 `FAN-01` 使用的外部 `10 kΩ` 上拉，只保留 `Node A GND↔F1/GND↔PSU-`、`D9/PC7↔F4/PWM` 和 `PSU+↔F2/+12 V`；`F3/Tach`、PST 额外接口、Heater 与 INA260 均继续隔离。无源检查正常。上电严格按 Node A USB 在先、风扇 12 V 在后的顺序执行，关闭时按风扇 12 V 在先、Node A USB 在后的相反顺序执行。

执行人报告：

> `FAN-02A：外部10k已拆；无源检查正常；风扇起转正常；10秒稳定正常；PWM Vmax=4.92V、Vmin=-40mV、频率=25.02kHz、周期=40微秒、占空比50%；USB无断连重连；已按顺序断电。`

接入真实风扇后，PWM 高电平由风扇内部上拉形成；实测 `4.92 V` 与此前风扇独立上电时的开路值 `4.850 V` 同属约 5 V 电平，且低于既有接口依据的 `5.25 V` 绝对上限。低电平 `-40 mV` 属近地小幅欠冲观察值，远低于 `0.8 V` 低电平上限。相对 `25.000 kHz / 40.000 µs / 50%` 目标，频率误差约 `+0.08%`，周期和占空比命中目标；10 s 内风扇转动、Node A 和 USB 均未见异常。

据此 `FAN-02A` 判定为 **PASS（固定 50% 单风扇短时电气/功能联调范围）**。它证明真实风扇负载下的公共地、PWM 直连、内部上拉、电平、频率、占空比、短时起转以及 USB 稳定性；不证明占空比变化与转速的方向性、低于 5% 的停转行为、Tach/PPR、转速绝对值、长期可靠性或最终线束时序保证。

下一授权点为 `FAN-02B`。先在风扇和 12 V 完全隔离的状态下生成并定向刷写受控占空比测试镜像，再通过镜像身份和空载输出复核后，才允许按相同电源时序重新接入单只风扇；Tach、Heater、INA260 仍保持隔离。

## 22. FAN-02B 受控占空比镜像准备（构建于 2026-10-12；续录于 2026-10-13）

为避免靠随机改值或主观计时判断转速变化，Node A 新增一次性、按键触发的确定性测试序列。上电默认保持 `50%`；按一次蓝色 `B1 USER` 键后依次输出 `100%→50%→25%→0%→100%`，每档 `10 s`，结束自动恢复 `50%`。`ARR=2559` 下，各档 `CCR2` 分别为 `2560/1280/640/0/2560`。B1 中断只置位请求标志，`A_ControlTask` 负责档位切换和 `FAN_PWM_STEP` 日志；活动序列期间的按键抖动及额外按压被丢弃，不会重入测试。

构建实际完成于 `2026-10-12 20:33:14`；本节于 `2026-10-13` 继续整理，因此保留日期差异。STM32CubeIDE 2.2.0 随附 GNU Tools for STM32 14.3.1 单线程 clean build 返回成功且无警告/错误：`text/data/bss/dec=34264/96/14008/48368`；ELF 大小 `1099336` bytes，SHA-256=`F499425FBF1D7931FF2BB6A8FDE3CF87A4D3BD8C2002BEA670C938D88CF0D2A1`。H2 `BOOT/STAT` 及 H3 `PROFILE/STEP/PROFILE_DONE` 字符串均在 ELF 中检出；`A_ControlTask` 的 2048-byte 配置栈相对新增路径的 248-byte 最大单函数静态记录保有明显余量。

完整规范化摘要见 [`2026-10-12 软件证据`](../../evidence/software/H3/2026-10-12/README.md)。据此 `FAN-02B` 在 2026-10-12 构建时点的 **源码实现与本地构建 PASS**，但该时点尚未刷写、未运行，不能提前判定实板响应通过。后续定向刷写和运行身份结果见第 23 节。

## 23. FAN-02B 定向刷写与运行身份（2026-10-13）

现场确认仅 Node A USB 上电，风扇 12 V、PWM、Tach、Heater 和 INA260 均隔离；既有 CAN 线束保持原样，避免为本测试反复扰动已通过 H2 的接线。受限执行环境内的 CubeProgrammer 最初无法打开 WinUSB，虽返回 `No ST-Link detected / DEV_CONNECT_ERR`，Windows PnP 同时显示 `ST-Link Debug / WinUSB 2.2.0.0 / Started / ProblemCode=0 / COM7`。改为在受限环境外只读枚举后只发现冻结的 Node A 序列号 `066BFF575151676667043206`，因此前述失败归为执行环境访问边界，不作为硬件断连；失败尝试没有写入。

刷写前 ELF 再次核验为 `1099336` bytes、SHA-256=`F499425FBF1D7931FF2BB6A8FDE3CF87A4D3BD8C2002BEA670C938D88CF0D2A1`，与 2026-10-12 构建证据一致，Git 工作区为空。按精确序列号连接回读 `3.23 V / Device ID 0x410 / Rev X / 128 KiB / Cortex-M3`；定向写入后 CubeProgrammer 返回 `File download complete`、`Download verified successfully`、软件复位和退出码 `0`。

随后先打开同一探针的 `COM7 @ 115200 8N1`，再按同一序列号触发一次软件复位。运行身份命中：

```text
H2,A,BOOT,profile=formal_baseline,bitrate=500000,tx_id=0x180,tx_dlc=5,rx_id=0x100,rx_dlc=2,period_ms=100,start_delay_ms=10000
H3,A,FAN_PWM_PROFILE,pin=PC7,timer=TIM3_CH2,freq_hz=25000,idle_pct=50,sequence=100-50-25-0-100,hold_ms=10000,trigger=B1,mode=af_od
H2,A,STAT,...,tx_fail=0,...,q_drop=0,...,hal_err=0x00000000,esr=0x00000000
```

约 6 s 内捕获的 7 条空载 `STAT` 均为 `hal_err/esr=0`。据此 `FAN-02B` 的 **目标身份、镜像不可变性、刷写、读回校验、复位与运行身份 PASS**。规范化原始结果、日期差异及证据边界见 [`2026-10-13 软件证据`](../../evidence/software/H3/2026-10-13/README.md)。

下一准入点为风扇隔离条件下的动态低压波形验证：Node A 断电后，在 `D9/PC7` 与同一块 Node A `3V3` 间恢复外部 `10 kΩ` 上拉，以 Node A GND 为示波器参考；上电默认 50%，按一次 B1 后验证 `100→50→25→0→100→最终50%`。在 100%/0% 恒定电平档不以示波器“频率”自动读数作为判定依据，而以平台电压、档位顺序和持续时间为准。该步骤通过前不接风扇 12 V/PWM/Tach。

## 24. FAN-02B 低压动态波形与测试干扰隔离（2026-10-13）

风扇 12 V/PWM/Tach、Heater 和 INA260 均保持隔离，既有 CAN 线束不动。Node A 断电后恢复 `D9/PC7→10 kΩ→3V3`，无源预检得到 `D9—3V3=9.985 kΩ`，`3V3—GND`、`D9—GND` 均不蜂鸣；重新上电后默认 `25 kHz / 50%` 稳定。

第一次按 B1 时同时打开了 COM7 监听。现场先看到 100% 约 10 s、50% 约 10 s，随后 25% 仅约 1 s，0% 和后续 100% 均未出现，直接恢复 50%；该突变与外部监听进程异常结束处于同一时段。源码复核确认正常路径每次只允许 `profile_index` 加一并重建 10 s deadline，不存在从 25% 合法跳过两档进入完成态的路径，而 MCU 复位初始化会立即恢复 50%。因此第一次结果标记为 **INVALID / 测试工具干扰**，既不算通过，也不算固件失败。

随后保持全部硬件、示波器设置和最终 50% 状态不变，不复位、不重新插拔 USB，完全取消 COM7/ST-Link 访问后再次只按一次 B1。执行人确认 `100%→50%→25%→0%→100%→最终50%` 每个档位均按顺序完整出现，没有提前跳档。人工观察支持每档约 10 s，不把该结果扩写为毫秒级定时精度。

据此 `FAN-02B` 判定为 **PASS（低压动态波形范围）**：B1 单次触发、五档顺序、电平形态和结束恢复 50% 已通过。Run01/Run02 的差异作为测试工具会改变被测系统状态的实操证据完整保留。规范化记录与哈希见 [`2026-10-13 硬件证据`](../../evidence/hardware/H3/2026-10-13/README.md)。下一准入点为全断电拆除外部 10 kΩ 后的单风扇真实五档响应；Tach、Heater、INA260 继续隔离。

## 25. FAN-02B 单只真实风扇五档响应（2026-10-13）

全断电接线前，现场确认外部 `10 kΩ` 已拆、PSU 残压为 `0 V`，公共 GND 链路、`D9↔F4/PWM`、`PSU+↔F2/+12 V` 均稳定蜂鸣，`PSU+↔GND` 不蜂鸣，`F3/Tach` 和 PST 分支空置。执行中严格采用 Node A USB 先上电、风扇 12 V 后上电；完成后先断风扇 12 V、确认残压，再断 Node A USB。为避免复现第 24 节 Run01 的测量干扰，本次不打开 COM7、不访问 ST-Link。

执行人结构化报告为：

> `FAN-02B真实风扇：默认50%=通过；100%=稳定；50%=稳定；25%=稳定；0%=稳定停转；再次100%=稳定；最终50%=稳定；PWM约25kHz，高/低电平5.04V/-160mV；USB是否断连=否；异常=无；已逆序断电，残压=0.04V。`

结果证明同一只真实风扇在 100%、50%、25% 档具有方向正确且稳定的相对响应，0% 可稳定停转，随后 100% 可重新起转，序列结束能恢复 50%。真实负载下 PWM 高电平 `5.04 V` 低于既定 `5.25 V` 上限；低电平 `-160 mV` 作为边沿/探测回路相关的小幅负向欠冲原样保留，其量级远低于 `0.8 V` 低电平上限，且没有伴随 USB 断连、平台异常或功能失效。结束残压 `0.04 V < 0.5 V`。

据此 `FAN-02B` 判定为 **PASS（单只真实风扇五档短时响应范围）**，Fan PWM 子项 `FAN-00A～FAN-02B` 整体关闭为 **PASS**。完整结构化记录及哈希见 [`2026-10-13 硬件证据`](../../evidence/hardware/H3/2026-10-13/README.md)。该结论不证明 Tach/PPR、绝对 RPM、长期耐久、最终线束或温控闭环；下一步转入 Tach/PPR 独立准入，接入任何 MCU 引脚前必须先确认 F3 的开路电气特性和上拉边界。

## 26. TACH-00A 文档/源码审计与隔离准入（2026-10-13）

既有接口基线冻结 Node A 风扇 Tach 为 `F3/Tach → PA0/A0（CN7-28）→ TIM2_CH1`，下降沿输入捕获，外部 `4.7 kΩ` 上拉到 Node A `3V3`；TIM2 在 64 MHz 时钟下配置 `PSC=639`、`ARR=65535`，计数频率为 `100 kHz`，中断优先级为 6。H0 原始物料证据中的 `R4K7-01` 静态实测约 `4.701 kΩ`，可作为本子项的指定上拉电阻。前序 `FAN-00C～FAN-00E` 已通过延长线和 PST 分支逐点映射冻结 `F1=GND、F2=+12 V、F3=Tach、F4=PWM`，因此不再靠线色或连接器外观猜测 F3 身份。

2026-10-13 源码复核确认：`.ioc` 与生成的 `tim.c` 已把 PA0 配置为 TIM2_CH1、下降沿、直连输入、无内部上下拉，且生成 TIM2 IRQ；但当前 `main.c` 只调用 `MX_TIM2_Init()`，没有 `HAL_TIM_IC_Start_IT()`，项目中也没有 `HAL_TIM_IC_CaptureCallback()` 或捕获值/RPM 计算实现。因此当前镜像只能作为 PWM 已验证镜像，**不能**把“TIM2 已配置”写成“Tach 已运行”。

首轮硬件只做 F3 电气表征，不连接 PA0/A0：保持既有 `F1/GND、F2/+12 V、F4/PWM` 回路，新增 `Node A 3V3 → R4K7-01 → F3/Tach`，示波器探头接 F3、地夹接公共 GND，PA0/A0 明确悬空。全断电先验证上拉阻值、F3 无低阻短路、3V3-GND 无低阻短路；随后严格 Node A USB 先上电、风扇 12 V 后上电。先记录风扇未供 12 V 时 F3 的静态上拉电压，再在默认 50% 转速下记录 F3 的高/低电平、频率、周期和 10 s 稳定性。只有确认波形被限制在 3.3 V 逻辑域且无异常尖峰/平台后，下一轮才允许把同一 F3 节点并接 PA0/A0。

本轮不改固件、不打开 COM7、不访问 ST-LINK，也不按 B1 跑占空比序列；其目的仅是把未知 Tach 输出类型和电平边界变成实测事实。PPR、RPM 和绝对转速继续保持 TBD，不能仅凭一个频率或行业常见值预填。

## 27. TACH-00B F3 隔离电气表征（2026-10-14）

按第 26 节的隔离方案执行，`R4K7-01` 本次实测 `4.702 kΩ`；全断电下 `F3-GND`、`F3-F2/+12 V` 和 `3V3-GND` 均不蜂鸣。F3 没有连接 A0/PA0。Node A 单独上电、风扇 12 V 仍关闭时，F3 对地为 `3.30 V` 且 10 s 稳定，证明外部上拉工作且未观察到未供电风扇把 F3 强行钳低。

随后给风扇 12 V 上电并保持 Node A 默认约 50% PWM，F3 得到 `Vmax=3.36 V`、`Vmin=0.00 V`、`46.38 Hz`、`21.56 ms`、Tach 方波占空比约 `50%`；频率与周期互为倒数。10 s 内无 USB 断连或其他异常，执行人将总体稳定性描述为“姑且稳定”，并明确报告所有示波器自动读数均有小幅跳变、高电平两侧呈周期性上翘或下拉闪动。完成后按既定顺序断电，残压 `0.4 V < 0.5 V`。

据此 `TACH-00B` 判定为 **PASS（仅限 F3 隔离电气域、方波存在性与短时稳定性）**：当前 4.7 kΩ 上拉方案把 F3 限制在 3.3 V 逻辑域，未显示 5 V/12 V 误入风险。同步打开 `OBS-TACH-01`，不把边沿闪动直接写成风扇故障，也不在缺少放大波形时忽略它。下一步仍保持 A0/PA0 隔离，以 10X 探头、Peak Detect 和边沿放大确认是否存在能够二次越过输入阈值的真实毛刺；通过后才放行 PA0 输入捕获接线。`46.38 Hz` 不等于 RPM，PPR 继续保持 TBD。规范化原始报告见 [`2026-10-14 硬件证据`](../../evidence/hardware/H3/2026-10-14/README.md)。

## 28. TACH-00C 边沿视图识别出 PWM 同频尖脉冲（2026-10-14）

执行人保持 A0/PA0 断开，将探头及 CH1 均改为 10X，以 Peak Detect 观察 30 s，报告 `Vmax=3.60～3.88 V`、`Vmin=-1.92～-2.16 V`、自动频率读数从 `42.13 Hz` 短时闪至 `8.621 kHz`，Average 16 后闪动减弱；USB 无断连、无其他异常，并按逆序断电。两张原始照片完整归档。

照片复核发现，在 `25 us/div` 下屏幕重复结构的自动测量不是约 46 Hz Tach，而是约 `24.97～25.00 kHz / 40.00～40.05 us`，与已验证的风扇 PWM 完全同量级。由于全屏仅约 250 us，不可能显示多个 `21.56 ms` Tach 周期；画面实际是 Tach 高/低平台上叠加的 PWM 同频尖脉冲，示波器触发和自动频率已锁定该尖脉冲。因此本轮无法判断真正 Tach 上升/下降沿是否二次穿越 1.6 V，也不得把闪出的 kHz 数字解释为 RPM。

据此 `TACH-00C` 标记为 **HOLD（需源头隔离，不是风扇故障结论）**。报告的 `3.88 V / -2.16 V` 可能是探头地回路、F3/F4 线间耦合、公共地噪声或真实窄毛刺；在完成隔离前不放行 PA0，尤其当前 TIM2 `ICFilter=0`，即使窄毛刺不造成永久电气损伤也可能被误计为捕获边沿。下一步用相同探头设置按“F4 接通/断开、风扇 12 V 关闭/开启”的受控矩阵定位 25 kHz 成分来源，每次改变接线前均完全断电。详细逐屏读数、原始图片哈希和证据边界见 [`2026-10-14 硬件证据`](../../evidence/hardware/H3/2026-10-14/README.md)。

## 29. TACH-00D F4/PWM 源头隔离（2026-10-14）

执行人全断电后保持 F3 的 `4.7 kΩ→3V3` 上拉和 A0/PA0 隔离，完全断开 F4/PWM。
无源复核报告中，F3 测量点对 F3、F4 的结果均记为“正常”；因未另报蜂鸣状态或阻值，
本记录不把该用语扩写为额外定量结果。

只有 Node A USB 上电时，F3 平台为 `3.26 V`，观察范围 `3.16～3.36 V`，此前每约
`40 us` 重复的 25 kHz 尖脉冲消失。随后给风扇 12 V 上电、F4 仍断开，尖脉冲仍未
复现；执行人报告总体范围 `-0.12～3.48 V`。25 us/div 原始照片显示一个干净的真实
Tach 上升沿，没有 PWM 同频重复脉冲；5 ms/div 照片显示多个规则周期，屏幕读数为
`91.58 Hz / 10.92 ms / -80 mV～3.36 V`。文字报告与不同照片采集帧的瞬时极值均
原样保留，不合并成虚假的唯一常数。USB 无断连，无其他异常；完成后逆序断电并恢复
F4，残压由执行人报告为正常，但未给出定量值。

该 A/B 对照把 `OBS-TACH-01` 的 25 kHz 成分定位到 **F4/PWM 接通路径造成的耦合**：
它不是 Tach 的真实脉冲频率，且在 F4 断开、风扇 12 V 仍开启时消失，不支持把电机或
公共地噪声视为主要来源。当前证据还不能区分耦合发生在风扇内部、四芯线/延长线、
外部跳线并行段还是探测布线，因此不宣称具体物理耦合点已经确定。

F4 断开后的 `91.58 Hz` 相对默认 50% PWM 时的 `46.38 Hz` 为约 `1.974` 倍，与
控制输入撤除后的转速提高相符；但 PPR 尚未由独立证据确认，不能据此换算或宣称绝对
RPM。`TACH-00D` 判定为 **PASS（F4/PWM 来源隔离与真实 Tach 识别范围）**。

正常系统必须恢复 F4；而 F4 恢复后尚未加入抑制措施，TACH-00C 的 `3.88 V / -2.16 V`
瞬态和阈值误穿越风险仍然成立。因此 PA0/A0 继续 HOLD。下一步只允许保持 PA0 断开，
先以无破坏方式分离 F3 与 F4 的外部跳线/探测回路并复测；若尖脉冲仍越过阈值，再冻结
具体 RC 输入滤波和 TIM2 数字滤波方案。不得剪断原装风扇线或完整延长线。原始照片、
逐屏读数与文件哈希见 [`2026-10-14 硬件证据`](../../evidence/hardware/H3/2026-10-14/README.md)。

## 30. TACH-00E 外部布线分离无效（2026-10-14）

F4/PWM 恢复正常接线，A0/PA0 继续隔离。执行人完成四项无源检查后，把可接触的
F3/Tach 与 F4/PWM 外露跳线尽量拉开，探测回路也远离 F4；Node A USB 和风扇 12 V
按既定顺序上电。USB 无断连，无其他异常，完成后逆序断电，A0 始终未接。

5 ms/div 的 Peak Detect 照片同时显示低频 Tach 平台和密集尖脉冲，屏幕读数为
`43.18 Hz / 23.16 ms / Vmax=3.72 V / Vmin=-2.16 V`。25 us/div 照片把尖脉冲
解析为 `24.98 kHz / 40.02 us`，该帧为 `Vmax=3.72 V / Vmin=-1.68 V`。因此本轮
最差组合极值记录为 `3.72 V / -2.16 V`，真实 Tach 记录为 `43.18 Hz / 23.16 ms`。

高平台约 3.3 V，而重复负向尖脉冲下降至 1.6 V 以下，所以每个尖脉冲都可能产生额外
下降阈值穿越；对当前 `TIM2 falling edge + ICFilter=0` 配置属于明确的假计数风险。
据此，`TACH-00E` 在受控诊断执行范围为 PASS，但“仅靠外露布线分离”作为抑制措施判定
为 **NOT EFFECTIVE**，PA0 接入继续 **HOLD**。该结果说明主要耦合不只来自可分开的
外露并行跳线，但仍不足以在完整延长线、风扇内部与其他不可分离路径之间指定唯一位置。

下一门禁不再反复调线，而是在 PA0 前搭建可拆卸 RC 测试节点，PA0 本身仍不连接：

```text
原上拉：Node A 3V3 ---- 4.7 kΩ ---- F3 raw

F3 raw ---- 10 kΩ series ----+---- filtered test point（暂不接 PA0）
                              |
                             10 nF
                              |
                             GND
```

串联输入支路名义 `10 kΩ×10 nF=100 us`、截止频率约 `1.59 kHz`；开集电极释放后的
上升过程还包含原 4.7 kΩ 上拉，名义上升时间常数约 `147 us`。这些时间尺度远短于当前
约 `43～92 Hz` 的真实 Tach 周期，同时比 25 kHz 干扰周期更适合做低通抑制；但是否
足够必须由正常 F4 接法下的 Peak Detect 实测确认，不能只凭计算放行。通过条件至少包括：
滤波点无额外 1.6 V 阈值穿越，极值回到 PA0 安全域，真实 Tach 周期仍可稳定识别，USB
无断连。详细照片和逐屏判读见
[`2026-10-14 硬件证据`](../../evidence/hardware/H3/2026-10-14/README.md)。

## 31. TACH-00F 可拆卸 RC 滤波通过（2026-10-14）

PA0/A0 继续断开，正常 F4/PWM 接法保持不变。现场在原 `3V3→4.7 kΩ→F3 raw`
上拉之后增加 `F3 raw→10 kΩ→filtered test point`，并从 filtered test point 接
`10 nF` 到公共 GND。该节点只接示波器，不接 MCU。

断电检查得到 `F3 raw→filtered=9.997 kΩ`，filtered→GND、3V3→GND、F3 raw→F4
均不蜂鸣。只有 Node A USB 上电时，filtered test point 为 `3.214 V`。正常顺序加入
风扇 12 V 后，执行人报告 Peak Detect 的另一短时窗口为 `Vmax=2.00 V / Vmin=-120 mV`，
25 kHz 残余不可见；完整 5 ms/div 照片则显示 `47.97 Hz / 20.85 ms /
Vmax=3.40 V / Vmin=-40 mV / Vavg=1.67 V` 的规则方波。短时窗口的 2.00 V 没有覆盖
完整高平台，因此不代替照片中的 3.40 V 逻辑高电平；跨采集状态最差负向极值保留
`-120 mV`。

1.6 V 判读使用波形几何而不是示波器触发电平：正常方波每周期应在上升沿和下降沿各
通过中间阈值一次；此前 25 kHz 负向尖脉冲会在高平台反复从阈值上方冲到下方，形成
额外下降穿越。本轮照片中边沿单调、平台无反弹，结合 25 kHz 残余不可见，判定为
**没有额外穿越 1.6 V**。屏幕右下角约 `557 mV` 是当时的示波器触发设置，不是 MCU
输入阈值。

本轮完整逻辑摆幅和跨采集最差负向极值均在临时准入范围 `-0.3～3.6 V` 内，真实 Tach
频率/周期互为倒数，USB 无断连且无其他异常。`TACH-00F` 判定为 **PASS（PA0 隔离条件
下的 RC 电气滤波范围）**。这证明 `10 kΩ series + 10 nF to GND` 在当前实物接法下
能够保留真实 Tach 并消除可见的 PWM 同频额外阈值穿越，但不提前证明 PA0 负载影响、
TIM2 捕获、数字滤波、PPR、RPM 或长期运行。

下一门禁为 TACH-00G：全断电后只把 filtered test point 并接 Node A A0/PA0，保持
现有固件尚未启动 TIM2 捕获，在同一点复测静态电压、完整方波与 Peak Detect。通过前
不得修改或刷写 Tach 捕获固件。

## 32. TACH-00G PA0 高阻输入负载复测通过（2026-10-14）

全断电后，现场只把 RC filtered test point 接入 Node A CN8/A0（PA0），F3 raw、
4.7 kΩ 上拉、`10 kΩ + 10 nF` RC 和 F4/PWM 均保持 TACH-00F 的状态。断电检查中，
filtered→A0 蜂鸣，A0→GND、3V3→GND、A0→F4 均不蜂鸣；仅 Node A 上电时 A0 为
`3.234 V`。

接入 A0 后从 F3 raw 到 A0 的电阻档得到红黑 `7.016 kΩ`、黑红约 `4.65 kΩ` 且缓慢
下降。这不是对孤立 10 kΩ 元件的重复测量：测试电流同时进入 4.7 kΩ 上拉、未上电
3V3 网络、PA0 输入保护结构以及 RC/板载电容充电路径，所以出现方向性和时间变化。
串联元件本身继续以 TACH-00F 隔离实测 `9.997 kΩ` 为准；其他节点不蜂鸣、上电静态
电平和运行波形均正常，因此没有低阻短路或异常输入负载证据。

5 ms/div 照片显示 `45.77 Hz / 21.85 ms / Vmax=3.44 V / Vmin=-80 mV /
Vavg=1.67 V` 的连续规则方波。25 us/div Peak Detect 照片显示单调 RC 上升曲线，
窗口内 `Vmax=2.12 V / Vmin=-120 mV`；2.12 V 只是尚未走完整个高平台的局部边沿值。
画面没有每 40 us 重复的尖脉冲或凹口，曲线只通过 1.6 V 一次，故照片代填为
`25 kHz 残余=无、额外穿越 1.6 V=无`。RC 圆滑边沿是约 147 us 名义释放时间常数的
预期表现，不是新的故障。

完整摆幅和跨采集最差负向极值均位于临时准入范围 `-0.3～3.6 V`，USB 无断连且无
异常，逆序断电后残压安全。`TACH-00G` 判定为 **PASS（RC 后 PA0 高阻输入负载与短时
电气波形范围）**。至此 Tach 接入 MCU 前的低压电气准入关闭，可进入受控 TIM2 输入
捕获固件验证；TIM2 捕获、数字滤波、PPR、绝对 RPM 和长期运行尚未由本轮证明。

## 33. TACH-01A 原始输入捕获镜像离线准备（2026-10-14）

以 `4095e38` 为代码基线，在 TACH-00G 通过后只增加 TIM2_CH1 下降沿中断捕获和每秒
原始证据日志。TIM2 继续使用 `PSC=639 / ARR=65535 / 100 kHz / 10 us per tick`；
硬件 RC 保持 `10 kΩ + 10 nF`，本轮 `ICFilter=0`，以便先独立验证 RC 后进入 PA0 的
真实捕获结果。ISR 只保存捕获值、模 65536 周期差、窗口最小/最大值和计数；串口输出
留在 A_ControlTask，且所有日志明确写入 `ppr=TBD / rpm=INVALID`。

STM32CubeIDE 2.2.0 随附 GNU Tools for STM32 14.3.1 单线程 clean build 成功，无编译或
链接警告/错误：`text/data/bss/dec=36128/100/14036/50264`。`node_a.elf` 大小
`1102084` bytes，SHA-256=`0ED42C02BBE2AC79CF08589F5560ECE0C612A4D2869642B473C4FC7C7FFA954C`；
三个新增符号及 `TACH_CAPTURE_PROFILE / TACH_RAW / ppr=TBD / rpm=INVALID` 字符串均在
ELF 中检出。最大新增单函数静态栈记录为 `456` bytes，相对 A_ControlTask 的
`2048`-byte 配置栈保有余量。

本节只关闭 **TACH-01A 离线构建门禁**，尚未刷写。下一步在风扇 12 V 断开、RC/A0
保持不变时按 Node A 冻结序列号定向刷写，先证明无供电风扇不会产生伪边沿，再加入
12 V，以默认 50% 对比 UART 原始周期与示波器 `21.85 ms / 45.77 Hz`。详细构建记录见
[`2026-10-14 软件证据`](../../evidence/software/H3/2026-10-14/README.md)。

## 34. TACH-01A 原始输入捕获实板否决（2026-10-19）

10 月 14 日构建的原始捕获镜像于 10 月 19 日执行实板门禁，时间差按真实推进过程保留。
刷写前 Windows 只枚举冻结的 Node A：ST-Link 序列号
`066BFF575151676667043206`、COM7；目标 ELF 大小 `1102084` bytes、SHA-256
`0ED42C02BBE2AC79CF08589F5560ECE0C612A4D2869642B473C4FC7C7FFA954C`，下载、校验和
软件复位均成功。

风扇 12 V 断开时连续约 12 s、12 个窗口始终为 `WAIT_FIRST_EDGE`，`edge_total=0`、
`sample_total=0`、`zero_delta=0`，因此无供电零边沿基线通过。随后给风扇 12 V 上电，
默认 50% 稳定段在 14.469 s 内增加 5095 个捕获边沿，即 `352.13 edge/s`；其中非零
周期样本平均 `316.54 sample/s`，零差值平均 `35.59/s`。窗口最小周期反复为
`1 tick=10 us`，最后周期常为 `10～40 us`，与 TACH-00G 的示波器参考
`45.77 Hz / 21.85 ms` 不符，边沿率约高 `7.69` 倍。

源码静态复核未发现第二通道或重复回调：只启动 TIM2_CH1，回调同时检查 TIM2 实例与
活动通道并只读一次 CCR1。故 `TACH-01A` 判定为 **FAIL（ICFilter=0 原始捕获准入）**。
这不推翻 TACH-00F/00G 的低压电气安全结论，也不是风扇损坏结论；它证明硬件 RC 后的
可见平滑波形仍不足以保证 MCU 无重复阈值触发，不能直接用于 RPM。

下一步 `TACH-01B` 只把 TIM2 `ICFilter` 从 0 改为 15，保持 CKD=DIV1、RC、下降沿、
100 kHz 计时和默认 PWM 不变，再重复同一两段门禁。PPR/RPM 继续为 TBD/INVALID。
完整原始记录见 [`2026-10-19 软件证据`](../../evidence/software/H3/2026-10-19/README.md)。

## 35. TACH-01B TIM2 最大数字滤波镜像离线准备（2026-10-19）

在 TACH-01A 实板否决后，本轮只把 `H3_TACH_INPUT_FILTER` 从 0 改为 15；TIM2 通道、
下降沿、`PSC=639 / ARR=65535 / 100 kHz / 10 us`、CKD=DIV1、硬件 RC、默认 50% PWM、
ISR 和日志格式全部保持不变。项目随附 HAL/LL 定义中，滤波值 15 对应
`fSAMPLING=fDTS/32、N=8`；当前名义采样频率约 2 MHz、连续稳定时间约 4 us。该计算只
说明参数含义，不能代替实板通过结论。

同一工具链完成单线程 clean build；Windows clean 规则的 `rm` 兼容提示被 Makefile 标为
ignored，随后所有源文件均重新编译并成功链接。尺寸仍为
`text/data/bss/dec=36128/100/14036/50264`；新 ELF 大小 `1102084` bytes，SHA-256
`30F937CECAC891A0F5A85BEB9662E198825036CAC55A3C57FB40D5CCBEBBEEAB`。静态栈结果与
TACH-01A 相同，Git 固件差异只有上述宏的一行。

本节只关闭 `TACH-01B` 离线构建门禁。实板顺序仍为：先断风扇 12 V、保持 RC/A0、
定向刷写并证明无供电零边沿，再加入风扇 12 V，在默认 50% 下要求每秒捕获数回到约
45～48、周期回到约 20～23 ms、`zero_delta` 不增长且不出现微秒级短周期。PPR/RPM
继续为 TBD/INVALID。构建详情见
[`2026-10-19 软件证据`](../../evidence/software/H3/2026-10-19/README.md)。

## 36. TACH-01B 实板部分改善但周期完整性否决（2026-10-19）

按冻结序列号 `066BFF575151676667043206` 定向刷写 TACH-01B，目标 ELF SHA-256 为
`30F937CECAC891A0F5A85BEB9662E198825036CAC55A3C57FB40D5CCBEBBEEAB`，下载、校验、
复位和启动身份回读均成功。风扇 12 V 断开后，从 tick=551 到 12935 连续 13 个窗口、
约 12.4 s 均为 `WAIT_FIRST_EDGE`，三项累计计数全部为 0，无供电零边沿基线通过。

默认 50% 实风扇稳定段从 tick=96582 到 116219，19.637 s 内增加 875 个边沿，平均
`44.56 edge/s`，每窗 44～48 个，`zero_delta_total=0`。这相对 TACH-01A 的
`352.13 edge/s` 是明显改善，主周期也集中在 `23.16～23.42 ms`。但是 20 个连续窗口
中有 15 个出现 `11.42～11.56 ms` 的约半周期最小值，另有 2 个出现 `1 tick=10 us`，
仅 3 个窗口的最短周期保持在完整主周期范围；tick=113117 的最后周期本身也为
`11.43 ms`。因此平均频率接近参考值并不能证明逐周期数据可信。

`TACH-01B` 判定为 **FAIL（捕获周期完整性）/ 显著改善但不准入 RPM**。COM7 全程稳定；
Node B 未上电造成的 CAN 无 ACK 日志属于已知旁路现象，不计入 Tach 失败。下一步
`TACH-01C` 只把 TIM2 CKD 从 DIV1 改为 DIV4，保持 `ICFilter=15`、计数 tick、RC、边沿、
PWM 和日志算法不变，使滤波 15 的名义稳定时间由约 4 us 延长到约 16 us，再重复同一
两段实板门禁。完整窗口见
[`2026-10-19 软件证据`](../../evidence/software/H3/2026-10-19/README.md)。

## 37. TACH-01C 延长 TIM2 数字滤波窗口镜像准备（2026-10-20）

承接 10 月 19 日 TACH-01B 的周期完整性失败，本轮唯一功能变量是把 TIM2 CKD 从 DIV1
改为 DIV4；`ICFilter=15`、PA0/TIM2_CH1、下降沿、`PSC=639 / ARR=65535`、硬件 RC、
默认 50% PWM、ISR 和原始统计均保持不变。CubeMX `.ioc` 同步保存 DIV4，启动身份新增
`ckd_div=4`，用于避免镜像混淆。计数器仍为 `100 kHz / 10 us`；滤波 15 的采样变为
`fDTS/32=500 kHz、N=8`，名义连续稳定时间由约 4 us 延长为 16 us。

2026-10-20 使用同一随附工具链单线程 clean build 成功，尺寸为
`text/data/bss/dec=36144/100/14036/50280`。ELF 大小 `1102172` bytes，SHA-256 为
`A0440CEECD3C0999210A3ABDF20B04D1315E3BA0E9A388BFCA44F9D5203E9DFE`。反汇编确认
MX_TIM2_Init 把 `0x200`（DIV4）写入 ClockDivision，ELF 身份串含 `ckd_div`；最大相关
静态栈仍为 H3_LogTachRaw 的 456 bytes。

本节只关闭 TACH-01C 离线构建门禁，尚未刷写。实板当前仍为 TACH-01B。下一步必须先
断风扇 12 V、确认残压 `<0.5 V`，保持 RC/A0 与 Node A USB，再定向刷写并依次执行
至少 10 s 无供电零边沿基线、至少 20 个默认 50% 连续窗口。通过必须同时满足平均率、
完整周期、最短周期和 zero_delta，不能只看平均频率。构建详情见
[`2026-10-20 软件证据`](../../evidence/software/H3/2026-10-20/README.md)。

## 38. TACH-01C 原始 Tach 捕获完整性通过（2026-10-20）

现场确认风扇 12 V 断开、Node A USB 单独上电、RC/A0 保持后，软件侧复核唯一 Probe 为
冻结 Node A SN `066BFF575151676667043206`、COM7、工作区为空及 TACH-01C ELF 哈希
`A0440CEECD3C0999210A3ABDF20B04D1315E3BA0E9A388BFCA44F9D5203E9DFE`。现场残压只报告
“正常”而非具体伏值，记录保留原话，不补写虚构数值。首次预检因同一 SN 同时出现在
Probe 与 UART 区块而在写入前安全停止；改为只统计 Probe 条目后确认 probes=1，随后
定向下载、校验和软件复位均成功，目标电压 3.24 V、Device ID 0x410。COM7 已打开时
再次复位，回读启动身份明确包含 `ic_filter=15,ckd_div=4,ppr=TBD,rpm=INVALID`。

同一次启动的无风扇段从 tick=552 到 15000，共 15 个窗口/14.448 s，始终为
`WAIT_FIRST_EDGE`，edge/sample/window/zero_delta 均为 0，零边沿基线通过。随后用户给
风扇 12 V 上电并确认稳定，PWM 仍为默认 50%；连续 25 个窗口从 tick=286741 到 311557，
24.816 s 内累计增加 1054 个边沿，即 `42.472598 edge/s`，每窗 43～45 个样本。

25 个窗口全部为 `PERIOD_VALID`；last_ticks 为 `2346～2372`，合并 window_min/max 为
`2333～2375 ticks`，即所有观测周期都在 `23.33～23.75 ms` 的同一完整周期带；即时频率
为 `42.158～42.625 Hz`。`zero_delta=0`，约 11.5 ms 半周期和 10 us/微秒级极短周期均为
0/25。相比 TACH-01B 的 17/20 个污染窗口，CKD=DIV4 在不改变 RC、ICFilter、边沿、
计数 tick 或 PWM 的情况下关闭了逐周期重复触发。

`TACH-01C` 判定为 **PASS（默认 50% 稳态下的原始 Tach 捕获完整性）**。该结论不外推
为 PPR、绝对 RPM、全 PWM 量程、停转/断线阈值或长期运行通过；PPR 仍为 TBD、RPM 仍为
INVALID。完整 25 窗口和主机操作边界见
[`2026-10-20 软件证据`](../../evidence/software/H3/2026-10-20/README.md)。

## 39. TACH-02A PPR 与全 PWM 档位原始量程通过（2026-10-20）

TACH-01C 原始周期完整性通过后，不改线、不刷写，直接复用既有 B1 五档序列，常驻监听
COM7 并以固件 `FAN_PWM_STEP` 作为档位边界。前两次监听因未收到 B1 而分别在约 180 s、
120 s 后正常退出；两段默认 50% 期间仍持续 PERIOD_VALID、zero_delta=0。第三次改为
跨回合常驻监听，用户明确回复 `B1已按` 后，完整捕获
`100→50→25→0→100→final 50%`，每档 10 s。

PPR 采用三项互相独立的一致证据：Intel QST 一手规范明确要求 4-wire fan 每转输出 2 个
Tach 脉冲；ARCTIC P8 PWM PST 官方规格给出 200～3000 RPM；同一实物在 TACH-00D 的
PWM 断开全速实测为 91.58 Hz，按 2 PPR 换算 2747 RPM。若取 1 PPR 则会得到约
5495 RPM，明显超过额定上限。因此 FAN-01 的 PPR 从 TBD 冻结为 2。

动态稳态范围为：第一次 100% `91.743～92.250 Hz / 2752～2768 RPM`，50%
`45.330～45.454 Hz / 1360～1364 RPM`，25% `19.436～19.661 Hz / 583～590 RPM`；
0% 后 9 个连续日志窗口无新边沿，edge/sample totals 冻结、age 从 1.289 s 增至
9.553 s；再次 100% 恢复到 `91.491～92.421 Hz / 2745～2773 RPM`，结束后自动回到
约 45.5 Hz 的 50% 档。全序列 zero_delta=0，没有半周期或微秒级伪周期复发。

`TACH-02A` 判定为 **PASS（PPR=2 + 原始全档位量程 + 停转/重启响应）**。同时发现
TACH-01C 在 0% 无新边沿时仍沿用最后周期并报告 PERIOD_VALID，这是尚未实现过期状态的
软件语义缺口，不是硬件故障。下一步 TACH-02B 增加 PPR=2 RPM 换算和 500 ms 数据新鲜
度门限；该门限约为本轮最慢正常周期 51.51 ms 的 9.7 倍，只用于阻止历史 RPM 冒充
当前值，不提前等同为 Stall/断线故障阈值。完整档位原始证据、来源 URL 和代表性窗口见
[`2026-10-20 软件证据`](../../evidence/software/H3/2026-10-20/README.md)。

## 40. TACH-02B RPM 与数据新鲜度镜像准备（2026-10-20）

承接 TACH-02A 发现的“0% 停转后仍沿用历史周期”语义缺口，本轮不改引脚、定时器、RC、
PWM、捕获 ISR 或 CubeMX 配置，只新增 `PPR=2`、500 ms 新鲜度和整数 RPM。状态冻结为
`WAIT_FIRST_EDGE / WAIT_SECOND_EDGE / PERIOD_VALID / STALE`；仅 PERIOD_VALID 输出
数值 RPM 和 `rpm_valid=1`，其余状态均输出 `rpm=INVALID,rpm_valid=0`。STALE 时仍保留
最后原始周期/频率供取证，但不再把它声明为当前转速。

500 ms 约为本轮实测最慢正常周期 51.51 ms 的 9.7 倍；按厂商最低 200 RPM、2 PPR
计算也容纳约 3.3 个周期。它只定义测量值何时过期，不提前等同于最终 Stall/断线确认
时间。CAN 0x180 的 RPM 字节仍保持 `FF FF`，故本轮不会越过单外设门禁偷接系统报文。

最终版本使用有界 32-bit 舍入除法，2026-10-20 由随附工具链单线程 clean build 通过，
无 warning/error；尺寸为 `text/data/bss/dec=36372/100/14036/50508`。ELF 大小
`1102472` bytes，SHA-256 为
`7A8B655F02A9F6F6EDA528C1C923BEC495516A09C36480AA775F427EFFA13F1E`。ELF strings、
公式代表向量、最坏日志长度、静态栈和 H2_SendFrame 反汇编均已交叉核验；
H3_LogTachRaw 静态栈为 528 bytes，任务配置栈仍为 2048 bytes。

本节只关闭离线实现与构建门禁，尚未刷写。实板下一步必须先断风扇 12 V并确认残压
`<0.5 V`，Node A USB 与 RC/A0 保持；定向刷写后依次做无 12 V 零边沿/INVALID 基线、
默认 50% 数值 RPM，以及 B1 五档中 0% 进入 STALE、再 100% 恢复 PERIOD_VALID 的动态
验收。完整构建身份与通过条件见
[`2026-10-20 软件证据`](../../evidence/software/H3/2026-10-20/README.md)。

## 41. TACH-02B RPM 与数据新鲜度实板通过（2026-10-20）

现场先确认风扇 12 V 断电、残压 `<0.1 V`、仅 Node A USB 上电且 RC/A0 保持。软件侧
复核唯一 Probe 为冻结 Node A SN `066BFF575151676667043206`、COM7 和 TACH-02B ELF
哈希 `7A8B655F02A9F6F6EDA528C1C923BEC495516A09C36480AA775F427EFFA13F1E`；定向下载、
校验和软件复位均成功，目标电压 3.24 V、Device ID 0x410。启动身份回读包含
`ppr=2,rpm=enabled,stale_ms=500`。

同一次启动的无风扇段从 tick=553 到 15015，共 15 窗口/14.462 s，全部为
WAIT_FIRST_EDGE，四项边沿/样本计数为 0，`rpm=INVALID,rpm_valid=0`。风扇上电但未按 B1
时，默认 50% 所有窗口均为 PERIOD_VALID/rpm_valid=1；长时间冷态收敛过程中观测到
1152～1239 RPM 的连续爬升，未出现 zero_delta、短周期或 STALE。该机械运行点变化保留为
观察项，不被包装成跨启动稳态转速公差。

随后先启动最长 300 s 的跨回合监听，用户只按一次 B1，完整捕获
`100→50→25→0→100→final 50%`。各非零档末段分别为：第一次 100% `2584～2616 RPM`、
50% `1267～1276 RPM`、25% `541～549 RPM`、第二次 100% `2597～2641 RPM`、最终 50%
`1289～1295 RPM`，频率、周期与 `PPR=2` 换算一致，所有窗口 zero_delta=0。

0% 切换后的惯性减速仍被诚实保留：age=266 ms 时最后新鲜周期仍为 PERIOD_VALID；随后
首个可见的约 1 s 日志窗口 age=1300 ms 已进入 STALE。此后 9 个连续窗口直到
age=9572 ms，edge/sample totals 始终冻结在 `6334/6333`，`rpm=INVALID,rpm_valid=0`。
再次 100% 后第一个完整新周期即恢复 PERIOD_VALID，并在该档末段到达 2597～2641 RPM；
监听收到 `FAN_PWM_PROFILE_DONE` 后额外保留 12 s，最终 50% 正常收敛，85.4 s 全程 COM7
未断开。

`TACH-02B` 判定为 **PASS（当前台架 PPR=2 整数 RPM 与 500 ms 数据新鲜度语义）**。
这关闭的是历史 RPM 失效与恢复，不等同于 Stall/断线 DTC 已完成。CAN 0x180 的 RPM
正常链路明确留给 H5；故障确认时间、去抖、锁存/恢复和 FA-01/02/03 明确留给 H6，
均不反向阻塞 H3。H3 现只剩 INA260 独立验证；CAN RPM 字节本轮继续保持 `FF FF`。
完整刷写边界、逐档范围、代表性原始字段和证据哈希见
[`2026-10-20 软件证据`](../../evidence/software/H3/2026-10-20/README.md)。

## 42. INA-00A/00B 实物身份与无源准入通过（2026-10-20）

在 Node A、Node B、风扇 12 V 和适配器均断电、残压报告 `0.1 V`、INA260-01 完全
孤立的条件下，现场补齐模块正反面原图。正面可见绿色功率端子、Vcc/GND/SCL/SDA/
Alert/VBus/Vin+/Vin-、A0/A1 和 VB 区域；背面可读
`INA260 Precision DC Current/Power Monitor / Bus Voltage: 0-36V / Max Current: 15A /
VCC/Logic: 3-5V`。A0/A1 未见人为桥接，故 `0x40` 只作为待扫描的默认地址假设；芯片
顶部字符不以照片强行判读，仍由寄存器身份关闭。

孤立无源测量得到：表笔短接基线 `0.22 Ω`；Vcc-GND 不蜂鸣，两种表笔极性下电阻均从
MΩ 级持续上升并最终超出 `200 MΩ` 量程；Vcc-SCL=`10.056 kΩ`、Vcc-SDA=
`10.028 kΩ`；GND-SCL、GND-SDA、SCL-SDA、SDA-Alert、Alert-VBus 均不蜂鸣。
VBus-Vin+ 蜂鸣/`0.043 Ω`，与板载 VB 桥的预期一致；Vin+-Vin- 蜂鸣/`0.044 Ω`，与
INA260 内置毫欧级分流路径一致。

后两项显示值低于 `0.22 Ω` 两线表笔基线，不能据此宣称测得精确分流值，也不能进行
简单表笔扣除；本轮只确认设计上应导通的路径没有开路。其余结果没有显示会阻止 3.3 V
I2C 接入的稳定低阻短路。`INA-00A/00B` 判定为 **PASS（身份/外观/孤立无源准入范围）**，
同时关闭 H0 D-02 的 INA260 身份背面子项；该结论不授权 12 V、负载或功能通过。完整照片、
哈希、原始读数和证据边界见
[`2026-10-20 INA260 硬件证据`](../../evidence/hardware/H3/2026-10-20/README.md)。

## 43. INA-01 只读扫描与采样镜像离线准备（2026-10-20）

以 `e92ea2f` 为代码基线，在 Node A 既有 I2C1 `PB8/D15=SCL、PB9/D14=SDA、100 kHz`
上增加 INA260 只读诊断路径。启动时扫描 7-bit `0x08～0x77` 并逐个记录 ACK；只在期望
地址 `0x40` 应答后读取 Configuration `0x00`、Manufacturer ID `0xFE` 和 Die ID
`0xFF`。身份门限冻结为 `mfg=0x5449`、die 高 12 bit=`0x227`；通过后约每秒读取
Current/Bus Voltage/Power，并以 `1.25 mA / 1.25 mV / 10 mW per LSB` 输出原始值与
整数工程量。ALERT 保持未接、未启用。

源码静态检查只发现 `HAL_I2C_IsDeviceReady` 与 `HAL_I2C_Mem_Read`，没有任何 I2C
写寄存器路径。使用 STM32CubeIDE 2.2.0 随附 GNU Tools for STM32 14.3.1 单线程 clean
build 成功，无 warning/error；`text/data/bss/dec=41292/100/14044/55436`。最终 ELF
大小 `1114492` bytes，SHA-256=
`835C48D09500657D3FA38F623B631C04B98A37B0B7B84D8C5197C71602CA453B`；修改源码
`freertos.c` 的 SHA-256=
`ED835E9C631990A0F67FADAEBB2FAB4D58E3B2F5DE5A49B261CF6BE158DF34B5`。最坏新增静态
栈为 `352` bytes，A_ControlTask 配置栈仍为 `2048` bytes；身份/采样最坏日志长度均
低于各自缓冲区。

`INA-01` 判定为 **PASS（离线实现与构建范围）**，尚未刷写、未接线、未形成任何实板
I2C 或测量结论。下一步只能在 INA260 继续完全未接、Node B 与风扇 12 V 断电时，按冻结
Node A ST-Link SN `066BFF575151676667043206` 定向刷写并回读镜像身份；随后必须再次
断电，才允许只接 `Vcc/GND/SCL/SDA` 做无源复核和 3.3 V I2C 扫描。绿色端子、VBus、
Vin+、Vin-、Alert、12 V、风扇和 Heater 继续断开。完整构建记录见
[`2026-10-20 软件证据`](../../evidence/software/H3/2026-10-20/README.md)。

## 44. INA-02A～02C 四线准入与静态上电（2026-10-20）

在 INA260 绿色端子、VBus、Vin+、Vin-、Alert、风扇 12 V、Heater 和 Node B 继续断开的
条件下，现场只连接 Node A `3V3/GND/PB8-PB9` 到模块 `Vcc/GND/SCL/SDA`。四条端到端
连续性均通过，`3V3-GND`、`D15-D14` 均不蜂鸣。只给 Node A USB 上电后观察 10 s 无
异味、异常发热或 USB 断连；模块排针静态电压为 `Vcc=3.230 V、SCL=3.223 V、
SDA=3.224 V`，测量期间无 USB 断连。

据此 `INA-02A～02C` 判定为 **PASS（仅限四线连续性、低压短路准入和静态电平）**。
该 PASS 不证明从机 ACK、地址、芯片身份或测量功能。

## 45. INA-02D 主控状态、全地址扫描与触发方法修正（2026-10-20）

定向刷写后，目标探测前的 I2C1 记录为 `state=0x20、hal_err=0、CR1=0x0001、
SR1=0、SR2=0、PB8/PB9 IDR=0x0300`，即外设已启用、总线不忙、两线为高。对默认
`0x40` 的定向探测返回 `HAL_ERROR` 且没有持续 HAL 错误；受控重新初始化后重复探测结果
不变。随后扫描完整 7-bit 范围得到 `ack_count=0`，因此没有可进入 Manufacturer ID /
Die ID 读取的地址。

早期两次示波器单次捕获由复位或既有通信活动抢先触发，只得到两线同步窄负脉冲，不能
用来判断 INA260 ACK。该失败没有被删除：仪器时间 `19:48` 与 `20:01` 的两张原图按真实
顺序保留，随后才修改诊断路径。此处将“观察工具捕获到了事件”与“事件确为目标 I2C 地址
事务”严格分开。

## 46. INA-02E/02F B1 静默探测与模块端 NACK（2026-10-20）

为得到可归因波形，固件增加 B1 单次静默探测：先执行一次 `0x40` readiness 地址周期，
完成后才允许输出 UART 文本。最终诊断构建的 `freertos.c` SHA-256 为
`2E1ABED5122D3A70366ABA143BA6FD029B0EB0EFB8B2968F4DE225101E274B97`；ELF 大小
`1115360` bytes，SHA-256=
`C77C8203619DAA7820375E1BA6C57016345D197AAB5E9ED7F957F44ED17B0888`。代码路径仍只有
设备就绪探测和读寄存器 API，没有 INA260 配置写入。

仪器时间 `20:05`，CH1/SCL 在 Node A 与 INA260 之间的面包板节点捕获约 `100 kHz`
地址周期，CH2/SDA 在应答位没有被从机拉低。由于该测点仍可能遗漏面包板至模块的接触
问题，探头随后直接移至模块已焊排针；仪器时间 `20:13` 再次得到相同约 `100 kHz`
地址周期和无 ACK。后一结果证明事务确实到达模块边界，且没有因测点迁移而改变。

因此，Node A 身份、PB8/PB9 映射、I2C1 100 kHz 配置、主控发帧能力、Node A 至面包板
以及面包板至模块排针的路径均从当前故障候选中排除。SDA 自动测得的非周期频率不作为
总线时钟值；判定依据为 SCL 波形和第 9 位应答电平。

## 47. INA-02F 地址网络关闭与模块级硬件 HOLD（2026-10-20）

完成模块端波形后全断电，A0/A1 两组未桥接焊盘分别对模块 GND 测得：

- A0 小面积左侧=`4.607 kΩ`，大面积右侧=`9.988 kΩ`；
- A1 小面积左侧=`4.609 kΩ`，大面积右侧=`10.044 kΩ`。

两个小焊盘具有相同约 `4.61 kΩ` 在路阻值，对应共用 Vcc 侧；两个大焊盘分别通过约
`10 kΩ` 下拉到 GND，对应 A0/A1 信号侧。结合焊盘未桥接外观，默认 `0x40` 地址网络
正常。此前完整扫描零 ACK 也排除了“只是变成另一合法地址”的解释。

至此故障被收敛到 `INA260-01` 模块内部边界，可能包括工厂芯片贴装/板内连接、芯片供电
落点、芯片损伤或器件本体问题；现有非破坏证据不再细分其中哪一种。`INA260-01` 判定为
**FAIL / HARDWARE HOLD（模块级无应答）**，而不是 Node A、USB、固件、100 kHz 时序、
跳线或面包板故障。

当前 Gate H3 保持 **IN PROGRESS / HARDWARE HOLD**。禁止向此模块接入 12 V、Vin+/
Vin-、VBus 或负载，也不再重复相同扫描。下一准入点固定为替换或独立修复模块后的
`INA-03A`：从全断电四线无源复核开始，依次通过静态 3.3 V、`0x40` ACK、Manufacturer
ID=`0x5449`、Die ID 高 12 bit=`0x227`，才允许恢复空载采样；高边 12 V 仍需单独授权。
照片、逐步测点、原始阻值和规范化诊断记录见
[`2026-10-20 硬件证据`](../../evidence/hardware/H3/2026-10-20/README.md) 与
[`2026-10-20 软件证据`](../../evidence/software/H3/2026-10-20/README.md)。

## 48. INA-02G 电脑端独立复扫（2026-10-21）

为排除对示波器波形人工判读的依赖，用户再次确认 INA260 只连接
`Vcc/GND/SCL/SDA`、仅 Node A USB 上电，Node B、12 V、绿色端子、VBus、Vin+、
Vin- 和 Alert 均未接。电脑识别到冻结的 Node A ST-Link 序列号
`066BFF575151676667043206` 和 `3.24 V` 目标电压；本次只执行软件复位，不重新刷写或
修改固件。

COM7 启动记录显示：探测前 I2C1 为 `state=0x20、hal_err=0、CR1=1、SR1=0、SR2=0`，
PB8/PB9 均为高；默认 `0x40` 在重新初始化前后连续两次返回无应答；完整 7-bit 扫描仍为
`ack_count=0`，Manufacturer ID 与 Die ID 因无从机地址 ACK 而无效。该电脑端结果独立
复现 2026-10-20 的结论，不需要使用示波器作为判据。

因此 `INA260-01` 继续保持 **FAIL / HARDWARE HOLD（模块级无应答）**。故障范围仍限定
在模块排针之后，但证据不把内部机制武断细分为芯片细脚贴装、板内连接或芯片本体中的
某一种。完整电脑端摘录和执行边界见
[`2026-10-21 软件证据`](../../evidence/software/H3/2026-10-21/README.md)。

## 49. H3 硬件暂挂阶段性同步（2026-10-21）

由于 `INA260-01` 已形成模块级无应答的完整证据链，后续必须等待替换或独立修复模块，
用户授权将截至本日的诊断固件、失败路径、原始照片、软件日志与索引做一次中间里程碑提交并
同步远端。该同步仅用于保全已完成工作，不改变 Gate H3 的 **IN PROGRESS / HARDWARE HOLD**
状态，也不将 INA260 身份或测量功能提前记为 PASS。替换模块到位后仍从 `INA-03A` 恢复准入。
