Ben-nevis2006/stm32-freertos-dual-ecu-can-diagnostics/evidence/hardware/H0/2026-09-23/H0_CANPAL-02_measurement_120R52_20260923_01.jpg

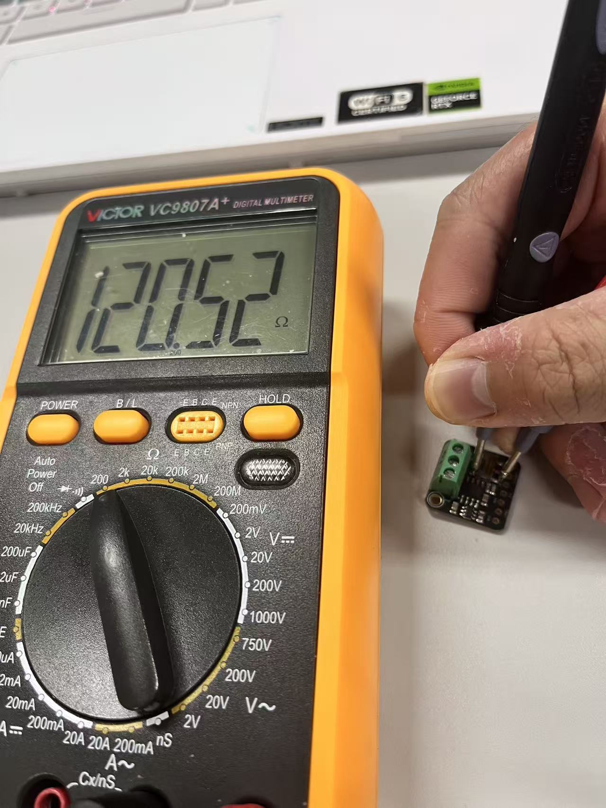
evidence/hardware/H0/2026-09-23/H0_CANPAL-02_measurement_120R52_20260923_01.jpg
