Ben-nevis2006/stm32-freertos-dual-ecu-can-diagnostics/evidence/hardware/H0/2026-09-23/H0_PSU12V-01_measurement_reverse_20260923_02.jpg

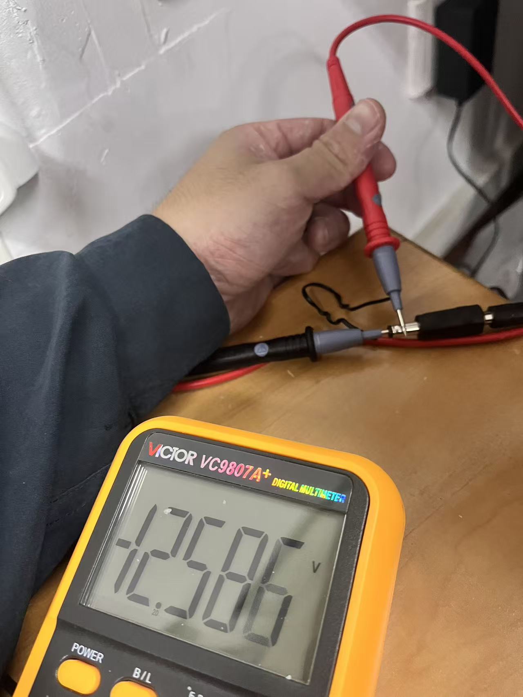
evidence/hardware/H0/2026-09-23/H0_PSU12V-01_measurement_reverse_20260923_02.jpg
