Ben-nevis2006/stm32-freertos-dual-ecu-can-diagnostics/current/H2_CAN_Bringup_Troubleshooting_Evidence_Recap_2026-10-07.md

# Gate H2 CAN Bring-up 排障证据复盘（2026-10-02～2026-10-07）

> 本文按真实时间顺序复盘统一推送前累计的 H2 工作。它保留失败、误判修正和证据边界，不把最终通过改写成“一次点亮”。项目阶段属于**原型/技术验证**，不是生产落地。

## 1. 问题背景

目标是在不接入任何 12 V 功率外设的前提下，让两块 STM32F103 NUCLEO 通过两块 TJA1051T/3 CAN Pal 建立 `500 kbit/s` 双向 CAN 链路，并形成能审计的 Gate H2 证据。

现场限制包括：

- 只有两路电脑 USB，板卡身份、COM 号和物理端口不能混为一谈；
- CAN Pal 排针由用户手工焊接，端子、焊点、跳线和 SLNT 都可能引入独立故障；
- 单人同时持表笔和手机容易牵动探针/USB/跳线，曾出现 ST-LINK `LD1/COM` 红闪和 Windows 重枚举；
- 初始最小固件能运行 UART/RTOS，但 CAN 两侧均只有 3 个邮箱入队后堵塞、接收始终为 0；
- 最终不仅要“有波形”，还要满足正式 ID/DLC/payload、AliveCounter、错误状态和断线恢复门槛。

## 2. 方案决策

采用“安全边界先行、单变量分层、失败证据保留”的排障策略：

1. **先无源后有源**：先查 Vcc-GND 非短路和 H-L 终端阻值，再 USB 上电，始终隔离 12 V/负载。
2. **身份固定**：按板号和 ST-LINK 设备身份区分 Node A/B，不依赖可能变化的 COM 号或电脑 USB 口。
3. **从 MCU 到总线逐层测量**：`PA12/TX → SLNT → CANH/CANL → RX → UART 计数器`，不靠反复盲换线猜测。
4. **先固定帧、后正式帧**：先用 `0x321/0x322` 隔离物理链路，再切换到 `0x100/DLC2` 与 `0x180/DLC5`。
5. **时钟改为可重复基准**：从 HSI 派生时钟切换到 ST-LINK 8 MHz MCO 的 HSE bypass，保留相同 `500 kbit/s / 87.5%` 位时序。
6. **以计数器而非“看起来正常”验收**：同时检查 `tx/rx`、四项错误、TEC/REC、EWGF/EPVF/BOFF 和末态 ESR。
7. **主动注入故障**：正式基线通过后受控断开 H/L，要求故障必须被观察；恢复后重新跑完整窗口，不能只凭重新连上就关闭 Gate。

没有采用的做法包括：未在故障未清时接入 12 V 或负载；未把 ST-LINK 通信灯当成 CAN 状态灯；未用照片代替连续性/运行日志；未删除失败记录来美化结果。

## 3. 个人动作

### 用户现场完成

- 对两块 CAN Pal 排针实施焊接、逐点目检、阻值和电压测量；
- 按步骤断电/上电、交换和恢复跳线，复核 PA11/PA12 实物位置；
- 发现 CANPAL-01 终端网络附近焊锡疑似碰到外侧贴片器件，清除/移开后复测阻值恢复；
- 更换 Node B RX 跳线，并重新固定一度断连的 Node B SLNT；
- 使用示波器分别观察 MCU TX、CANH、CANL 和 SLNT，反馈电平与趋势；
- 执行 H/L 受控断开、恢复、两端 `60.3/60.4 Ω` 复核和最终接触检查；
- 连续观察上电稳定性并报告 Windows USB 重枚举与探针操作的时间关联。

### Codex/工具完成

- 根据板卡资料、固件配置和现场反馈把排查拆成一次一个可逆动作；
- 修改两节点时钟、CAN 自动恢复和 H2 诊断固件，建立固定帧及正式帧校验；
- 构建、按板卡身份刷写、同步采集双 VCP 日志并解析 ESR/TEC/REC；
- 对每轮原始日志计算 SHA-256，保留失败、修复前后和最终通过数据；
- 按 Gate 判据拒绝两次“收发已恢复但错误状态仍高”的假通过；
- 整合执行记录、协议、证据索引和本复盘，并按用户要求在 H2 完成后统一推送一次。

## 4. 交付状态

**原型/技术验证：Gate H2 PASS。**

已完成的是 USB/3.3 V 低压条件下，两节点短距离 CAN 物理链路与正式基线帧的实板验证。没有生产部署、车规认证、12 V 功率链验收、长时间耐久或 EMC 结论。

## 5. 落地范围

| 维度 | 本次覆盖 |
|---|---|
| 时间 | 2026-10-02 至 2026-10-07，按 Gate 内累计、完成后统一推送 |
| 硬件 | 2×NUCLEO-F103RB、2×TJA1051T/3 CAN Pal、短距离 H/L/GND 总线 |
| 供电 | 两板 Mini-USB 与 CAN Pal 3.3 V；12 V 和功率外设完全隔离 |
| 协议 | 500 kbit/s；固定帧诊断；正式 `0x100/DLC2`、`0x180/DLC5`；4 位 AliveCounter |
| 观测 | 双 UART、示波器、万用表、CubeProgrammer、bxCAN ESR/TEC/REC |
| 验收 | 3×固定帧窗口、正式基线窗口、H/L 断线注入、恢复预检、最终恢复窗口 |

## 6. 效果证据

### 6.1 现象—验证—结论链

| 日期/阶段 | 现象 | 单变量验证与结果 | 结论性质 |
|---|---|---|---|
| 10-03～10-05 初始接线 | CAN 邮箱 3 帧后堵塞、双侧 `rx=0` | 复核发现 Node A TX/RX 对调；修正后故障仍在 | **实测排除**：线序是一个错误，但不是唯一根因 |
| 10-04 USB 扰动 | `LD1/COM` 由黄/橙转红闪，并伴随 Windows 断连/重连 | 移除表笔和机械扰动后静置 2 min 稳定 | **实测边界**：事件是 ST-LINK/USB 重枚举，不是 CAN 状态；具体瞬态路径未唯一定位 |
| 10-07 SLNT/总线电平 | SLNT 悬空约 2.2 V；Node B 下拉后 H/L 出现相反趋势，Node A 仍异常 | 明确把 SLNT 接 GND；后续发现 Node B SLNT 接触曾断开，重新固定后错误计数显著恢复 | **实测根因之一**：SLNT 不能悬空，接触不稳可造成静默/高错误状态 |
| 10-07 CANPAL-01 | Node A 下拉 SLNT 后 CANH 约 1.25 V、CANL 约 0.06 V；termination ON 时对地约 60.6 Ω | 用户检查发现终端网络附近焊锡碰邻近贴片位置，清理后 ON 状态不再呈异常对地低阻，H/L 回到约 3.3/1.8～2.0 V 活动范围 | **用户现场实测根因之一**：焊锡桥连干扰了终端/分裂网络；无显微截面，精确桥接节点不扩张推断 |
| 10-07 Node B RX | 局部交换/重启后节点行为不一致 | 更换 RX 跳线并重启后启动/接收路径恢复 | **用户现场实测根因之一**：旧 RX 跳线存在开路或间歇接触 |
| 10-07 时钟 | 线序和局部硬件修复后仍需消除双节点振荡器容差风险 | 两端统一为 HSE bypass 8 MHz、PLL×8；重新构建/刷写 | **工程修正**：消除 HSI 不确定性；因与其他修复相邻，不把它单独宣称为唯一故障根因 |
| 10-07 固定帧 | 修复前虽能收发，但 TEC/REC 高且偶发 seq_err | 修复 Node B SLNT 接触后连续 3×80 s：双方每轮约 690 帧，四项错误全 0，无 Warning/Passive/Bus-off | **实测通过**：物理链路具备可重复双向收发 |
| 10-07 正式帧 | 需要证明不是只为测试帧“特调” | `0x100/DLC2` 与 `0x180/DLC5` 运行 80 s；A=`687/688`、B=`690/689`，四项错误全 0 | **实测通过**：ID/DLC/payload/AliveCounter 基线成立 |
| 10-07 故障注入 | 断开 H/L 后双方停止接收 | A tx_fail=194；B tx_fail=187 且出现 Bus-off 样本 | **实测通过**：物理断线能被明确观察 |
| 10-07 首次恢复 | 重新接线后虽然收发恢复，A max TEC 仍 252，第二轮仍 208 | 两轮均判 FAIL；断电后从两端测得 60.3/60.4 Ω，并重新检查接线接触 | **阶段失败保留**：直流终端正确不等于动态接触已可靠；未唯一定位到某一插头 |
| 10-07 最终恢复 | 接触复核后重启 | 30 s 预检通过；80 s 最终 A=`687/688`、B=`690/689`，四项错误全 0，max TEC/REC 均 `6/0`，末态 ESR=0 | **实测最终通过** |

### 6.2 可核验量化结果

- 两端 termination 并联：早期 `60.41 Ω`；最终恢复前分别 `60.3 Ω`、`60.4 Ω`。
- 固定帧：连续 3 轮 `80 s`，Node A 每轮约 `687/688`、Node B 约 `690/689`，四项错误均 0。
- 正式帧基线：`80 s`，A/B 四项错误均 0；max TEC 分别 16/4，末态 ESR 均 0。
- 断线恢复最终窗口：`80 s`，A/B max TEC/REC 均 `6/0`，无 Warning/Passive/Bus-off 样本。
- 两份最终日志 SHA-256：Node A `9B06682C…BB313`；Node B `5B908CAF…B493E`。

完整原始日志和哈希见 [`evidence/software/H2/2026-10-07/README.md`](../evidence/software/H2/2026-10-07/README.md)。

## 7. 个人边界

- 用户负责实体焊接、接线、测量、示波器操作、断电/上电和现场异常识别；Codex 没有直接接触硬件。
- Codex 负责诊断步骤、固件改动、构建/刷写/日志解析和文档整合；实际测量结果以用户现场反馈和采集日志为准。
- “CANPAL-01 焊锡桥连”“Node B RX 跳线”“Node B SLNT 接触”有现场动作与前后对比支持；恢复阶段的具体接触点没有被仪器唯一定位，不能写成已精确锁定某一个端子。
- 时钟改造提升了可重复性并消除了 HSI 风险，但现有材料不足以把全部早期故障单独归因于 HSI。
- 本项目当前不能宣称生产落地、整车验证或功能安全合规。

## 8. 待补证据

- 完整应用级 `300 ms` timeout、两次连续异常确认、三次有效帧恢复状态机；
- 12 V 供电、Fan/Heater/INA260/NTC 接入前的独立安全 Gate；
- 负载条件下的长时间运行、总线利用率、温升、供电跌落和复位统计；
- H/L 差分波形的双通道同屏定量截图（共模、电压幅度、上升沿、振铃）；
- 线束/端子固定后的拉力与重复插拔可靠性；
- EMC、ESD、故障短路和生产级容差验证。

## 9. 面试追问

1. 为什么 `60 Ω` 正常仍不能证明 CAN 动态通信可靠？
2. 你如何用 `PA12/TX → SLNT → H/L → RX → UART` 的分层路径缩小故障范围？
3. 为什么“已经能收发”仍被你判定为失败？TEC/REC 和 Error Passive 提供了什么额外信息？
4. SLNT 悬空、焊锡桥连、RX 跳线开路分别会在逻辑侧和总线侧造成什么表现？
5. 为什么将 HSI 切换到 HSE bypass？如何计算 500 kbit/s 与 87.5% 采样点？
6. 为什么主动断开 H/L 后还必须做完整恢复窗口？
7. 这次哪些问题是确定根因，哪些只是被消除的风险，哪些仍未唯一定位？
8. 如果进入下一 Gate，你会怎样实现并验收 timeout、去抖确认和恢复策略？

## 升维迁移

- 原始事实：两板 CAN 起初不能稳定通信，经过接线、收发器、跳线、SLNT、时钟和恢复验证后通过。
- 高密度表达：在 USB/3.3 V 隔离边界内，以分层测点、错误计数和受控断线把多重硬件接触与配置问题逐项解耦，最终用正式帧和断线恢复窗口闭合双节点 `500 kbit/s` CAN Gate，同时保留失败日志与责任边界。
- 本次升维动作：把“修好了”拆成方案选择、单变量验证、多个独立根因、拒绝假通过、量化验收和未覆盖范围。
- 可选重写题：用一句话说明为什么两次恢复失败反而增强了最终 H2 PASS 的可信度。
