Ben-nevis2006/stm32-freertos-dual-ecu-can-diagnostics/current/06_engineering_recaps_工程复盘/H3_NTC_Bringup_Troubleshooting_Evidence_Recap_H3_NTC联调排障证据复盘_2026-10-10.md

# H3 NTC 联调排障证据复盘

## 1. 问题背景

Gate H3 的第一个对象是 Node B 的 3.3 V NTC 采集链：`3V3 → NTC → A0/PA0 → 9.911 kΩ → GND`。目标不是直接做完整温控，而是在不引入 12 V、Fan、Heater 或 INA260 的前提下，先证明接线、ADC 采样、热响应以及开路/短路边界都可独立验证。

现场约束包括：NTC 引线细软且曾补锡加固；面包板通过同列节点分支共用 3.3 V/GND；没有校准温度计；所有热刺激只能使用手指；早期固件只有原始值和阻值换算，没有独立的开路/短路状态。

## 2. 方案决策

1. 采用“上臂 NTC、下臂固定电阻”结构，使温度升高时 NTC 阻值下降、A0 电压与 ADC raw 上升，便于观察趋势。
2. 先完成离板无源阻值和线色确认，再执行上电电压、ADC 冒烟、室温基线、两轮手指加温—自然恢复，最后才做边界刺激。
3. 开路刺激断开 NTC 上端 `T`，保留 A0 由下拉电阻拉向 GND；短路刺激使用 `T-S` 旁路，只短接 NTC，由约 9.93 kΩ 下臂限制电流，而不是制造 3V3-GND 硬短路。
4. 阈值不凭空设定。先用旧固件采集真实边界样本，再冻结 `raw<=50` 为 OPEN、`raw>=3950` 为 SHORT，中间为 NORMAL。
5. 不把 H3 实验阈值包装成量产诊断：当前实现没有滞回、去抖、锁存、DTC 或全温压容差覆盖。

## 3. 个人动作

### 用户现场完成

- 对 NTC 细引线剥皮、补锡并完成面包板搭建，随后通过分段/总阻值检查验证拓扑。
- 识别并修正线色映射，最终固定为红=`T/3V3`、棕=`S/A0`、黑=`G/GND`。
- 明确说明公共 3.3 V/GND 通过面包板同列节点中转，而非在 MCU 针脚上叠接。
- 完成上电前蜂鸣/电阻检查、上电电压测量、两次手指加温—自然恢复以及开路、旁路、恢复等现场动作。
- 在发现断电在路阻值异常时，主动执行逐支路隔离：两支路都断开后固定电阻恢复约 `9.93 kΩ`，从而证明低读数来自板内并联路径，而不是固定电阻失效。

### 人工智能与工具完成

- 根据原始日志计算室温、升温、恢复及边界样本统计，保持失败初试和跨日工作点差异可追溯。
- 修改 Node B 固件，增加 OPEN/NORMAL/SHORT 三态、边界时禁用普通阻值换算，并在启动/周期日志中暴露阈值与状态。
- 完成离线构建、目标身份约束、定向刷写、串口捕获、哈希计算和文档归档。
- 将 2026-10-09 的“旧固件表征”和 2026-10-10 的“实现后验收”分开记录，没有用最终 PASS 覆盖中间问题。

## 4. 交付状态

**原型/技术验证。** Node B 单路 NTC 低压采集子项已在当前台架完成 H3-00～H3-05，具备结构化采样、可重复热趋势、受控开/短路识别和恢复证据。它不是生产落地、温度计标定或完整 ECU 故障诊断交付。

## 5. 落地范围

- 硬件：一块 NUCLEO-F103RB（Node B）、一只约 10 kΩ NTC、一只实测约 9.93 kΩ 固定电阻和面包板跳线。
- 电源：仅 ST-LINK/USB 与板载 3.3 V；未接 12 V、Fan、Heater、INA260。
- 固件：Node B `ADC1_IN0/PA0`，100 ms 采样、约 1 s 汇总日志；保留既有 H2 CAN 代码，但本子项不验收双节点通信。
- 验证时间：2026-10-07 至 2026-10-10；包括无源搭建、ADC bring-up、两轮热趋势、旧固件边界表征和新固件边界验收。
- 运行环境：实验室台架、面包板、当前 USB 供电和室温条件。

## 6. 效果证据

### 实测结果

- 无源拓扑：规范化线色后 `T-S=12.00 kΩ`、`S-G=9.93 kΩ`、`T-G=21.94 kΩ`，总值与分段和相差约 `0.046%`。
- 刷写前电压：`3V3-G=3.289 V`、`S-G=1.552 V`，与后续 ADC raw 量级相互印证。
- 室温基线：117 条、约 119 s，raw 均值 `1865.11`，前后 30 s 均值仅差 `-2.77 count`，采样失败为 0。
- Run01：10 条 rolling median 越过 `1921`，最大 `2471`；自然恢复后最终 30 条 raw 均值 `1867.83`。
- Run02：10 条 rolling median 首次 `1949.5`、最大 `2396`；首个恢复 30 条均值 `1889.667`；追加恢复段回到本轮起点附近。
- 旧固件边界表征：T-open raw `0～17`；T-S 旁路 raw `3990～4095`；恢复 raw `1839～1896`。
- 新固件验收：OPEN `21/21` 为 state 1；SHORT `21/21` 为 state 2；最终恢复 `21/21` 为 state 0；三段均 `fail=0 / last=0`。
- 构建与刷写：0 error/0 warning；ELF SHA-256=`8CFC084B8AD03683931CC8FDF91C4D8BCF46173FD88F2EA63D006BE6A364A9A2`；定向写入 Node B 后校验成功。

### 阶段结果

- NTC 子项 H3-00～H3-05：PASS。
- 整个 Gate H3：仍为 IN PROGRESS，因为 Fan PWM、Tach/PPR 和 INA260 尚未完成各自准入与验证。

## 7. 个人边界

用户负责实物搭建、接线、仪表测量、手动刺激、异常观察和现场确认；人工智能负责分析、固件修改、自动构建/刷写/采集及证据文档整理。没有证据表明当前结果已由第三方实验室校准，也没有生产用户、量产批次、车辆环境或长期耐久数据，因此不得写成“量产温控系统已落地”或“温度精度已验证”。

## 8. 待补证据

1. 使用校准参考温度计和至少三个稳定温点验证 NTC 的 B 值、偏差与绝对温度精度。
2. 在预期最低/最高温度、VDDA 变化、ADC 误差和元件容差下重新设计开短路阈值，并验证充足裕量；当前 SHORT 最低样本 `3961` 距阈值 `3950` 仅 11 count。
3. 增加滞回、去抖、持续时间、锁存/恢复策略以及 Fault/DTC/CAN 上报，再做故障注入验收。
4. 补充长时间稳定、机械扰动、连接器可靠性、EMC/ESD 和复位/掉电恢复测试。
5. 在 Fan、Tach/PPR、INA260 各自完成准入前，不把 NTC 子项 PASS 外推为整个 H3 或完整温控闭环 PASS。

## 9. 面试追问

1. 为什么把 NTC 放在分压上臂，温度升高时 ADC raw 为什么会上升？
2. 为什么“断开 A0”不能等同于“NTC 上支路开路”？
3. 为什么断电在路测得 5～6 kΩ 不能直接判定 9.93 kΩ 固定电阻损坏？你如何通过隔离支路证明？
4. `T-S` 旁路为什么不会形成 3V3-GND 硬短路，估算电流是多少？
5. 你如何从旧固件样本得到 50/3950 两个阈值？当前阈值最大风险是什么？
6. 为什么边界状态下要把 `calc_valid` 置 0，而不是继续输出一个极大或接近 0 的“阻值”？
7. Run01 与 Run02 哪些数据证明“可重复”，哪些数据又提醒你不能宣称绝对温度精度？
8. 若把该原型推进到量产诊断，你会按什么顺序增加滞回、去抖、DTC、全温压测试和系统回归？

## 升维迁移

- 原始事实：在面包板 NTC 联调中，经历了焊接余热漂移、线色风险、在路并联阻值误判和旧固件无边界状态等问题，最终用真实样本冻结阈值并完成复测。
- 高密度表达：围绕 Node B NTC 采集链建立“无源拓扑—ADC 一致性—双轮热趋势—边界表征—三态诊断—恢复验收”的闭环证据，将易被误判的在路阻值和近满量程数据转化为可复核的实验结论，同时明确保留全温压与量产诊断缺口。
- 本次升维动作：把零散操作按因果链重组，区分用户现场动作、自动化交付、实测结果、阶段状态和未证明边界。
- 可选重写题：用一句话说明“为什么这次 H3 NTC PASS 可信，但仍不能写成完整温控系统已完成”。
