Ben-nevis2006/stm32-freertos-dual-ecu-can-diagnostics/firmware/node_a/Inc/main.h

#define B1_Pin GPIO_PIN_13
#define B1_GPIO_Port GPIOC
#define B1_EXTI_IRQn EXTI15_10_IRQn
#define USART_TX_Pin GPIO_PIN_2
#define USART_TX_GPIO_Port GPIOA
#define USART_RX_Pin GPIO_PIN_3
#define USART_RX_GPIO_Port GPIOA
#define LD2_Pin GPIO_PIN_5
#define LD2_GPIO_Port GPIOA
#define FAN_PWM_Pin GPIO_PIN_7
#define FAN_PWM_GPIO_Port GPIOC
#define TMS_Pin GPIO_PIN_13
#define TMS_GPIO_Port GPIOA
#define TCK_Pin GPIO_PIN_14
#define TCK_GPIO_Port GPIOA
#define SWO_Pin GPIO_PIN_3
#define SWO_GPIO_Port GPIOB
#define INA260_SCL_Pin GPIO_PIN_8
#define INA260_SCL_GPIO_Port GPIOB
#define INA260_SDA_Pin GPIO_PIN_9
#define INA260_SDA_GPIO_Port GPIOB
#define H3_FAN_PWM_FREQUENCY_HZ           25000U
#define H3_FAN_PWM_TIMER_COUNTS           2560U
#define H3_FAN_PWM_IDLE_DUTY_PERCENT      50U
#define H3_FAN_PWM_PROFILE_HOLD_MS        10000U
#define H3_FAN_PWM_COMPARE_0_PERCENT      0U
#define H3_FAN_PWM_COMPARE_25_PERCENT     (H3_FAN_PWM_TIMER_COUNTS / 4U)
#define H3_FAN_PWM_COMPARE_50_PERCENT     (H3_FAN_PWM_TIMER_COUNTS / 2U)
#define H3_FAN_PWM_COMPARE_100_PERCENT    H3_FAN_PWM_TIMER_COUNTS
#define H3_TACH_TIMER_FREQUENCY_HZ        100000U
#define H3_TACH_TIMER_TICK_US             10U
#define H3_TACH_INPUT_FILTER              15U
#define H3_TACH_CLOCK_DIVISION            TIM_CLOCKDIVISION_DIV4
#define H3_TACH_CLOCK_DIVISION_VALUE      4U
#define H3_TACH_PULSES_PER_REVOLUTION     2U
#define H3_TACH_STALE_TIMEOUT_MS          500U
