Ben-nevis2006/stm32-freertos-dual-ecu-can-diagnostics/(commit log)

2026-08-14 补充了一部分，还有一些没看懂，再理解理解
2026-08-15 补了AUTOSAR，UDS，ISO，Boot loader，ETHERnet的理解
2026-08-15 此为本项目V1.0的详细说明，后续开发也会以此为最初标准
2026-08-17 一些具体一点的功能块划分，这个项目基本没有可参考复现的对象，为了保证不对范围越做越迷茫。先定好边界
2026-08-18 开始做一些结构职责细化，尽量科学有考究和企业工程化背书。有点多，今天先做一部分
2026-08-19 1.Cooling Demand 是归一化功能级冷却请求，不是实际物理冷却功率 2.Node A 负责 Cooling Demand → Fan Target Speed → PWM 的本地映射与控制 3.当前 v0.1 只有 Cooling Fan，但明确保留 Fan / Pump / Valve 多执行器扩展点
2026-08-20 主要更新了：
    Cooling Fan 明确为单向、可变速、具备 RPM 反馈
    Node A 明确采用本地转速闭环
    Cooling Demand → Target Fan Speed → Closed-loop Control → PWM/equivalent 控制链
    Motor Current 明确主要进入 Monitoring / Protection 路径
    Node A / Node B 职责边界更新为当前 Baseline
    Node A 本地保护明确不能依赖 CAN 可用性
    A/B 双向通信监督的职责边界补充进去，但 Heartbeat / Alive Counter 具体规则仍保持 TBD
    控制器具体是 P/PI/PID、参数等仍保持 TBD
    Recommended Next Steps 里注明 Fault Architecture 当前暂缓
2026-08-21 Node A 的 7 类 Fault Detection Scope Node B 的 6 类 Fault Detection / Fault Aggregation Scope Detection Enable Condition、Inhibition、Qualification / Debounce 等通用检测原则 无效 Sensor / Feedback 不得继续无条件参与控制或诊断 严重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
2026-08-22 1.Plant Temperature 明确定义为 Node B 的系统级温度信号 2.Node A 本地温度与 Plant Temperature 不是冗余关系 3.Node A 本地温度能力本身仍保持 DEFERRED，没有因此加入 v0.1 必做项。 v0.1 保留单一 Plant Temperature 主观测路径。 明确记录：如果这个信号失效，系统发生的是 Thermal State 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
2026-08-23 System Mode 正式冻结为 INIT / NORMAL / DEGRADED / SAFE FAULT 不作为独立运行 Mode，而作为 Fault / Diagnostic Status； RECOVERY 作为恢复/状态转移过程，不作为稳定运行 Mode。 Mode 判定原则冻结 同时考虑 Functional Availability 和 Observability； DEGRAD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
2026-08-24 INIT / NORMAL / DEGRADED / SAFE 已成为正式 System Mode Baseline，FAULT 与 Operating Mode 分离。 Functional Availability + Observability + Active Fault Set 的 Mode 判据已经同步。 RPM Feedback Fault 的条件式 Open-loop Fallb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
2026-08-24 很好的Fault List,使我不再迷茫
2026-08-25 一份独立的 CAN Matrix v0.1 前置设计留痕文档 里面记录了：项目范围控制原则、精简后的跨 ECU Signal 清单、明确不上传的底层数据、两条核心报文的当前规划、Fault Injection 可验证方案，以及哪些内容已经接受、哪些仍然 OPEN。它被标记为 WORKING BASELINE / Pre-Matrix，没有提前把 CAN ID、周期、Bit Layout 等尚未决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
2026-08-26 OI-01 Cooling_Demand 接口：0~100%、1% 分辨率、0xFF Invalid、Demand→RPM 映射原则 Cooling_Command Working Baseline 100 ms Cycle / 300 ms Timeout 4-bit Alive Counter DLC = 2 Byte/Bit Layout FA-07 的 Qualification、Fal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
2026-08-27 更新内容包括：0x100 / 0x180 两条报文的完整 Working Baseline、Actuator_Status 的 5 Byte 布局、FA-02 的 2-bit severity、Alive 异常后的重新同步、FB-03 与 FB-04 两类 300 ms 监督语义、RPM_Valid ↔ Actual_RPM 一致性，以及 Availability / Control Mode 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
2026-08-31 所有 Fault 引用都采用 “编号 + 名称”，例如 FA-07 Cooling Demand Communication Fault，不再只写代码。 Fault Injection 表里保留了完整的 FA/FB 故障验证方式，尽量从 Detection Inputs 注入，而不是直接强置 Fault Flag。整体内容仍以 SAD v0.1 和 Fault List v0.1 为上游基线。
    [CAN_Matrix_v0.1.xlsx]
2026-09-01 这轮新增并留痕的核心是：
    Node A：3 个 Application Task
    A_ControlTask：10 ms Working Baseline，控制 + 本地执行器诊断
    A_ComRxTask：CAN RX 事件驱动，负责 FA-07 Cooling Demand Communication Fault
    A_Cyclic100msTask：100 ms，发送 0x180 Actuator_Status
    Node A 另有 1 条非 Task 的 Immediate Protection Path，用于 FA-04 Motor Overcurrent 等严重风险即时保护。
    Node B：2 个 Application Task
    B_ComRxTask：事件驱动，负责 FB-03 Node A Communication Timeout、FB-04 Node A Alive / Sequence Fault
    B_Cyclic100msSupervisorTask：100 ms，温度、热策略、系统 Fault、State Manager 和 0x100 Cooling_Command
    明确 Fault Manager / State Manager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
2026-09-02 新增跨文档同步记录：这份是专门防以后“到底哪天改了什么、为什么 SAD/Fault/CAN/RTOS 都跟着变”查不清楚。今天的确定项、影响文档以及仍未冻结项都集中记在这里。
2026-09-02 把今天为什么不把 Cooling_Command 改成 10 ms、为什么低优先级 Status Task 仍然必须证明 schedulable、为什么 300 ms 不能当正常 Deadline，以及为什么诊断日志不靠 0x180 current-state bits 保存，都作为决策理由留痕了；旧的“下一步进入 FreeRTOS”也已经改成 Thermal Plant + Hardware 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
2026-09-02 CAN Matrix Word + Excel：没有改变 CAN ID、DLC、Bit Layout 或增加第三条报文，只补充了今天确认的应用语义：100 ms Cooling Demand 在 A 的 10 ms 控制环中保持使用；100 ms 是正常 cyclic Tx timing，300 ms 是 Fault boundary 而不是 Task Deadline；current Faul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
2026-09-02 同步了 runtime current Fault state ≠ stored diagnostic history，明确 Confirmed/Recovered diagnostic event 不能因为 latest-state overwrite 而消失；Diagnostic Architecture 的冻结点也写进去了。同时保留 FA-07 Cooling Demand Communi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
2026-09-02 这是今天需要回头修订比较多的一份。已经更新开发顺序为 FreeRTOS → Thermal Plant/Hardware Selection → Diagnostic Architecture → Detailed Design → Verification，同步 OI-12 状态、CAN/RTOS 当前基线、Sensor 不提前冻结、诊断历史边界以及 RTOS Timing Verificat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
2026-09-02 天讨论的主体。已加入 100 ms Command / 10 ms Control 的 Sample-and-Hold、Task Deadline/调度边界、Queue/Mailbox IPC、0 Mutex、Sensor Acquisition 边界、诊断历史与 runtime state 分离，以及后续必须执行的 WCET/Response Time/Jitter/Timing Margin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
2026-09-02 这轮新增并留痕的核心是：
2026-09-02 整理文档目录并归档旧版本
2026-09-03 Thermal Plant：铝制散热体/散热块 + 独立功率电阻热源；Heater 属于外部热源，不由 Node B 控制，不新增 Heater Task/CAN/Fault。 Plant Temperature：v0.1 正式走 NTC + Node B ADC，I²C 数字温度传感器不再作为首选方案。 Cooling Fan 硬件方向：12 V 四线风扇，使用 PWM command + T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
2026-09-03 新版本已更新
2026-09-04 HS-02 CAN Transceiver 已 CLOSED，采用 Adafruit CAN Pal 5708 / NXP TJA1051T/3 ×2，双节点分别作为 CAN 总线两端并启用 120 Ω 终端；HS-03 Cooling Fan 已 CLOSED，采用 ARCTIC P8 PWM PST non-CO，12 V 四线 PWM + Tach，CO 连续运行版没有必要。NUCLEO-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
2026-09-06 本轮主要留痕了这些确定/收敛内容：硬件策略改成**“闭环优先、成熟模块优先、避免不必要的自研模拟外围”**；HS-04 固定为 10 kΩ B3950 NTC + 10 kΩ 分压 → Node B ADC；HS-05/HS-06 收敛为 INA260 模块同时测 Fan Current + 12 V Supply Voltage，不再走 INA180 + 外部分流 + 独立电压分压；P8 的 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
2026-09-06 旧版本管理
2026-09-08 核心 BOM 已下单；散热器优选尺寸冻结为 100 × 80 × 20 mm；Heater 维持 10 Ω / 25 W 黄金铝壳功率电阻；电源收敛为 12 V / 3 A / 5.5×2.1 mm 成品稳压适配器；Heater 开关采用 12 V 四脚两档翘板；功率线采用 18 AWG 红/黑硅胶线；补充了三种杜邦线、DC 转螺丝端子、KF128 接线端子、4-pin 风扇延长线和 830 孔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
2026-09-08 旧版本迁移
2026-09-12 CubeMX、CubeF1、CubeIDE、编译器版本基线 CubeMX 更新异常及解决过程 F103RB_SmokeTest 实际配置 0 errors, 0 warnings 构建结果 Flash/RAM 占用解释 已验证与尚未验证范围 下一阶段工作计划 明确说明冒烟工程不是正式 Node A/Node B 工程
2026-09-13 软件部署前的核对
2026-09-15 feat: add Node A peripheral baseline
    CubeF1 1.8.7; STM32CubeIDE build: 0 errors, 0 warnings.
    [main.c, main.h]
2026-09-16 feat: add Node B peripheral baseline
    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
    [main.c, main.h]
2026-09-22 冻结设计输入及禁止修改项； Gate H0 范围、PASS/HOLD/FAIL 定义； 安全红线和万用表操作要求； 完整到货 BOM 清单； 实物编号与照片命名规范； H0-01～H0-07 逐步操作流程； NUCLEO、CAN Pal、风扇、INA260、NTC、Heater 和适配器专项检查； 阻值、适配器电压和极性记录表； 偏差隔离与关闭规则； Gate H0 通过条件及 H1 准入边界；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
2026-10-01 docs: record NUCLEO-02 ST-LINK probe
2026-10-01 docs: close Gate H1 for both NUCLEO boards
2026-10-01 docs: add H2 pre-entry board back evidence
2026-10-07 feat: close Gate H2 CAN bring-up
    Accumulate work performed from 2026-10-02 through 2026-10-07 and publish it once under the per-Gate push policy. Preserve the 2026-10-05 failed bring-up, the 2026-10-07 multi-fault diagnosis and fixes, formal 0x100/0x180 acceptance, controlled H/L disconnect, recovery evidence, and H0 CAN identity closure.
    [main.c, node_a.ioc, node_b.ioc]
2026-10-07 docs: organize active project records
    Classify current documents into six bilingual sections, add Chinese translations to active filenames and indexes, archive the superseded project charter, and repair all affected links without changing historical evidence.
    [CAN_Matrix_CAN矩阵_v0.1_Synced_已同步_2026-09-02.xlsx]
2026-10-07 docs: close H3 NTC passive assembly check
2026-10-08 feat: complete H3-02 Node B NTC ADC bring-up
2026-10-12 docs: close H3 fan identity admission
2026-10-12 test: verify H3 fan extension continuity
2026-10-12 docs: preserve fan extension in H3 test setup
2026-10-12 test: verify H3 fan power pin mapping
2026-10-12 test: verify H3 fan supply polarity
2026-10-12 test: close H3 fan independent power check
2026-10-12 test: map H3 fan PWM contact
2026-10-12 feat: prepare H3 fan PWM probe
2026-10-12 test: flash H3 fan PWM probe
2026-10-12 test: close H3 fan PWM waveform check
2026-10-12 test: record H3 single-fan PWM integration
2026-10-13 feat: prepare H3 fan duty response profile
2026-10-13 test: record H3 fan profile flash identity
2026-10-13 test: validate H3 fan PWM duty sequence
2026-10-13 test: close H3 fan PWM validation
2026-10-13 test: characterize isolated fan tach signal
2026-10-14 test: identify H3 tach PWM coupling source
2026-10-14 test: validate H3 tach RC filter
2026-10-19 feat: add filtered H3 tach capture profile
2026-10-19 test: reject partially filtered H3 tach capture
2026-10-19 feat: extend H3 tach filter sampling window
