Ben-nevis2006/stm32-freertos-dual-ecu-can-diagnostics/(notices)

Notices in the files:
firmware/node_a/Src/main.c:
Copyright (c) 2026 STMicroelectronics.
All rights reserved.
This software is licensed under terms that can be found in the LICENSE file
